drewsum/Electronic_Display/hdw/Power_Board/LTC7851_Demo/render2.png

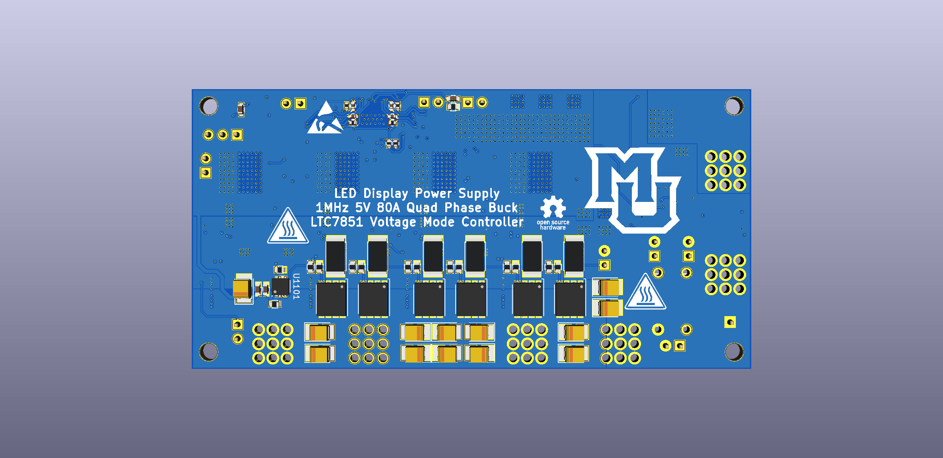
hdw/Power_Board/LTC7851_Demo/render2.png
