drewsum/Electronic_Display/sfw/app/Android_App_Code_README.docx

The app code was written and built with Android Studio and this IDE also is used to debug and program an android device. This software can be found at https://developer.android.com/studio/index.html and is free to download. The project was built targeting the java jdk version 1.8

Checkout the source code of the project found at https://github.com/drewsum/Electronic_Display

First enable USB debugging on the device in developer settings.

Connect a USB cable to your machine running Android Studio
