drewsum/Electronic_Display/hdw/Logic_Board/Design_Files/Microcontroller_Peripheral_Map.xlsx

Peripheral Name | Description | Function | Software Naming | Notes | Pin Routing
EBI | External Bus Interface | Allows data to be stored and retrieved from external parallel SRAM for saving data currently being displayed on the display | EBI, EBI_SRAM, etc | Used PBCLK8 as clock source. Used as data scratchpad for writing to/reading from SPI Flash during normal operation, as well as saving data sent over WiFi interface | RA4, RA5, RB8, RB9, RC1, RC2, RC3, RC4, RD9, RE0, RE1, RE2, RE3, RE4, RE5, RE6, RE7, RF4, RF5, RG9, RH7, RJ4, RJ13, RJ14, RJ15, RK0, RK1, RK2, RK3
SPI3 | Seiral Peripheral Interface 3 | Allows data to be stored and retrieved from external serial FLASH memory. There are 8 FLASH chips which each hold a slide of data for the display | SPI_Flash | There are 8 serial flash chips. Each stores an image to be displayed on the panels | RA2, RA3, RA6, RA7, RA9, RA10, RA14, RA15, RB2, RB3, RB4, RB5, RB6, RB7, RB10, RB11, RB12, RB14, RC13, RC14
UART1 | Universal Asynchronous Recevier Transmitter 1 | Serial connection for WIFI module, used for moving image data from an android app into the embedded system | esp8266 | Baud rate set to 115200 bps | RE8, RE9, RG7, RG8
UART3 | Universal Asynchronous Recevier Transmitter 3 | Serial connection for USB debugging, virtual COM port | usbUart | Baud rate set to 115200 bps | RF0, RD10
WDT | Watchdog Timer | Error catch, resets the microcontroller if the timer has not been cleared in 2 seconds. Timer is cleared within the heartbeat ISR (below) | watchdogTimer | Postscaler set to 2.048 seconds
TMR1 | Timer 1 | Timer 1 is used as the heartbeat timer, which triggers an interrupt every second. This blinks an LED and increments on time counters. Used as a 1 Hz timebase | heartbeatTimer | Timer 1 period set to 61523, input frequency is 15.75 MHz, yields an IRQ rate of 1 Hz. Blinks the heartbeat LED | RG12
TMR3 | Timer 3 | Used for timebase for automatic ADC triggering | ADCTriggerTimer
DMT | Deadman timer | Resets the microcontroller if not cleared by the heartbeat timer ISR | DeadmanTimer
TMR5 | Timer 5 | Used for the main timebase for panel multiplexing. Sets the on time for LEDs in panel | panelMultiplexingTimer
TMR2, OC4 | Timer 2 and Output Compare 4 | Panel PWM, used for dimming panels and adjusting panel brightness | panelPWM |  | RG0
TMR4 | Timer 4 | Used for certain non-software delays needed for firmware execution. Only one delay can be used at once | delayTimer | Adjustable timer period
CNF, CNK | Change Notice F, Change Notice K | Used for GPIO input edge detection. Monitors PGOOD signals along with rotary encoder |  |  | RF1, RF3, RF8, RF12, RK4, RK5, RK7
Prefetch | Prefetch Module | Acts as a complimentary cache for the CPU while it is operating at high clock frequencies | prefetch | Wait time set to 4 wait states per datasheet
Analog to Digital Converter 7 | ADC7 | Shared ADC module, used for system voltage measurement when debugging. Off by default, turned on through serial command | ADC |  | RH0, RH1, RH4, RH5, RH6
Error Handler (in firmware) | Error Handler | C structure that holds flags used for recording and reporting errors. Varias peripherals set error handler flags, and they can only be cleared through the USB UART serial interface. These flags set the state of the error LEDs on the board | error_handler.<flag_name> |  | RG1, RG6, RG13, RG14, RH3
