drewsum/Electronic_Display/hdw/Logic_Board/Design_Files/Interrupt_Priority_List.xlsx

Interrupt Name | Priority | SubPriority | Function
ADC_Analog_Circuits_Ready | 4 | 2
ADC7_Warm_Interrupt | 4 | 2
ADC_Data_38 | 1 | 1 | POS3P3 ADC data
ADC_Data_39 | 1 | 1 | POS12 ADC data
ADC_Data_40 | 1 | 1 | POS5 ADC data
ADC_Data_41 | 1 | 1 | POS5P5 ADC data
ADC_Data_42 | 1 | 1 | POS5P ADC data
ADC_Data_43 | 1 | 1 | VREF ADC data
ADC_Data_44 | 1 | 1 | DIE Temperature data
ADC_End_Of_Scan_Ready | 1 | 1 | handles anything and all ADC info after reading in new ADC values
System_Bus_Protection_Violation | 1 | 1
UART1_Receive_Done | 7 | 2 | ESP RX
UART1_Transfer_Done | 7 | 2 | ESP TX
UART1_Fault | 1 | 1 | ESP error
Timer1 | 6 |  | heartbeat timer
PORTF_Input_Change_Interrupt | 2 | 1 | change notification for port F inputs
PORTK_Input_Change_Interrupt | 2 | 1 | change notification for port K inputs
Timer5 | 6 | 2 | Multiplexing timer
Prefetch_Module_SEC_Event | 4 | 2
SPI3_Fault | 1 | 2 | SPI flash error
SPI3_Receive_Done | 5 | 3 | SPI flash RX
SPI3_Transfer_Done | 5 | 2 | SPI flash TX
UART3_Receive_Done | 2 | 2 | USB RX
UART3_Transfer_Done | 7 | 2 | USB TX
UART3_Fault | 1 | 1 | USB error
