drewsum/Electronic_Display/hdw/Power_Board/LTC7851_Demo/LTC7851_Demo_bom_.xlsx

References | Value | Footprint | Quantity Per PCB | Digi-Key PN | display_footprint | Dielectric | Voltage | Tolerance | Ampacity | Wattage
C207 C301 C302 C303 C304 C305 C411 C413 C506 C508 C606 C608 C706 C708 C802 C803 C804 C1102 | 0.1uF | C_0603 | 18 | 490-4779-1-ND | 0603 | X7R | 50V
C201 | 0.1uF | C_0603 | 1 | 490-4779-1-ND | 0603 | X7R | 50V
C415 C510 C610 C710 | 0.22uF | C_0402 | 4 | 1276-1049-1-ND | 0402 | X5R | 10V
C402 C406 | 100pF | C_0402 | 2 | 478-1089-1-ND | 0402 | X7R | 50V
C204 C206 C208 | 100uF | CP_Tantalum_Case-X_EIA-7343-43_Reflow | 3 | 718-1102-1-ND | 7343 |  | 16V | 10%
C405 C407 C408 C410 C412 C420 C501 C502 C503 C505 C507 C515 C601 C602 C603 C605 C607 C615 C701 C702 C703 C705 C707 C715 C805 | 100uF | CP_Tantalum_Case-B_EIA-3528-21_Reflow | 25 | 478-9994-1-ND | 3528 |  | 6.3V | 20%
C417 C419 C512 C514 C612 C614 C712 C714 | 100uF | C_1210 | 8 | 587-3432-1-ND | 1210 | X5R | 10V
C202 C205 | 10nF | C_0603 | 2 | 1276-1921-1-ND | 0603 | X7R | 50V
C801 C1103 | 10uF | CP_Tantalum_Case-B_EIA-3528-21_Reflow | 2 | 399-5034-1-ND | 3528 |  | 16V | 10%
C203 | 1nF | C_0603 | 1 | 311-1080-1-ND | 0603 | X7R | 50V
C401 | 1nF | C_0402 | 1 | 311-1080-1-ND | 0402 | X7R | 50V
C409 C414 C509 C604 C609 C704 C709 C1101 | 1uF | C_0603 | 8 | 1276-6524-1-ND | 0603 | X7R | 16V
C504 | 1uF | C_0603_HandSoldering | 1 | 1276-6524-1-ND | 0603 | X7R | 16V
C404 | 2200pF | C_0402 | 1 | 478-1105-1-ND | 0402 | X7R | 50V
C416 C418 C511 C513 C611 C613 C711 C713 | 22uF | C_1210 | 8 | 445-1436-1-ND | 1210 | X5R | 25V
C403 | 3300pF | C_0402 | 1 | 478-5132-1-ND | 0402 | X7R | 50V
D201 | 24V | D_SMA | 1 | SMAJ24CALFCT-ND
D202 D302 D303 | Green | LED_0603 | 3 | 160-1446-1-ND
D301 | Red | LED_0603 | 1 | 160-1447-1-ND
J201 | +12V IN | Wuerth_7461096_M4_Shank_9pos | 1 | 732-3214-ND
J901 J902 | +5V OUT | Wuerth_7461096_M4_Shank_9pos | 2 | 732-3214-ND
J301 | CLKOUT | Pin_Header_Straight_1x02_Pitch2.54mm | 1
J1101 | FG_LOAD | Pin_Header_Straight_1x02_Pitch2.54mm | 1
J206 | GND IN | Wuerth_7461096_M4_Shank_9pos | 1 | 732-3214-ND
J903 J904 | GND OUT | Wuerth_7461096_M4_Shank_9pos | 2 | 732-3214-ND
J304 | IAVG | Pin_Header_Straight_1x02_Pitch2.54mm | 1
J1102 | ISNS | Pin_Header_Straight_1x02_Pitch2.54mm | 1
J1402 | LOOP_TAP | Pin_Header_Straight_1x02_Pitch2.54mm | 1
J305 | PGOOD | Pin_Header_Straight_1x02_Pitch2.54mm | 1
J302 | RUN | Pin_Header_Straight_1x03_Pitch2.54mm | 1
J303 | THDN | Pin_Header_Straight_1x02_Pitch2.54mm | 1
J1401 | VOUT | Pin_Header_Straight_1x02_Pitch2.54mm | 1
J1403 | Wave_Gen_In | Pin_Header_Straight_1x02_Pitch2.54mm | 1
L401 L501 L601 L701 | 1uH | L_Vishay_IHLP-4040 | 4 | 541-1306-1-ND | IHLP4040 |  |  | 20% | 25A
MK1001 MK1002 MK1009 MK1010 | 4-40 Screw |  | 4 | 36-9900-ND
MK1003 MK1004 MK1011 MK1012 | 4-40 Standoff |  | 4 | 36-8400-ND
Q201 Q202 Q1101 Q1102 Q1201 Q1202 Q1301 Q1302 | IPC100N04S51R7ATMA1 | TDSON-8-1 | 8 | BSC123N10LSGATMA1CT-ND
R301 | 0 | R_0603 | 1 | 311-0.0GRCT-ND | 0603 |  |  | 1% |  | 1/10W
R408 R412 R413 R414 R504 R505 R604 R605 R704 R705 | 0 | R_0402 | 10 | RMCF0402ZT0R00CT-ND | 0402 |  |  | 1% |  | 1/16W
R407 R503 R603 R703 | 1.96k | R_0402 | 4 | 311-1.96KLRCT-ND | 0402 |  |  | 1% |  | 1/16W
R205 R206 R1102 R1103 R1104 R1201 R1202 R1301 R1302 | 10 | R_0603 | 9 | YAG3351CT-ND | 0603 |  |  | 1% |  | 1/10W
R409 | 10 | R_0402 | 1 | 311-10.0LRCT-ND | 0402 |  |  | 1% |  | 1/16W
R204 | 100k | R_0603 | 1 | P100KHCT-ND | 0603 |  |  | 1% |  | 1/10W
R410 | 100k | R_0402 | 1 | 311-100KLRCT-ND | 0402 |  |  | 1% |  | 1/16W
R207 R304 R305 R310 R1101 R1105 R1106 R1203 R1204 R1303 R1304 | 10k | R_0603 | 11 | RHM10KADCT-ND | 0603 |  |  | 1% |  | 1/10W
R404 | 10k | R_0402 | 1 | 311-10.0KLRCT-ND | 0402 |  |  | 1% |  | 1/16W
R411 | 13.7k | R_0402 | 1 | 311-13.7KLRCT-ND | 0402 |  |  | 1% |  | 1/16W
R209 R306 R307 R308 | 1k | R_0603 | 4 | RHM1.0KDCT-ND | 0603 |  |  | 1% |  | 1/10W
R302 R405 R406 R501 R502 R601 R602 R701 R702 | 2 | R_0603 | 9 | RMCF0603FT2R00CT-ND | 0603 |  |  | 1% |  | 1/10W
R801 | 200 | R_0603 | 1 | MCT0603-200-CFCT-ND | 0603 |  |  | 1% |  | 1/10W
R203 | 243k | R_0603 | 1 | 541-243KHCT-ND | 0603 |  |  | 1% |  | 1/10W
R402 | 324 | R_0402 | 1 | YAG3118CT-ND | 0402 |  |  | 1% |  | 1/16W
R208 | 5.1k | R_0603 | 1 | RMCF0603FT5K10CT-ND | 0603 |  |  | 1% |  | 1/10W
R303 | 51.1k | R_0603 | 1 | P51.1KHCT-ND | 0603 |  |  | 1% |  | 1/10W
R401 | 59k | R_0402 | 1 | P59KDCCT-ND | 0402 |  |  | 1% |  | 1/16W
R1107 R1108 R1205 R1206 R1305 R1306 | 5m | R_2512 | 6 | YAG2145CT-ND | 2512 |  |  | 1% |  | 2W
R201 | 6.04M | R_0603 | 1 | 541-6.04MHCT-ND | 0603 |  |  | 1% |  | 1/10W
R403 | 6.04k | R_0402 | 1 | RMCF0402FT6K04CT-ND | 0402 |  |  | 1% |  | 1/16W
R802 | 680 | R_0603 | 1 | P680HCT-ND | 0603 |  |  | 1% |  | 1/10W
R202 | 86.6k | R_0603 | 1 | 311-86.6KHRCT-ND | 0603 |  |  | 1% |  | 1/10W
T1401 | 1:1 Pulse Transformer | Murata_78601_9C | 1 | 811-2650-ND
U202 U303 U304 | 74LVC1G06 | SOT-353_SC-70-5 | 3 | 296-8484-1-ND
U302 | 74LVC1G17 | SOT-353_SC-70-5 | 1 | 296-11934-1-ND
U801 | LM1117-ADJ | SOT-223-3_TabPin2 | 1 | LM1117IMPX-ADJ/NOPBCT-ND
U1101 | LT1010DD | DFN-8-1EP_3x3mm_Pitch0.5mm | 1 | LT1010CDD#PBF-ND
U201 | LTC4365DDB | DFN-8-1EP_2x3mm_Pitch0.5mm | 1 | LTC4365IDDB#TRMPBFCT-ND
U301 | LTC7851UHH | QFN-58-1EP_9x5mm_Pitch0.4mm | 1 | LTC7851IUHH#PBF-ND
U401 U501 U601 U701 | SiC779 | MLP66-40_6x6mm_Pitch0.5mm | 4 | SIC779CD-T1-GE3CT-ND
