drewsum/Electronic_Display/hdw/Logic_Board/Testing/POS3P3.png

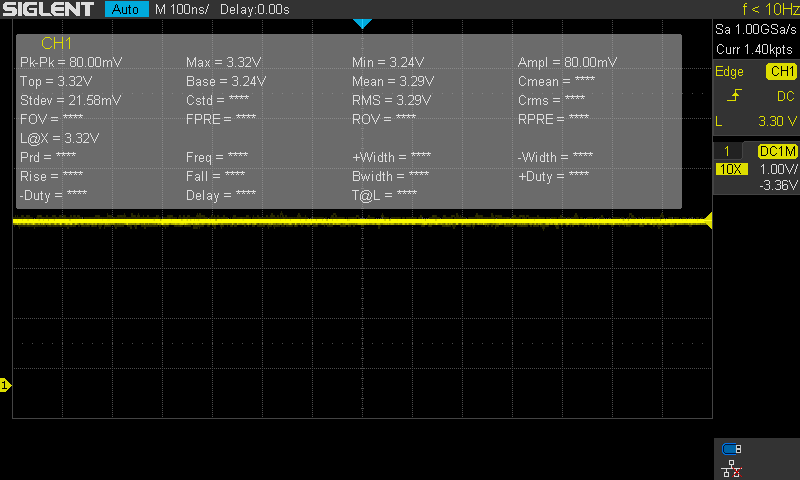
hdw/Logic_Board/Testing/POS3P3.png
