drewsum/Electronic_Display/hdw/Logic_Board/Testing/POS3P3_SW_2.png

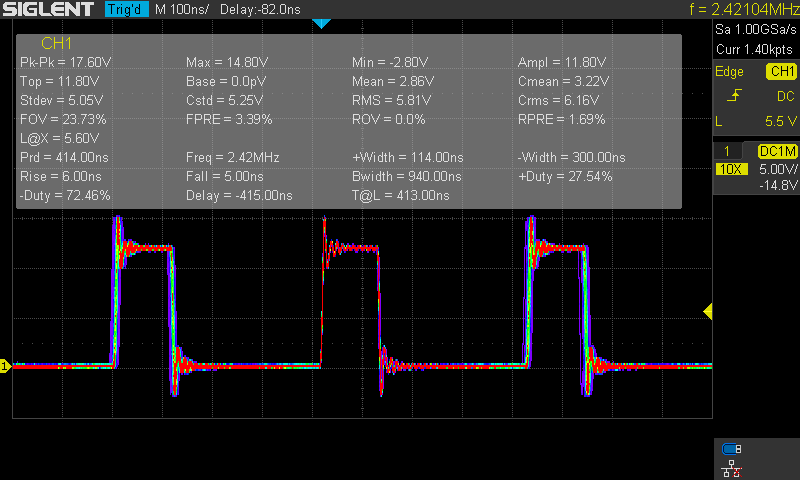
hdw/Logic_Board/Testing/POS3P3_SW_2.png
