drewsum/Electronic_Display/hdw/Logic_Board/Testing/POS5.png

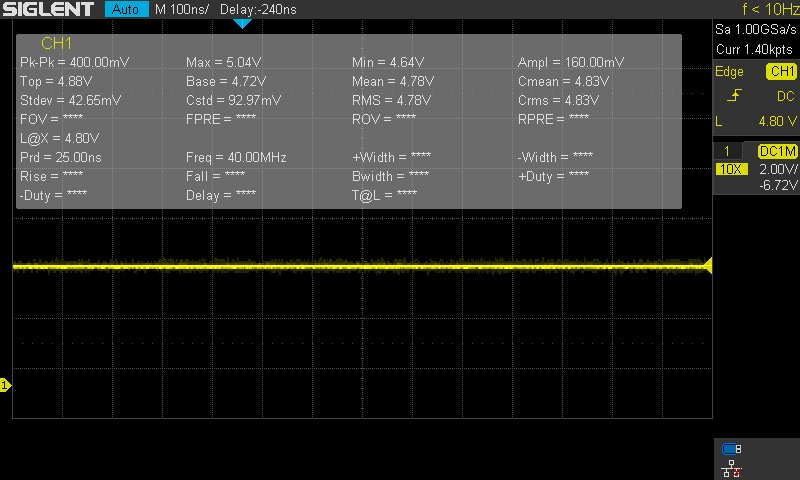
hdw/Logic_Board/Testing/POS5.png
