drewsum/Electronic_Display/hdw/Logic_Board/Testing/POS5_SW.png

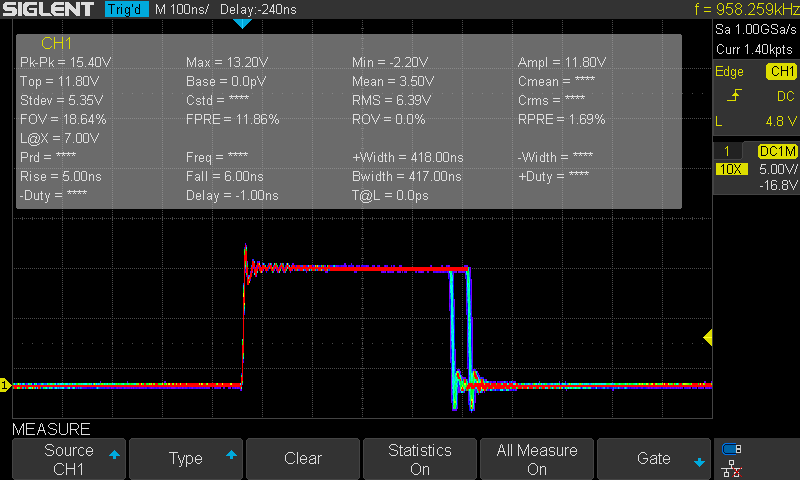
hdw/Logic_Board/Testing/POS5_SW.png
