drewsum/Electronic_Display/hdw/Logic_Board/Testing/USB_UART.png

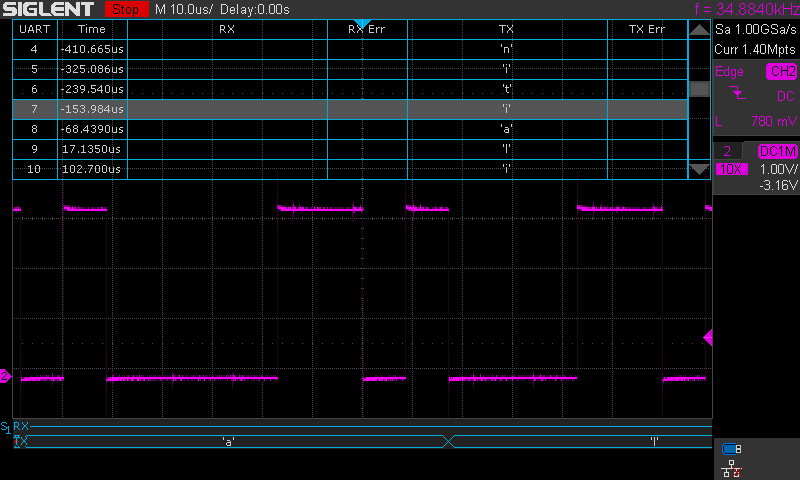
hdw/Logic_Board/Testing/USB_UART.png
