drewsum/Electronic_Display/hdw/Logic_Board/Testing/USB_UART_2.png

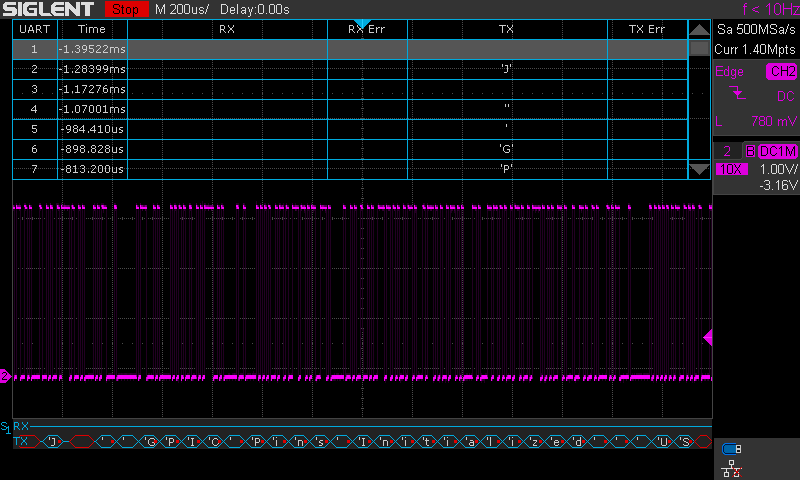
hdw/Logic_Board/Testing/USB_UART_2.png
