drewsum/Electronic_Display/sfw/embedded_firmware/test/HTTPRequest.PNG

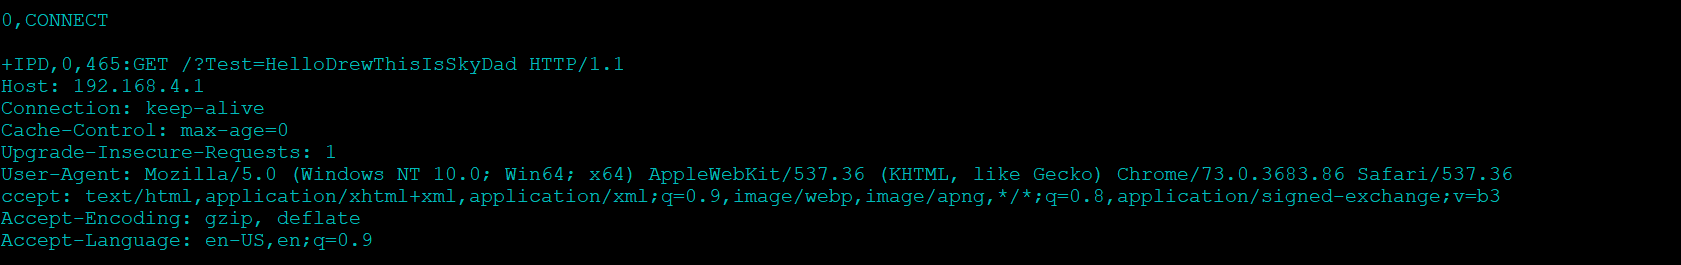
sfw/embedded_firmware/test/HTTPRequest.PNG
