drewsum/Electronic_Display/hdw/Logic_Board/Testing/EBI_WE_Issues/SDS00013.png

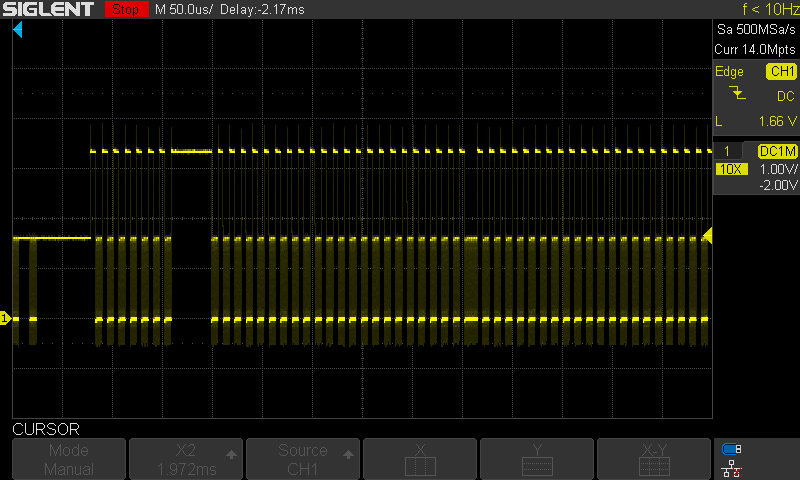
hdw/Logic_Board/Testing/EBI_WE_Issues/SDS00013.png
