drewsum/Electronic_Display/(threads)

Thread 58 (2019-02-02):

Exception Handling

drewsum, 2019-02-02:
Write _general_exception_handler function to handle CPU exceptions, record them, and print them to USB UART after reset if they've occurred. This should be in the error handling module

Closed 2019-02-03.

Thread 59 (2019-02-02):

SPI Flash

drewsum, 2019-02-02:
Write SPI flash module for SPI 3. This should include an init function, should add SPI3 PPS settings to GPIO setup function. I'm thinking it will have an enumeration to keep track of state machine, there should be functions to set and reset the GPIO associated with SPI flash, and should have functions to test/print what's stored in given external flash chips.

drewsum, 2019-02-26:
Where we stand on this: We're able to read (I think) from SPI Flash, but we cannot write yet. I'm thinking we should disable the enhanced buffer mode again, and add while loop blocking in between opcode writes and stuff. This will force the movement of data to be accurate, and minimize risk of data becoming out of order or bytes being missed, both with reading from and writing to the SPI Flash devices. I'd also really like to get SSCANF serial commands working, so that we can write to and read from whichever of the 8 chips we want to at a given time.

drewsum, 2019-03-07:
We should look deeper into whether or not we're going to be able to move data from SPI Flash into EBI SRAM while multiplexing. If we leave multiplexing enabled while handling SPI tasks, it looks like the PIC enters fucked up mode. If we can widen the LED panel on time to much longer than 6 microseconds, we may have enough time to service SPI while still multiplexing. More to experiment with. If we can;t service SPI while multiplexing, we should just forget EBI altogether and move SPI Flash data into the internal RAM buffer after displaying each image (when cycling through images).

drewsum, 2019-03-08:
Looks like when I disable enhanced buffer mode, the receive interrupt has stopped working. When trying to continuously receive, we can only write one byte (the SPI3 RX interrupt only triggers once).

Closed 2019-03-18.

Thread 60 (2019-02-02):

EBI

drewsum, 2019-02-02:
Write external bus interface module for interfacing PIC32MZ with external SRAM. Using data line 0:8, address lines 0:17. No idea what speed settings should be. SRAM size is 256k x 8b

drewsum, 2019-02-03:
Ideas for this:

**Slow down EBI to slowest setting and we'll work our way up from there:** TPRC, TBTA and all other bit fields in the EBISMT0 register should be set to all 1's instead of all 0's

**Keep following example 47-5 in the EBI reference manual:** Keep copying over the example code for the ebiInitialize function, but when they write something like EBISMCON = 0x00000000, instead of just writing that, write zero's or whatever into the actual bitfields so we know explicitly what we're configuring instead of writing a 32-bit number into a register

**Write an ebiTestRamBuffer() Function:** Prototype in the ebi header file, and write the function in the ebi source file. Use a for loop to loop through all possible addresses in external memory (0 to 2^17 - 1 or something like that) and write the address into that memory location. The data is accessed through a pointer if I remember right. Then, loop through the array again and verify that the data matches what you set it to for each address. If it does, print out that no errors occurred, if there is an error, print an error message.

**Write an ebiPrintSRAM() Function:** prototype in the ebi header file and write in the ebi source file. It should loop through all EBI addresses lik ethe test function above, but instead of writing and checking to verify it wrote properly, it should print out the SRAM register address and contents of the SRAM register.
To keep the output shorter, I would say print like 16 bytes of data per line or something like this:

`
Address:      0       1       2       3      4       5       6      7       8      9       A      B       C      D      E       F
0x0000000x 0x00 0x00 0x00 0x00 0x00 0x00 0x00 0x00 0x00 0x00 0x00 0x00 0x00 0x00 0x00 0x00
0x0000001x 0x00 0x00 0x00 0x00 0x00 0x00 0x00 0x00 0x00 0x00 0x00 0x00 0x00 0x00 0x00 0x00
...
`

drewsum, 2019-02-04:
We should also add a `printEBIStatus()` function to print out the settings of all EBI pins/control registers/whatever before we actually turn the EBI module on for the first time. This will help us make sure pins are set properly and reduce the risk of frying anything on the board

drewsum, 2019-02-08:
I ran an EBI test for the first time, and every time the `ebiTest()` function is called a CPU general exception is thrown. I think this has something to do with a memory permissions error. This exception gets thrown because the EBI testing function is trying to read from external memory which it doesn't have permission to and therefore a read from a wrong address throws a CPU general exception. I think we have to configure the EBI memory space to be accessed by the CPU using the memory management unit. This cade should sit in the ebiInit() function. The MMU is outlined in section 48 of the REF manual for the 32MZ

drewsum, 2019-02-08:
EBI virtaul memory space starts at 0xC000 000, and physical space starts at 0x2000 0000. The size of the EBI external SRAM is 256 * 1044 bytes, or 262144 bytes

Closed 2019-02-11.

Thread 61 (2019-02-02):

Prefetch Module

drewsum, 2019-02-02:
Write code to configure prefetch module to make code execution faster. This should be within the device control module and have an init function and an ISR to keep track of an "SEC" event, whatever that is. Add SEC event to error handler as well.

Closed 2019-02-05.

Thread 62 (2019-02-02):

Solve USB UART interrupt printing issue

drewsum, 2019-02-02:
When printing interrupt status multiple times per device reset, microcontroller will execute sfw reset on its own, without the SFWRST instruction being executed (as far as I know). Kevin and I kind of thought that this had something to do with how absurdly large the interrupt status message was, and how big the USB UART tx ring buffer is. This isn't as important, but isn't good either. Consider only printing a single interrupt at a time, and user enters interrupt name when asking for status.

drewsum, 2019-02-02:
Determined this has nothing to do with interrupt status command or length of messages, it's the USB UART driver entering some weird state where the board will reset once entered. This is weird since the USB UART ring buffer driver was directly ported from earlier projects and I've never seen this happen.

drewsum, 2019-02-02:
Determined this is happening regardless of if my software reset function is even included into compiled code. This means either the PIC is executing a software reset based on a weird fault condition or the compiler is placing a reset instruction somewhere where this will happen

drewsum, 2019-02-02:
Looks like a CPU exception is occurring. From section 14.5.2 of XC32 manual, when an exception occurs, software reset will be executed

drewsum, 2019-02-02:
Verified that some kind of exception is occurring. When overriding the included XC32 exception handlers with a Nop(); instead of a software reset, this bricks the micro until it's reset externally...

drewsum, 2019-02-03:
This is related to the exception handling issue. I've figured out that if I make the USB UART RX ring buffer size substantially larger, the TX ring buffer exception doesn't occur. Super weird, and these two things should not be related, but they are. Leaving RX ring buffer as a huge size and we'll see what happens.

Closed 2019-02-03.

Thread 63 (2019-02-02):

Port panel control code into firmware project

drewsum, 2019-02-02:
Port the panel control code based on harmony framework into bare metal firmware project. This should go into the panel control module.
**Changes that will need to be made include:**
Remove old pin/TRIS macros, these have changed when moving to 144 pin microcontroller
Change where the data written into the RGB and row select functions appears on physical pins
Move the multiplexing handler function from app.c in old project into panel_control.c
Add hardware timer interrupt code, still need to decide on which timer to use

drewsum, 2019-02-11:
So, ideas for this:
1. **Copy the old harmony multiplexing function into the new firmware project:** In the four by four panel test firmware project (hidden in the repo), there's a function in app.c that handles multiplexing four panels. We need to copy this into the panel control module in the firmware project. The function is called `updateRowCallback()`, and I think we should rename it in the new firmware project to `panelMultiplexingHandler()` because of reasons. The function needs to be copied, and a prototype needs to be added to panel_control.h. There will be a lot of bug fixes while transferring stuff over since we've named output signals from the microcontroller with a different convention. There's going to be a bunch of red code since none of the output pin names will match. Change them to match what's in pin_macros.h. Also, variables used in this function will need to be copied into panel_control.h. We also need to `#define PANEL_DATA_ARRAY_SIZE` as `262144` bytes, because this is how long it is.
**Change the multiplexing handler to use EBI SRAM for data storage:** The old implementation used internal RAM to store the array of data to be shifted into the display. We need to change this to use EBI SRAM. `#include` external_bus_interface.h and change all references of the "ram buffer" in the old code to references to the external memory array from external_bus_interface.h
**Write a multiplexing timer init function:** We have to write a function called `panelMultiplexingTimerInitialize()` to setup a hardware timer for interrupts for multiplexing. I think in the old implementation, we used Timer2. We have to use a different one this time since I think Timer2 needs to be used for PWM for dimming the panels (we'll get to that much, much later). Prototype and write a function to setup a timer. Can't use Timer1, Timer3 or Timer2 since these are already used. Look at heartbeat_timer.h for how to do this. Pick a timer and then add that we're using this timer to the excel spreadsheet that keeps track of which peripherals do what. I think it's in hdw\logic_board\documentation\ or something along those lines. Also, we need to write a `multiplexingTimerISR()` to service the mux timer interrupt. This should be the highest interrupt priority and it should both call the `panelMultiplexingHandler()` you wrote from above and clear the timer interrupt flag for whichever timer is used for muxing.
**More that I'll help you with:** Test buffer fills functions and serial commands, and macros and global variables and stuff. **We will also need to change how the multiplexingHandler function calculates which entries in the SRAM array need to be accessed for moving data from there into the panels. This will change since we're switching from two "strings" of two "pillars" to four "strings" of five "pillars"**

drewsum, 2019-02-12:
We need to find a way to make the multiplexing handler faster. I think we should remove/shorten the poor man's delay within the handler function, and try to make other code optimizations to try to make it faster. I believe that the reason visible flickering is present is because data is not being shifter fast enough.

drewsum, 2019-02-12:
We also need to sort out the issue with interrupt priorities where, when panel multiplexing is enabled, serial output is all messed up, because serial output timing is compromised. Additionally, we need to sort out the issue where EBI SRAM updating is a gradual change instead of all at once, like it should be. This should be done by suspending panel multiplexing before reloading EBI SRAM, and then re-enabling it after EBI SRAM is altered.

drewsum, 2019-02-26:
Where we're at with this: I believe the read and write time for external SRAM is too long, meaning that the refresh rate of the display is too slow. We've made as many speed optimizations as possible and the MCU is just not reading data from SRAM fast enough. We should consider using internal RAM instead for faster access times so that the screen is not visibly refreshing. I think that the speed issue has to do with PCB routing. Throwing in the towel on EBI SRAM will remove some cool factor from the project, but will make the display refresh rate faster, which is key.

Closed 2019-03-05.

Thread 64 (2019-02-02):

Add power board control functionality to micro firmware

drewsum, 2019-02-02:
This should go into misc_board_control module
Should include init functions and interrupts to detect when POS5P_PGOOD signal rises and falls, as well as POS5P_THWN. Should set error flags in error_handler module

drewsum, 2019-04-26:
Closing, this is figured out

Closed 2019-04-26.

Thread 65 (2019-02-02):

Rotary Encoder Module

drewsum, 2019-02-02:
Should include init function, interrupts to detect rising and falling edge of ENCODER_STEP signal, and global variables to keep track of desired brightness.

cmgilger1, 2019-03-26:
currently have interrupt to detect rising edge for ENCODER_STEP signal in misc_board_control.c, should I move that ISR into rotary_encoder.c?

I haven't pushed to master yet, but this is what the rising edge ISR handler looks like...
```
void encoderStepREHandler(void) {

    uint8_t current_brightness = (OC4R * 100) / PR2;

    // if ENCODER_DIR_PIN is high, we are rotating clockwise
    if (ENCODER_DIR_PIN) {

        // If we are not at maximum brightness, make brighter
        if (current_brightness < 100) {
    
            panelPWMSetBrightness(current_brightness + 10);
    
        }

    } else {

        // if we are not at minimum brightness, make dimmer
        if (current_brightness > 0) {

            panelPWMSetBrightness(current_brightness =- 10);
    
        }

    }

}
```

I know it probably needs changes but I'm thinking we should put this in the rotary_encoder.c file

drewsum, 2019-04-02:
This works, awesome job. Closing.

Closed 2019-04-02.

Thread 66 (2019-02-02):

Panel PWM (OC9)

drewsum, 2019-02-02:
Write init functions/interrupts/whatever for controlling panel brightness with output compare 9 peripheral. Will require setting up a timer, mapping OC9 output to pin with PPS, and a function to write data into PWM to set duty cycle

Closed 2019-03-29.

Thread 67 (2019-02-02):

WiFi Interface

drewsum, 2019-02-02:
Add init function, interrupts, etc for controlling/interfacing with the ESP8266. This will require SPI_Flash, EBI modules, as well as controlling brightness and power eventually.

drewsum, 2019-04-14:
Closing since we pretty much have this figured out.

Closed 2019-04-14.

Thread 68 (2019-02-02):

SLEEP mode

drewsum, 2019-02-02:
Add Sleep mode or Idle mode control to power saving module. This will be triggered when panel is disabled by pressing down on rotary encoder or by turning display off from the app

drewsum, 2019-03-29:
Not gonna do this

Closed 2019-03-29.

Thread 69 (2019-02-02):

ADC voltage monitoring

drewsum, 2019-02-02:
Write ADC module to be ablke to monitor voltages on the logic board as well as POS5P voltage. Should be interrupt based, but lowest priority

drewsum, 2019-02-07:
I had tacos for dinner today, they were delicious.

My ideas for this:

We're only using channels AN38 - AN44, so ADC7 (shared ADC) will be the only one used. Not planning on using digital comparators or filters yet. ADC0 - ADC4 should be completely shut down.

Going to keep following the example in the ref manual for ADC7 initialization. Pretty much there now, but need to reorder some things. Also, need to add interrupt configuration in init function. All ADC interrupts should have IPL set to 1.

Plan moving forward: Going to enable the warm up interrupt as well as the analog circuits ready interrupt. These ISRs will move the initialization along and will eventually start Timer3, which will be the trigger source for ADC7. Timer3 will have a configurable period, but will not have an ISR and will not have an interrupt enabled. There also needs to be an ADC Trigger Timer init function for this. Timer3 will be the trigger source for ADC7 scanning, and interrupts for each ADC channel's data ready flag will be used. This way, we'll have an ISR for processing each channel. Averaging could be done in software later if results are noisy but isn't that important.
Also thinking of using a digital comparator eventually for monitoring POS5P, or other rails. That way we'll have another method of catching power supply regulation issues in addition to PGOOD signals

drewsum, 2019-02-07:
Made some progress, but for some reason, during the initialize function, the warm up ready flag is never being set by hardware. Following the init example in the ADC ref manual, I have a while loop waiting for ADCANCONbits.WKRDY7 to be set, and it's never set by hardware. I troubleshot a few problems that could lead to this, but I can't find any culprits yet. Changing the warm up time, suspending the triggers during init, and verifying that ADC SFRs can be written to does not fix the problem. Spinning my wheels here.

drewsum, 2019-02-07:
It looks like a revised init function works. It uses the ADC7 warm interrupt and then sets everything else up from that ISR. That way, if the ADC module fails on startup, it doesn't block firmware execution. Timer3 is used to automatically trigger the ADC. Still need to revise trigger rates/conversion rates/all time settings for the ADC driver. I also made a structure to record ADC results to easily access them across different code modules. Measuring POS3P3 seems to be working right now.

drewsum, 2019-02-07:
Want to change current RAW data serial command to print all ADC channel results. Also want to add end-of-scan interrupt to actually do the floating point processing, to minimize CPU overhead during ADC acquisitions

drewsum, 2019-02-07:
Need to add DATARDY read statements in each data ready ISR since this bit is cleared automatically by reading it. Also want to add digital filtering (maybe)

drewsum, 2019-02-07:
Nevermind on the hardware filter, FLTRs can only be used on AN0 - AN11 (class 1 and 2 inputs)

drewsum, 2019-02-08:
Also want to add a `printADCStatus()` function to print setup info for ADC7

Closed 2019-02-08.

Thread 71 (2019-02-03):

Non-Maskable Interrupt

drewsum, 2019-02-03:
Write an NMI ISR within the error handler module to print if an NMI is about to occur, also add setup code and stuff

drewsum, 2019-02-26:
Not doing this anymore

Closed 2019-02-26.

Thread 77 (2019-02-03):

Expand Error Reporting

drewsum, 2019-02-03:
The error handler module needs to be expanded to update error leds based on error_handler flags and a print function needs to be written to report status of each flag over serial port

Thread 79 (2019-02-04):

Troubleshoot Peripheral Bus Clock Enable Issue

drewsum, 2019-02-04:
It looks like PBCLK2 - PBCLK8 cannot be enabled. This stemmed from writing a function to print clock settings. The PBxCLKDIV divider bits have been set properly, and directly after that in the PBCLKInit functions, the clocks are enabled, but when printing status with a serial command, the write doesn't actually take effect. Learned that I had to set to a slower clock setting on startup and then change to 252 MHz after reset

drewsum, 2019-02-04:
This is a big issue since if certain peripheral bus clocks are not enabled certain peripherals may not work properly, which is a dangerous game.

drewsum, 2019-02-04:
So this actually doesn't make any sense. PBCLKs must be working because they are the timebase for the heartbeat timer and USB UART. If PBCLKs weren't actually running then these peripherals would not work. Perhaps the `ON` bits within `PBxDIV` registers can only be set and are cleared or something? I do know that the clock settings are being set properly after reset because the configuration bits are set to have the PIC run at a much slower frequency (252 / 4 MHz). After reset functions are called to setup the PLL which gets SYSCLK up to 252 MHz properly. Something really fishy is going on here

Closed 2019-02-04.

Thread 87 (2019-02-05):

Configuration Bits Issue

drewsum, 2019-02-05:
Figure out why the `RCONbits.BCFGERR` bit is being set on startup. This has something to do with errors when reading from config bits. This is causing the error handler configuration error flag to be set (as it should), and causing the other error led pin to be set on startup (which it should). Find the root cause of the issue.

Closed 2019-03-06.

Thread 94 (2019-02-08):

Add live update module to print serial data live

drewsum, 2019-02-08:
Add a live measurement module to print data like voltage measurements, PGOODs, and other important information at a fixed time base. Use an enum to keep track of which "screens" we'd be printing.

Closed 2019-02-26.

Thread 95 (2019-02-11):

Fix USB UART init condition error

drewsum, 2019-02-11:
When the micro first wakes from reset, the user has to press enter twice on a serial terminal before the PIC will recognize serial commands. I tried for a while to figure this out last month, but nothing worked.

Idea:
Enable loopback mode during the init function and transmit two carriage return line feed sequences. Then turn off loopback. This would "send ourself" two enter keys.

drewsum, 2019-03-07:
Tried to fix this by enabling UART3 loopback and pumping out two \n\r sequences on boot but doesn't work, it puts the PIC into fucked up mode. We may drop this. May try again over break.

drewsum, 2019-04-02:
Not fixing this. Closing

Closed 2019-04-02.

Thread 107 (2019-03-05):

Solve WDT/DMT timeout issue

drewsum, 2019-03-05:
Sometimes, randomly, a deadman timer or watchdog timer reset occurs. These two timers are reset in the core timer ISR. I believe the reason this is happening is because the core timer ISR has context saving set to `AUTO` instead of `SRS`, which isn't what we want. Changing context saving mode to `SRS` like all other ISRs that we've written may fix this problem. If not, we should disable the DMT and only use the WDT.

drewsum, 2019-03-07:
Might want to drop the core timer and switch back to clearing the WDT and DMT in the heartbeat timer handler. This makes more sense since we'd get rid of a basically useless interrupt that needs to be serviced and the heartbeat timer would serve as more of a beating heart than just a blinking LED. This would involve deleting core timer init and handler functions, and setting IPL of heartbeat timer to higher than it's currently set to, maybe even 7.

Closed 2019-03-29.

Thread 108 (2019-03-05):

Standard Operation State Machine

drewsum, 2019-03-05:
We need to find a way to implement the standard operation state machine so that our project will work without us typing in serial commands. Ideally, this will work this way: On boot, PIC will move image from first external Flash chip to EBI SRAM, then from EBI SRAM to internal RAM (Doing this in two steps will actually make the coding easier). It will start multiplexing this image. Then, while muxing this image, PIC will move image stored in second flash chip into EBI SRAM. Once we're done displaying the first image, we'll move the second image from EBI SRAM into internal RAM. This process will continue until we've loaded flash chip 8's data into EBI SRAM, and then we'll display that image. Behavior will then wrap around and we'll move flash chip 1's data into EBI SRAM while displaying image 8. This will continue indefinitely. If the WIFI module requests a data transfer to download a new image, multiplexing will be suspended, data will move from WIFI UART into EBI SRAM, and then WIFI will direct the PIC to place it into it's given flash chip. Muxing will then restart from the first flash chip once data transfer is complete.

drewsum, 2019-03-30:
My ideas for this:
* We should have a flag called something like `uint8_t standard_operation_state` or something that keeps track of if we're operating in the standard state machine (which is like the board running on autopilot without human intervention), or if we're controlling it manually from the serial port or over WiFi.
* We need to write a function in `spi_flash.c` and `spi_flash.h` that checks to see if a given chip is erased. It could do this by reading from the last available memory address in SPI Flash. If this byte is 0xFF, we know this chip is erased, since we'd never place image data or metadata at this address.
* We need to write a state machine with some kind of enumeration or something that steps through each SPI Flash chip and reads it into EBI SRAM while the previous image is being displayed. Once the transfer is complete, we start a timer, and when that timer has expired, we copy data from EBI SRAM into the internal buffer. There are functions in `external_bus_interface.c` and `spi_flash.c` to accomplish these transfers already, they just need to be called automatically.

Closed 2019-04-13.

Thread 110 (2019-03-06):

Power Board Hardware Changes

drewsum, 2019-03-06:
We need to recompensate the power board control loop to make the transient response for the panels be not terrible. We also need to shorten up the leads to the panels from the power board, and fix the color of the +5V leads. We need to increase the current limit by changing the ILIM resistor, and we might want to remove some of the testing circuitry that was originally installed. Finally, we want to replace the standoffs on the board, reposition the fan, and install the board on the back of the panels for good.

drewsum, 2019-03-06:
We'll also want to solder on new connectors to the power board for the interface to the logic board

drewsum, 2019-04-07:
Log calculated that we need at least 150nF of cap on the soft start pin. Hopefully this will fix our startup issues.

Closed 2019-04-10.

Thread 111 (2019-03-06):

Delay between frames

kevinetta, 2019-03-06:
Store the amount of time in seconds that each frame should be displayed (before screen-switching to the next frame in flash) in the header struct of each flash chip. This value can be parsed when the flash chip is accessed to be used by a timer. On the app side, when adding a frame to a project, a value must be entered for display time, with a default of 10 seconds.

A theoretical workflow on the embedded side would check the flash chip for if there is a frame stored in it ( a byte should be used in the header of each flash chip to tell this) and if there is that header should also contain the time delay of how long to display the image, all followed by the image bytes.

drewsum, 2019-04-18:
Got this figured out, closing

Closed 2019-04-18.

Thread 112 (2019-03-06):

Investigate Prefetch WAIT States Settings

drewsum, 2019-03-06:
I have no idea what to set PRECONbits.PFMWS to. I have a feeling this is pretty important. When I wrote the prefetch module code, I set this to the highest possible value, seven. I don't know if this is correct. We need to determine what to set this to in order to maximize CPU bandwidth. We should also investigate to see if the prefetch module should or should not cache data memory, which is a capability. Right now it's only set to cache CPU instructions.

drewsum, 2019-03-07:
Datasheet says with a SYSCLK > 200MHz and < 252MHz, we should set PFMWS to 4 wait states. Let's experiment with this and see if we can use this to get multiplexing even faster so we could potentially switch back to a higher color resolution than 5 PWM frames.

Closed 2019-03-08.

Thread 114 (2019-03-07):

Mechanical Final Touches

drewsum, 2019-03-07:
To finish off the mechanical assembly, we need to:
* order two angled support T-slotted frame bars to ensure the display stands upright, along with another T-slotted base bar to make the frame a sort of "Eisel".
* We also might want to use that spare T slotted bar we have laying around as a center support.
* We should mount all the circuit boards to the back acrylic brackets as well as the chassis power supply. * Finally, let's decide where we want the rotary encoder and master on/off switch to go, as well as the AC inlet.
* We should definitely put more thought into the AC inlet to make sure it's safe and impossible for live wires to become exposed.
* We should ground the aluminum frame to the ground wire on the power supply chassis to ensure it's safe to handle.

drewsum, 2019-04-02:
What we have yet to do as of 4/2/2019:
* We should 3D print a housing around the AC inlet to mount it to the T slotted bar frame.
* We should ground the aluminum frame to the ground wire on the power supply chassis to ensure it's safe to handle.
* We also might want to use that spare T slotted bar we have laying around as a center support.
* We should use that short stubby piece of T slotted bar as feet for the legs.

drewsum, 2019-04-27:
Update as of 4/27/19:
I hot glued the AC input stuff to try to make it safer. We should still ground the frame eventually.
We should take the project apart and try to get all of the gaps out and remove the extra fasteners in the T-slotted frame

Closed 2019-05-05.

Thread 115 (2019-03-08):

Add voltage regulator error detection

drewsum, 2019-03-08:
Write interrupt on change ISRs to detect the falling edge of PGOOD signals and record into error handler flags if a power supply issue occurs.

Closed 2019-03-29.

Thread 119 (2019-03-15):

ESP8266 Causing PIC CPU Exception and WDT Timeout

drewsum, 2019-03-15:
Something weird is going on between the PIC and the ESP8266. When the ESP is unplugged from its socket on the PCB, the PIC boots just fine when calling the `esp8266Initialize()` function. When the ESP is plugged in, the PIC enters a CPU exception state and shits the bed. If the ESP is unplugged when the PIC tries to boot, the PIC boots successfully and runs firmware as normal. During normal operation after boot, when the ESP is plugged back into its socket, the PIC enters a CPU exception and a WDT timeout occurs. Something weird is going on here. I have a feeling it has something to do with UART 1 baud rates/ESP sending data back to the PIC when it's not ready/memory allocation issues. Using a UART init function copied from the USB_UART module, the PIC boots successfully. It's only when the ESP hardware is present that a CPU exception occurs.

drewsum, 2019-03-22:
This ended up being an issue with UART1 interrupt priority levels. TX ISR had priority of 2 while priority was set to 7 in code. Fixed by changing priority numbers.

Closed 2019-03-22.

Thread 128 (2019-04-07):

Number of Slides

drewsum, 2019-04-07:
We need to add functionality to keep track of how many SPI Flash chips are used in a project, since we're unable to do this as currently are trying to implement it.

Let's write data into a PIC Internal Flash memory location to keep track of this.

Looking at page 109 of datasheet, as well as the flash section of the PIC32 reference manual

drewsum, 2019-04-08:
Got this working, saving a variable at progmem address 0x1D1FFFF0

Closed 2019-04-08.

Thread 137 (2019-04-10):

WiFi / State Machine Integration

drewsum, 2019-04-10:
We need to combine the WiFi functionality with the standard operation state machine. There should be a WiFi command after a project is loaded to be able to restart the state machine.

drewsum, 2019-04-13:
Only issue we're really facing now is app power toggle button doesn't really work

drewsum, 2019-04-18:
Fixed this, closing

Closed 2019-04-18.

Thread 138 (2019-04-12):

Solve Power Board Input Protection MOSFET Overheating

drewsum, 2019-04-12:
We've been using the IPC100N04S5-1R7 as the input protection MOSFET on the power board. Under load it's getting too hot. If this MOSFET fails, the entire system fails. We need to pick a new MOSFET with lower RDS(on) that will not overheat.

Needs to have VGS > +/- 20V, IDS > 50 Amps, RDS(on) < 1mOhm, VDS > 20V

cmgilger1, 2019-04-12:
https://www.digikey.com/product-detail/en/infineon-technologies/IPC100N04S51R2ATMA1/IPC100N04S51R2ATMA1CT-ND/6578406

cmgilger1, 2019-04-12:
https://www.digikey.com/product-detail/en/infineon-technologies/IPC100N04S5L1R1ATMA1/IPC100N04S5L1R1ATMA1TR-ND/6559884

VGS = +/- 16V
IDS = 100A
RDS(on) = 1.1mOhm (VGS=10V, IDS=50A)
VDS = 40V

drewsum, 2019-04-18:
Added two beefy heatsinks to the input protection FETs, donated by Dean and Nate. Will want to replace FETs with the lower Rds(on) alternatives we bought later anyway.

cmgilger1, 2019-04-22:
parts came in and I'll be putting them in the locker tomorrow morning

drewsum, 2019-04-27:
The original input protection FETs we have installed on the power board (IPC100N04S51R7ATMA1) have a voltage drop of 2 Volts with a white image at full brightness. This explains why they get so damn hot. Running the numbers, I'm guessing the two series FETS have a combined RDSon of 120 mOhm. That's waaaaay too high. Trying to swap some FETs to see the other results we can get.

drewsum, 2019-04-27:
I must have been smoking some crack when I picked the original input protection MOSFETs.  I replaced both of them with IPC100N04S51R2ATMA1 and it runs great, really cool. Only a 19mV voltage drop at full load. Let's stick with these. No heatsinks needed

Closed 2019-04-27.

Thread 139 (2019-04-12):

SPI Flash 5 Issue

drewsum, 2019-04-12:
We've had SPI Flash chip 5 fail multiple times. Can't tell if it's a timing issue or hardware issue. Flash chip 5 will only return a white image, suggesting it remains in the erased state, or that we don't read from it correctly

drewsum, 2019-04-13:
This seems to have resolved itself with changed SPI Flash write timing. Let's keep an eye on it

drewsum, 2019-04-26:
Looks like this problem has been resolved

Closed 2019-04-26.

Thread 140 (2019-04-12):

Fan

drewsum, 2019-04-12:
259-1566-ND

cmgilger1, 2019-04-12:
https://www.digikey.com/product-detail/en/delta-electronics/AFB0412SHB/603-1006-ND/1014337

drewsum, 2019-04-27:
Replacing the fan we started with with new fan with crimp connectors on the wire ends

Closed 2019-04-27.
