drewsum/Electronic_Display/hdw/Logic_Board/LED_Display_Controller_Poster.pdf

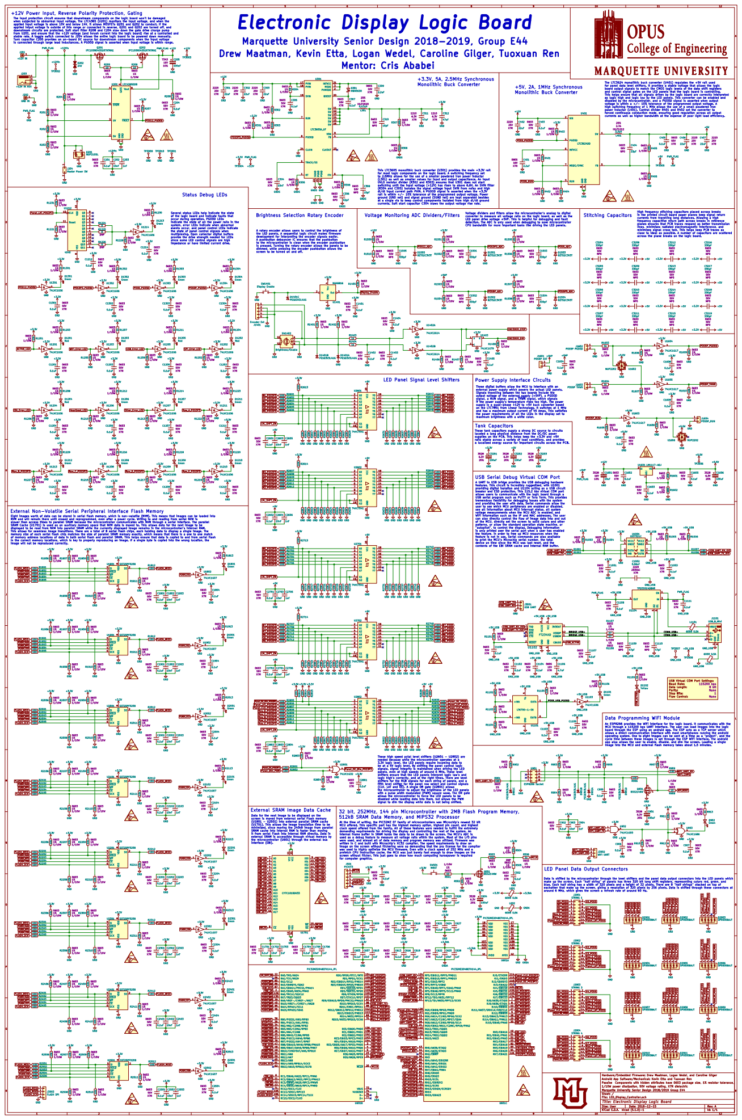
[picture p15: page 1]

+12V Power Input, Reverse Polarity Protection, Gating

Electronic Display Logic Board

The input protection circuit ensures that downstream components on the logic board won't be damaged
when subjected to abmormal input voltage. The LTC4365 (U201) monitors the input voltage, and when the
applied input voltage is above 10V and below 14V, it allows MOSFETs Q201 and Q202 to conduct. If the
applied intput voltage is outside of this range or connected in reverse, Q201 and Q202 are turned off, and
downstream circuits are protected. Soft start filter R208 and C204 slow down the gate drive charge pump
from U201, and ensure that the +12V voltage (and inrush current into the logic board) rise at a controlled and
stable rate. A toggle switch connected to J204 allows the entire logic board to be powered down manually.
Tank capacitor C205 provides an on-board DC source for downstream components when the input voltage
is connected through large lead inductances. A PGOOD signal is asserted when input voltage is within range.

Marquette University Senior Design 2018-2019, Group E44

5 Vout 6 FAULT 7 SHDN 8 GND

1 OV 2 UV 3 Vin 4 GATE

This LTC3605 monolithic buck converter (U301) provides the main +3.3V rail
for most logic components on the logic board. A switching frequency set
to 2.5MHz allows for the use of a smaller powdered iron power inductor
(L301) as well as smaller values for input and output capacitance. An input
UVLO resistor divider (R302 and R303) ensures that U301 does not start
switching until the input voltage (+12V) has risen to above 6.6V. An SVIN filter
(R304 and C305) isolates the signal voltage input SVIN from noisy and high
di/dt input current path PVIN. A PGOOD signal is asserted w

LED Panel Signal Level Shifters

Power Supply Interface Circuits

100 R2625 10K R2623 10K R2621 10K R2619 10K R2617 10K R2615 10K GND GND GND GND GND GND

GND
USB Serial Debug Virtual COM Port

100 R2626 10K R2624 10K R2622 10K R2620 10K R2618 10K R2616 10K GND GND GND GND GND GND

External Non-Volatile Serial Peripheral Interface Flash Memory

100 R2725 10K R2723 10K R2721 10K R2719 10K R2717 10K R2715 10K GND GND GND GND GND GND

4 SI 5 SCK 6 HOLD 7 VDD

100 R2726 10K R2724 10K R2722 10K R2720 10K R2718 10K R2716 10K GND GND GND GND GND GND

600R 0.5A GND_USB Baud Rate: Data Length:

USB Virtual COM Port Settings:

Data Programming WiFi Module

512kB SRAM Data Memory, and MIPS32 Processor

LED Panel Data Output Connectors

6 D2912 SP0505BAJT GND GND GND GND G2_POS5 R2_POS5 R3_POS5 G3_POS5 B2_POS5 B3_POS5 Row_E_POS5 Row_D_POS5 Row_B_POS5 Row_A_POS5 Panel_LAT_POS5 Row_C_POS5 Panel_CLK_POS5 Panel_OE_POS5 G4_POS5 R4_POS5 R5_POS5 G5_POS5 B4_POS5 B5_POS5 Row_E_POS5 Row_D_POS5 Row_B_POS5 Row_A_POS5 Panel_LAT_POS5 Row_C_POS5 Panel_CLK_POS5 Panel_OE_POS5 G6_POS5 R6_POS5 R7_POS5 G7_POS5 B6_POS5 B7_POS5 Row_E_POS5 Row_D_POS5 Row_B_POS5 Row_A_POS5 Panel_LAT_POS5 Row_C_POS5 Panel_CLK_POS5 Panel_OE_POS5

Hardware/Embedded Firmware: Drew Maatman, Logan Wedel, and Caroline Gilger
Android App Software/Mechanical: Kevin Etta and Tuoxuan Ren
Passive Components with hidden attributes have 0603 package size, 1% resistor tolerance,
1/10W power dissipation, 50V voltage rating, X7R dielectric
File: LED_Display_Controller.sch Sheet: / Marquette University Senior Design 2018/2019 Group E44

Id: 1/1 Title: Electronic Display Logic Board
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
