drewsum/Electronic_Display/hdw/Logic_Board/LED_Display_Controller/LED_Display_Controller.pdf

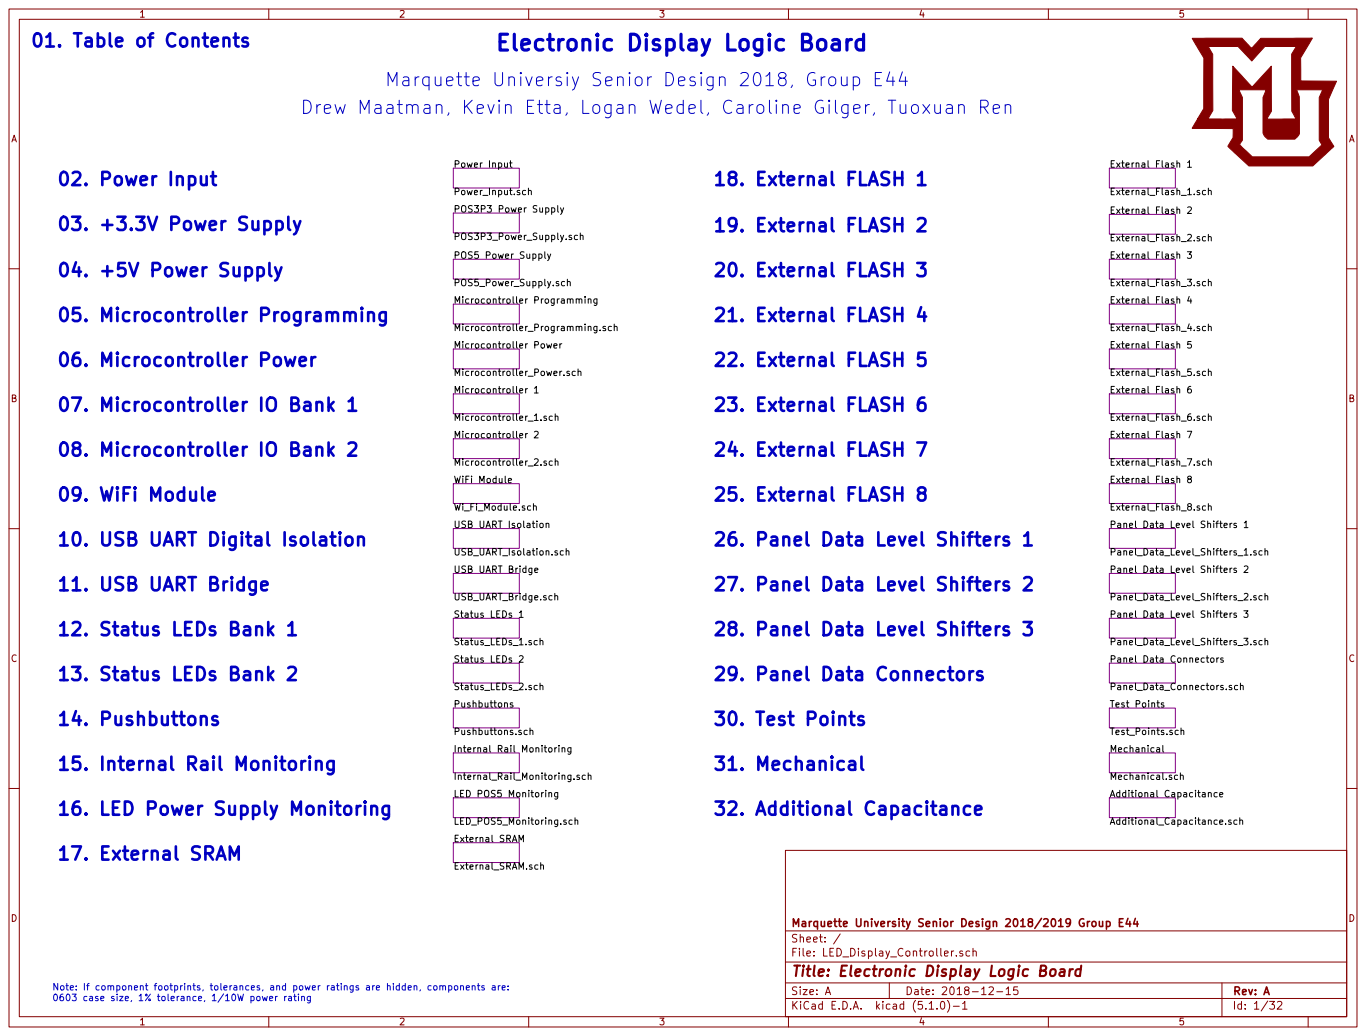
[picture p16: page 1]

Electronic Display Logic Board

Marquette Universiy Senior Design 2018, Group E44

Drew Maatman, Kevin Etta, Logan Wedel, Caroline Gilger, Tuoxuan Ren

External Flash 1 External_Flash_1.sch External Flash 2 External_Flash_2.sch External Flash 3 External_Flash_3.sch External Flash 4 External_Flash_4.sch External Flash 5 External_Flash_5.sch External Flash 6 External_Flash_6.sch External Flash 7 External_Flash_7.sch External Flash 8 External_Flash_8.sch Panel Data Level Shifters 1 Panel_Data_Level_Shifters_1.sch Panel Data Level Shifters 2 Panel_Data_Level_Shifters_2.sch Panel Data Level Shifters 3 Panel_Data_Level_Shifters_3.sch Panel Data Connectors Panel_Data_Connectors.sch Test Points Test_Points.sch Mechanical Mechanical.sch 02. Power Input

Microcontroller_Programming.sch Microcontroller Power Microcontroller_Power.sch Microcontroller 1 Microcontroller_1.sch Microcontroller 2 Microcontroller_2.sch WiFi Module Wi_Fi_Module.sch USB UART Isolation USB_UART_Isolation.sch USB UART Bridge

10. USB UART Digital Isolation

26. Panel Data Level Shifters 1

27. Panel Data Level Shifters 2

USB_UART_Bridge.sch Status LEDs 1 Status_LEDs_1.sch Status LEDs 2 Status_LEDs_2.sch Pushbuttons Pushbuttons.sch

28. Panel Data Level Shifters 3

16. LED Power Supply Monitoring

File: LED_Display_Controller.sch Sheet: / Marquette University Senior Design 2018/2019 Group E44

Id: 1/32 Title: Electronic Display Logic Board

Note: If component footprints, tolerances, and power ratings are hidden, components are:
0603 case size, 1% tolerance, 1/10W power rating

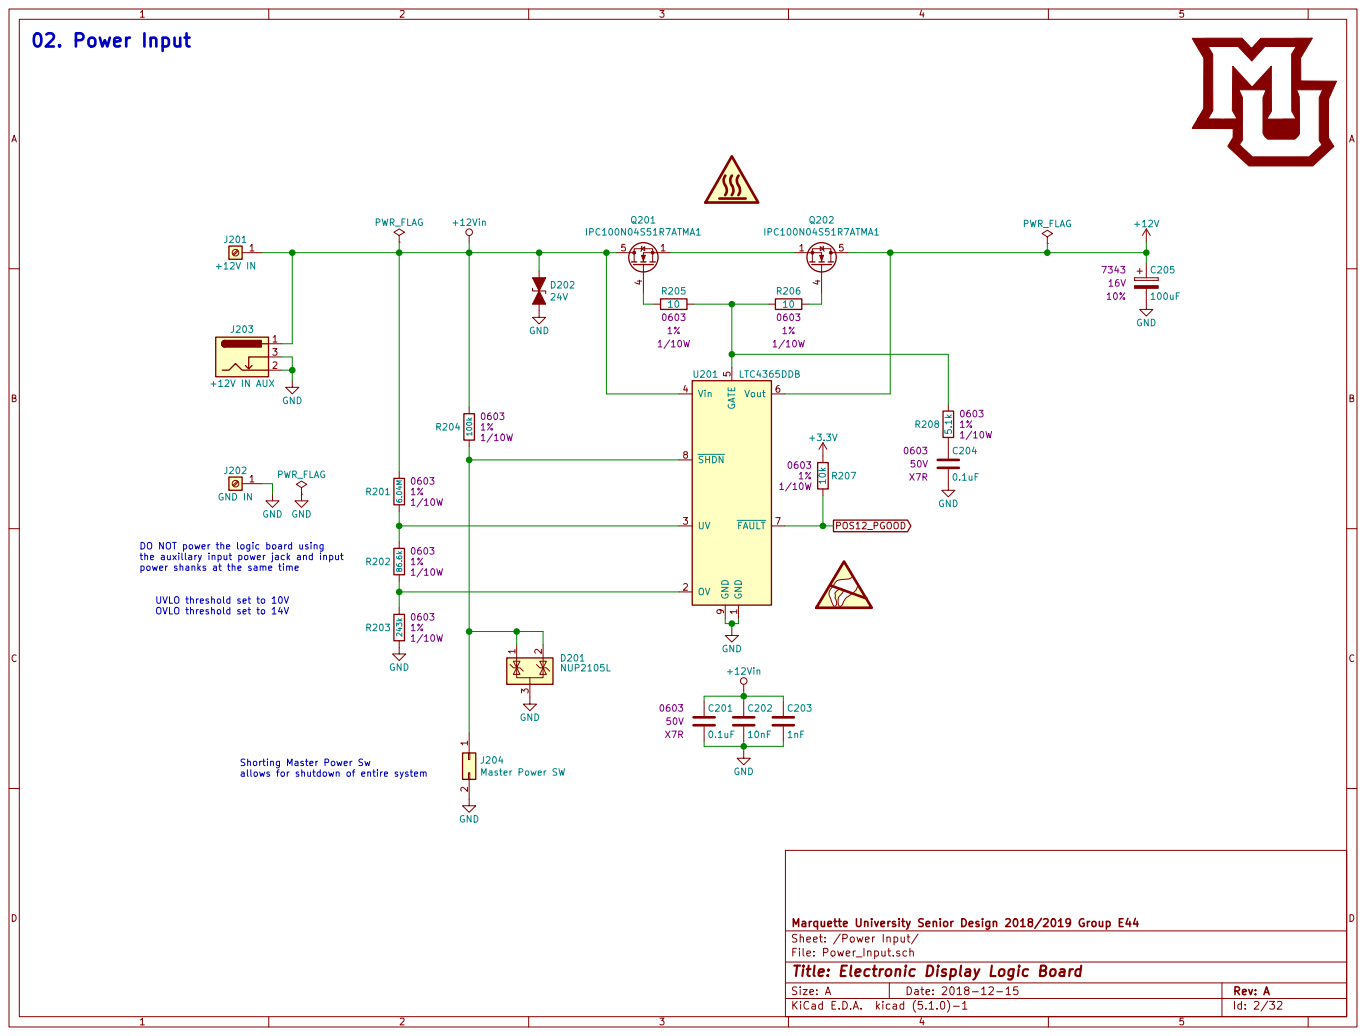
[picture p17: page 2]

5 Vout 6 FAULT 7 SHDN 8 GND

1 OV 2 UV 3 Vin 4 GATE

DO NOT power the logic board using
the auxillary input power jack and input
power shanks at the same time

UVLO threshold set to 10V OVLO threshold set to 14V

Marquette University Senior Design 2018/2019 Group E44 GND

Shorting Master Power Sw
allows for shutdown of entire system

Sheet: /Power Input/
File: Power_Input.sch
Id: 2/32 Title: Electronic Display Logic Board

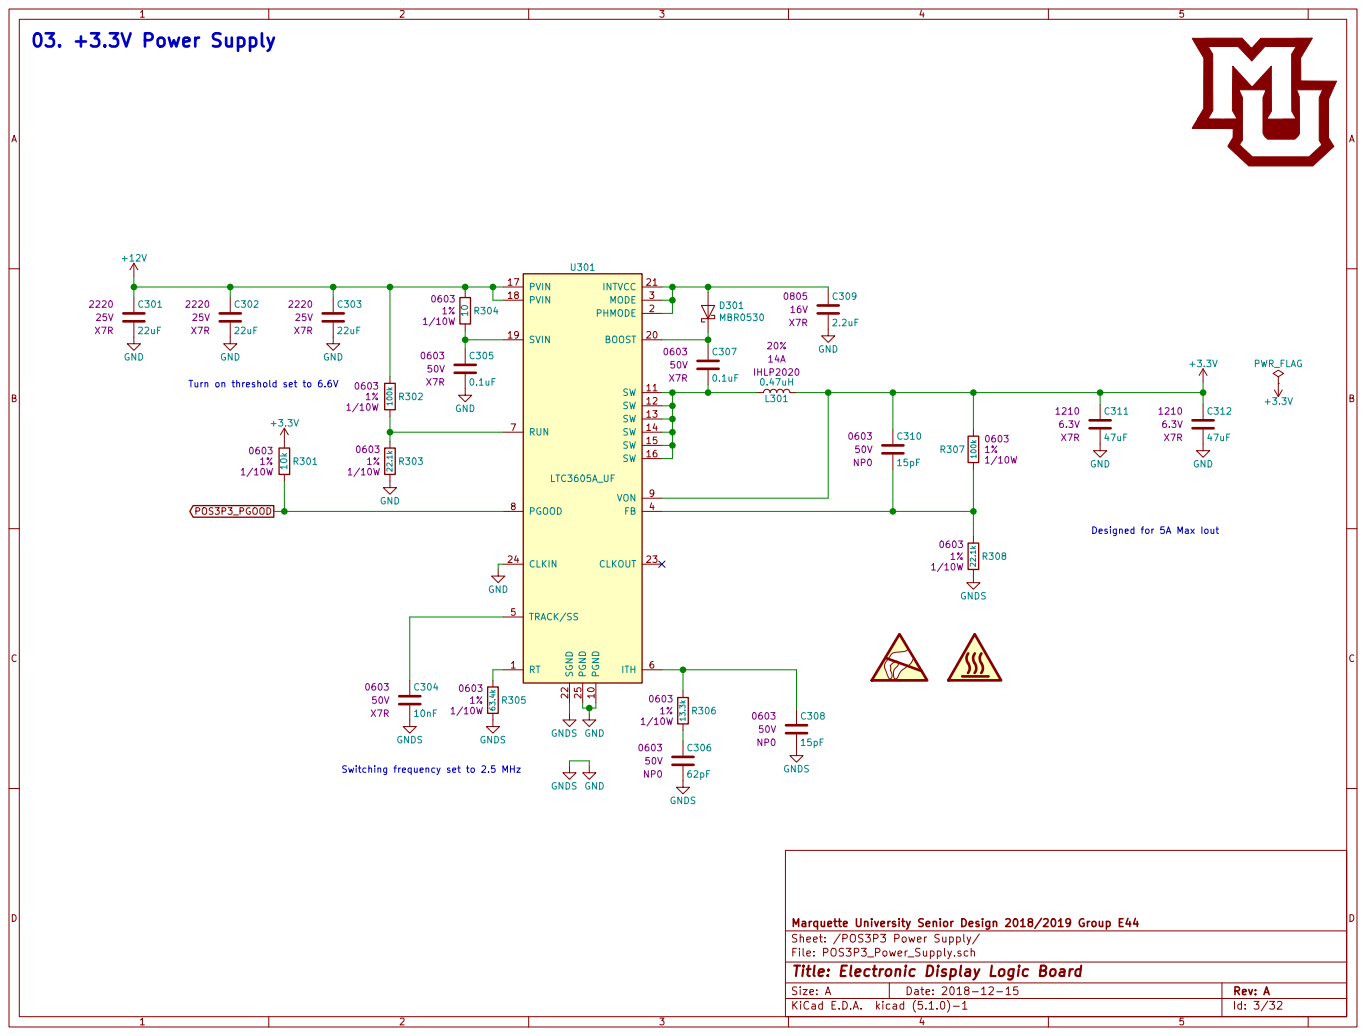
[picture p18: page 3]

Switching frequency set to 2.5 MHz C304

Marquette University Senior Design 2018/2019 Group E44
Sheet: /POS3P3 Power Supply/
File: POS3P3_Power_Supply.sch
Id: 3/32 Title: Electronic Display Logic Board

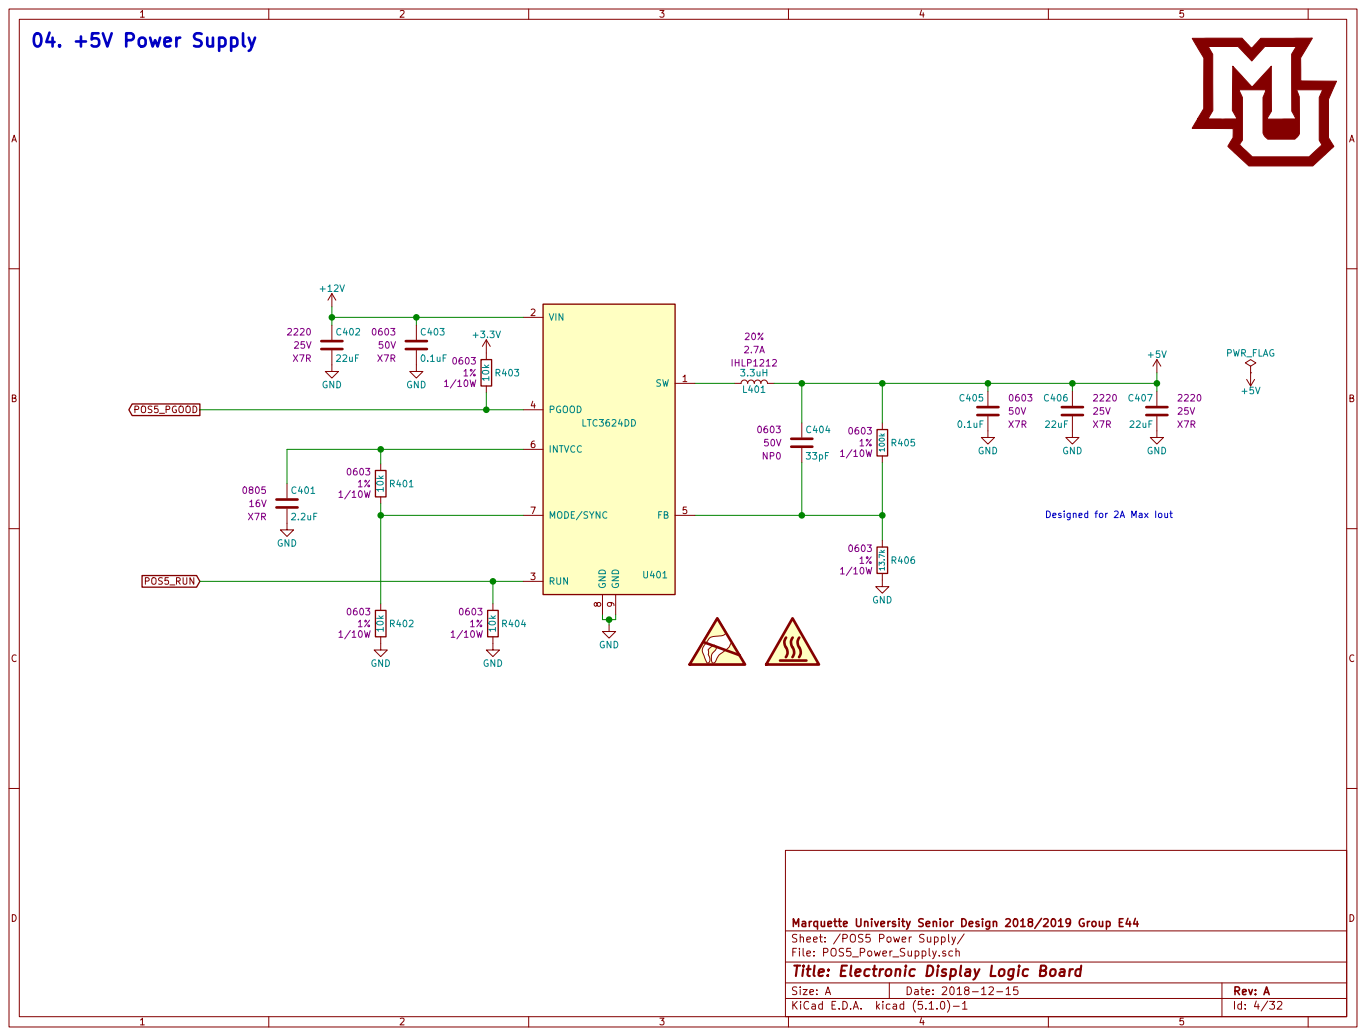
[picture p19: page 4]

Designed for 2A Max Iout

Marquette University Senior Design 2018/2019 Group E44
Sheet: /POS5 Power Supply/
File: POS5_Power_Supply.sch
Id: 4/32 Title: Electronic Display Logic Board

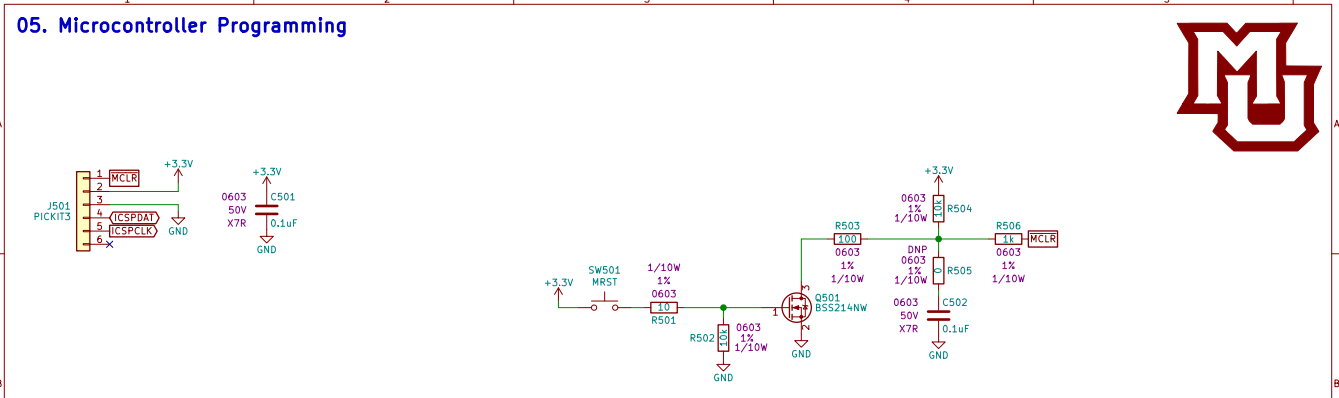
[picture p20: page 5]

Marquette University Senior Design 2018/2019 Group E44
Sheet: /Microcontroller Programming/
File: Microcontroller_Programming.sch
Id: 5/32 Title: Electronic Display Logic Board

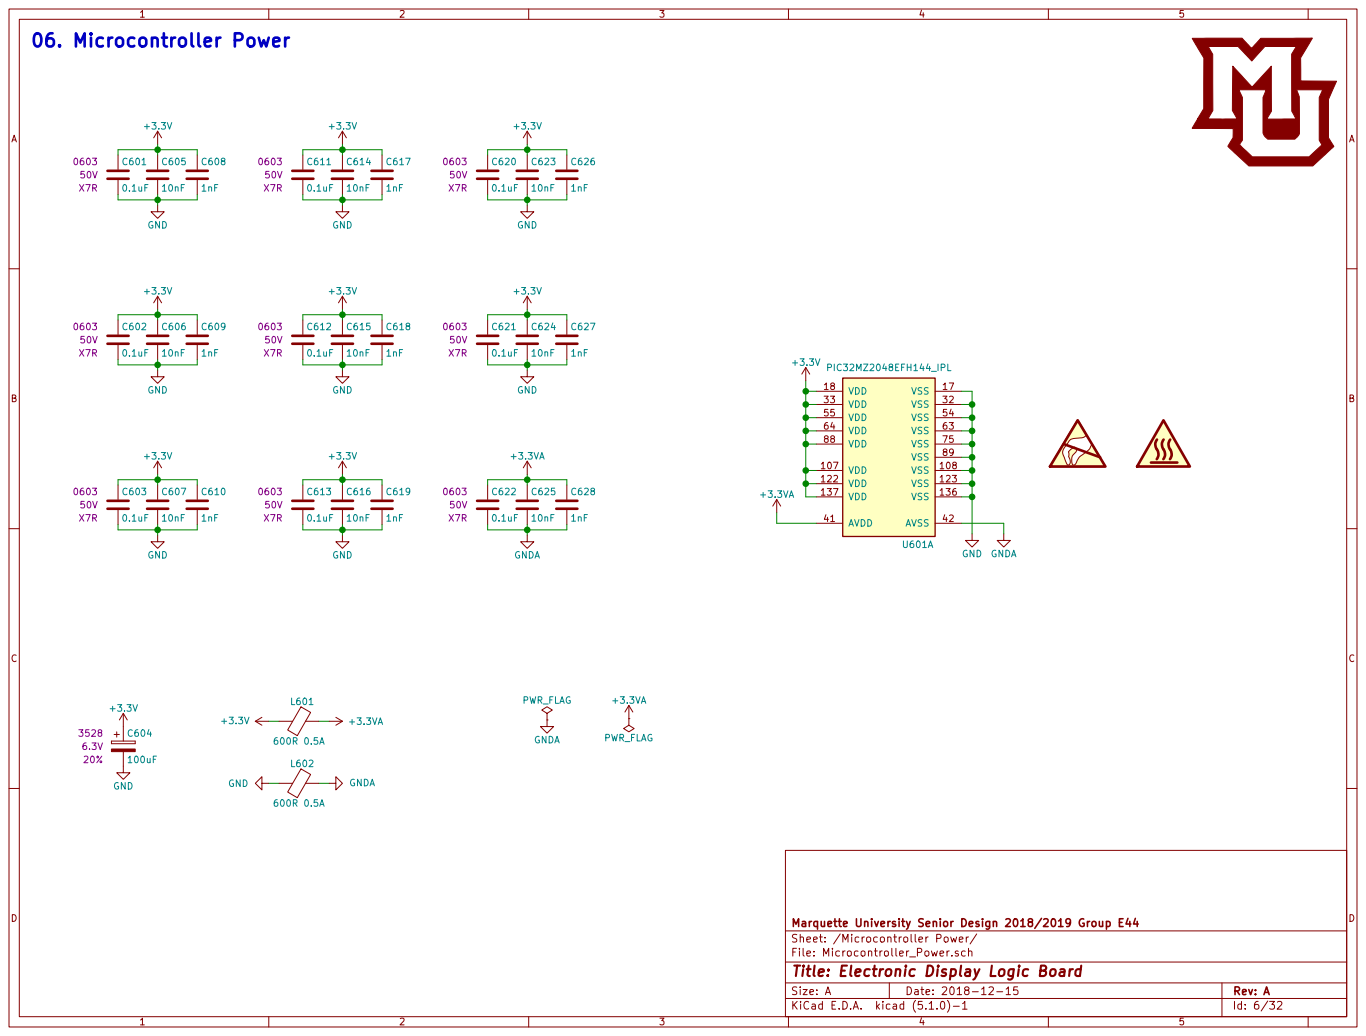
[picture p21: page 6]

File: Microcontroller_Power.sch Sheet: /Microcontroller Power/ Marquette University Senior Design 2018/2019 Group E44

Id: 6/32 Title: Electronic Display Logic Board

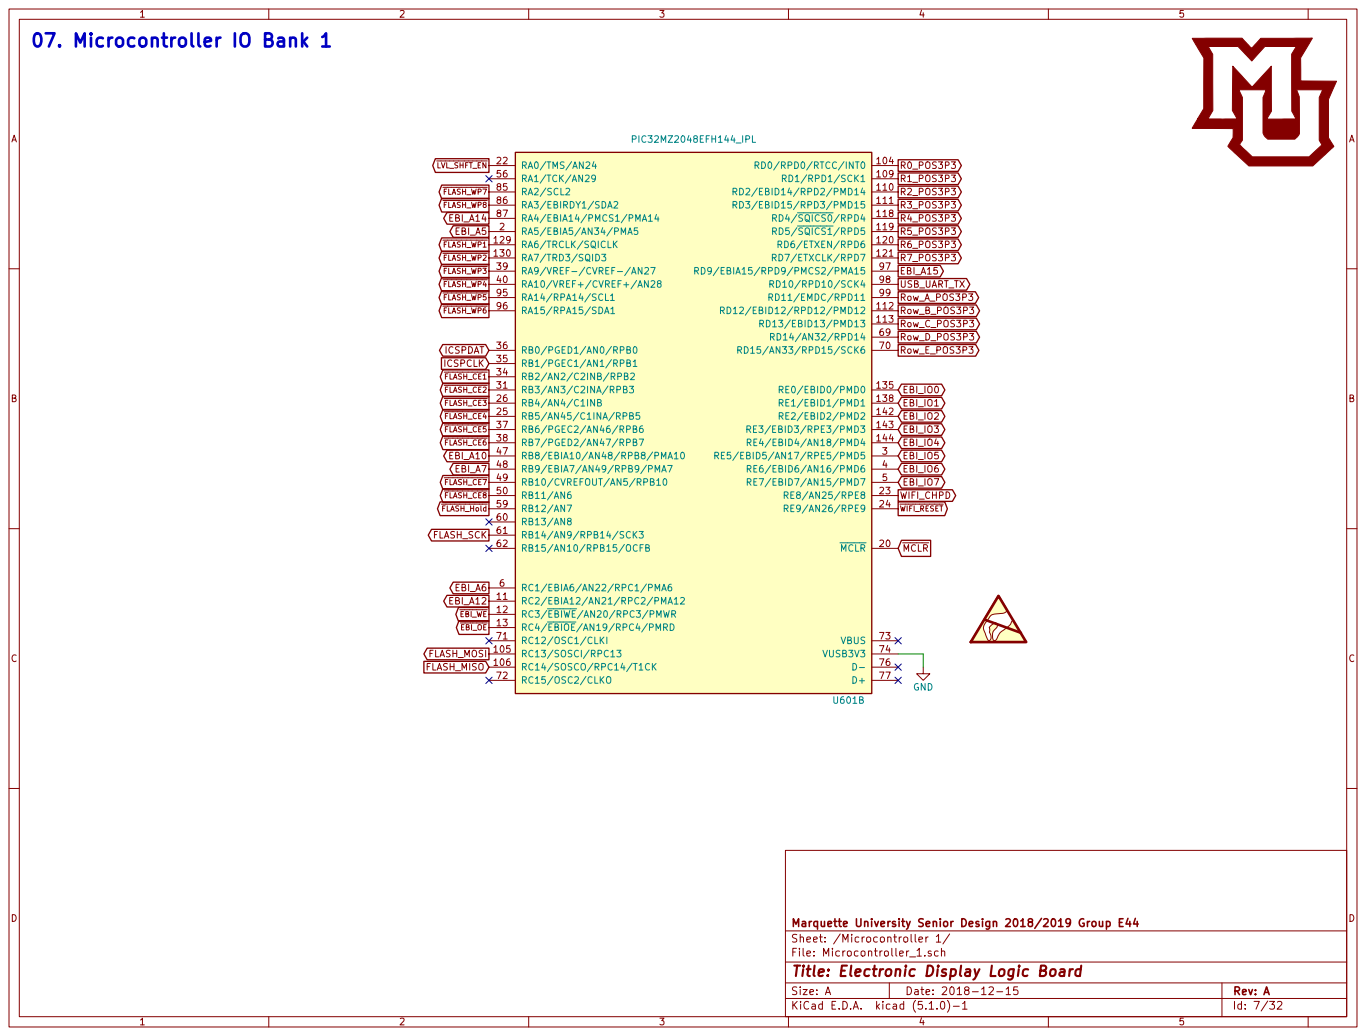
[picture p22: page 7]

File: Microcontroller_1.sch Sheet: /Microcontroller 1/ Marquette University Senior Design 2018/2019 Group E44

Id: 7/32 Title: Electronic Display Logic Board

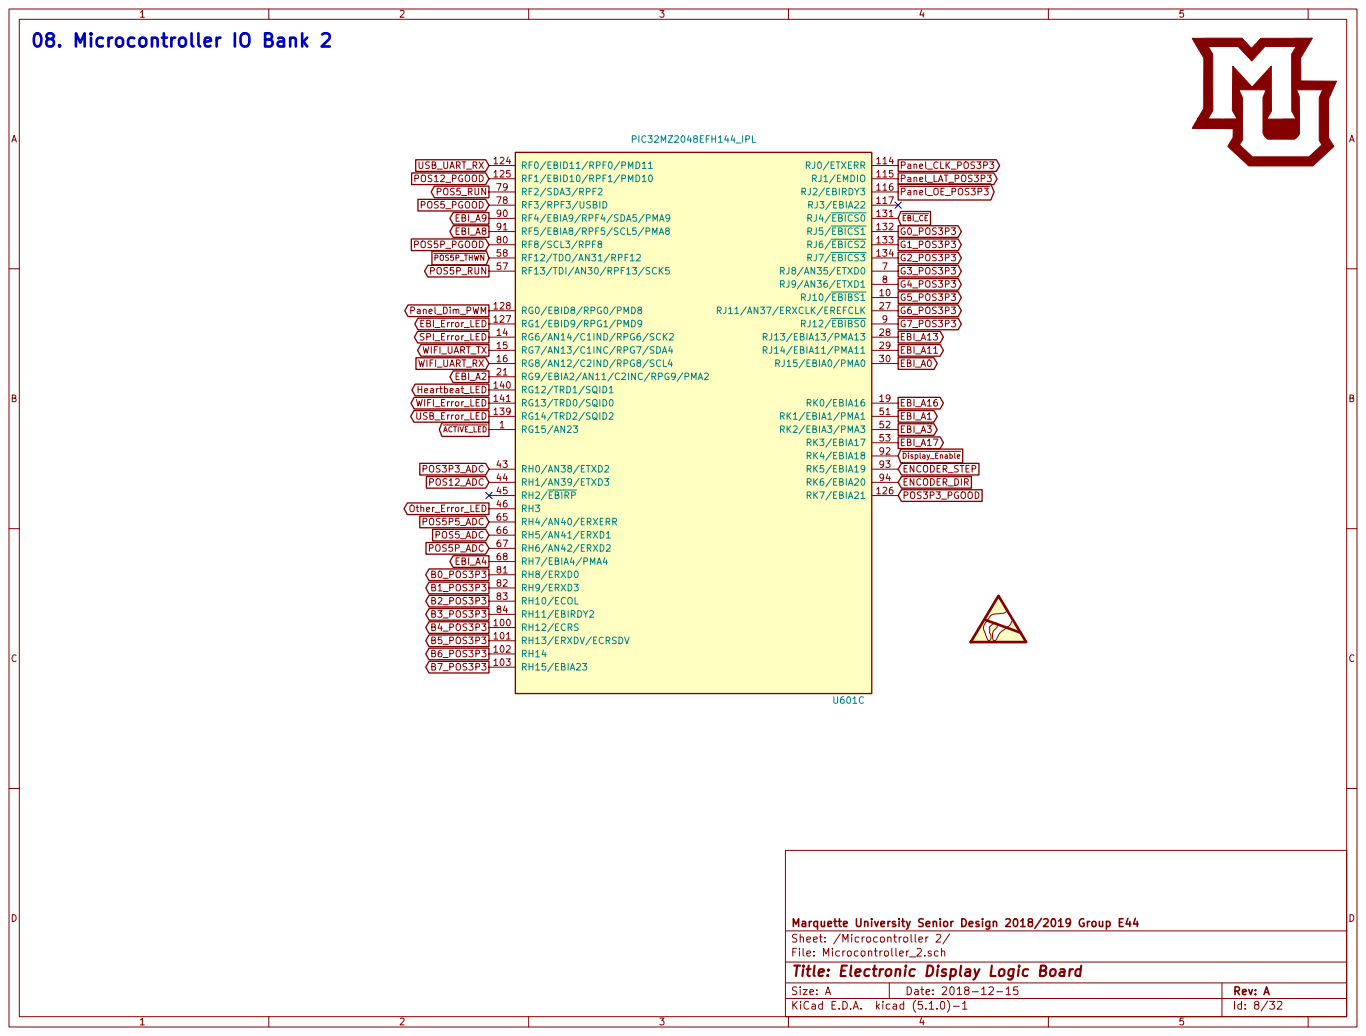
[picture p23: page 8]

File: Microcontroller_2.sch Sheet: /Microcontroller 2/ Marquette University Senior Design 2018/2019 Group E44

Id: 8/32 Title: Electronic Display Logic Board

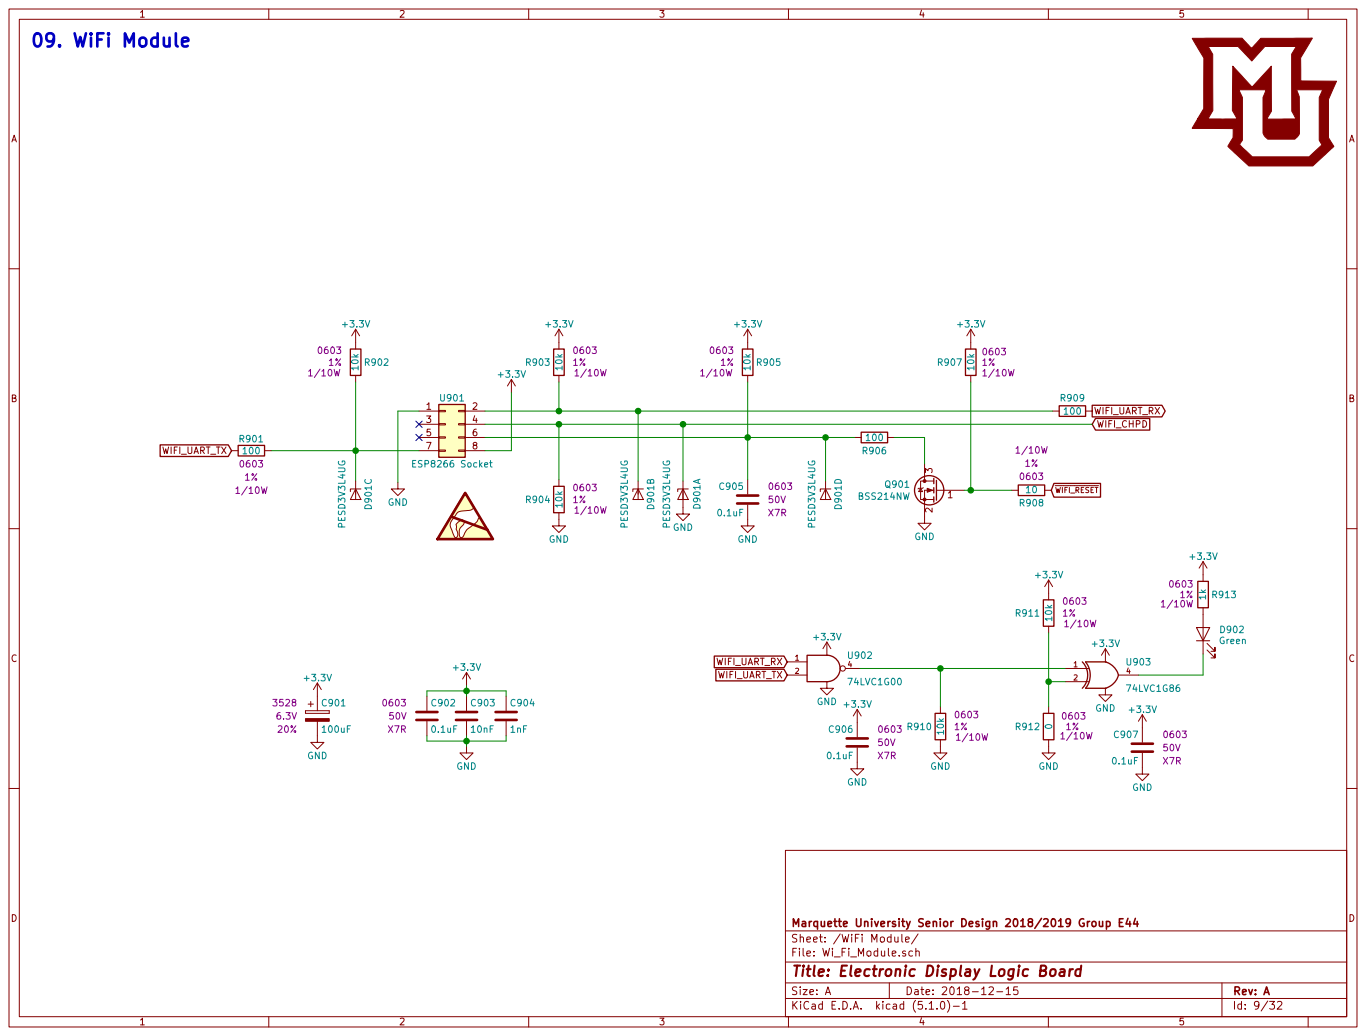
[picture p24: page 9]

File: Wi_Fi_Module.sch Sheet: /WiFi Module/ Marquette University Senior Design 2018/2019 Group E44

Id: 9/32 Title: Electronic Display Logic Board

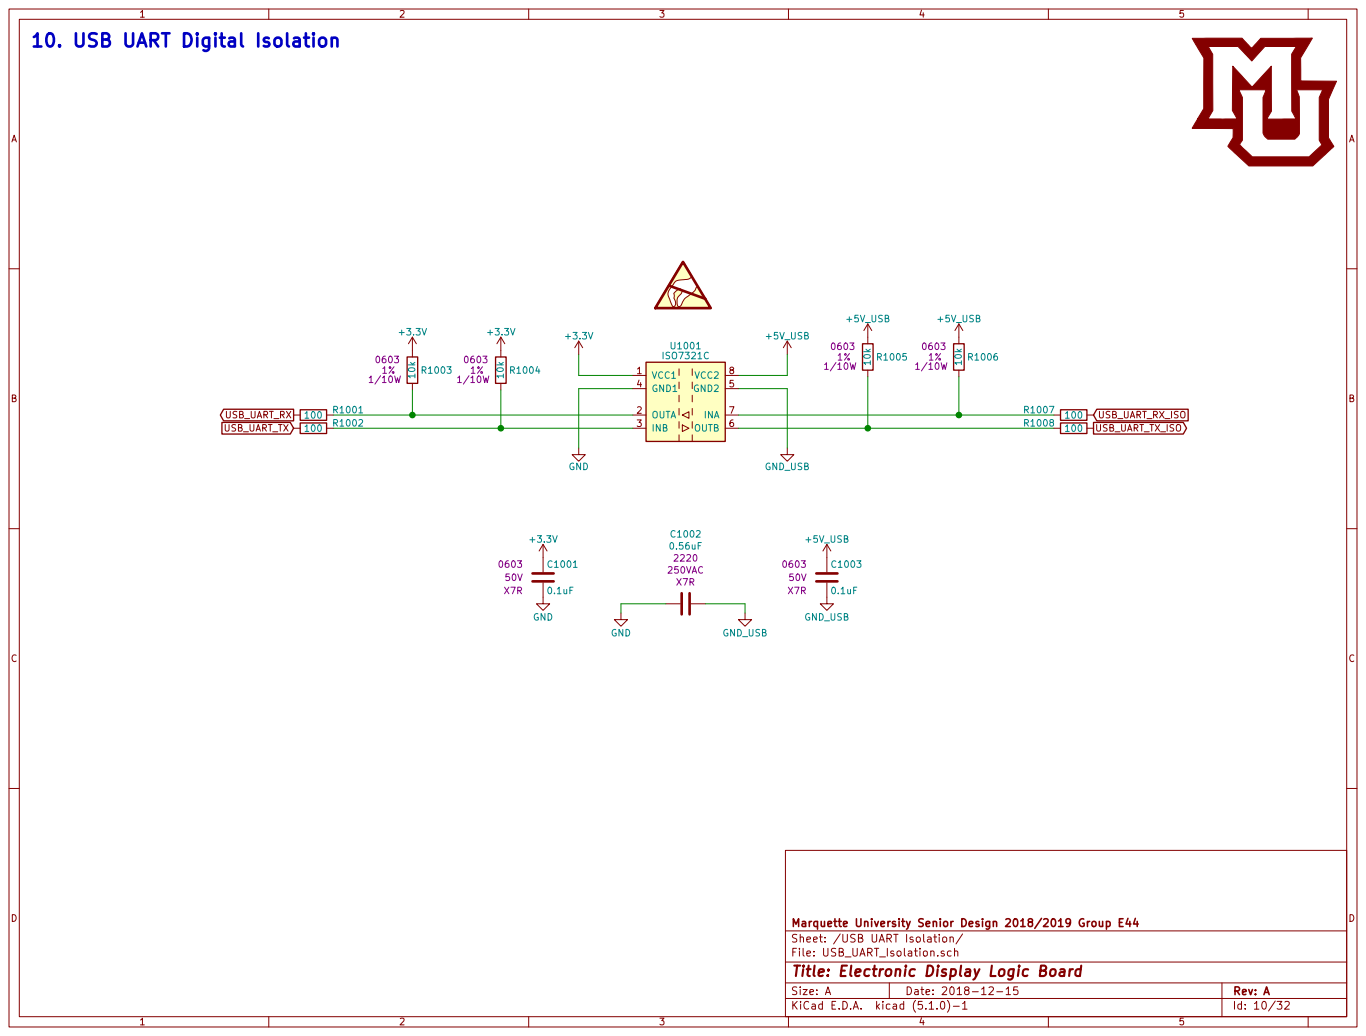
[picture p25: page 10]

File: USB_UART_Isolation.sch Sheet: /USB UART Isolation/ Marquette University Senior Design 2018/2019 Group E44

Id: 10/32 Title: Electronic Display Logic Board

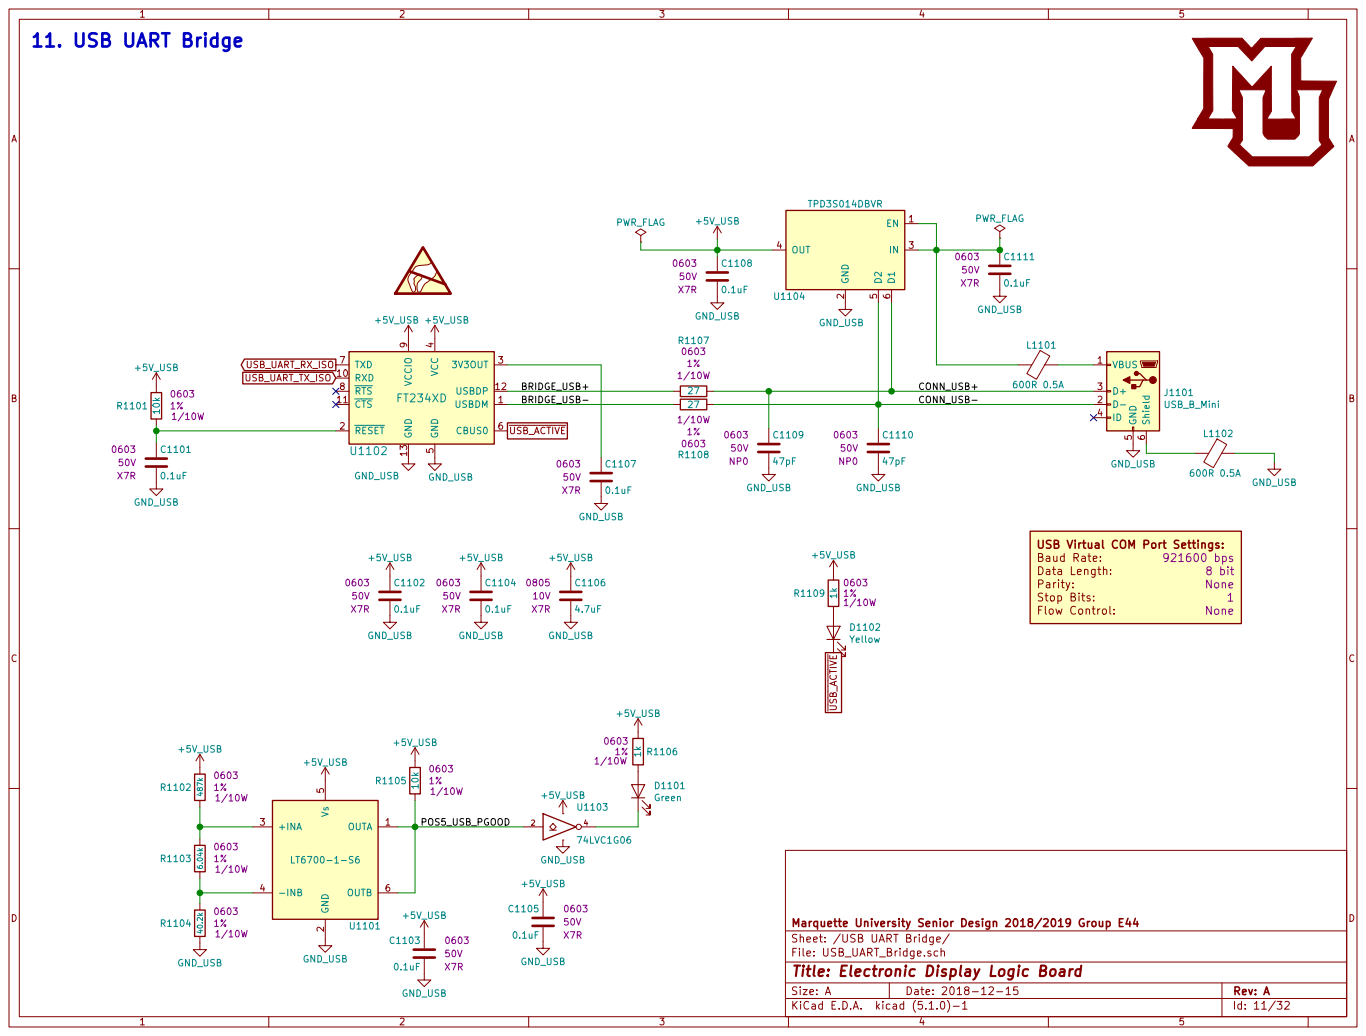
[picture p26: page 11]

USB Virtual COM Port Settings:

Marquette University Senior Design 2018/2019 Group E44
Sheet: /USB UART Bridge/
File: USB_UART_Bridge.sch
Id: 11/32 Title: Electronic Display Logic Board

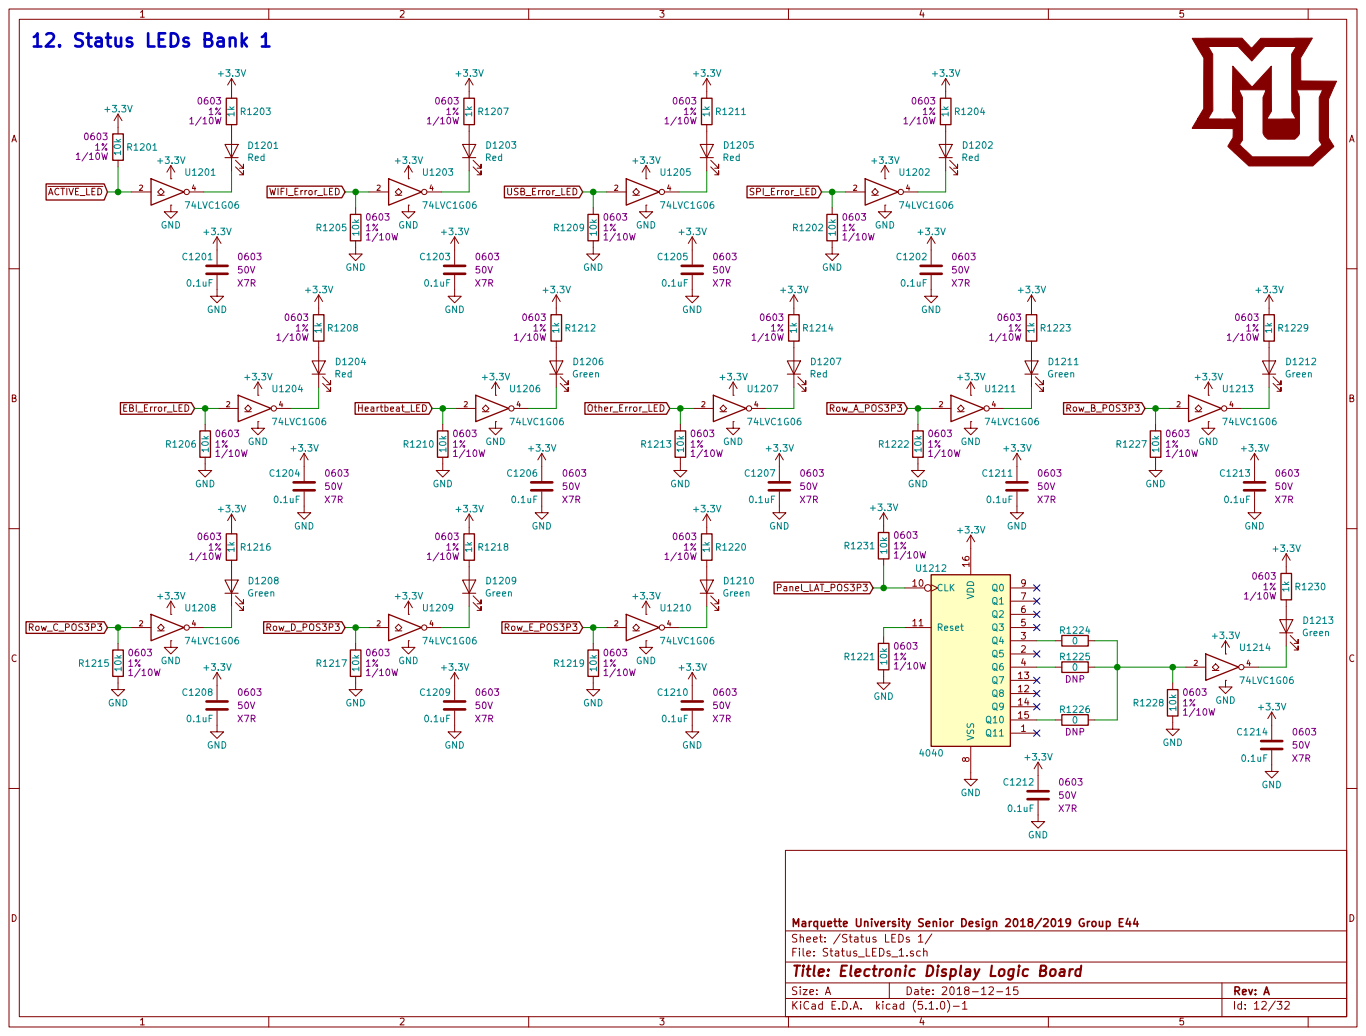
[picture p27: page 12]

File: Status_LEDs_1.sch Sheet: /Status LEDs 1/ Marquette University Senior Design 2018/2019 Group E44

Id: 12/32 Title: Electronic Display Logic Board

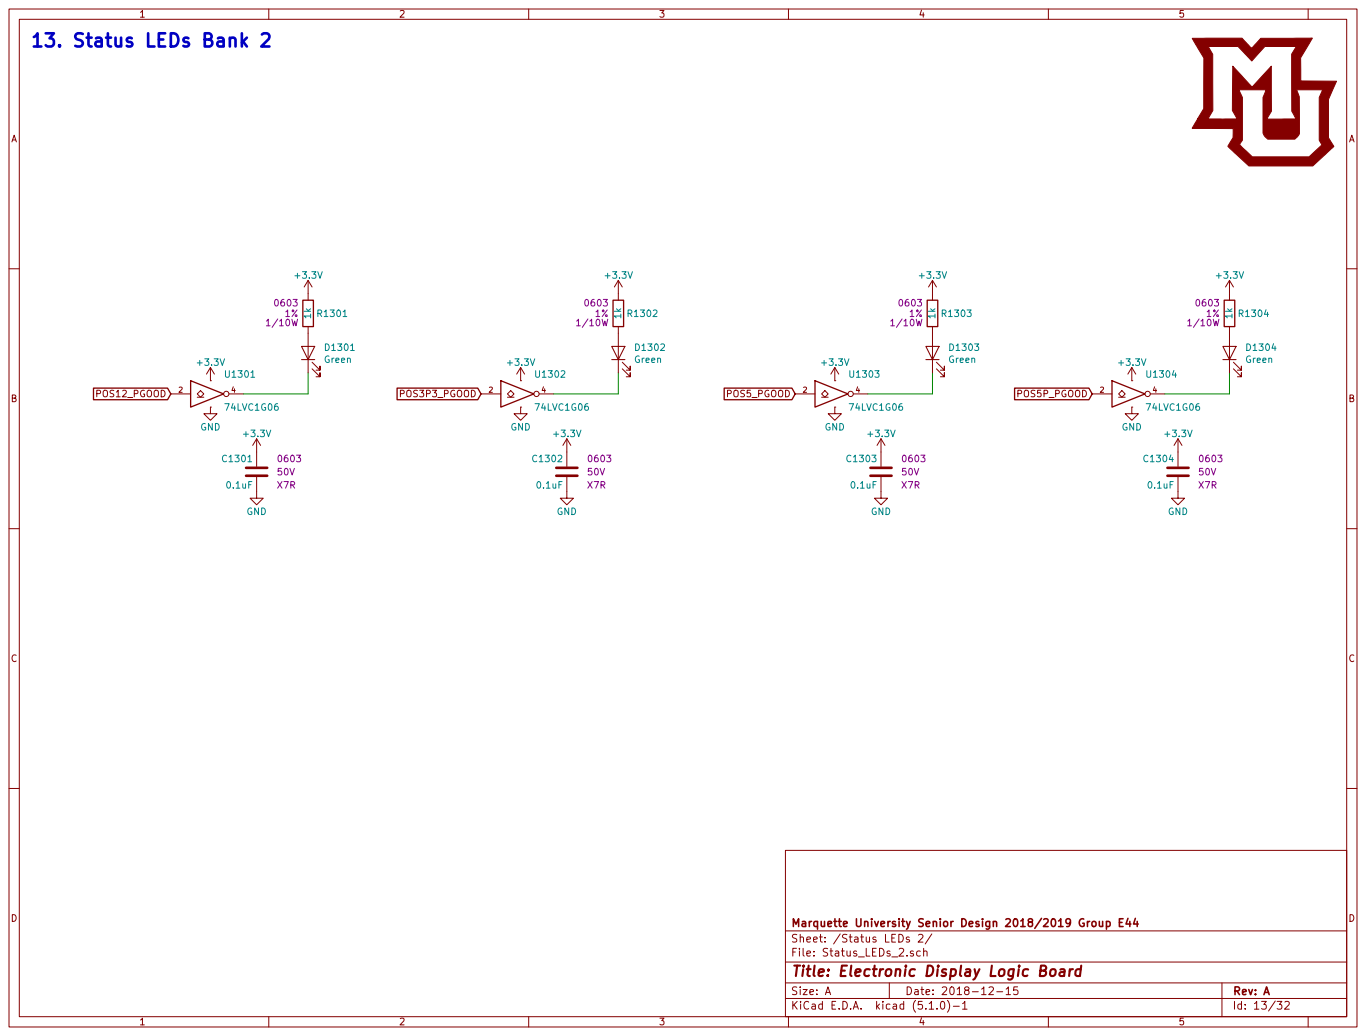
[picture p28: page 13]

File: Status_LEDs_2.sch Sheet: /Status LEDs 2/ Marquette University Senior Design 2018/2019 Group E44

Id: 13/32 Title: Electronic Display Logic Board

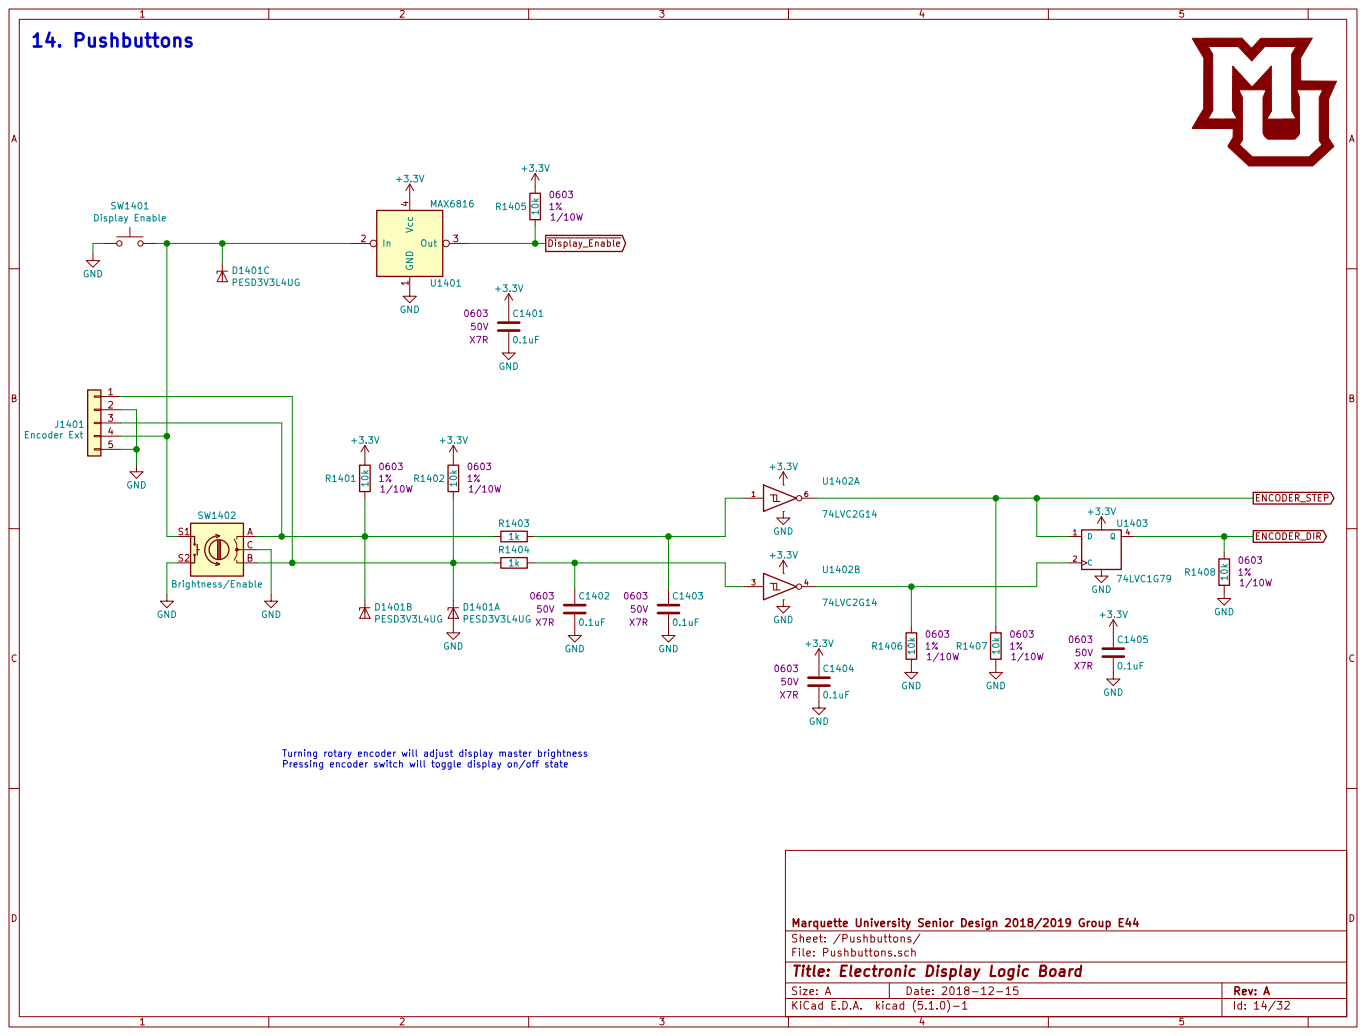
[picture p29: page 14]

File: Pushbuttons.sch Sheet: /Pushbuttons/ Marquette University Senior Design 2018/2019 Group E44 GND

Turning rotary encoder will adjust display master brightness
Pressing encoder switch will toggle display on/off state

Id: 14/32 Title: Electronic Display Logic Board

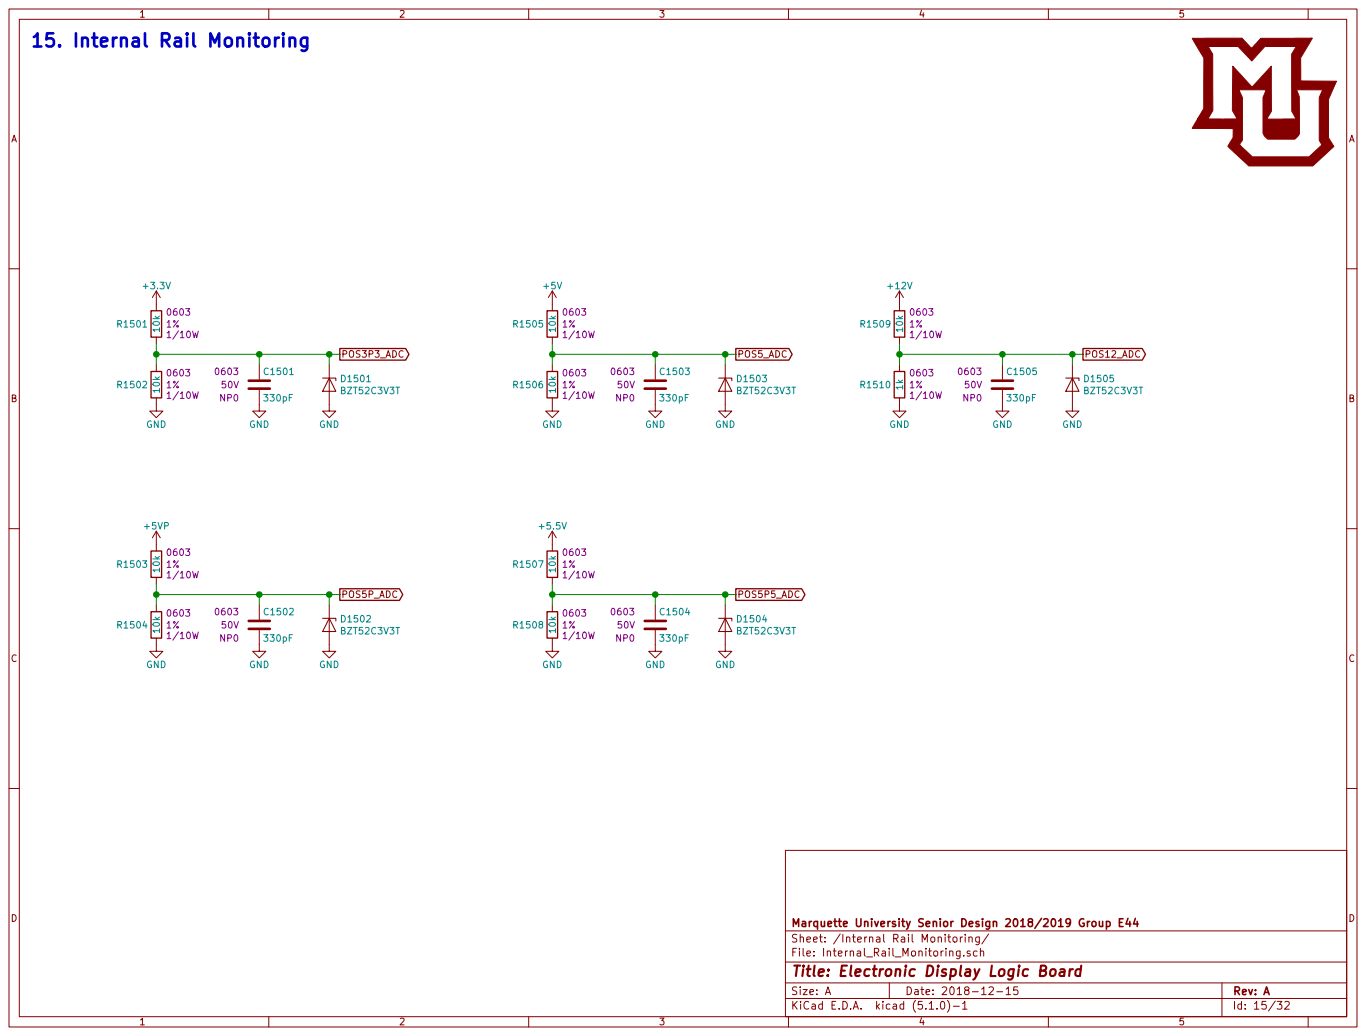
[picture p30: page 15]

Marquette University Senior Design 2018/2019 Group E44
Sheet: /Internal Rail Monitoring/
File: Internal_Rail_Monitoring.sch
Id: 15/32 Title: Electronic Display Logic Board

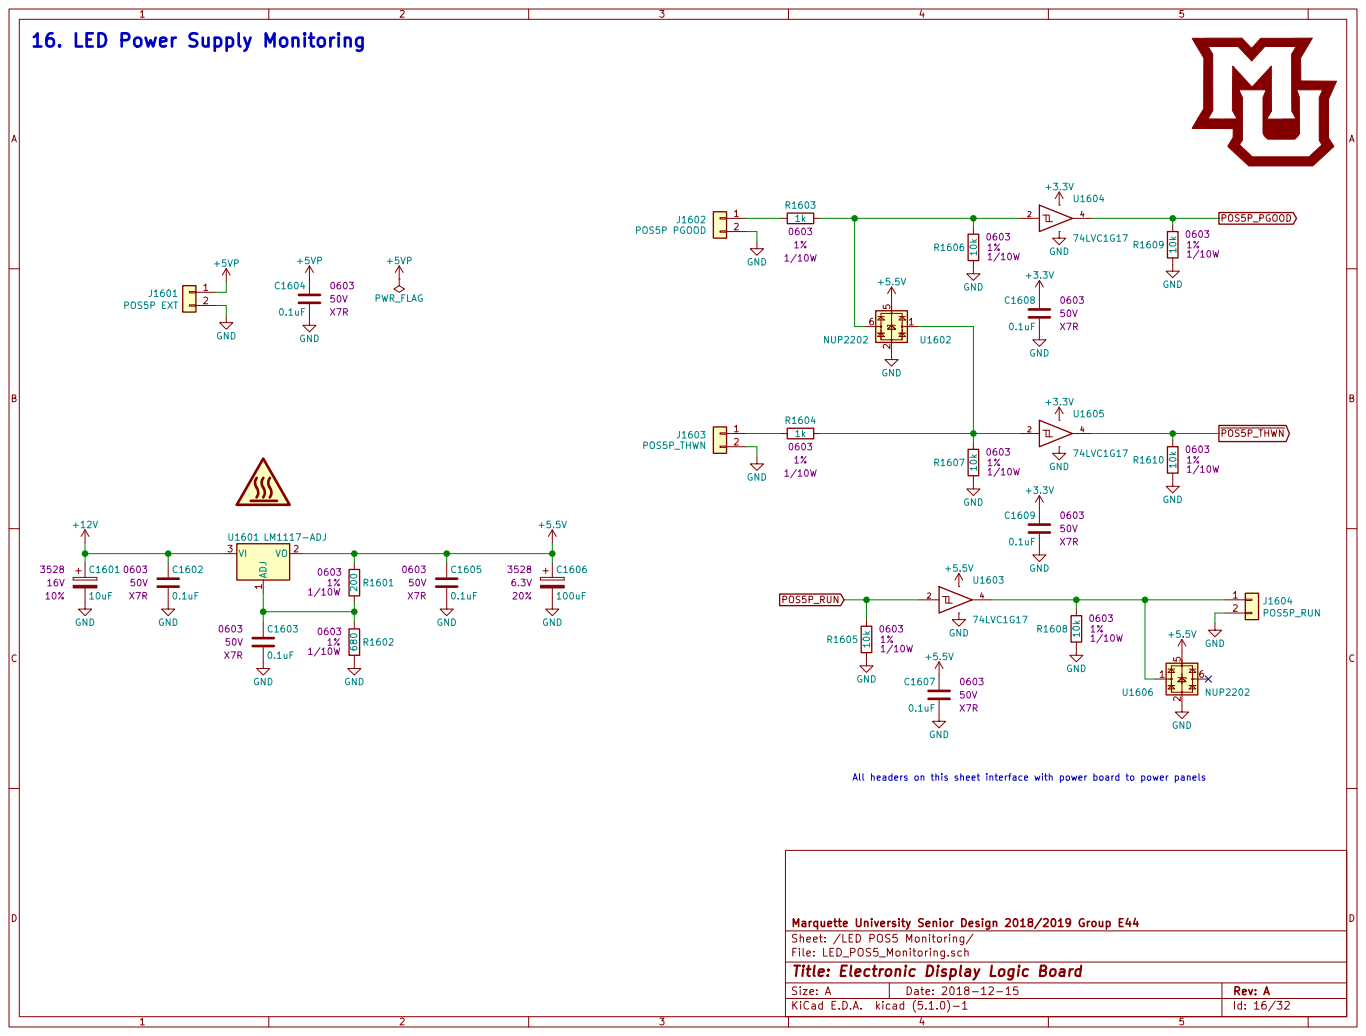
[picture p31: page 16]

16. LED Power Supply Monitoring

All headers on this sheet interface with power board to power panels

Marquette University Senior Design 2018/2019 Group E44
Sheet: /LED POS5 Monitoring/
File: LED_POS5_Monitoring.sch
Id: 16/32 Title: Electronic Display Logic Board

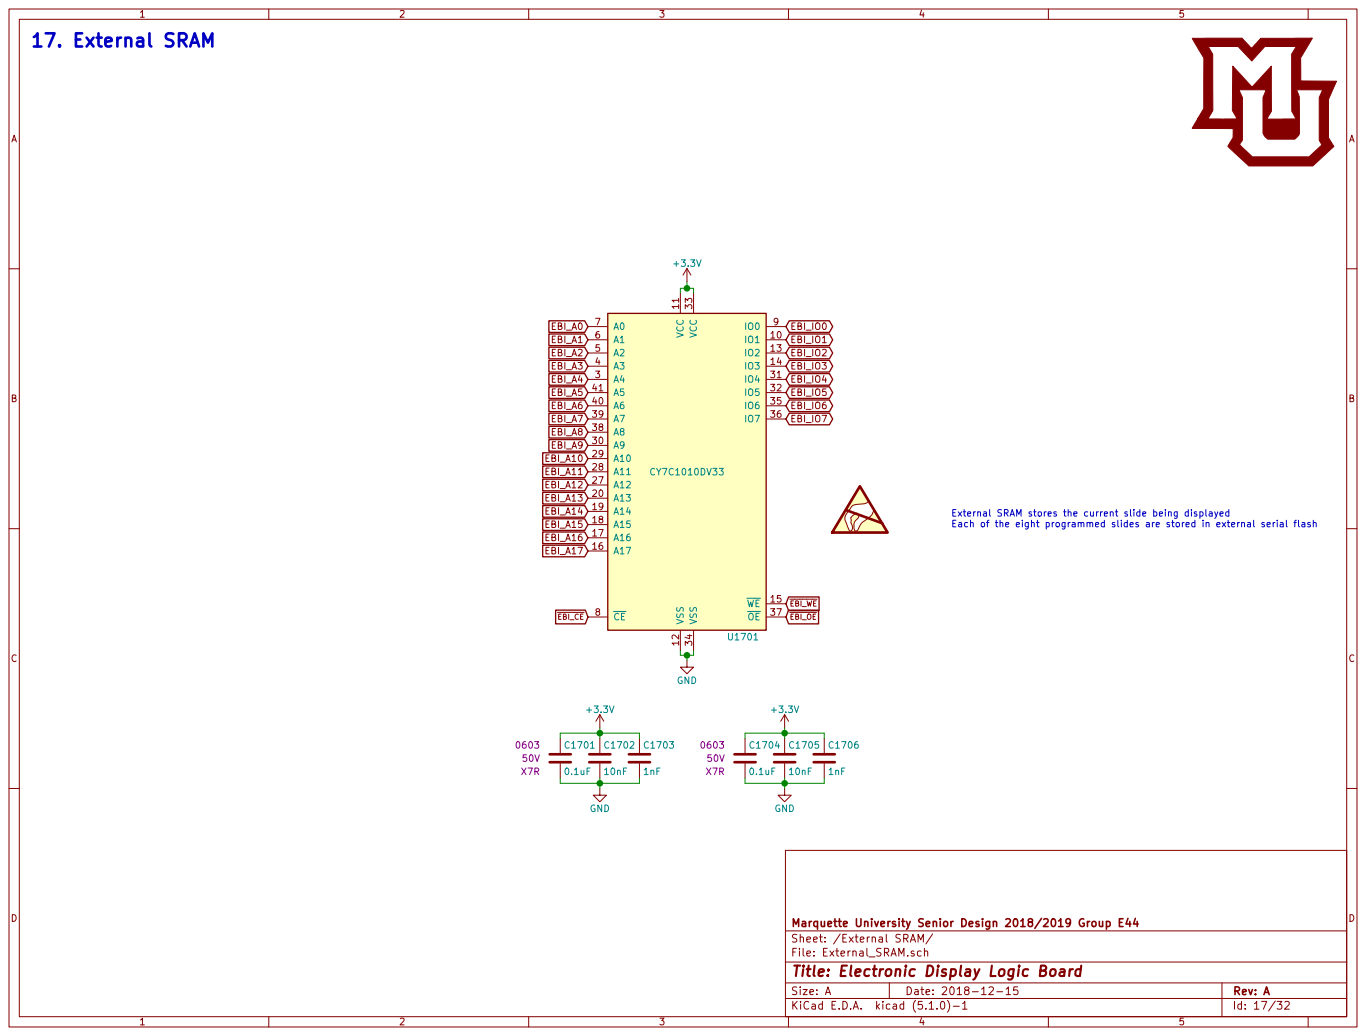
[picture p32: page 17]

External SRAM stores the current slide being displayed
Each of the eight programmed slides are stored in external serial flash

File: External_SRAM.sch Sheet: /External SRAM/ Marquette University Senior Design 2018/2019 Group E44 GND

Id: 17/32 Title: Electronic Display Logic Board

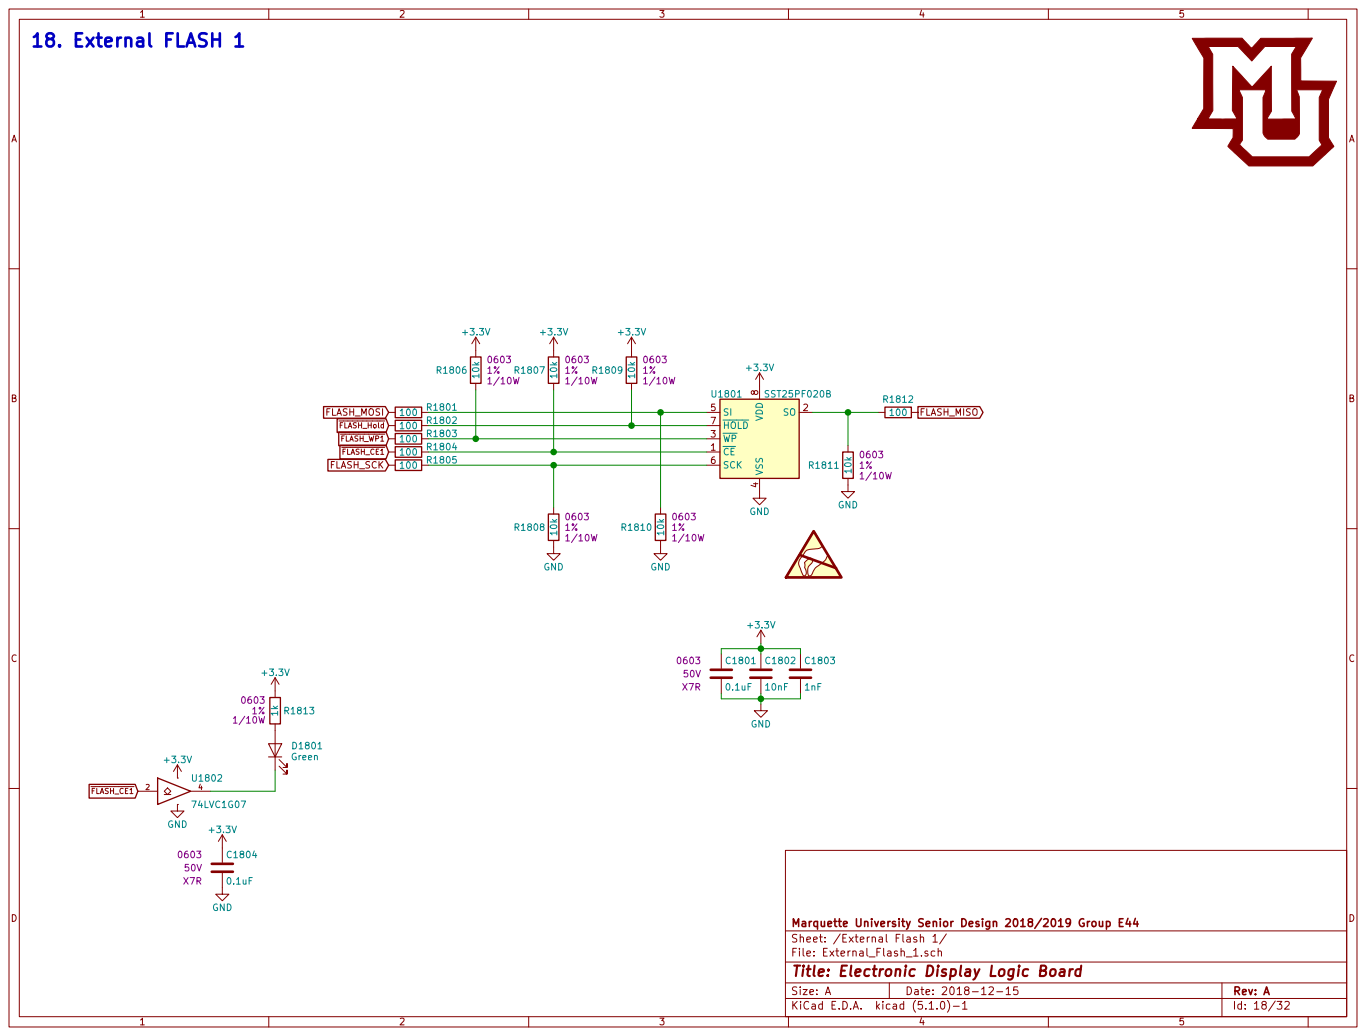
[picture p33: page 18]

4 SI 5 SCK 6 HOLD 7 VDD

File: External_Flash_1.sch Sheet: /External Flash 1/ Marquette University Senior Design 2018/2019 Group E44

Id: 18/32 Title: Electronic Display Logic Board

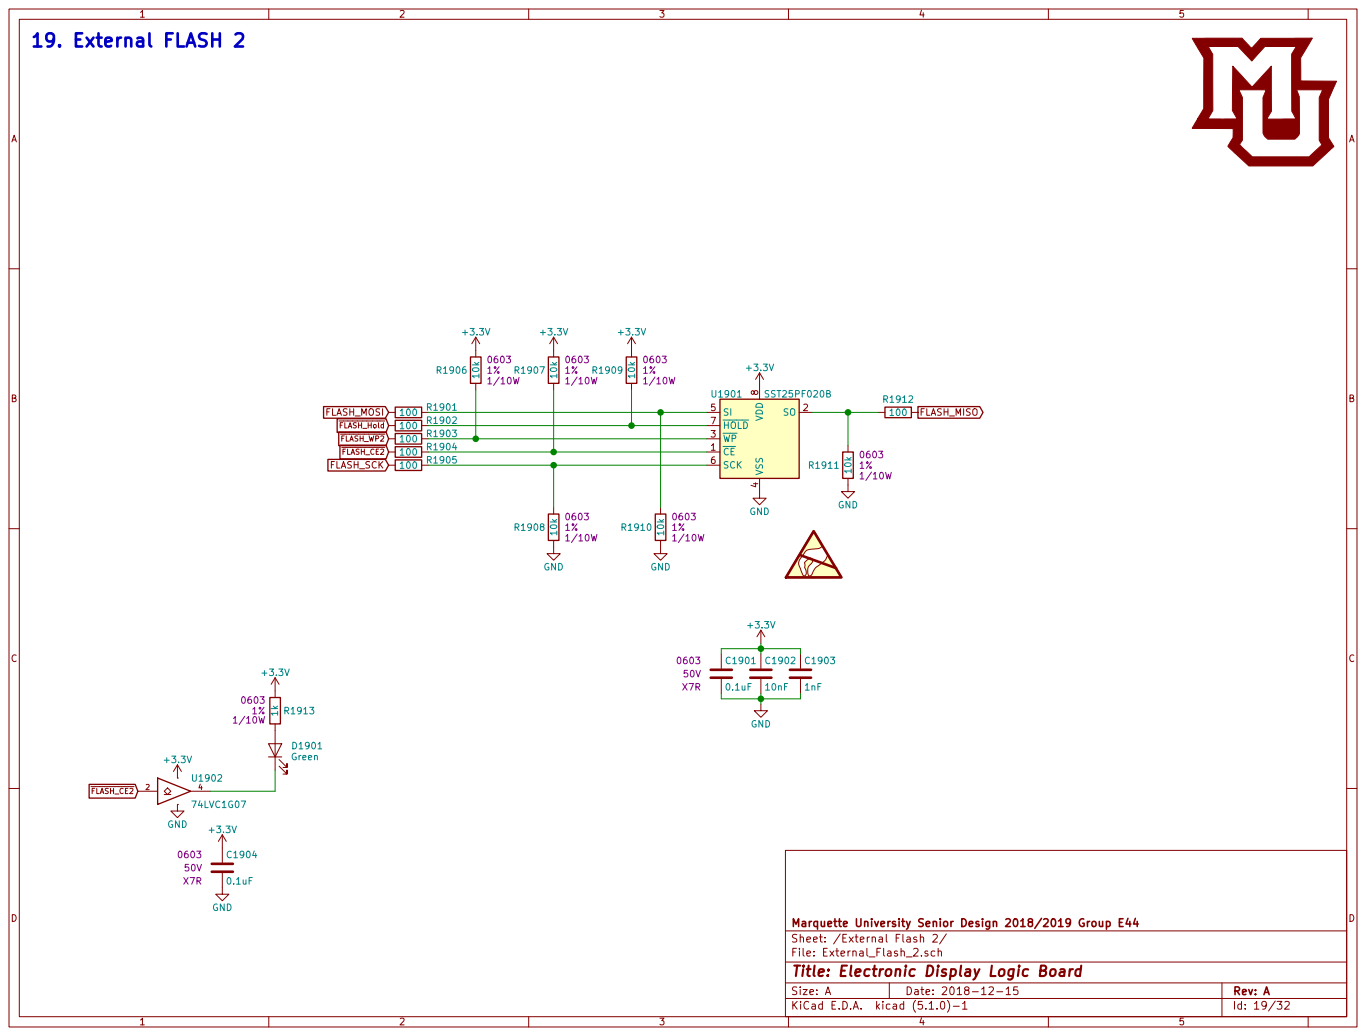
[picture p34: page 19]

4 SI 5 SCK 6 HOLD 7 VDD

File: External_Flash_2.sch Sheet: /External Flash 2/ Marquette University Senior Design 2018/2019 Group E44

Id: 19/32 Title: Electronic Display Logic Board

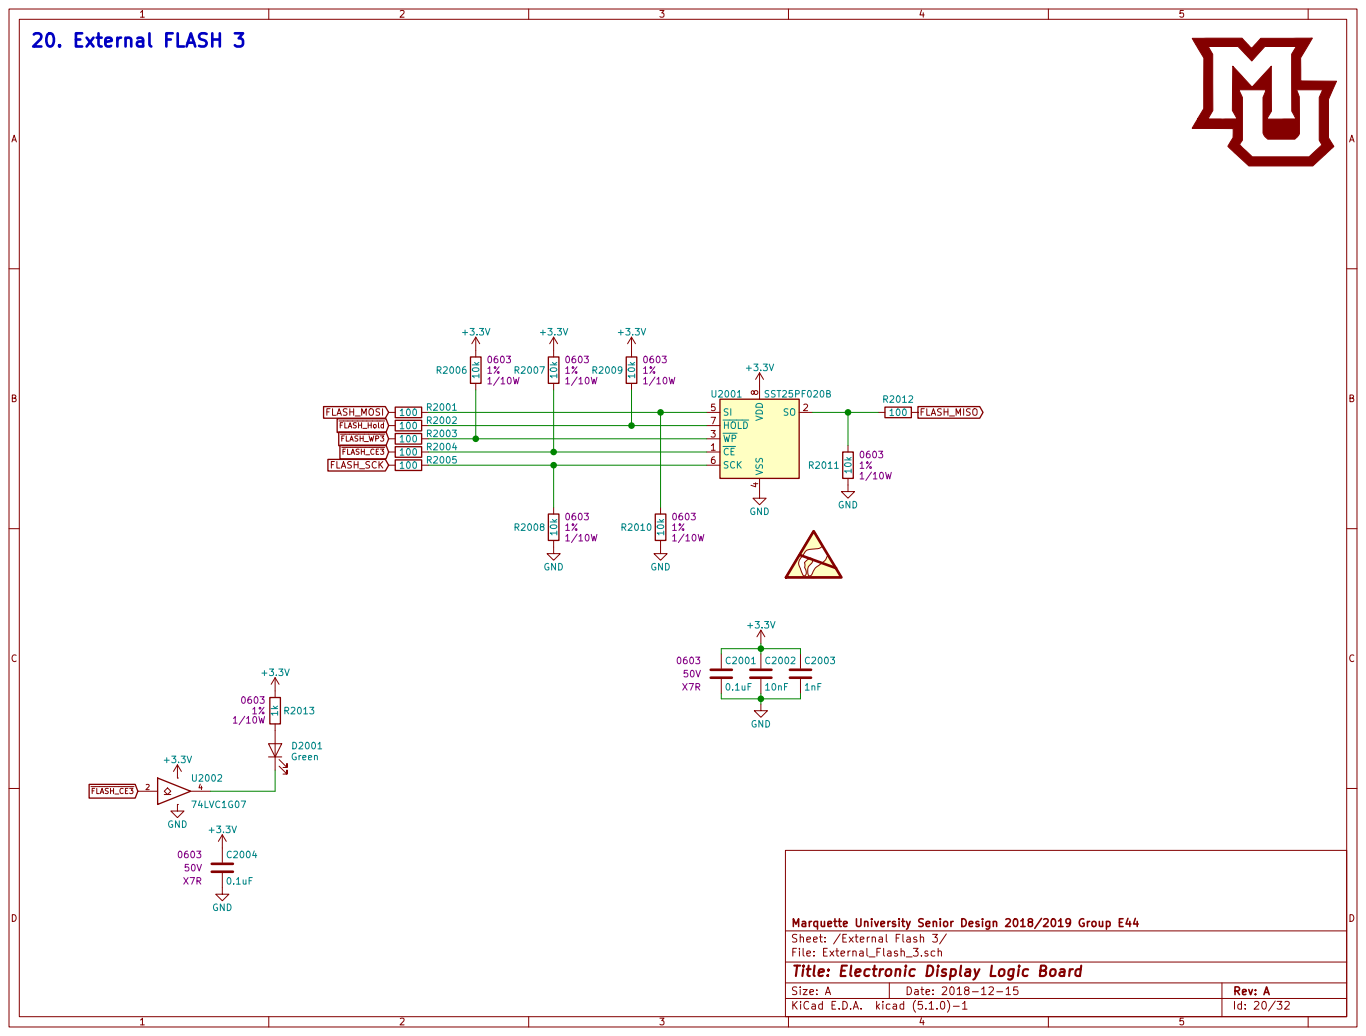
[picture p35: page 20]

4 SI 5 SCK 6 HOLD 7 VDD

File: External_Flash_3.sch Sheet: /External Flash 3/ Marquette University Senior Design 2018/2019 Group E44

Id: 20/32 Title: Electronic Display Logic Board

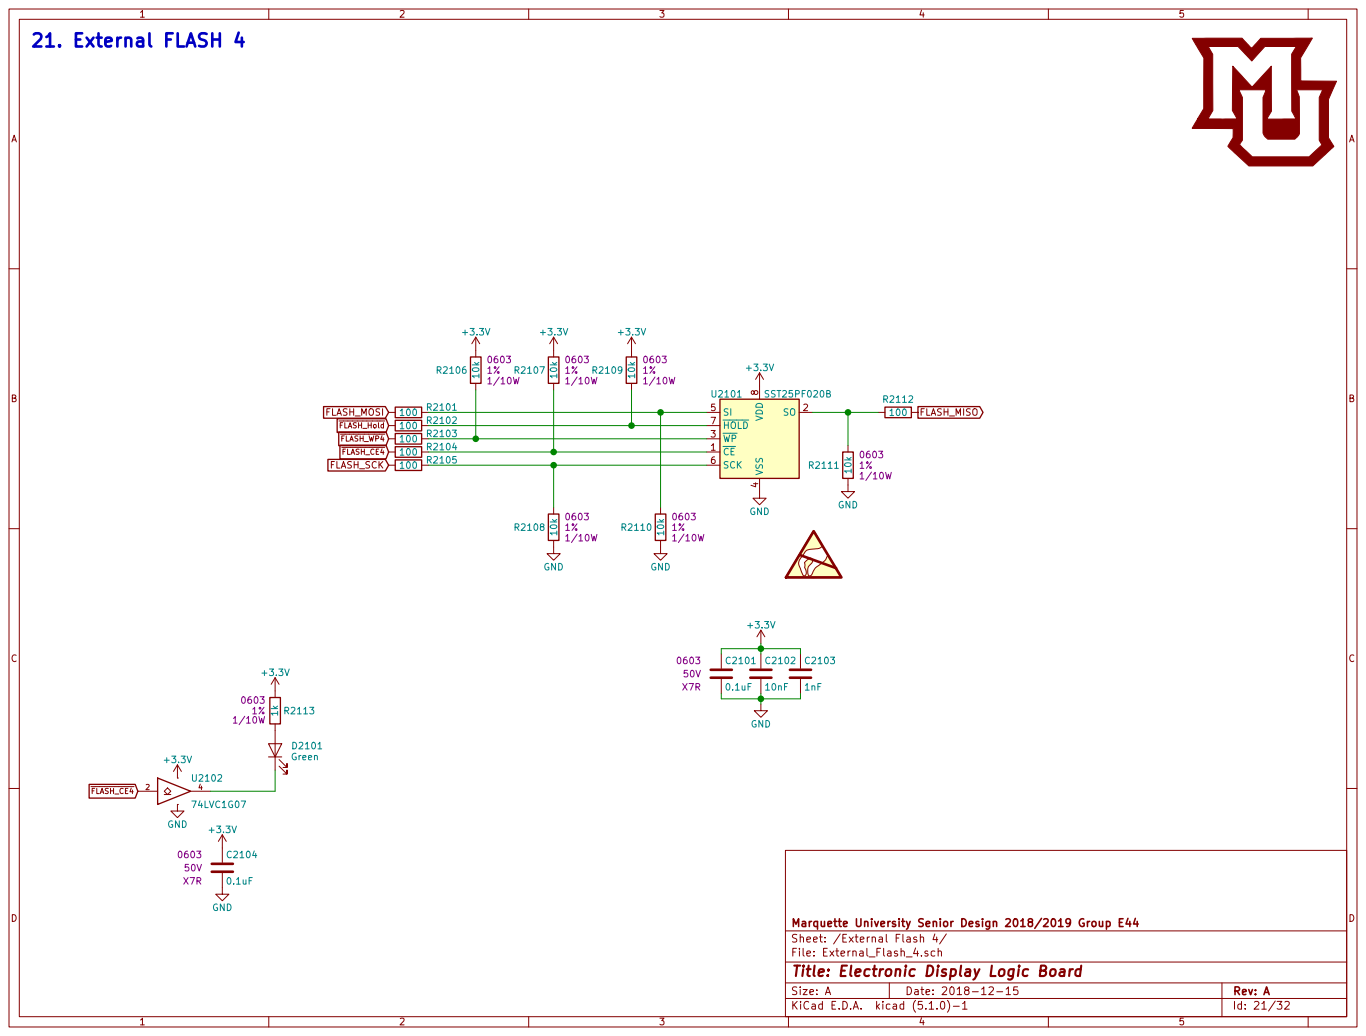
[picture p36: page 21]

4 SI 5 SCK 6 HOLD 7 VDD

File: External_Flash_4.sch Sheet: /External Flash 4/ Marquette University Senior Design 2018/2019 Group E44

Id: 21/32 Title: Electronic Display Logic Board

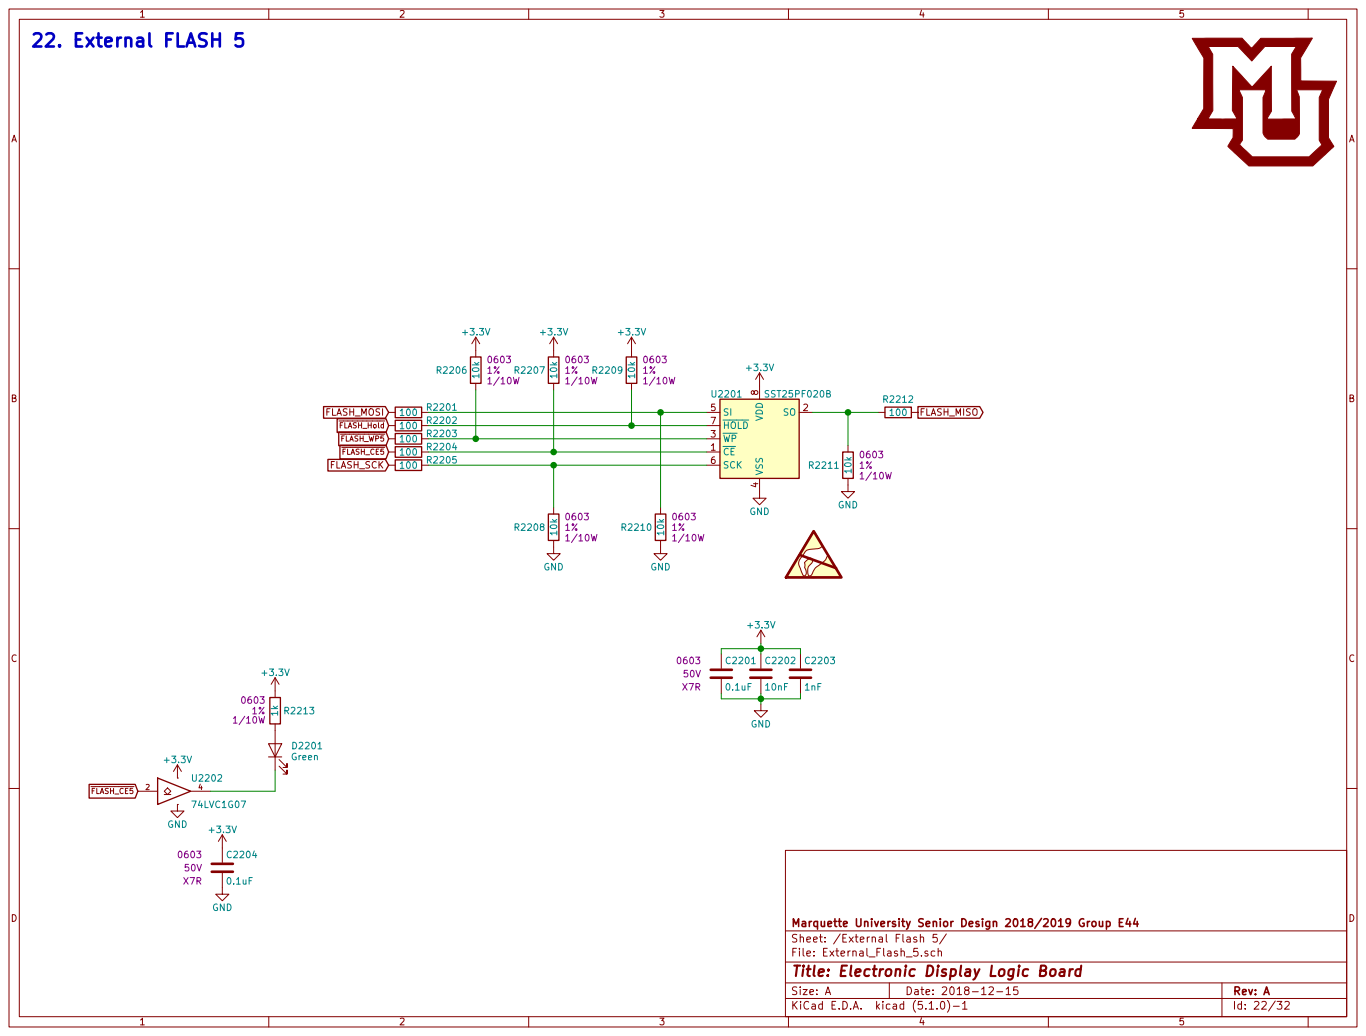
[picture p37: page 22]

4 SI 5 SCK 6 HOLD 7 VDD

File: External_Flash_5.sch Sheet: /External Flash 5/ Marquette University Senior Design 2018/2019 Group E44

Id: 22/32 Title: Electronic Display Logic Board

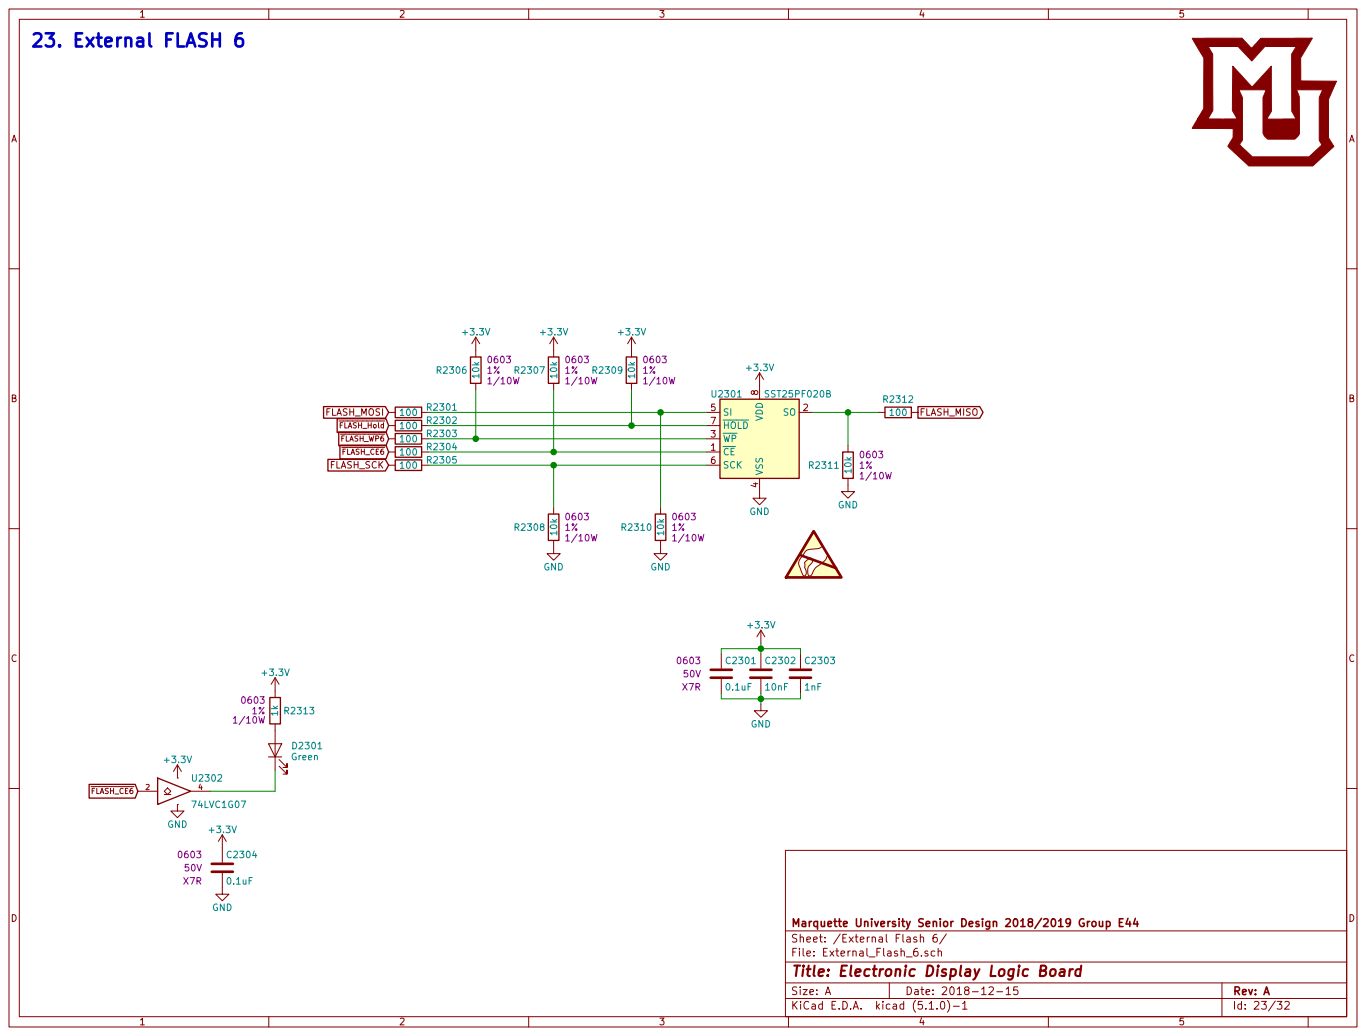
[picture p38: page 23]

4 SI 5 SCK 6 HOLD 7 VDD

File: External_Flash_6.sch Sheet: /External Flash 6/ Marquette University Senior Design 2018/2019 Group E44

Id: 23/32 Title: Electronic Display Logic Board

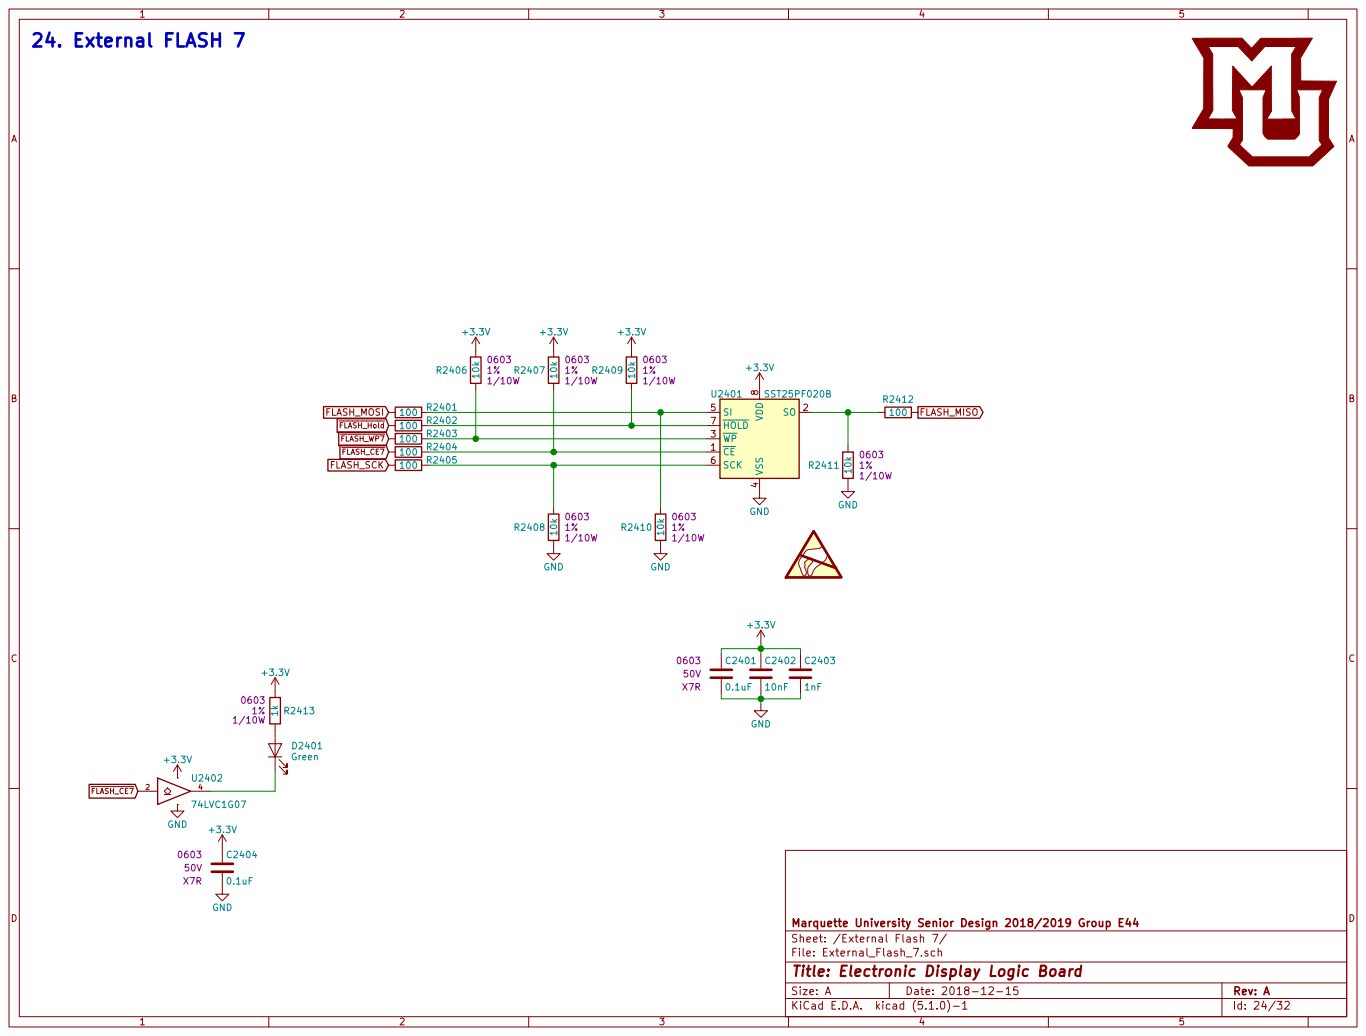
[picture p39: page 24]

4 SI 5 SCK 6 HOLD 7 VDD

File: External_Flash_7.sch Sheet: /External Flash 7/ Marquette University Senior Design 2018/2019 Group E44

Id: 24/32 Title: Electronic Display Logic Board

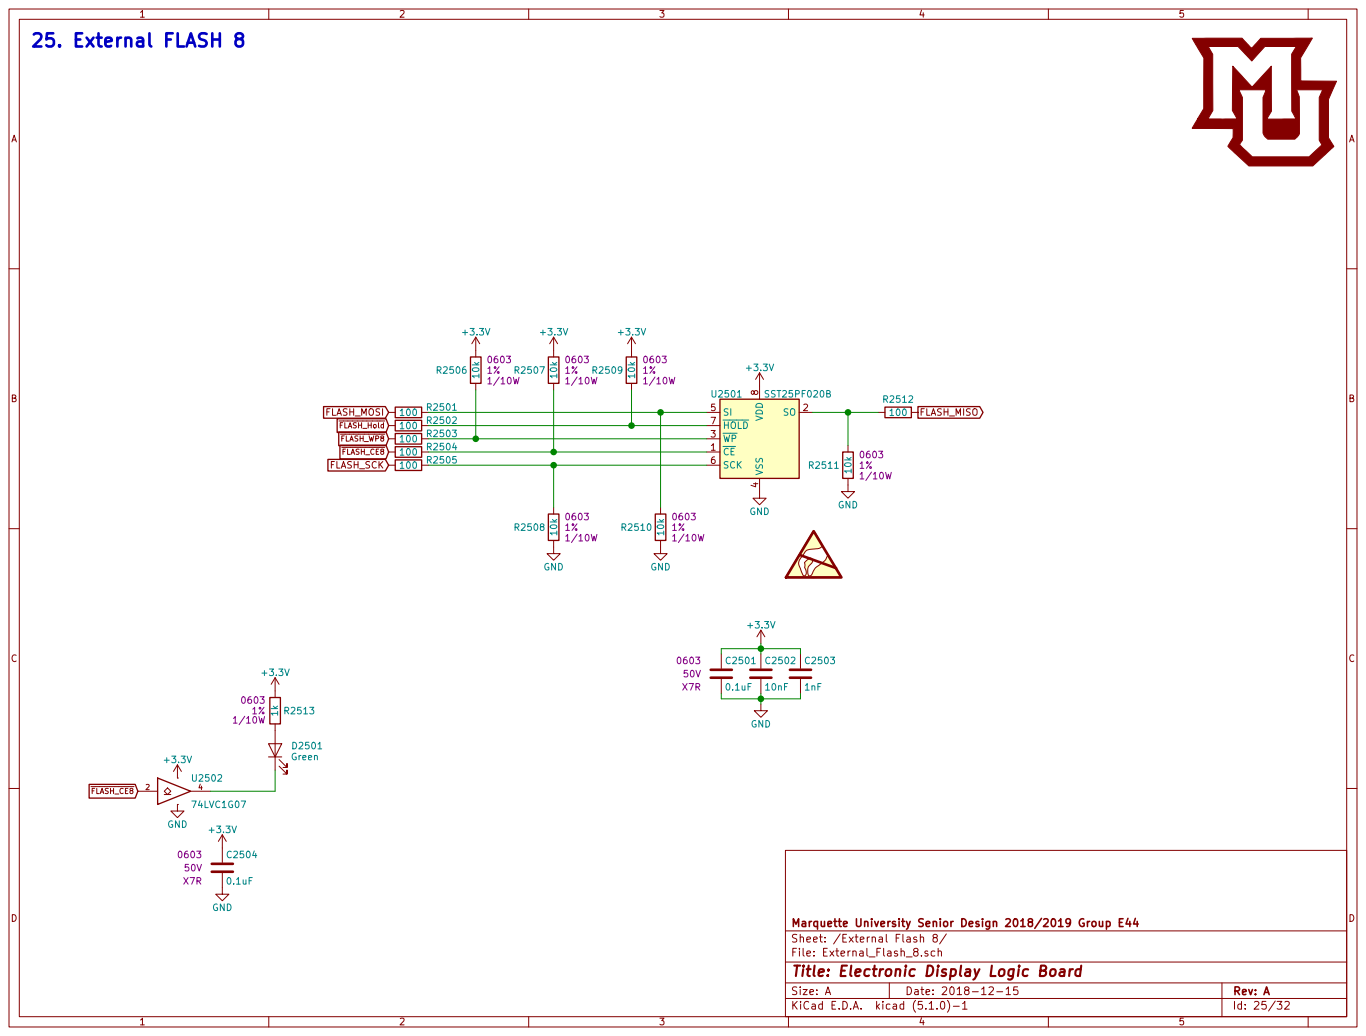
[picture p40: page 25]

4 SI 5 SCK 6 HOLD 7 VDD

File: External_Flash_8.sch Sheet: /External Flash 8/ Marquette University Senior Design 2018/2019 Group E44

Id: 25/32 Title: Electronic Display Logic Board

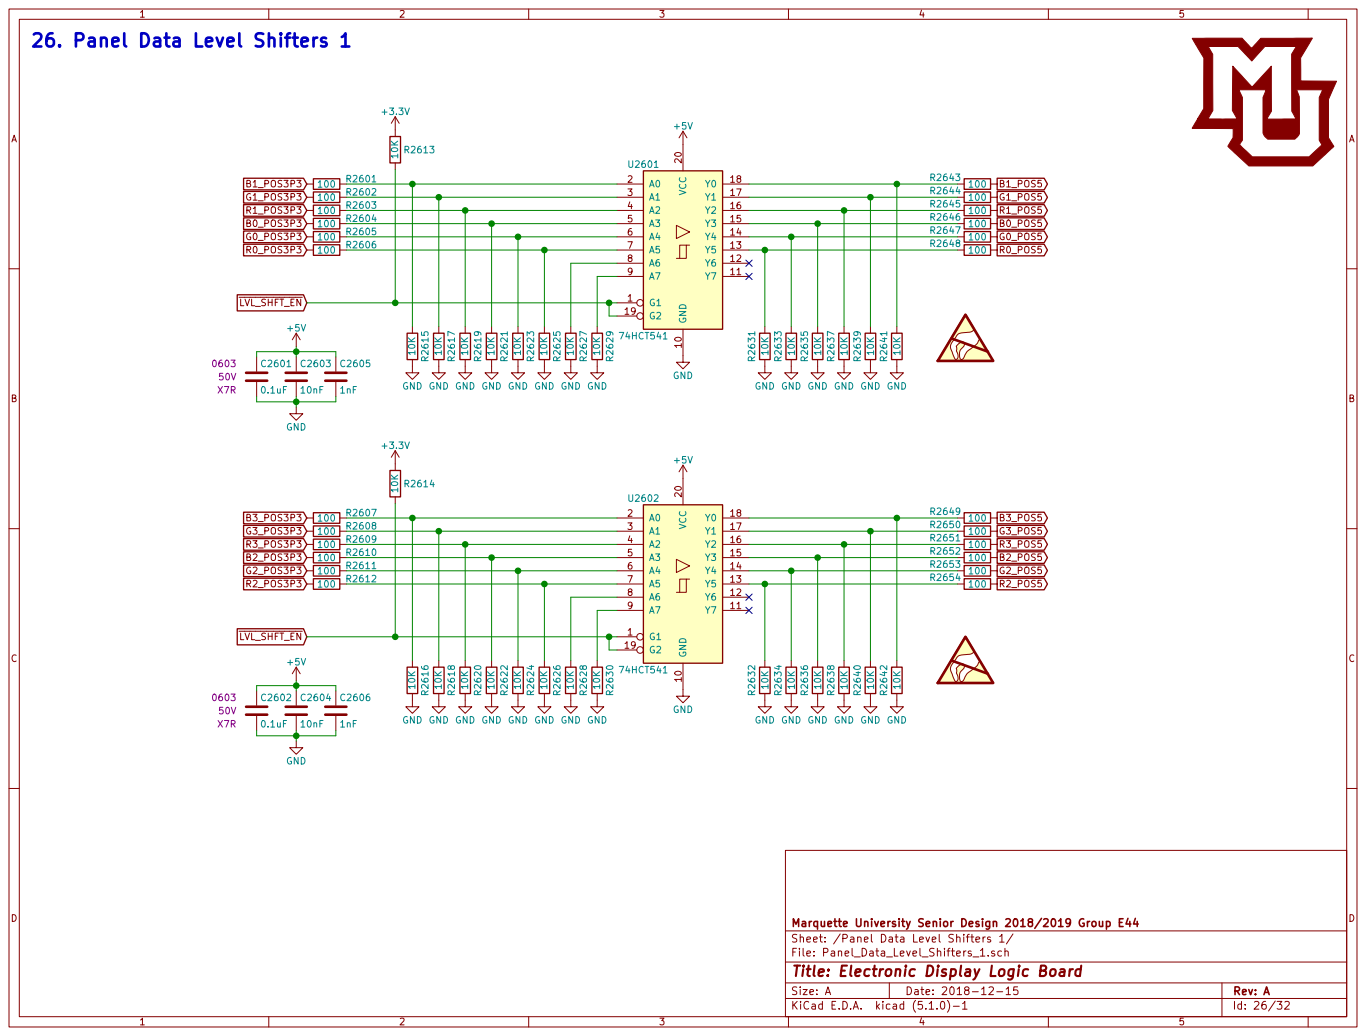
[picture p41: page 26]

+5V 26. Panel Data Level Shifters 1

100 R2625 10K R2623 10K R2621 10K R2619 10K R2617 10K R2615 10K GND GND GND GND GND GND

100 R2626 10K R2624 10K R2622 10K R2620 10K R2618 10K R2616 10K GND GND GND GND GND GND

File: Panel_Data_Level_Shifters_1.sch Sheet: /Panel Data Level Shifters 1/ Marquette University Senior Design 2018/2019 Group E44

Id: 26/32 Title: Electronic Display Logic Board

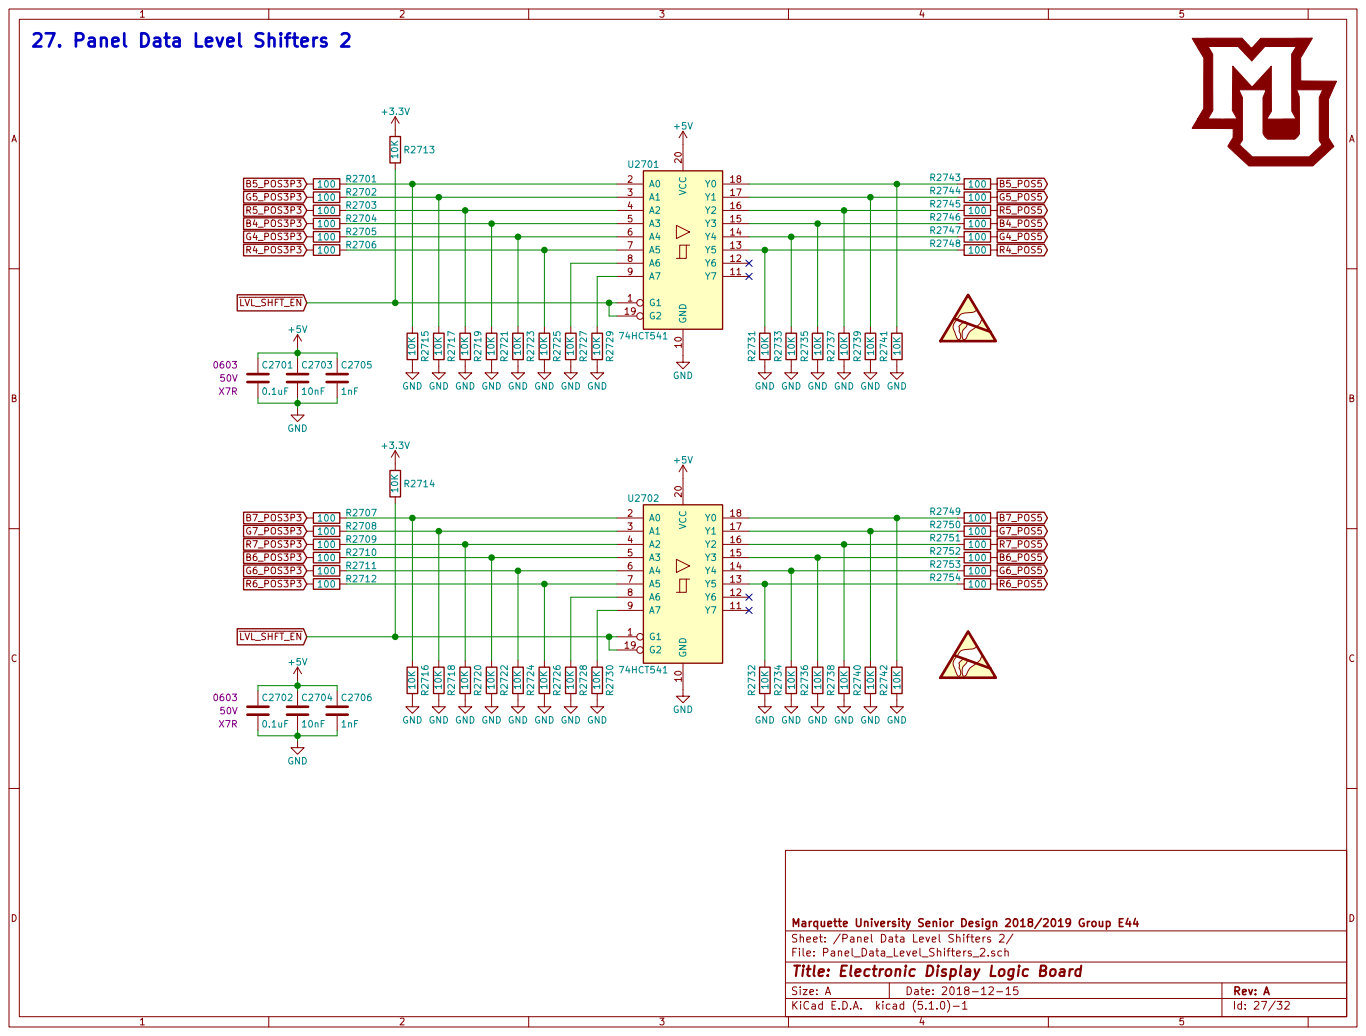
[picture p42: page 27]

+5V 27. Panel Data Level Shifters 2

100 R2725 10K R2723 10K R2721 10K R2719 10K R2717 10K R2715 10K GND GND GND GND GND GND

100 R2726 10K R2724 10K R2722 10K R2720 10K R2718 10K R2716 10K GND GND GND GND GND GND

File: Panel_Data_Level_Shifters_2.sch Sheet: /Panel Data Level Shifters 2/ Marquette University Senior Design 2018/2019 Group E44

Id: 27/32 Title: Electronic Display Logic Board

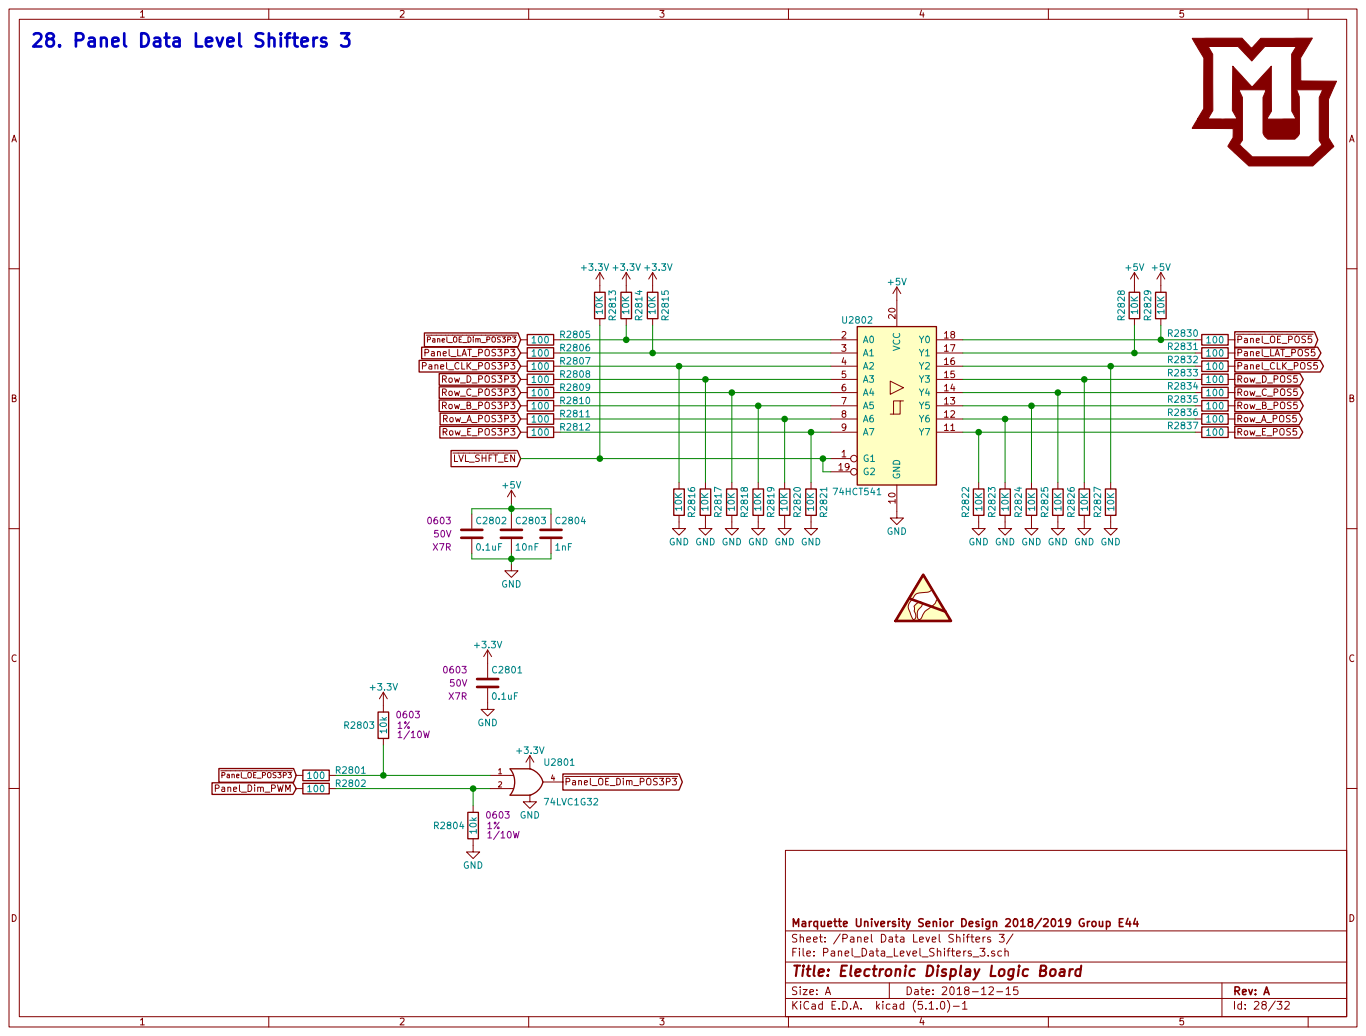
[picture p43: page 28]

+3.3V 28. Panel Data Level Shifters 3

Id: 28/32 Title: Electronic Display Logic Board

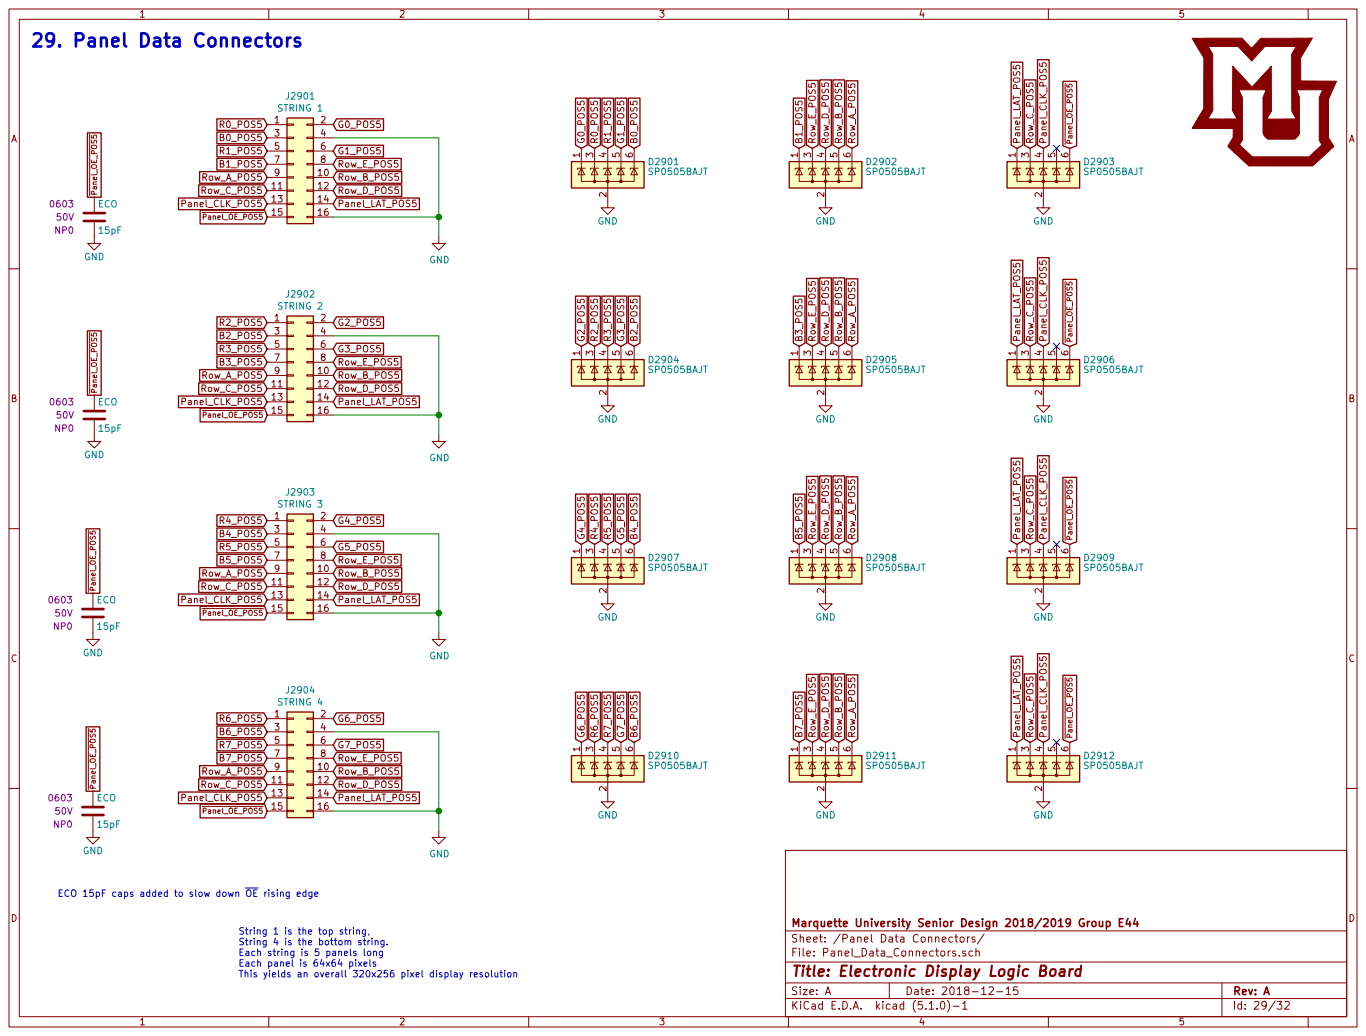
[picture p44: page 29]

File: Panel_Data_Connectors.sch Sheet: /Panel Data Connectors/ Marquette University Senior Design 2018/2019 Group E44 1

ECO 15pF caps added to slow down OE rising edge

String 1 is the top string,
String 4 is the bottom string.
Each string is 5 panels long
Each panel is 64x64 pixels
This yields an overall 320x256 pixel display resolution

Id: 29/32 Title: Electronic Display Logic Board

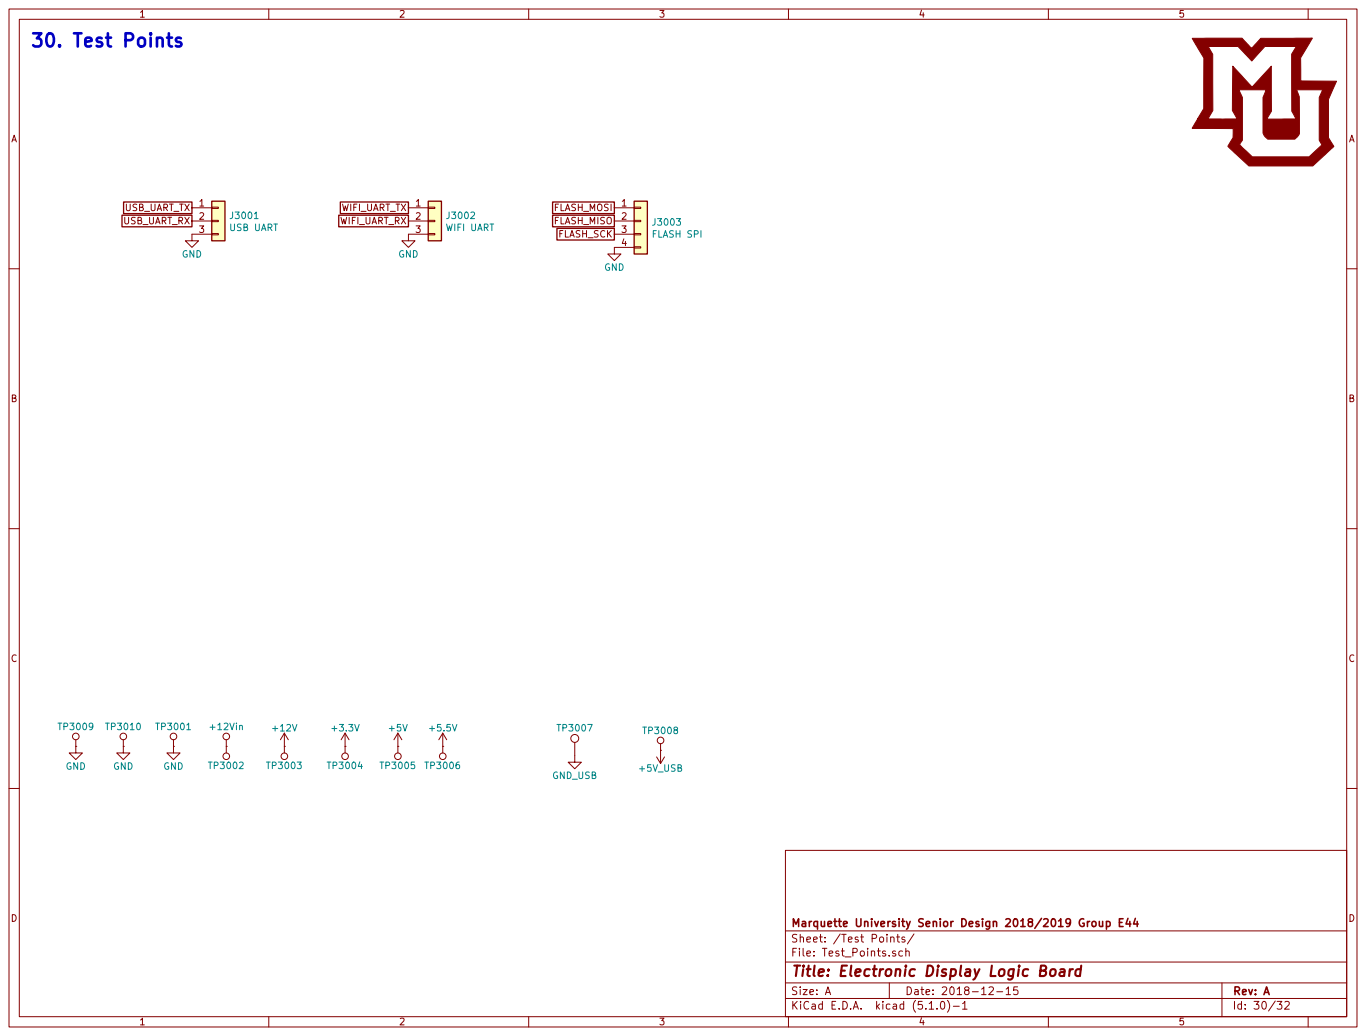
[picture p45: page 30]

File: Test_Points.sch Sheet: /Test Points/ Marquette University Senior Design 2018/2019 Group E44

Id: 30/32 Title: Electronic Display Logic Board

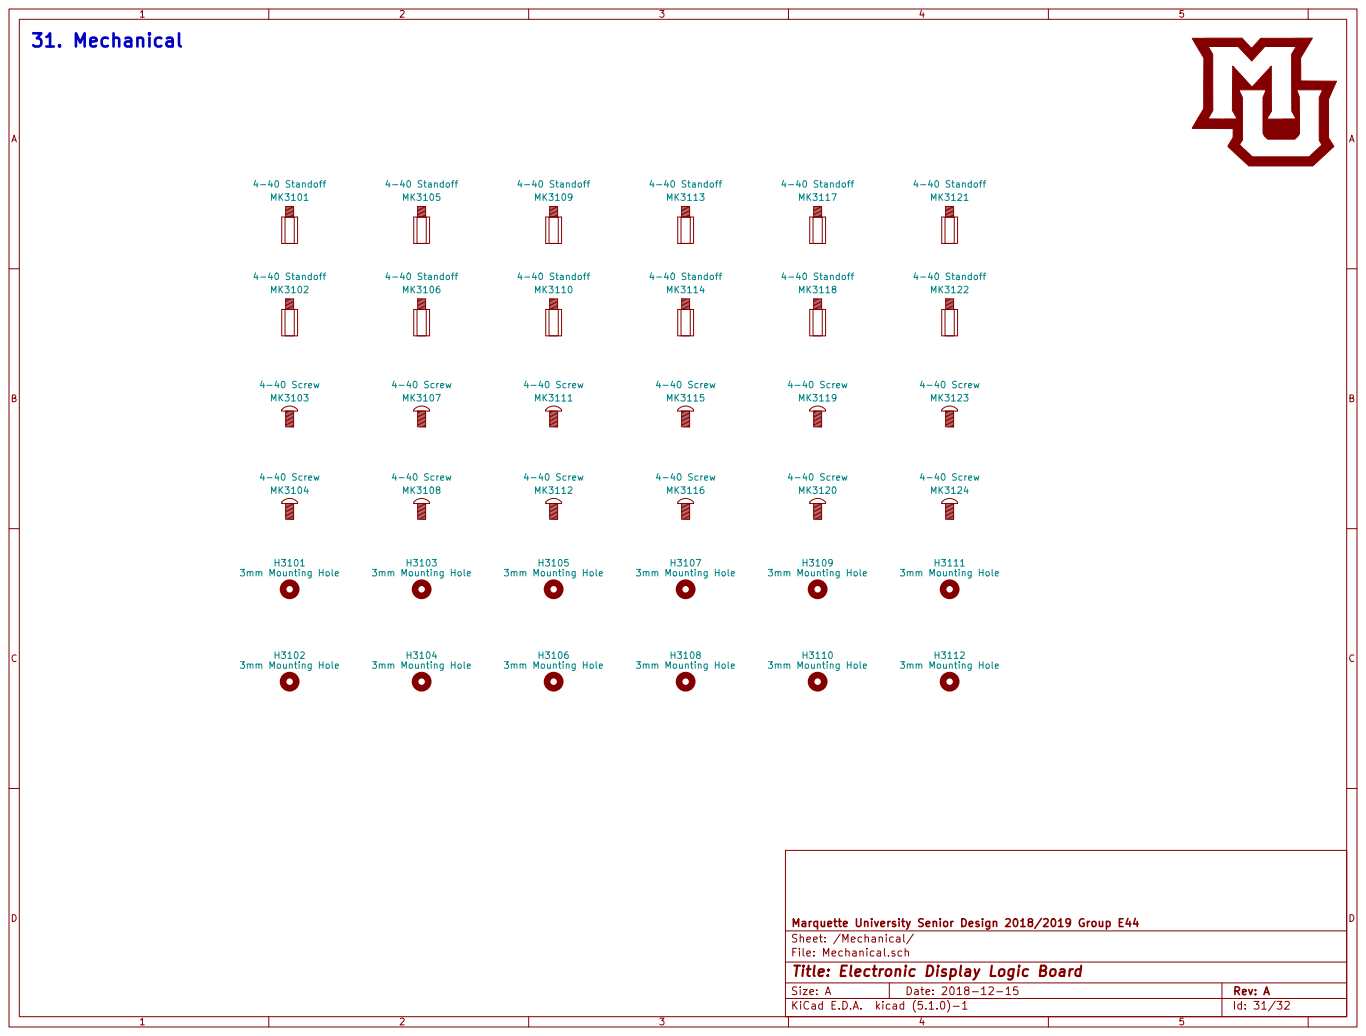
[picture p46: page 31]

File: Mechanical.sch Sheet: /Mechanical/ Marquette University Senior Design 2018/2019 Group E44

Id: 31/32 Title: Electronic Display Logic Board

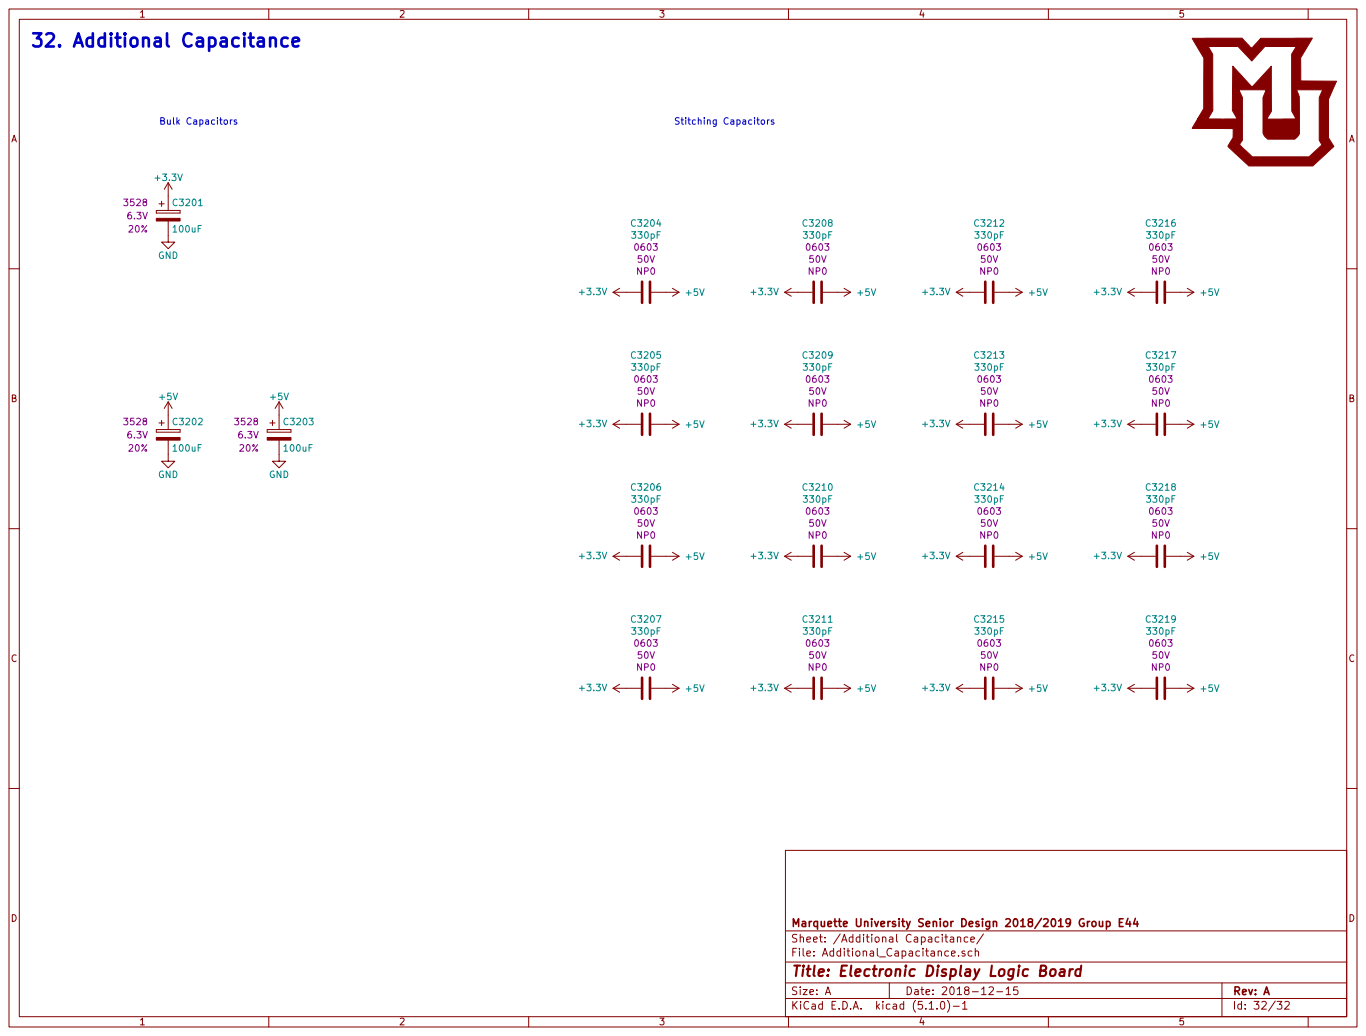
[picture p47: page 32]

Marquette University Senior Design 2018/2019 Group E44
Sheet: /Additional Capacitance/
File: Additional_Capacitance.sch
Id: 32/32 Title: Electronic Display Logic Board
