drewsum/Electronic_Display/hdw/Power_Board/LTC7851_Demo/LTC7851_Demo.pdf

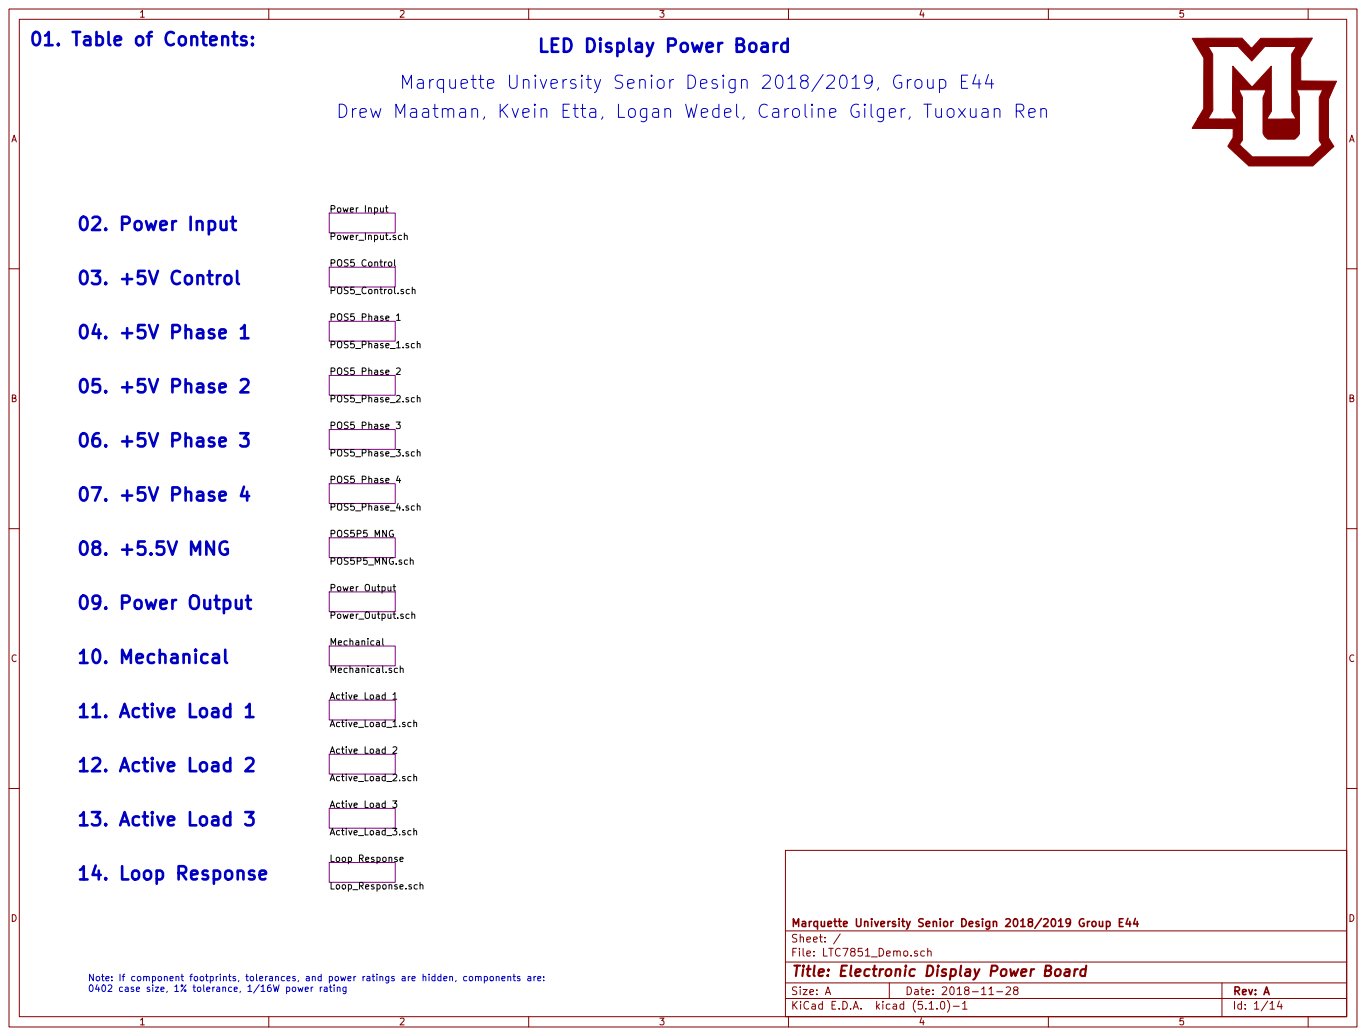
[picture p48: page 1]

Marquette University Senior Design 2018/2019, Group E44

Drew Maatman, Kvein Etta, Logan Wedel, Caroline Gilger, Tuoxuan Ren
Power_Input.sch POS5 Control POS5_Control.sch POS5 Phase 1 POS5_Phase_1.sch POS5 Phase 2 POS5_Phase_2.sch POS5 Phase 3 POS5_Phase_3.sch POS5 Phase 4 POS5_Phase_4.sch POS5P5 MNG

POS5P5_MNG.sch Power Output
Power_Output.sch Mechanical Mechanical.sch Active Load 1 Active_Load_1.sch Active Load 2 Active_Load_2.sch Active Load 3 Active_Load_3.sch

File: LTC7851_Demo.sch Sheet: / Marquette University Senior Design 2018/2019 Group E44

Note: If component footprints, tolerances, and power ratings are hidden, components are:
0402 case size, 1% tolerance, 1/16W power rating

Id: 1/14 Title: Electronic Display Power Board

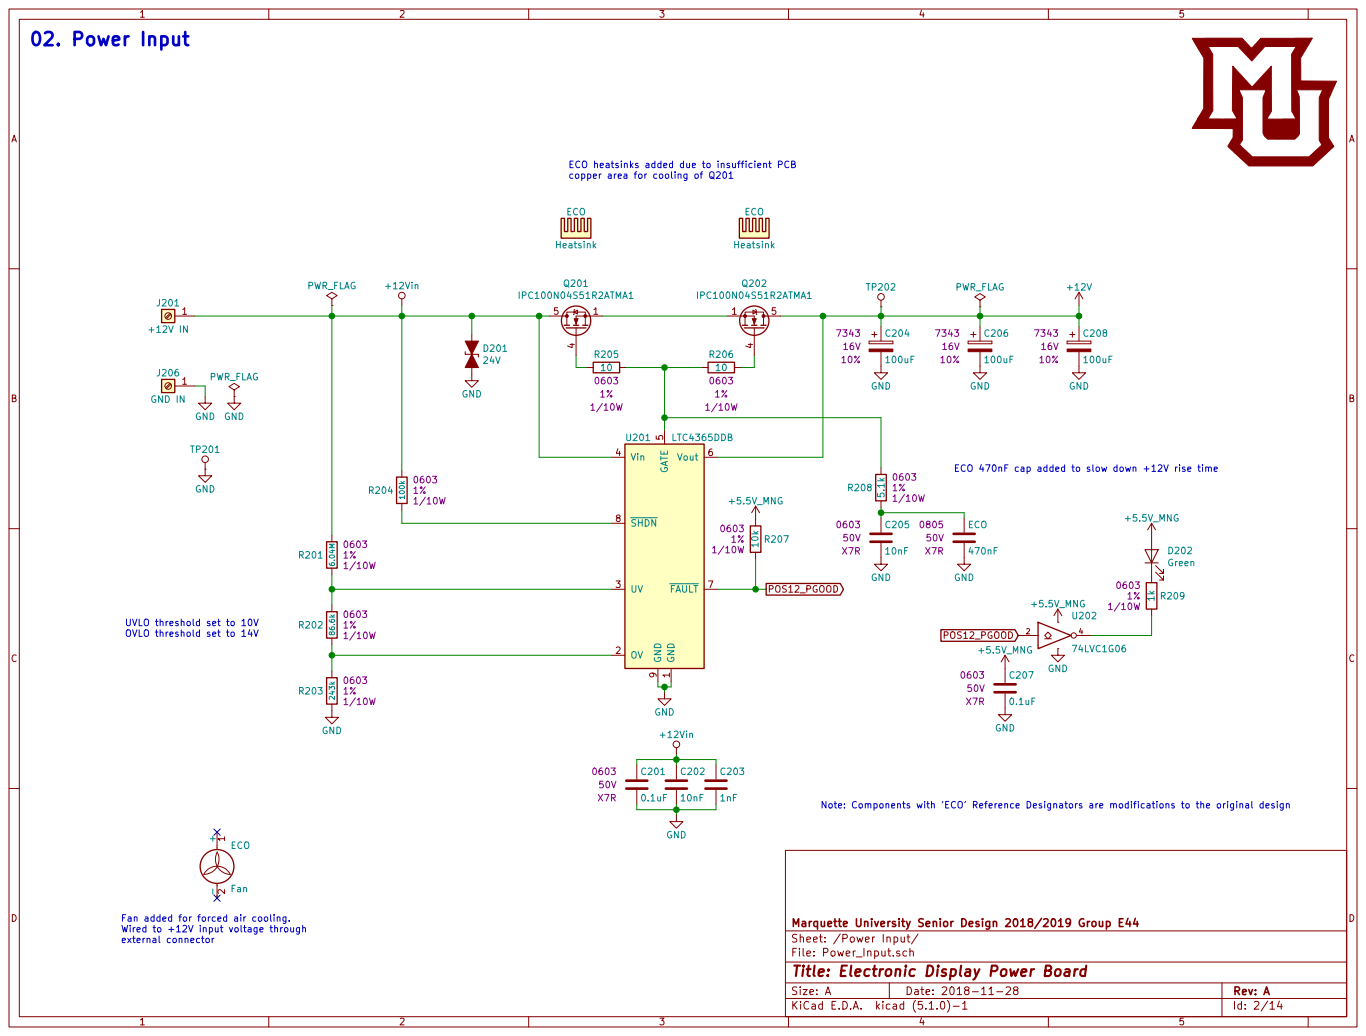
[picture p49: page 2]

Heatsink ECO heatsinks added due to insufficient PCB
copper area for cooling of Q201

TP201 GND
ECO 470nF cap added to slow down +12V rise time +

5 Vout 6 FAULT 7 SHDN 8 GND

1 OV 2 UV 3 Vin 4 GATE

Marquette University Senior Design 2018/2019 Group E44 GND

Fan Fan added for forced air cooling.

Sheet: /Power Input/
File: Power_Input.sch
Id: 2/14 Title: Electronic Display Power Board

Wired to +12V input voltage through

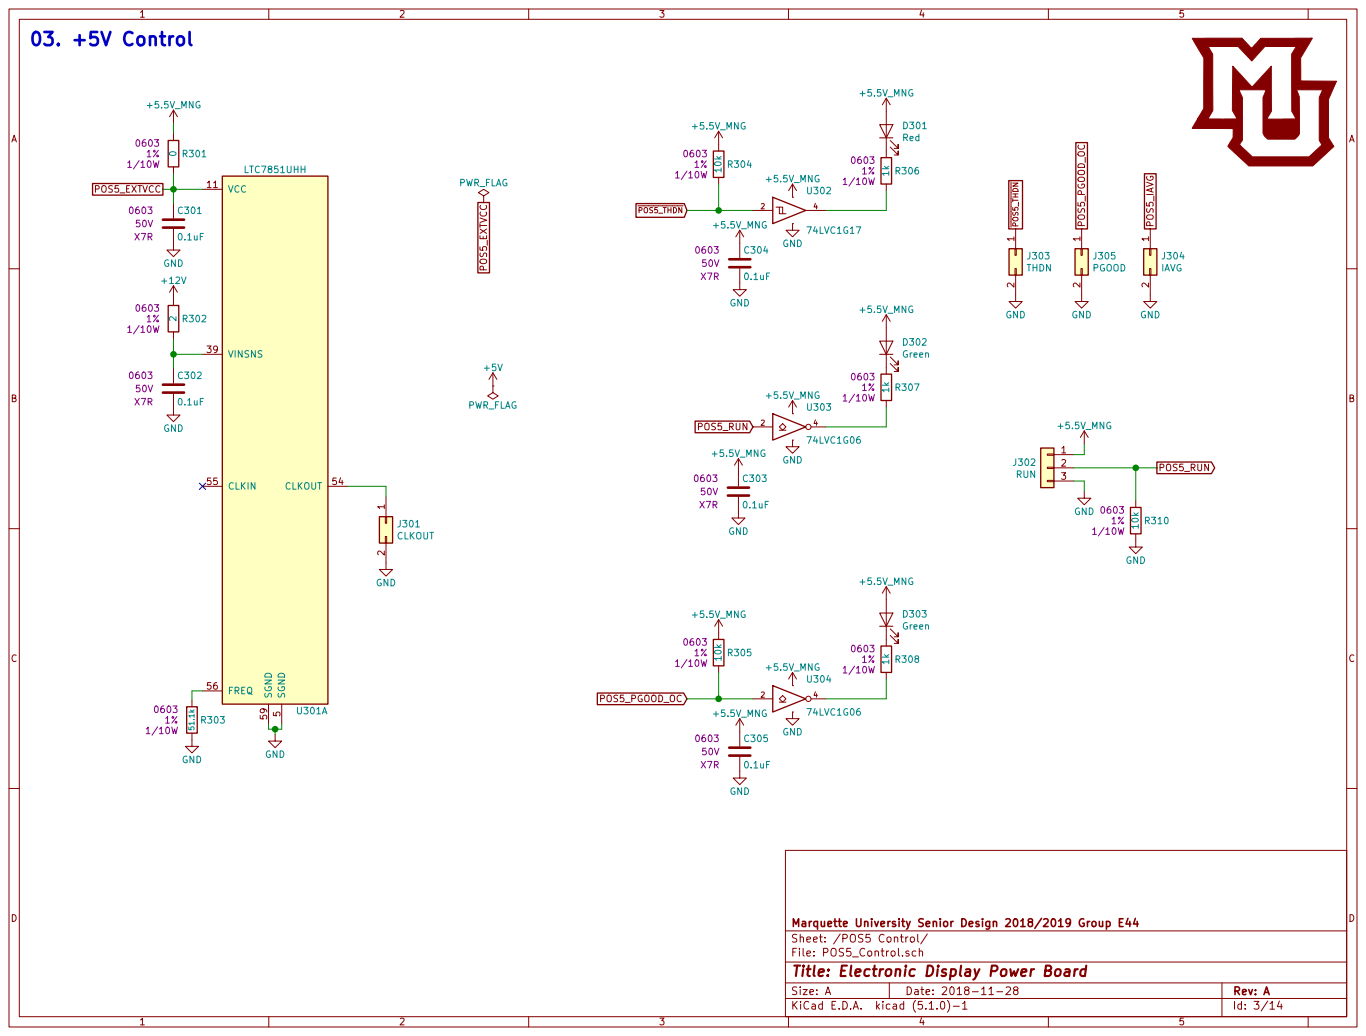
[picture p50: page 3]

5 CLKOUT 54 CLKIN 55 FREQ 56 SGND 59U301A

File: POS5_Control.sch Sheet: /POS5 Control/ Marquette University Senior Design 2018/2019 Group E44

Id: 3/14 Title: Electronic Display Power Board

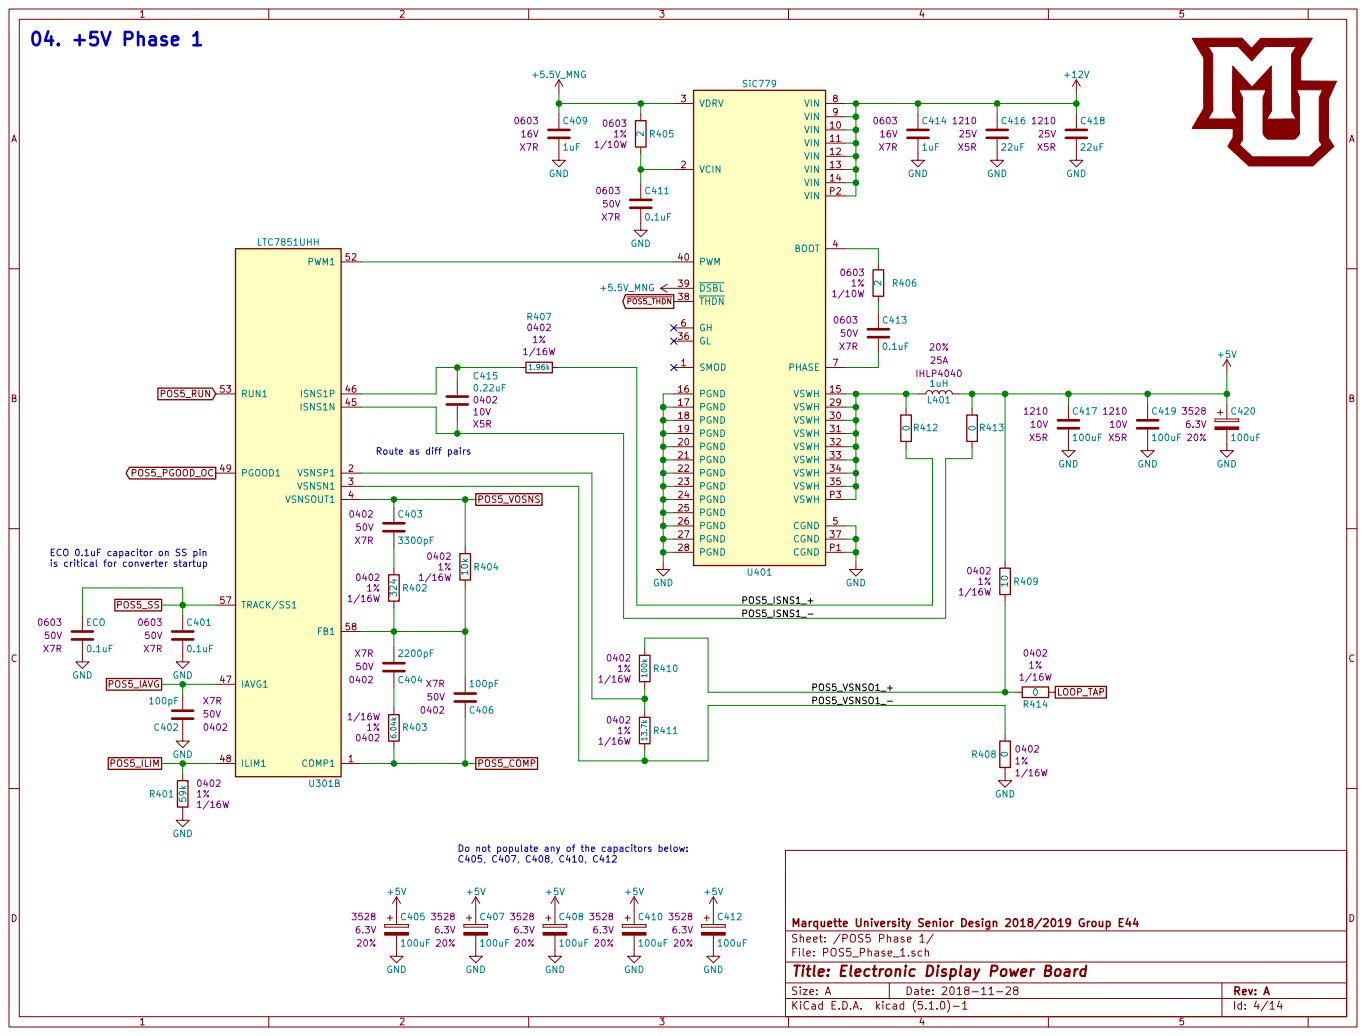
[picture p51: page 4]

POS5_ISNS1_+ POS5_ISNS1_- POS5_VSNSO1_- Route as diff pairs

Do not populate any of the capacitors below: C405, C407, C408, C410, C412 ECO 0.1uF capacitor on SS pin
is critical for converter startup

File: POS5_Phase_1.sch Sheet: /POS5 Phase 1/ Marquette University Senior Design 2018/2019 Group E44

Id: 4/14 Title: Electronic Display Power Board

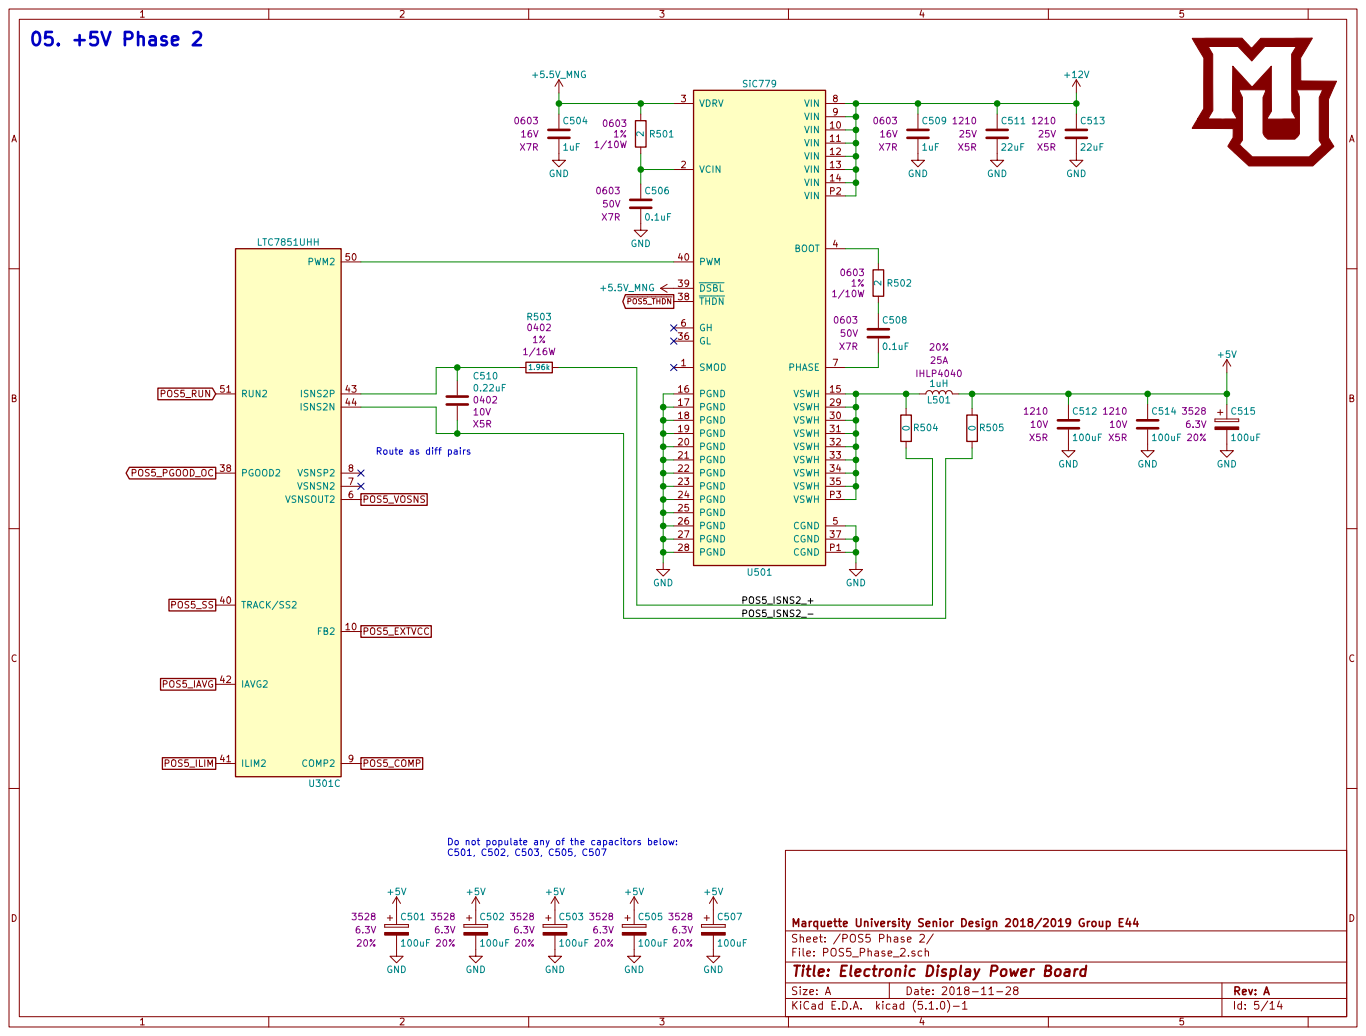
[picture p52: page 5]

File: POS5_Phase_2.sch Sheet: /POS5 Phase 2/ Marquette University Senior Design 2018/2019 Group E44

Id: 5/14 Title: Electronic Display Power Board

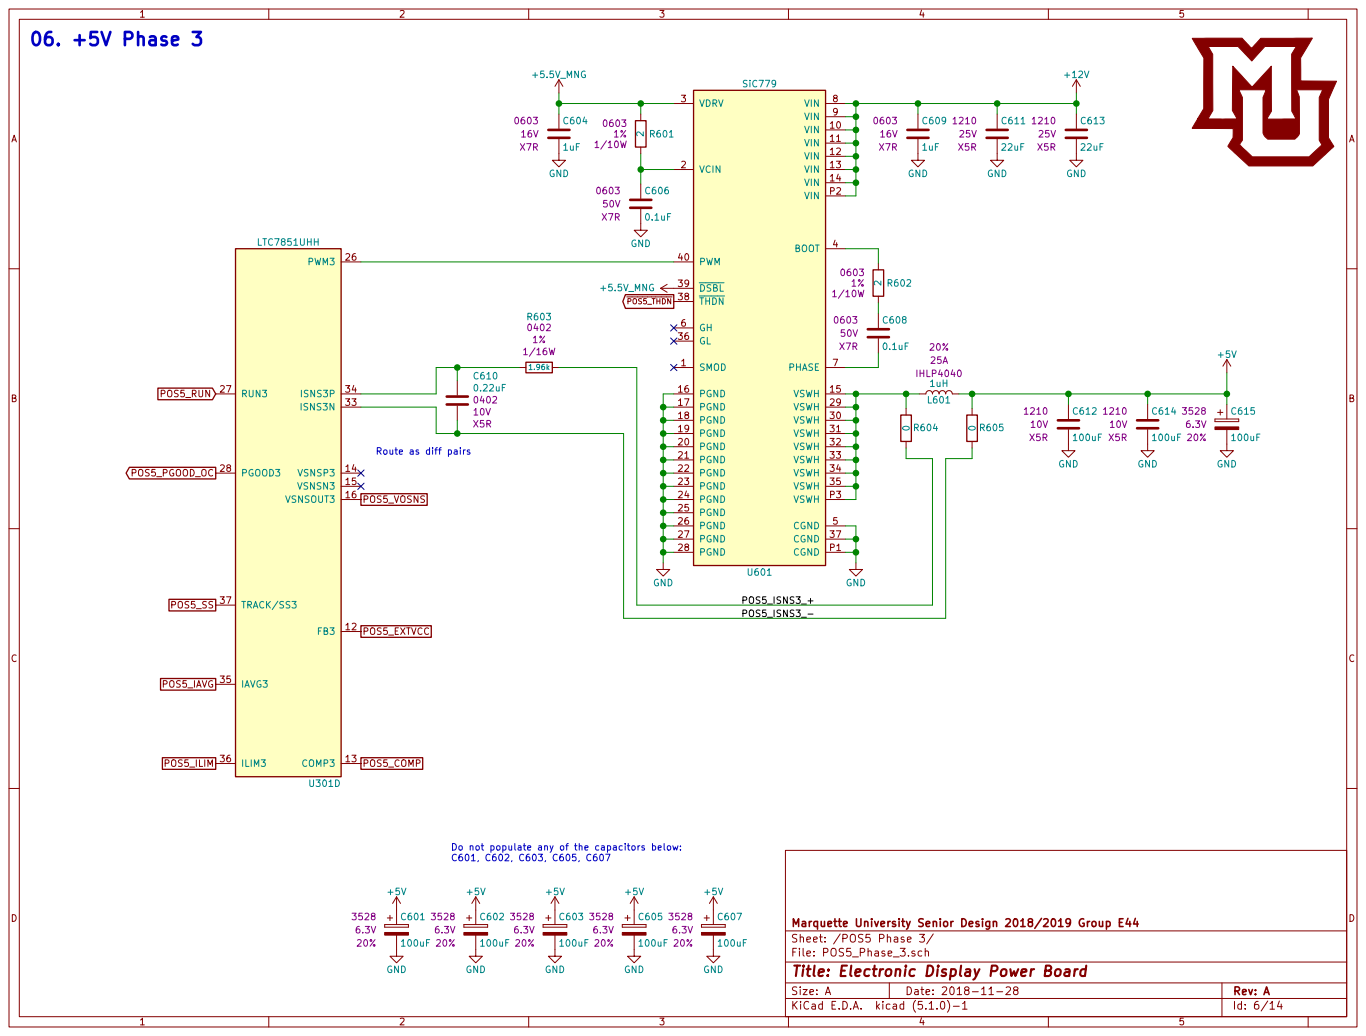
[picture p53: page 6]

File: POS5_Phase_3.sch Sheet: /POS5 Phase 3/ Marquette University Senior Design 2018/2019 Group E44

Id: 6/14 Title: Electronic Display Power Board

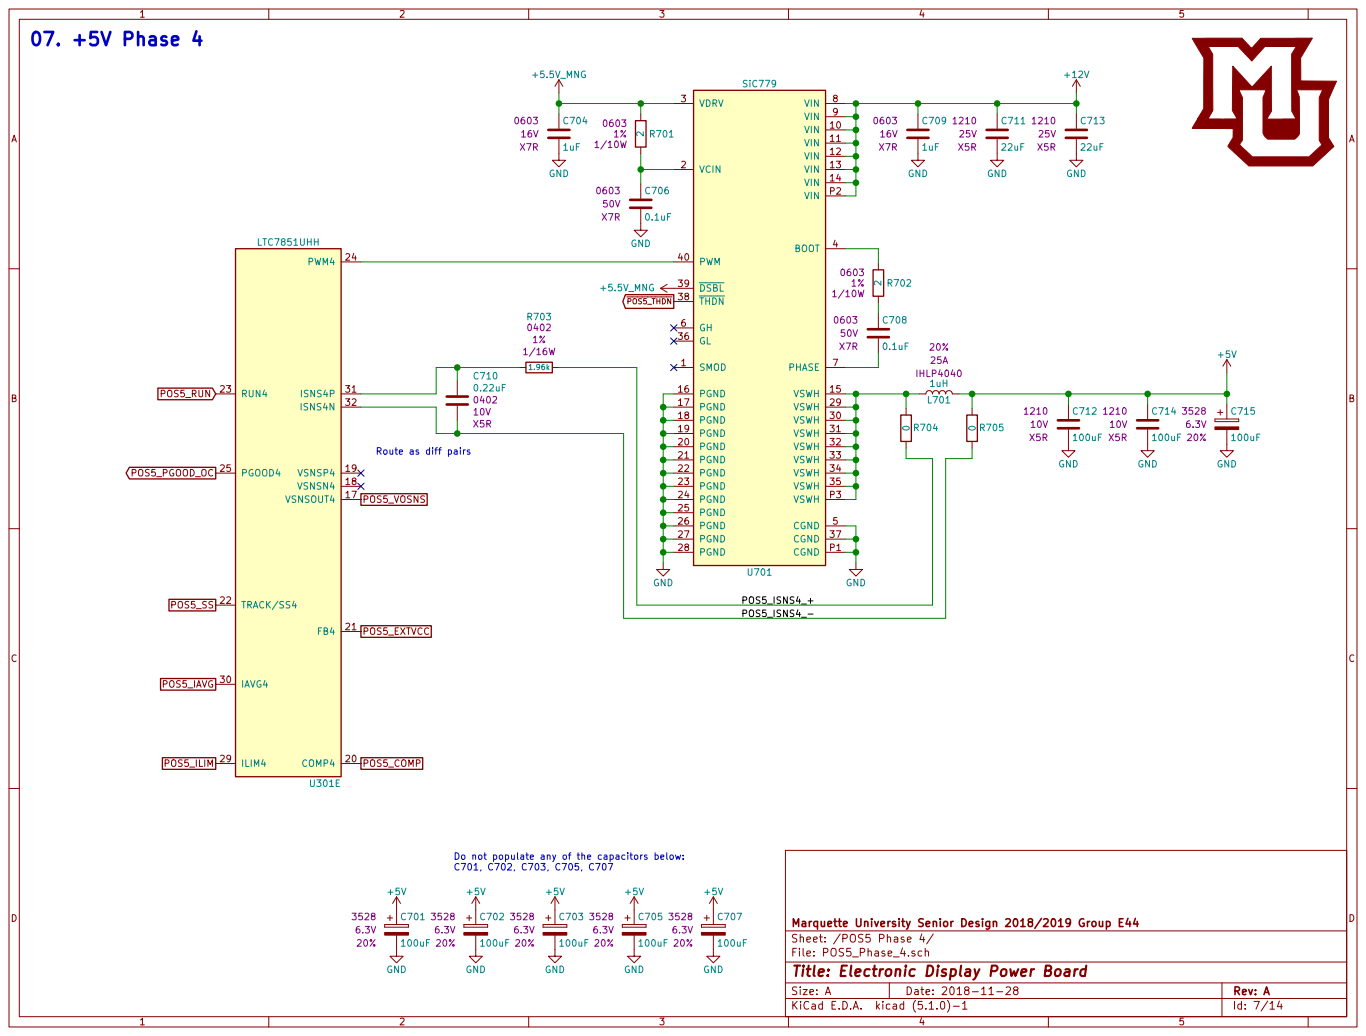
[picture p54: page 7]

File: POS5_Phase_4.sch Sheet: /POS5 Phase 4/ Marquette University Senior Design 2018/2019 Group E44

Id: 7/14 Title: Electronic Display Power Board

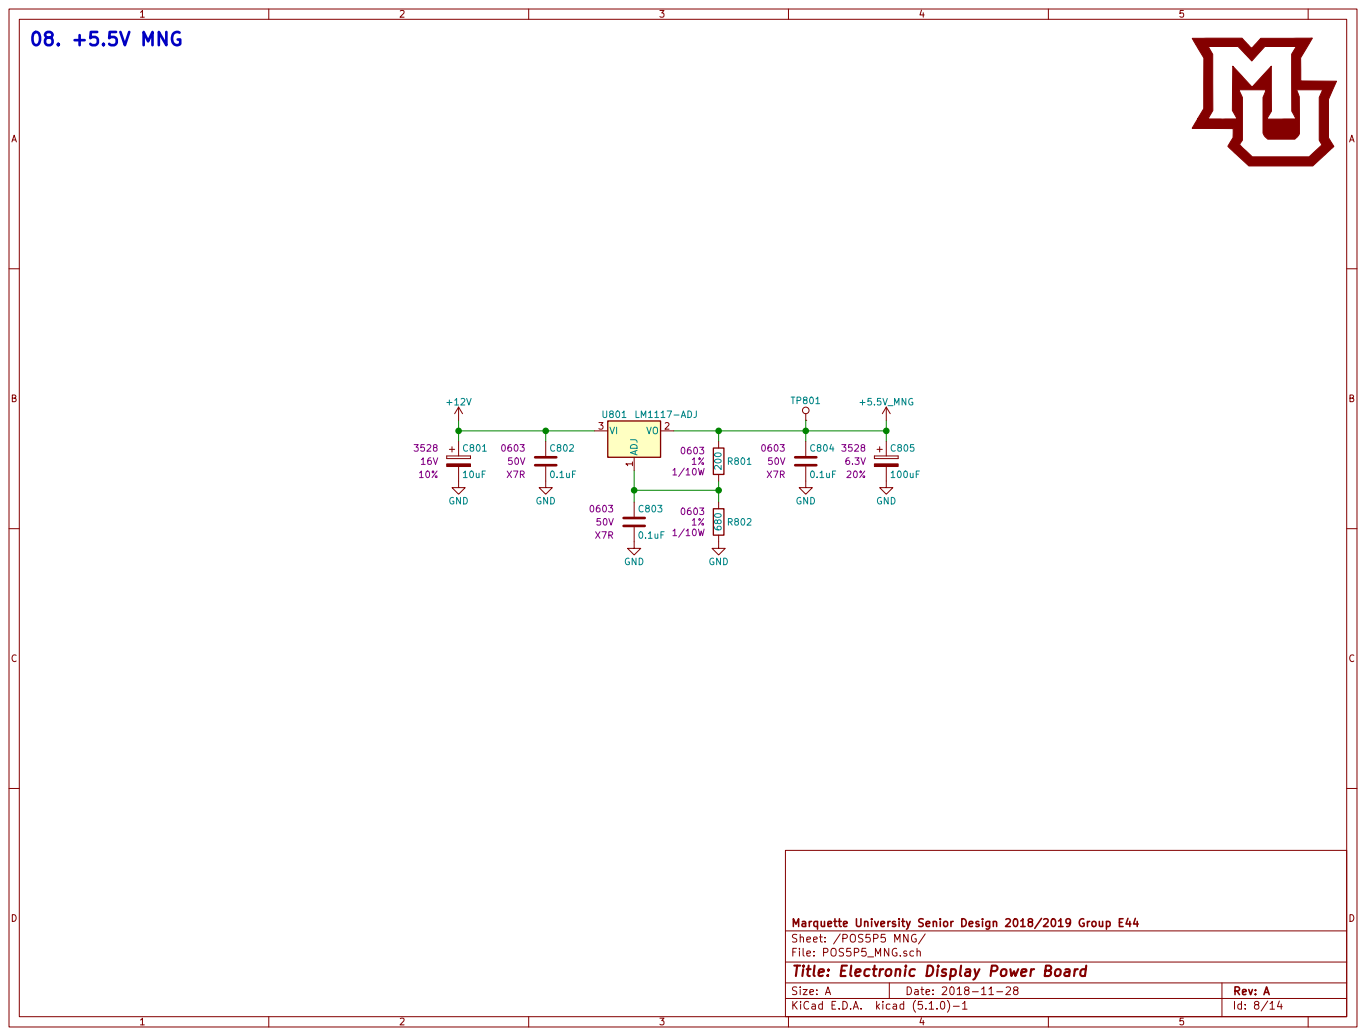
[picture p55: page 8]

File: POS5P5_MNG.sch Sheet: /POS5P5 MNG/ Marquette University Senior Design 2018/2019 Group E44

Id: 8/14 Title: Electronic Display Power Board

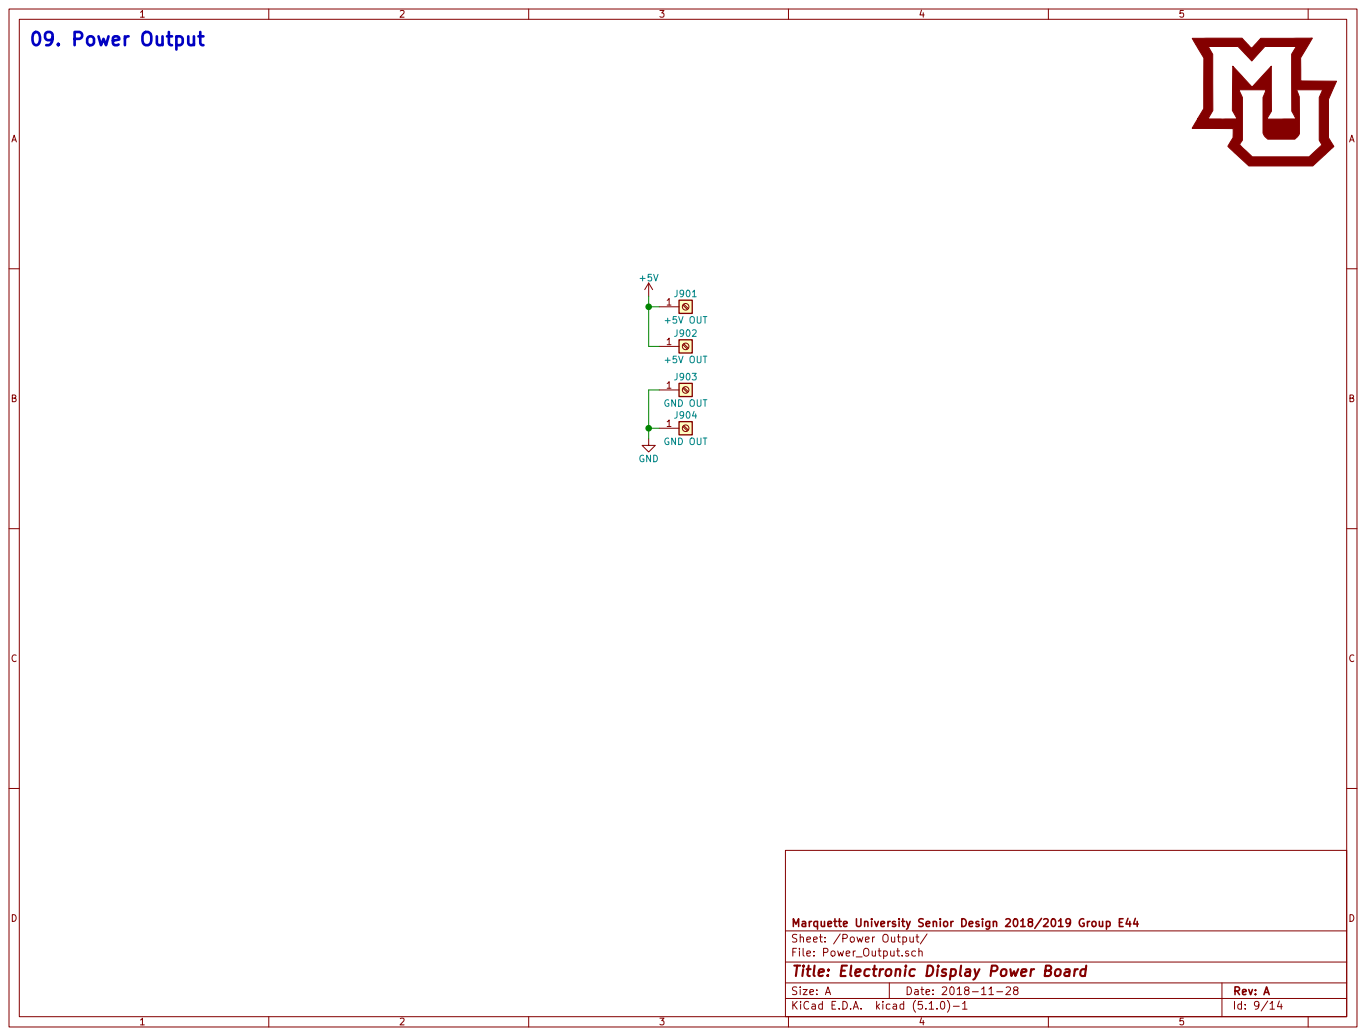
[picture p56: page 9]

J904 GND OUT GND 09. Power Output

Marquette University Senior Design 2018/2019 Group E44
Sheet: /Power Output/
File: Power_Output.sch
Id: 9/14 Title: Electronic Display Power Board

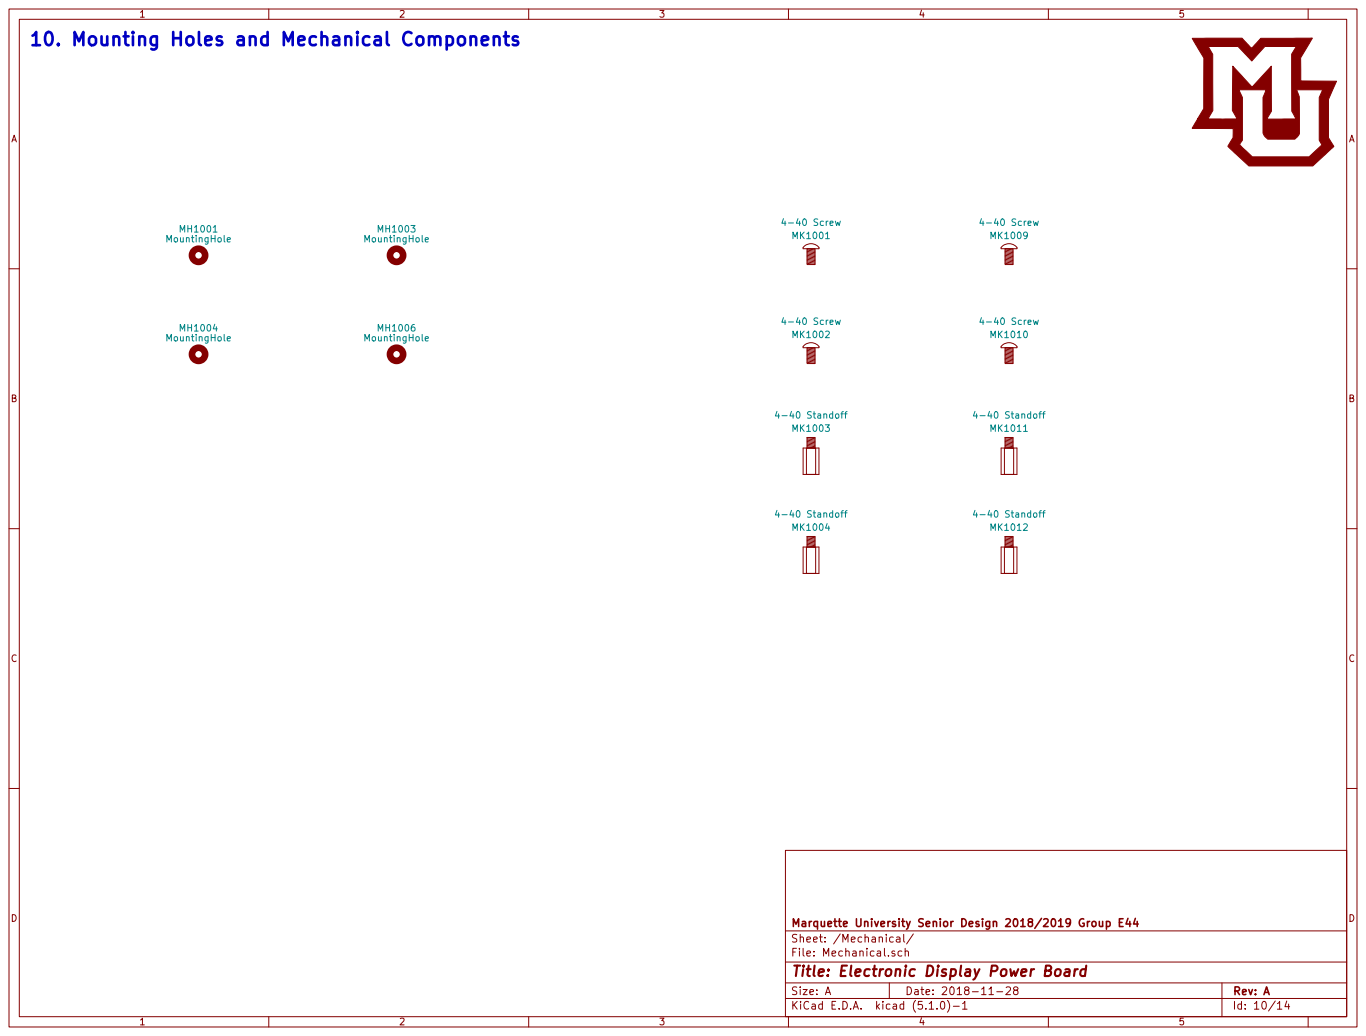
[picture p57: page 10]

10. Mounting Holes and Mechanical Components

File: Mechanical.sch Sheet: /Mechanical/ Marquette University Senior Design 2018/2019 Group E44

Id: 10/14 Title: Electronic Display Power Board

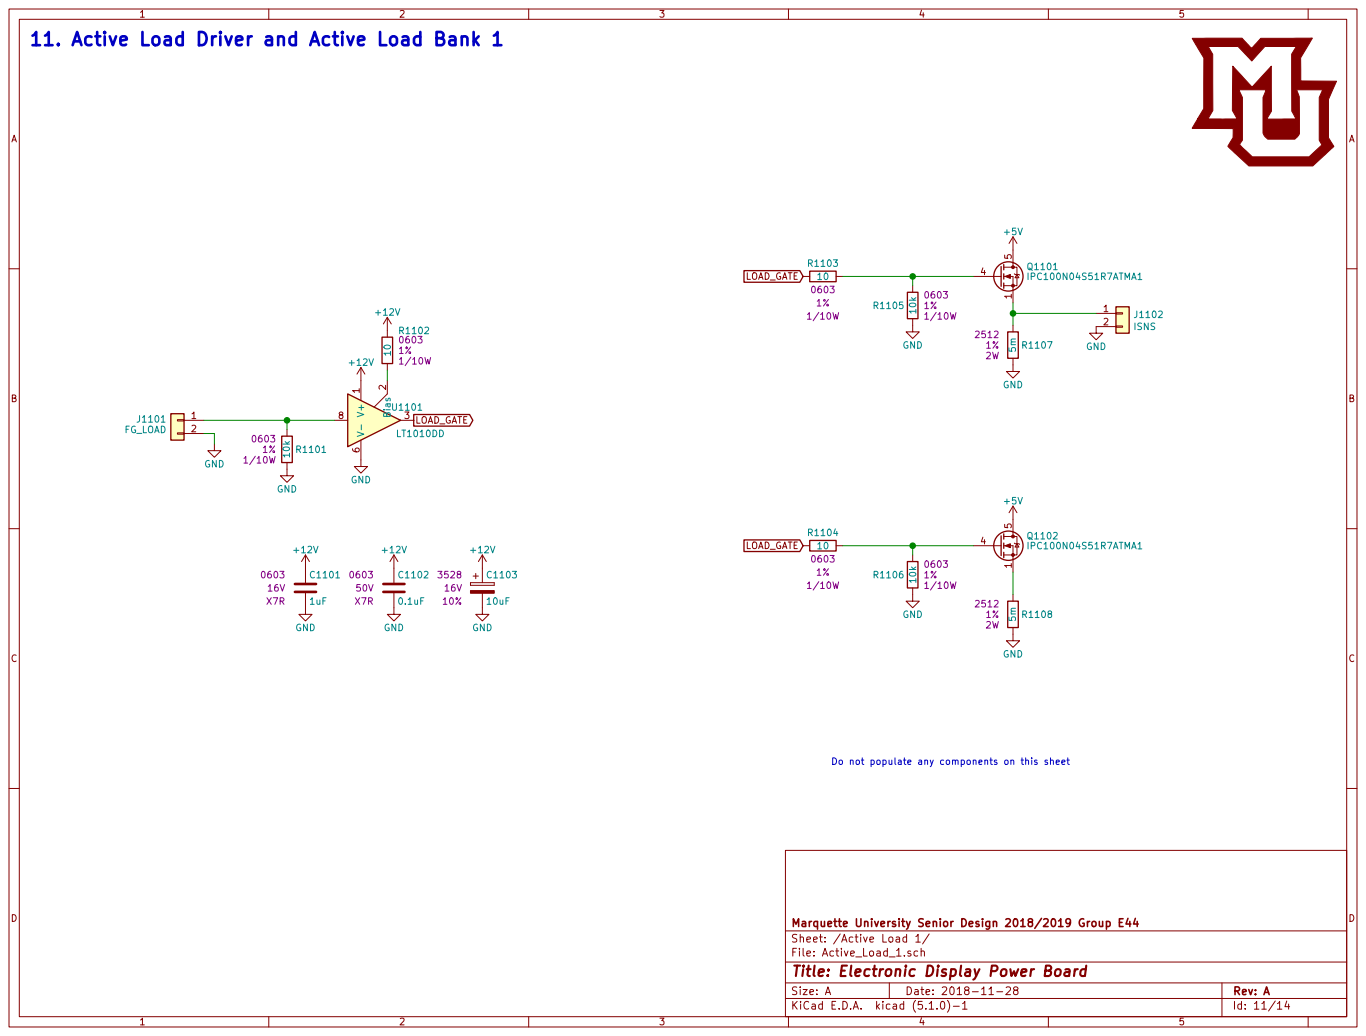
[picture p58: page 11]

+12V GND 11. Active Load Driver and Active Load Bank 1

Do not populate any components on this sheet

File: Active_Load_1.sch Sheet: /Active Load 1/ Marquette University Senior Design 2018/2019 Group E44

Id: 11/14 Title: Electronic Display Power Board

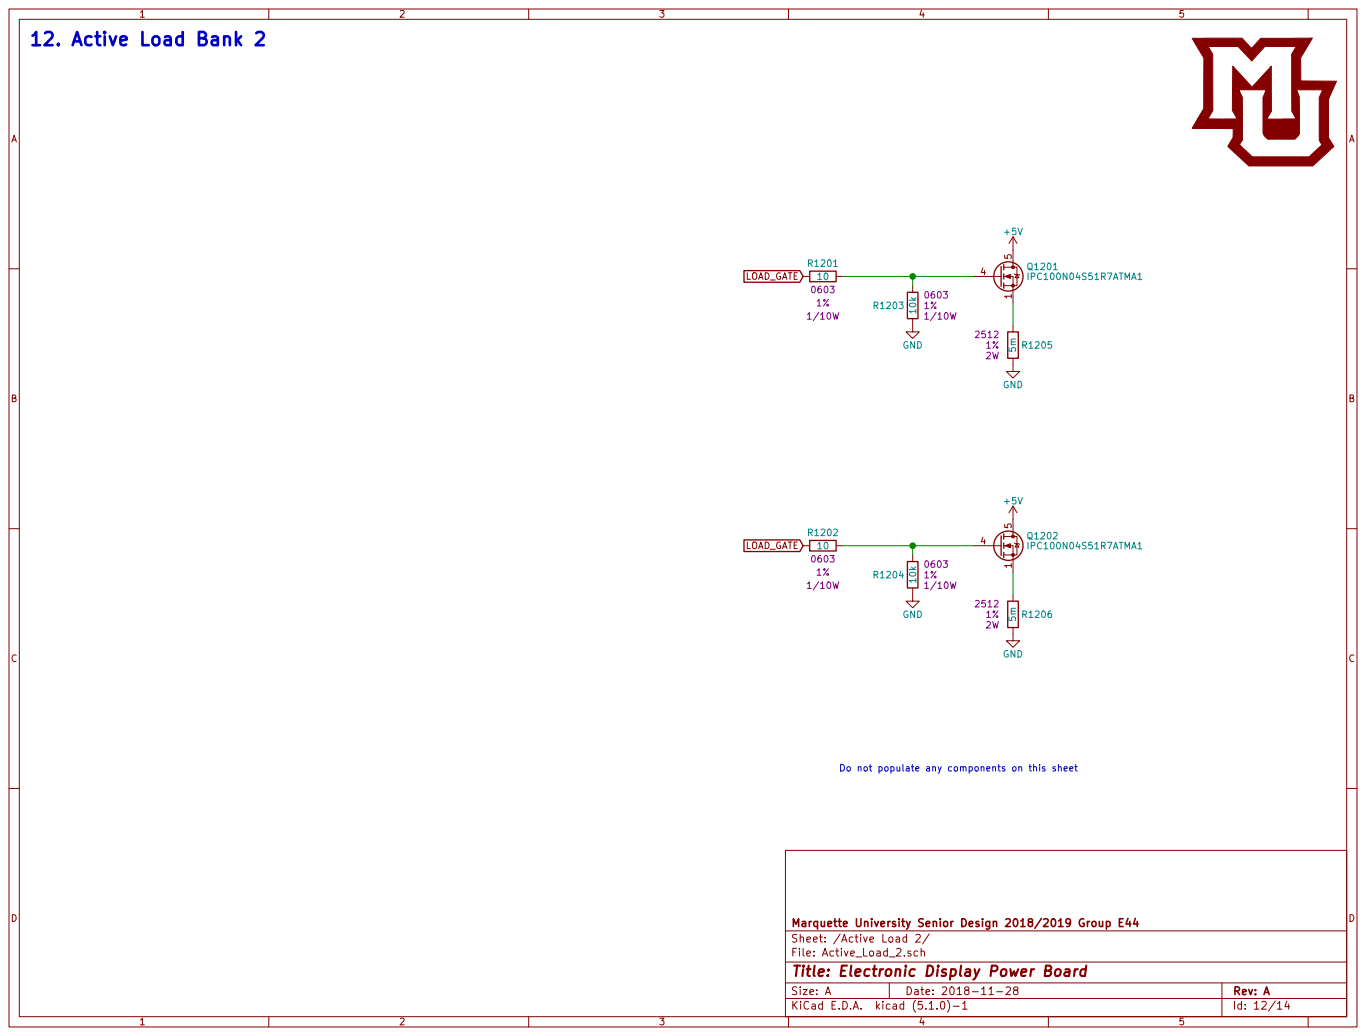
[picture p59: page 12]

Do not populate any components on this sheet

File: Active_Load_2.sch Sheet: /Active Load 2/ Marquette University Senior Design 2018/2019 Group E44

Id: 12/14 Title: Electronic Display Power Board

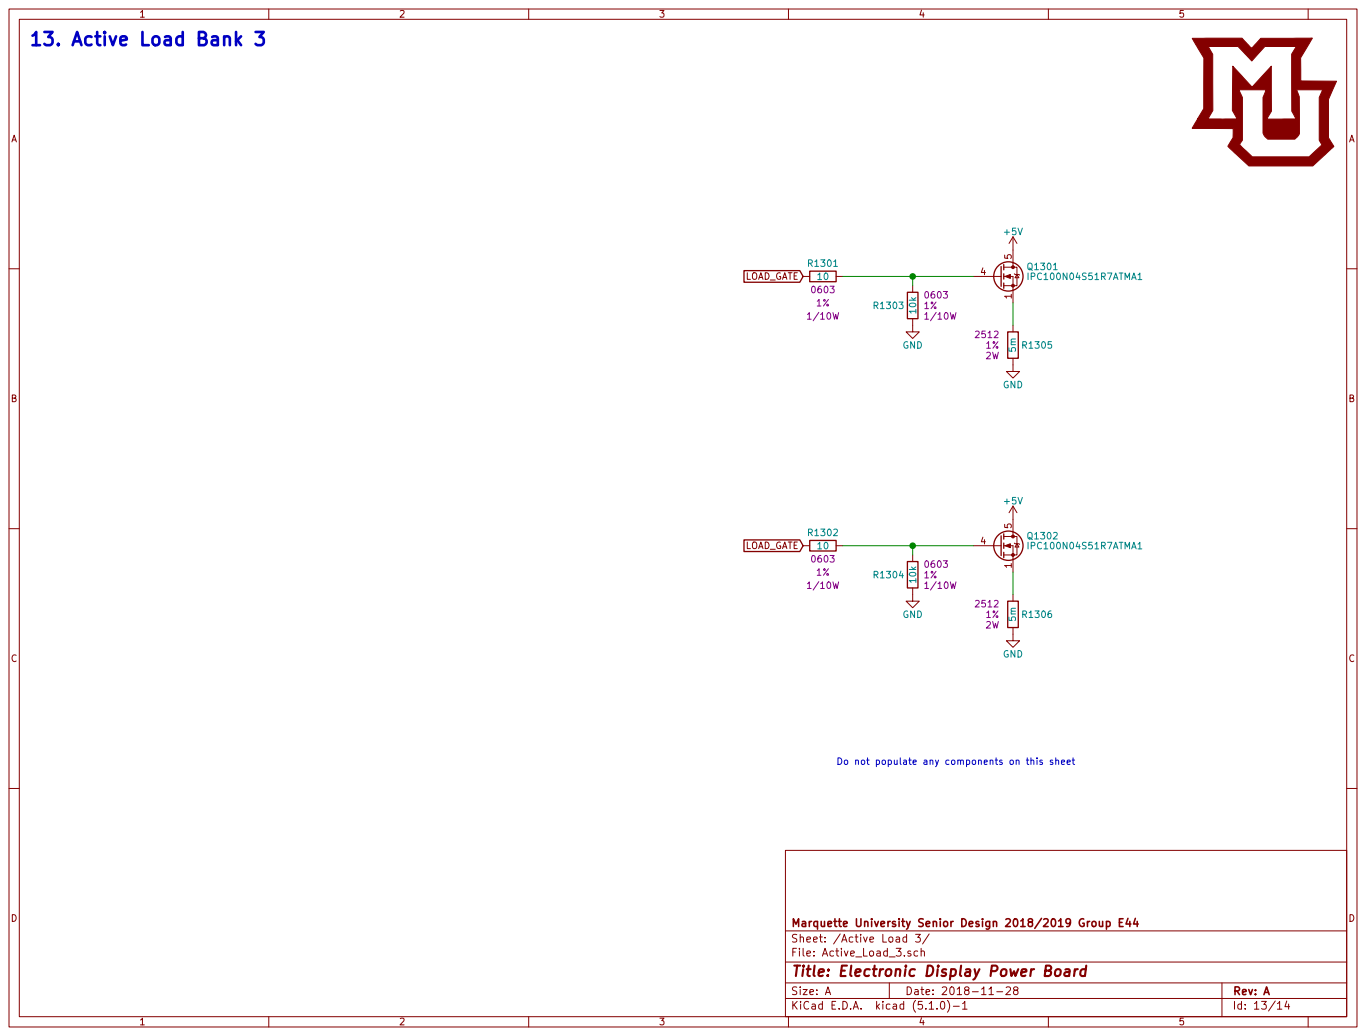
[picture p60: page 13]

Do not populate any components on this sheet

File: Active_Load_3.sch Sheet: /Active Load 3/ Marquette University Senior Design 2018/2019 Group E44

Id: 13/14 Title: Electronic Display Power Board

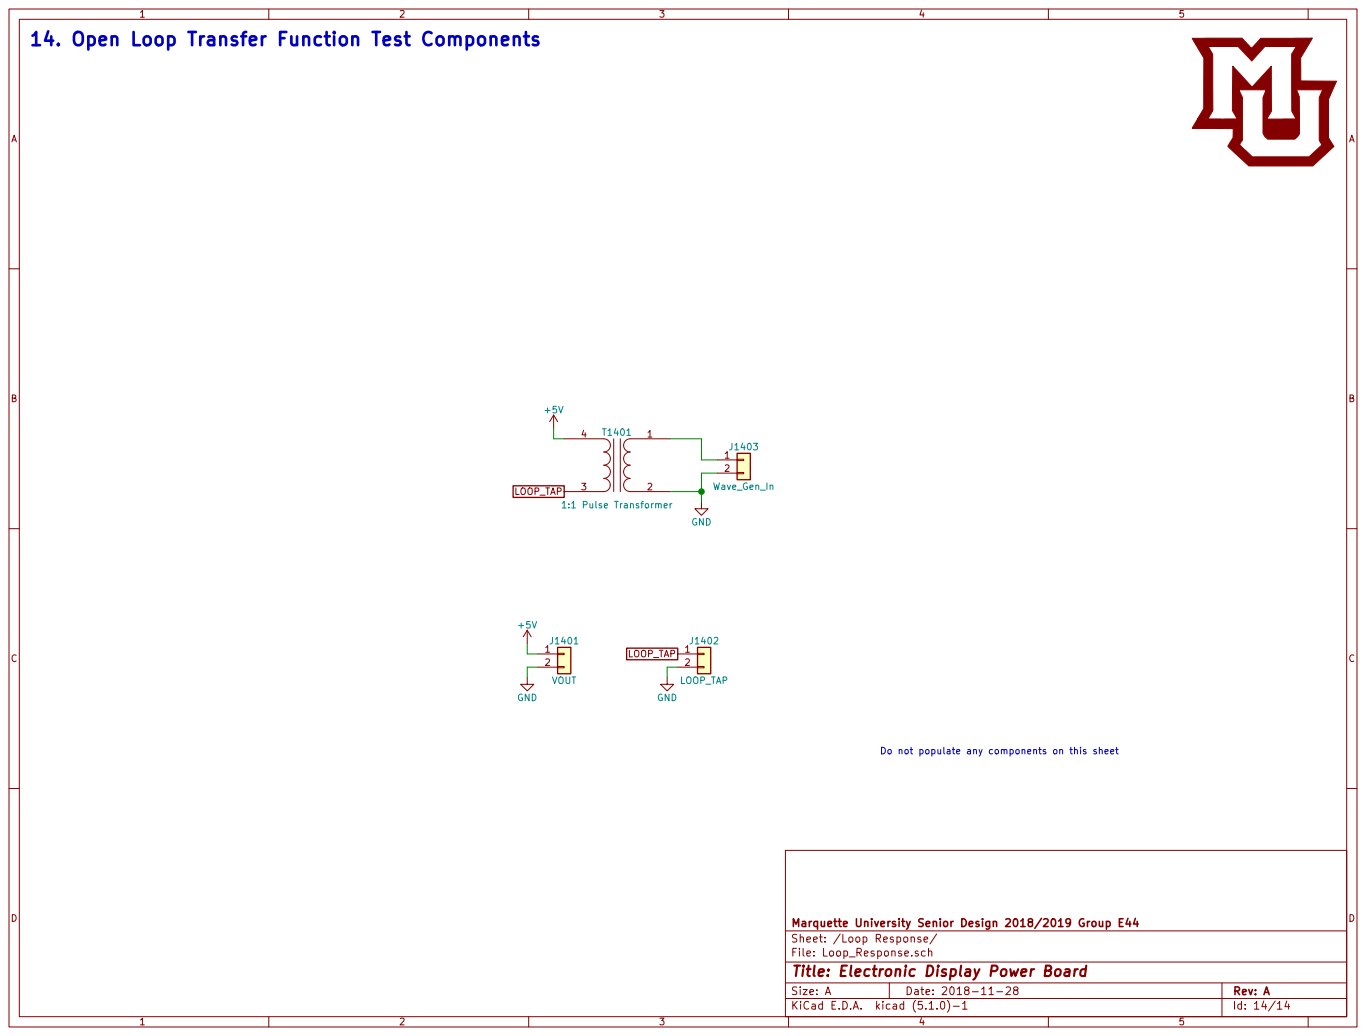
[picture p61: page 14]

Do not populate any components on this sheet

Marquette University Senior Design 2018/2019 Group E44
Sheet: /Loop Response/
File: Loop_Response.sch
Id: 14/14 Title: Electronic Display Power Board
