drewsum/Electronic_Display/hdw/Logic_Board/Design_Files/POS3P3_Power_Supply/3605A.asc

C1: cap; 0p
C2: cap; 15p
Cbst: cap; 0.1µ
Cbulk: polcap; 0µ; x0; Rser=0m MTBF=0 Lser=0n ppPkg=0
Cce: polcap; 21.975238µ; x2; Rser=2.3m MTBF=0 Lser=1.05n ppPkg=2
Css: cap; 10n
Cth: cap; 62p
Cthp: cap; 15p
Cvcc: cap; 2.2µ
Dbst: schottky; MBR0530L
Iload: load2; PWL(0 0 3m 0 3.001m 5 4m 5 4.001m 0)
L1: ind; 0.47µ; Rser=5.4m
R0: RES; 100K
R1: res; 22.1k
R2: res; 100k
R3: res; 100k
R4: res; 22.1k
Ron: res; 63.4k
Rth: res; 13.3k
U2: LTC3605
Vin: VOLTAGE; 12V
Named nets: 0, IN, OUT
.tran 5m startup
If simulation model is not found, please "Sync release".
