drewsum/Electronic_Display/hdw/Power_Board/Design_Files/POS5_Power_Supply/7851.asc

C1: cap; .1µ
C2: cap; 100µ; x20; Rser=70m Lser=1.2n
C3: cap; 3.3n; Rser=332
C4: cap; 2.2n; Rser=6.04K; Cpar=100p
C5: cap; 100p
C6: cap; .1µ
C7: cap; .22µ
C8: cap; .1µ
C9: cap; 100µ; x8; Rser=2m Lser=1.27n
C10: cap; .1µ
C12: cap; .22µ
C13: cap; .22µ
C14: cap; .22µ
D1: schottky; CMDSH2-3
D2: schottky; CMDSH2-3
D3: schottky; CMDSH2-3
D4: schottky; CMDSH2-3
L1: ind; 1µH; Rser=.3m; Rser=2.3m
L2: ind; 1µH; Rser=.3m; Rser=2.3m
L3: ind; 1µH; Rser=.3m; Rser=2.3m
L4: ind; 1µH; Rser=.3m; Rser=2.3m
M1: nmos; Si4408DY
M2: nmos; Si4408DY
M3: nmos; Si4408DY
M4: nmos; Si4408DY
M5: nmos; Si4408DY
M6: nmos; Si4408DY
M7: nmos; Si4408DY
M8: nmos; Si4408DY
R1: res; 51.1k
R2: res; 1.96k
R3: res; 0.111111
R5: res; 13.7k
R6: res; 1.96k
R8: res; 59k
R9: res; 100k
R10: res; 1.96k
R11: res; 1.96k
U1: LTC7851
U2: LTC4449
U3: LTC4449
U4: LTC4449
U5: LTC4449
V1: voltage; 5.5
V2: voltage; 12
Named nets: 0, IN, OUT
.tran 10m startup
