drewsum/Electronic_Display/hdw/Logic_Board/Design_Files/Power_Input/4365.asc

C1: cap; 100µ
Q1: nmos; Si4850EY
Q2: nmos; Si4850EY
R1: res; 100k
R2: res; 6.04Meg
R3: res; 86.6k
R4: res; 243k
R5: res; 10K
Rload: res; 100
U1: LTC4365
V1: voltage; SINE(10 10 0.25)
Named nets: IN, OUT, 0
.tran 3
