drewsum/Electronic_Display/hdw/Logic_Board/LED_Display_Controller/LED_Display_Controller.kicad_pcb

## KiCad design hdw/Logic_Board/LED_Display_Controller/LED_Display_Controller.kicad_pcb (2019-01-11)

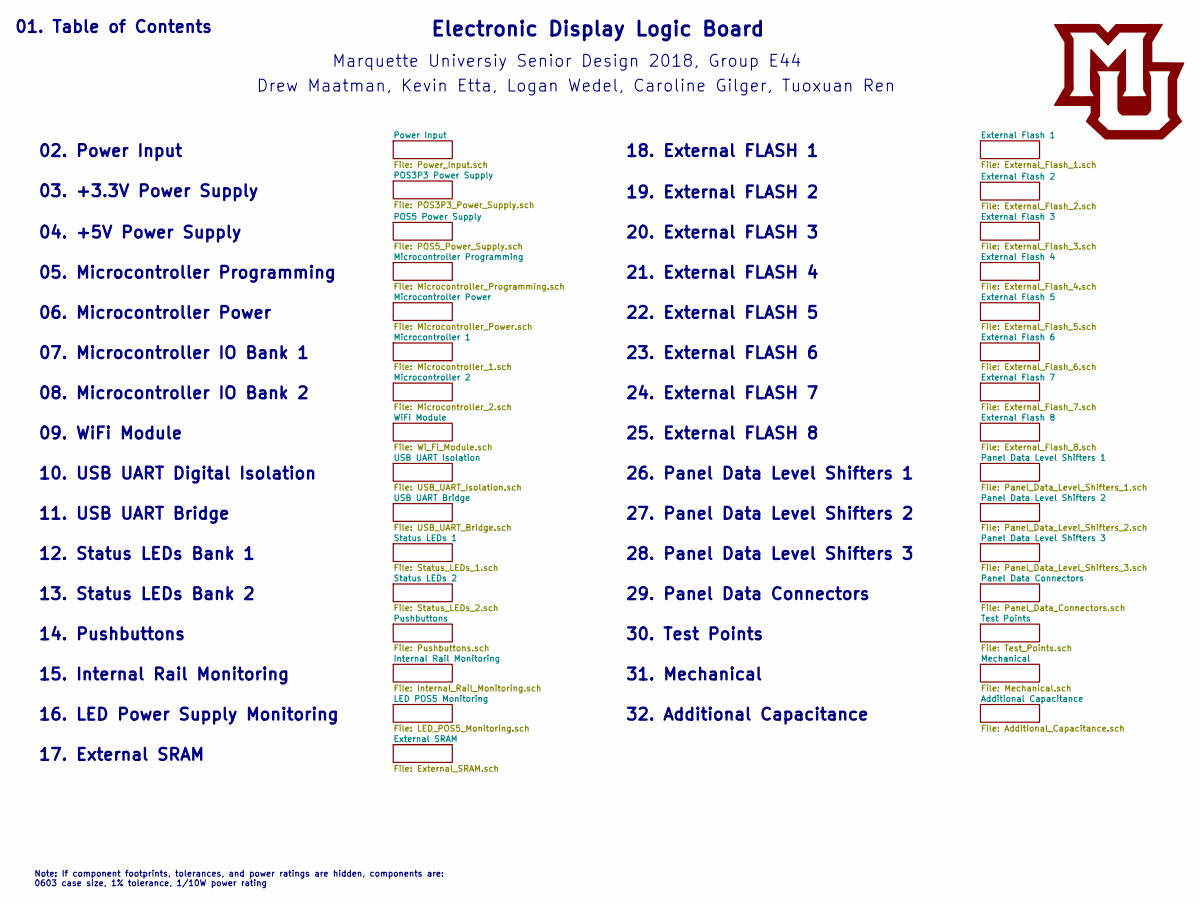
[picture p62: schematic LED_Display_Controller.sch, Electronic Display Logic Board]

Notes on the sheet:
02. Power Input
03. +3.3V Power Supply
04. +5V Power Supply
05. Microcontroller Programming
06. Microcontroller Power
07. Microcontroller IO Bank 1
08. Microcontroller IO Bank 2
09. WiFi Module
10. USB UART Digital Isolation
11. USB UART Bridge
12. Status LEDs Bank 1
13. Status LEDs Bank 2
14. Pushbuttons
15. Internal Rail Monitoring
16. LED Power Supply Monitoring
17. External SRAM
18. External FLASH 1
19. External FLASH 2
20. External FLASH 3
21. External FLASH 4
22. External FLASH 5
23. External FLASH 6
24. External FLASH 7
25. External FLASH 8
26. Panel Data Level Shifters 1
27. Panel Data Level Shifters 2
28. Panel Data Level Shifters 3
29. Panel Data Connectors
30. Test Points
31. Mechanical
Electronic Display Logic Board
Marquette Universiy Senior Design 2018, Group E44
Drew Maatman, Kevin Etta, Logan Wedel, Caroline Gilger, Tuoxuan Ren
01. Table of Contents
Note: If component footprints, tolerances, and power ratings are hidden, components are: 0603 case size, 1% tolerance, 1/10W power rating
32. Additional Capacitance

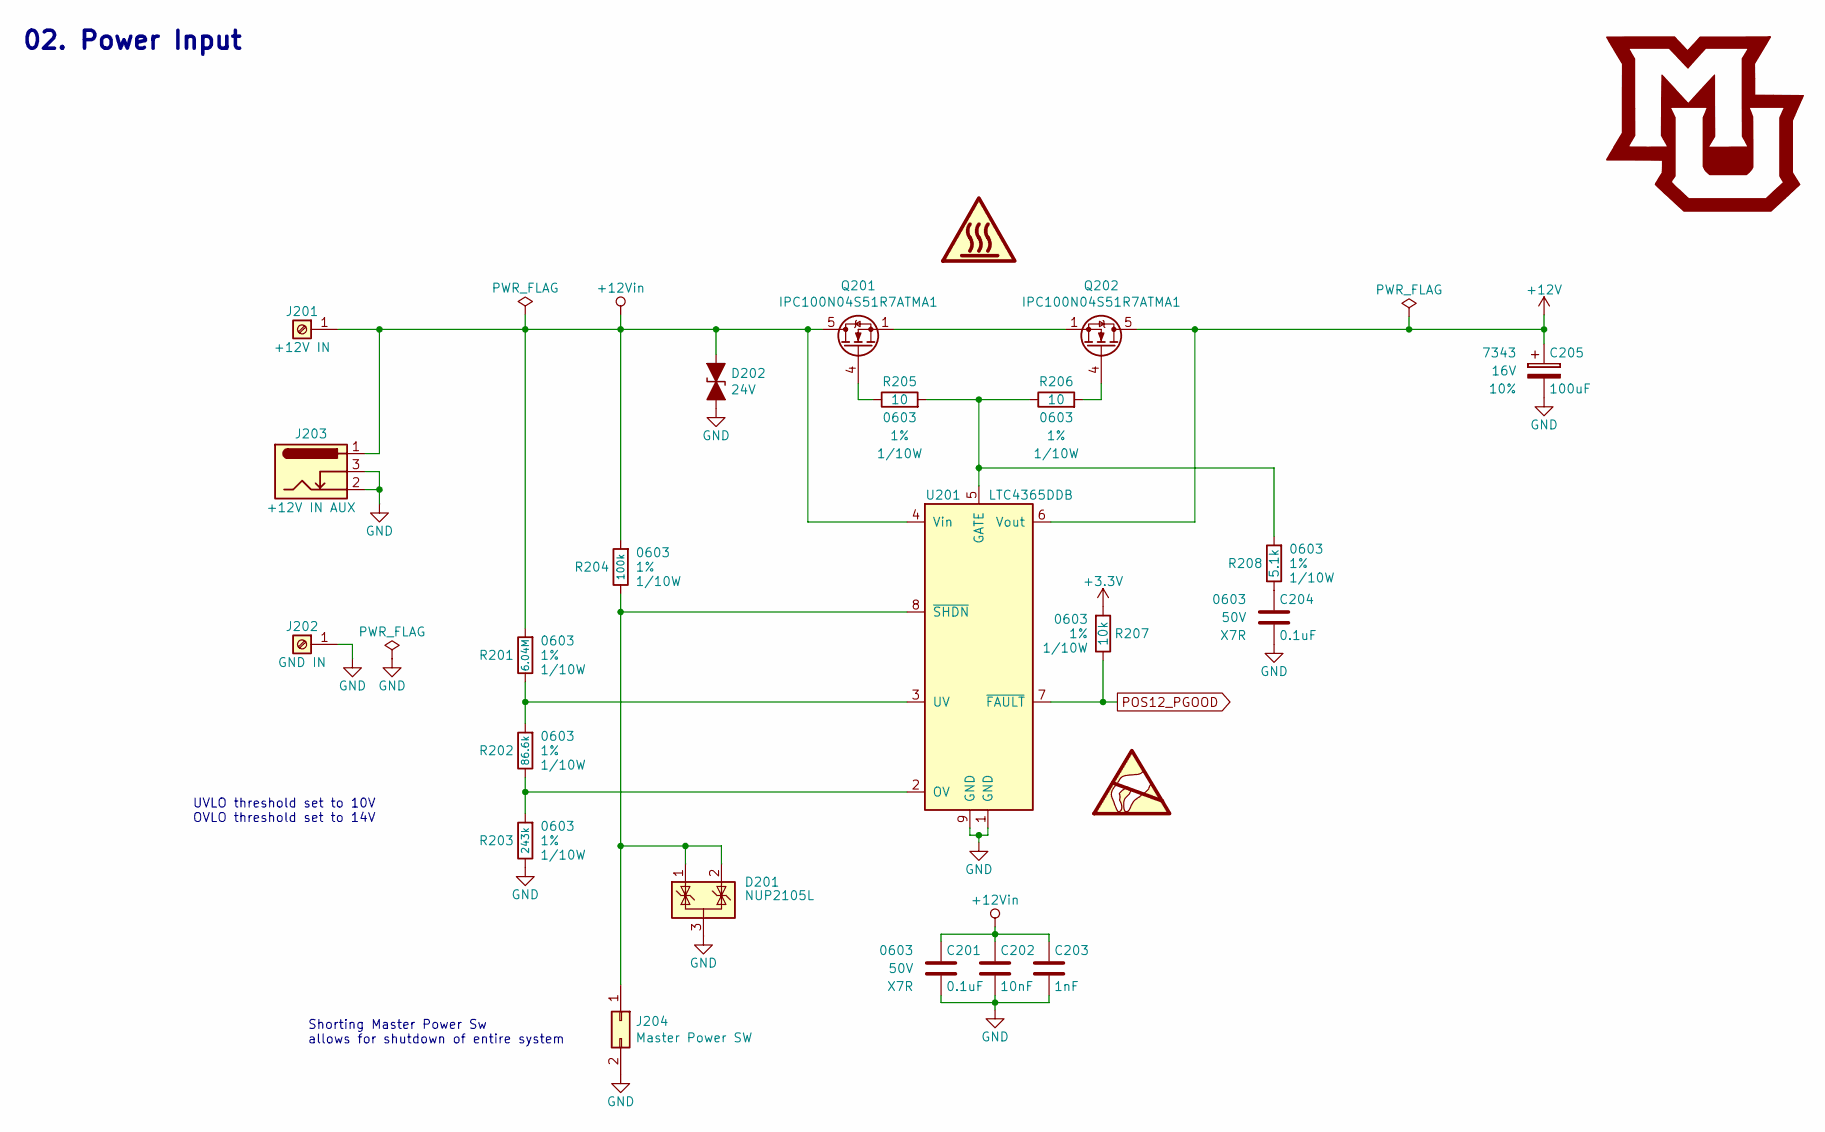
[picture p63: schematic Power_Input.sch, Electronic Display Logic Board]

Parts:
C201, C204: 0.1uF; C_0603; Voltage 50V; Digi-Key PN 311-1344-1-ND
C202: 10nF; C_0603; Voltage 50V; Digi-Key PN 1276-1921-1-ND
C203: 1nF; C_0603; Voltage 50V; Digi-Key PN 1276-1018-1-ND
C205: 100uF; CP_Tantalum_Case-X_EIA-7343-43_Reflow; Voltage 16V; Tolerance 10%; Digi-Key PN 718-1102-1-ND
D201: NUP2105L; SOT-23; Digi-Key PN NUP2105LT1GOSCT-ND
D202: 24V; D_SMA; Digi-Key PN SMAJ24CALFCT-ND
J201: +12V IN; Wuerth_7461096_M4_Shank_9pos; Digi-Key PN 732-3214-ND
J202: GND IN; Wuerth_7461096_M4_Shank_9pos; Digi-Key PN 732-3214-ND
J203: +12V IN AUX; BARREL_JACK; Digi-Key PN CP-202BH-ND
J204: Master Power SW; Pin_Header_Straight_1x02_Pitch2.54mm
Q201, Q202: IPC100N04S51R7ATMA1; TDSON-8-1; Digi-Key PN IPC100N04S51R7ATMA1CT-ND
R201: 6.04M; R_0603; Tolerance 1%; Digi-Key PN 541-6.04MHCT-ND
R202: 86.6k; R_0603; Tolerance 1%; Digi-Key PN 311-86.6KHRCT-ND
R203: 243k; R_0603; Tolerance 1%; Digi-Key PN 311-243KHRCT-ND
R204: 100k; R_0603; Tolerance 1%; Digi-Key PN A106046CT-ND
R205, R206: 10; R_0603; Tolerance 1%; Digi-Key PN YAG3351CT-ND
R207: 10k; R_0603; Tolerance 1%; Digi-Key PN RMCF0603FT10K0CT-ND
R208: 5.1k; R_0603; Tolerance 1%; Digi-Key PN YAG3621CT-ND
U201: LTC4365DDB; DFN-8-1EP_2x3mm_Pitch0.5mm; Digi-Key PN LTC4365IDDB#TRMPBFCT-ND

Connections:
+3V3: R207.1; also elsewhere on the board
+12V: C205.1, Q202.5 (D), U201.6 (Vout); also elsewhere on the board
+12Vin: C201.1, C202.1, C203.1, D202.1 (A1), J201.1, J203.1, Q201.5 (D), R201.1, R204.1, U201.4 (Vin); also elsewhere on the board
GND: C201.2, C202.2, C203.2, C204.2, C205.2, D201.3 (A), D202.2 (A2), J202.1, J203.2, J203.3, J204.2, R203.2, U201.1 (GND), U201.9 (GND); also elsewhere on the board
unnamed: C204.1, R208.2
unnamed: D201.1 (K), D201.2 (K), J204.1, R204.2, U201.8 (~SHDN)
unnamed: Q201.1 (S), Q201.2 (S), Q201.3 (S), Q202.1 (S), Q202.2 (S), Q202.3 (S)
unnamed: Q201.4 (G), R205.2
unnamed: Q202.4 (G), R206.1
unnamed: R201.2, R202.1, U201.3 (UV)
unnamed: R202.2, R203.1, U201.2 (OV)
unnamed: R205.1, R206.2, R208.1, U201.5 (GATE)
POS12_PGOOD: R207.2, U201.7 (~FAULT); also elsewhere on the board

Notes on the sheet:
UVLO threshold set to 10V OVLO threshold set to 14V
Shorting Master Power Sw allows for shutdown of entire system
02. Power Input

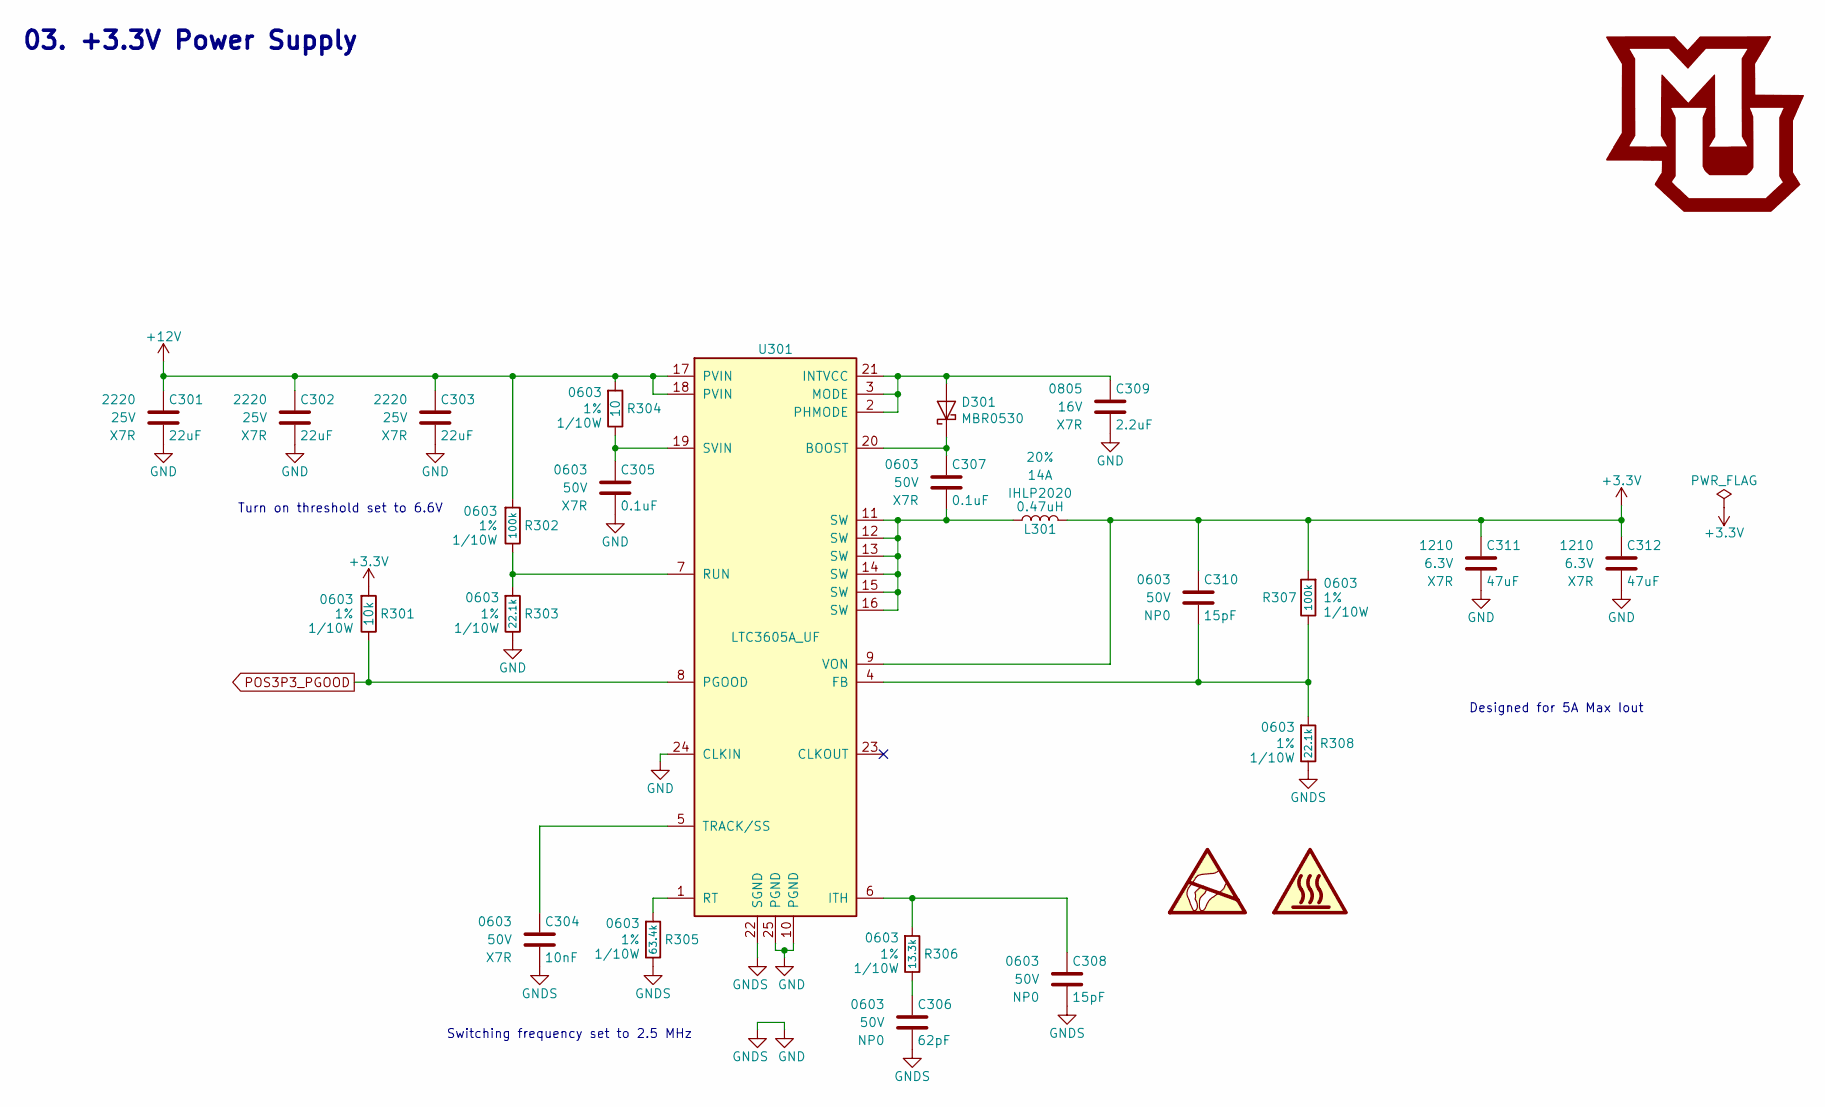
[picture p64: schematic POS3P3_Power_Supply.sch, Electronic Display Logic Board]

Parts:
C301, C302, C303: 22uF; C_2220; Voltage 25V; Digi-Key PN 445-1453-1-ND
C304: 10nF; C_0603; Voltage 50V; Digi-Key PN 1276-1921-1-ND
C305, C307: 0.1uF; C_0603; Voltage 50V; Digi-Key PN 311-1344-1-ND
C306: 62pF; C_0603; Voltage 50V; Digi-Key PN 1276-2320-1-ND
C308, C310: 15pF; C_0603; Voltage 50V; Digi-Key PN 478-10289-1-ND
C309: 2.2uF; C_0805; Voltage 16V; Digi-Key PN 445-5691-1-ND
C311, C312: 47uF; C_1210; Voltage 6.3V; Digi-Key PN 490-4844-1-ND
D301: MBR0530; D_SOD-123; Digi-Key PN MBR0530T1GOSCT-ND
L301: 0.47uH; L_Vishay_IHLP-2020; Tolerance 20%; Digi-Key PN 541-1231-1-ND
R301: 10k; R_0603; Tolerance 1%; Digi-Key PN RMCF0603FT10K0CT-ND
R302, R307: 100k; R_0603; Tolerance 1%; Digi-Key PN A106046CT-ND
R303, R308: 22.1k; R_0603; Tolerance 1%; Digi-Key PN P22.1KHCT-ND
R304: 10; R_0603; Tolerance 1%; Digi-Key PN YAG3351CT-ND
R305: 63.4k; R_0603; Tolerance 1%; Digi-Key PN 541-63.4KHCT-ND
R306: 13.3k; R_0603; Tolerance 1%; Digi-Key PN P13.3KHCT-ND
U301: LTC3605A_UF; QFN-24-1EP_4x4mm_Pitch0.5mm; Digi-Key PN LTC3605AIUF#TRPBFCT-ND

Connections:
+3V3: C310.1, C311.1, C312.1, L301.2, R301.1, R307.1, U301.9 (VON); also elsewhere on the board
+12V: C301.1, C302.1, C303.1, R302.1, R304.1, U301.17 (PVIN), U301.18 (PVIN); also elsewhere on the board
GND: C301.2, C302.2, C303.2, C304.2, C305.2, C306.2, C308.2, C309.2, C311.2, C312.2, R303.2, R305.2, R308.2, U301.10 (PGND), U301.22 (SGND), U301.24 (CLKIN), U301.25 (PGND); also elsewhere on the board
unnamed: C304.1, U301.5 (TRACK/SS)
unnamed: C305.1, R304.2, U301.19 (SVIN)
unnamed: C306.1, R306.2
unnamed: C307.1, D301.1 (K), U301.20 (BOOST)
unnamed: C307.2, L301.1, U301.11 (SW), U301.12 (SW), U301.13 (SW), U301.14 (SW), U301.15 (SW), U301.16 (SW)
unnamed: C308.1, R306.1, U301.6 (ITH)
unnamed: C309.1, D301.2 (A), U301.2 (PHMODE), U301.3 (MODE), U301.21 (INTVCC)
unnamed: C310.2, R307.2, R308.1, U301.4 (FB)
unnamed: R302.2, R303.1, U301.7 (RUN)
unnamed: R305.1, U301.1 (RT)
POS3P3_PGOOD: R301.2, U301.8 (PGOOD); also elsewhere on the board

Notes on the sheet:
03. +3.3V Power Supply
Designed for 5A Max Iout
Turn on threshold set to 6.6V
Switching frequency set to 2.5 MHz

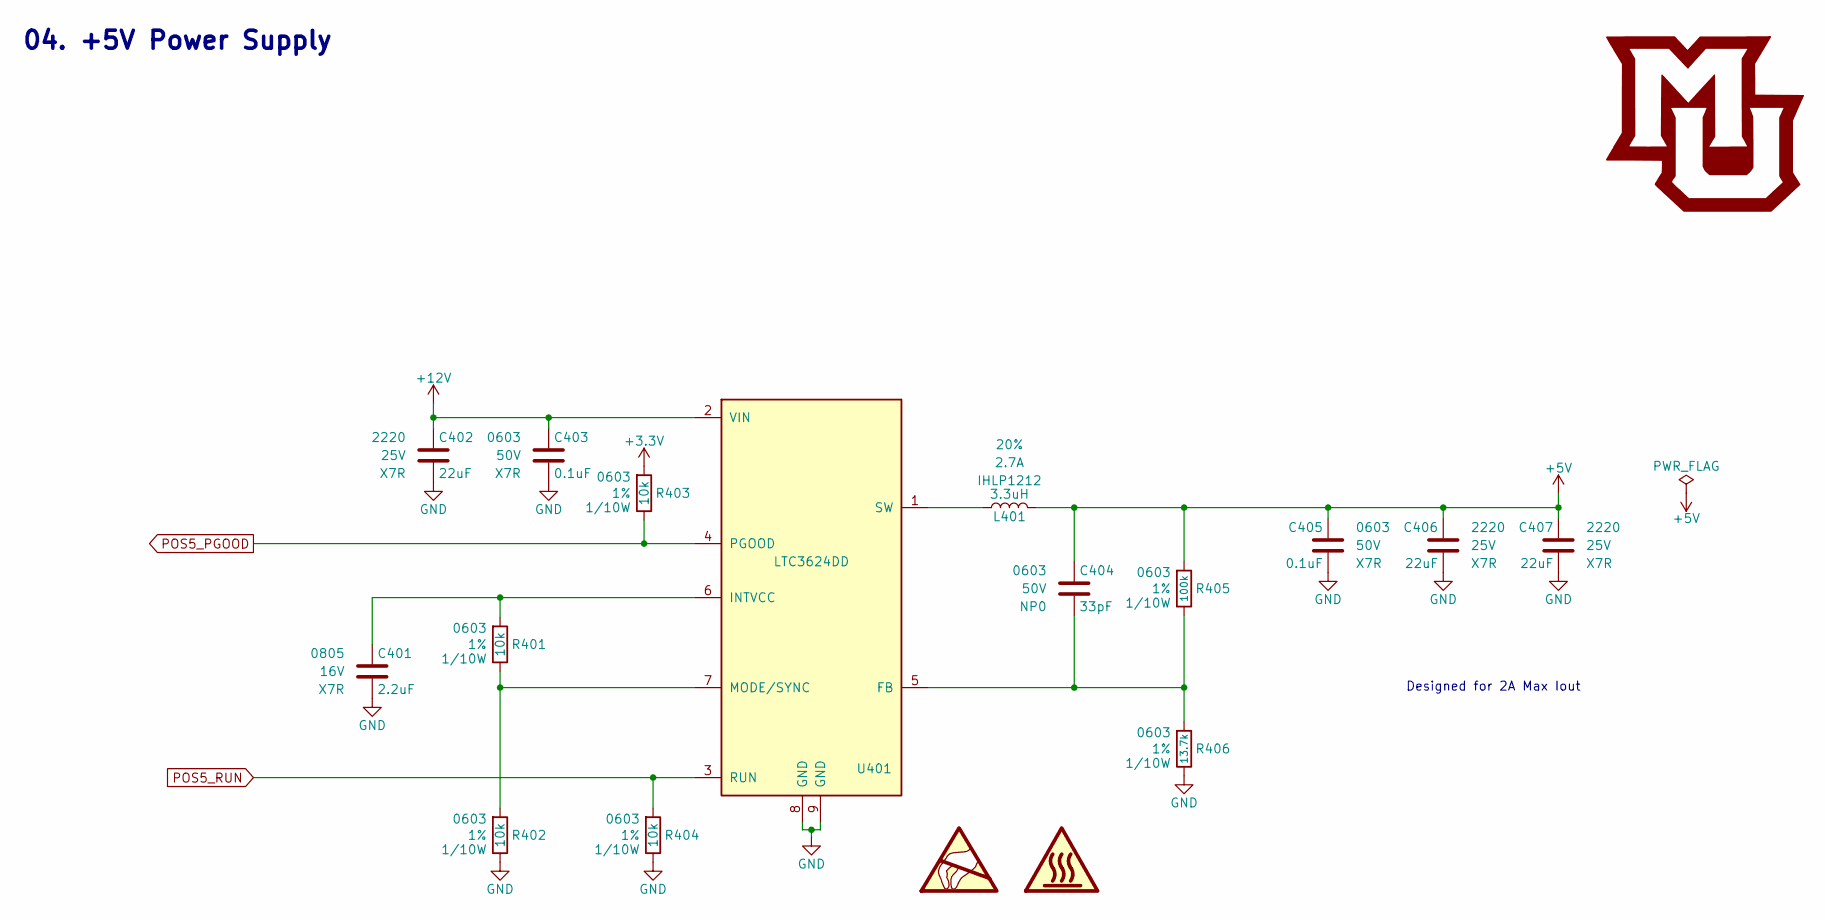
[picture p65: schematic POS5_Power_Supply.sch, Electronic Display Logic Board]

Parts:
C401: 2.2uF; C_0805; Voltage 16V; Digi-Key PN 445-5691-1-ND
C402, C406, C407: 22uF; C_2220; Voltage 25V; Digi-Key PN 445-1453-1-ND
C403, C405: 0.1uF; C_0603; Voltage 50V; Digi-Key PN 311-1344-1-ND
C404: 33pF; C_0603; Voltage 50V; Digi-Key PN 399-1055-1-ND
L401: 3.3uH; L_Vishay_IHLP-1212; Tolerance 20%; Digi-Key PN 541-2567-1-ND
R401, R402, R403, R404: 10k; R_0603; Tolerance 1%; Digi-Key PN RMCF0603FT10K0CT-ND
R405: 100k; R_0603; Tolerance 1%; Digi-Key PN A106046CT-ND
R406: 13.7k; R_0603; Tolerance 1%; Digi-Key PN P13.7KHCT-ND
U401: LTC3624DD; DFN-8-1EP_3x3mm_Pitch0.5mm; Digi-Key PN LTC3624IDD#PBF-ND

Connections:
+3V3: R403.1; also elsewhere on the board
+5V: C404.1, C405.1, C406.1, C407.1, L401.2, R405.1; also elsewhere on the board
+12V: C402.1, C403.1, U401.2 (VIN); also elsewhere on the board
GND: C401.2, C402.2, C403.2, C405.2, C406.2, C407.2, R402.2, R404.2, R406.2, U401.8 (GND), U401.9 (GND); also elsewhere on the board
unnamed: C401.1, R401.1, U401.6 (INTVCC)
unnamed: C404.2, R405.2, R406.1, U401.5 (FB)
unnamed: L401.1, U401.1 (SW)
unnamed: R401.2, R402.1, U401.7 (MODE/SYNC)
POS5_PGOOD: R403.2, U401.4 (PGOOD); also elsewhere on the board
POS5_RUN: R404.1, U401.3 (RUN); also elsewhere on the board

Notes on the sheet:
Designed for 2A Max Iout
04. +5V Power Supply

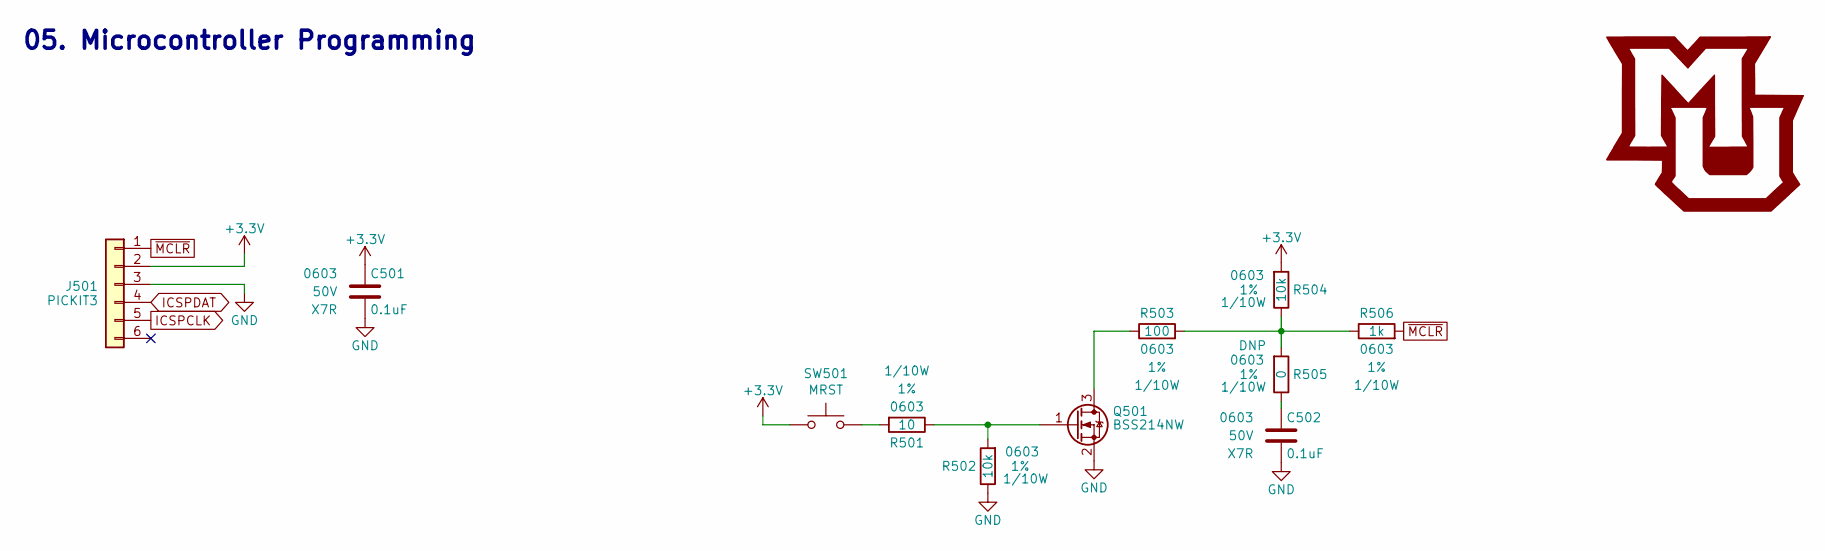
[picture p66: schematic Microcontroller_Programming.sch, Electronic Display Logic Board]

Parts:
C501, C502: 0.1uF; C_0603; Voltage 50V; Digi-Key PN 311-1344-1-ND
J501: PICKIT3; PICKIT3_Header
Q501: BSS214NW; SOT-323_SC-70; Digi-Key PN BSS214NWH6327XTSA1CT-ND
R501: 10; R_0603; Tolerance 1%; Digi-Key PN YAG3351CT-ND
R502, R504: 10k; R_0603; Tolerance 1%; Digi-Key PN RMCF0603FT10K0CT-ND
R503: 100; R_0603; Tolerance 1%; Digi-Key PN A106047CT-ND
R505: 0; R_0603; Tolerance 1%; Digi-Key PN 311-0.0GRCT-ND
R506: 1k; R_0603; Tolerance 1%; Digi-Key PN RMCF0603FT1K00CT-ND
SW501: MRST; SW_PUSH_6mm

Connections:
+3V3: C501.1, J501.2, R504.1, SW501.1; also elsewhere on the board
GND: C501.2, C502.2, J501.3, Q501.2 (S), R502.2; also elsewhere on the board
ICSPCLK: J501.5; also elsewhere on the board
ICSPDAT: J501.4; also elsewhere on the board
unnamed: C502.1, R505.2
unnamed: Q501.1 (G), R501.2, R502.1
unnamed: Q501.3 (D), R503.2
unnamed: R501.1, SW501.2
unnamed: R503.1, R504.2, R505.1, R506.2
~MCLR: J501.1, R506.1; also elsewhere on the board

Notes on the sheet:
05. Microcontroller Programming

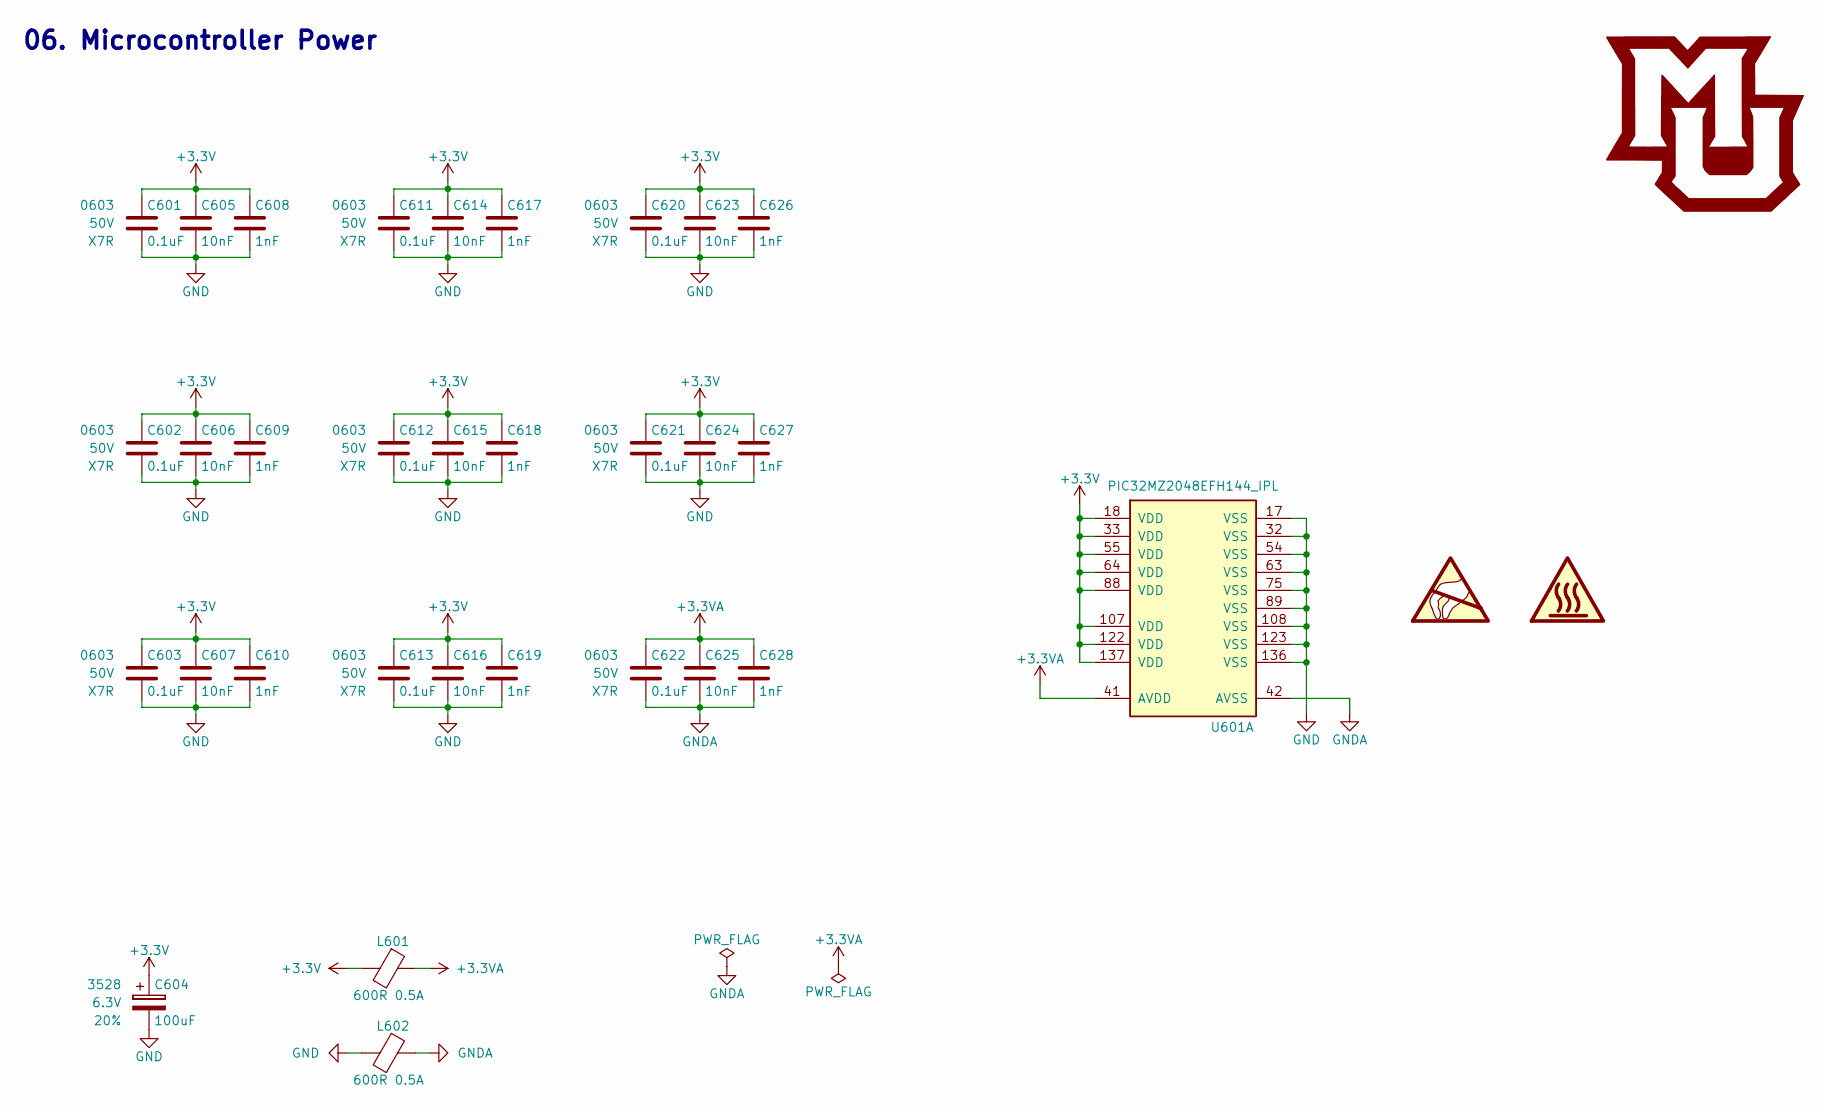
[picture p67: schematic Microcontroller_Power.sch, Electronic Display Logic Board]

Parts:
C601, C602, C603, C611, C612, C613, C620, C621, C622: 0.1uF; C_0603; Voltage 50V; Digi-Key PN 311-1344-1-ND
C604: 100uF; CP_Tantalum_Case-B_EIA-3528-21_Reflow; Voltage 6.3V; Tolerance 20%; Digi-Key PN 478-3130-1-ND
C605, C606, C607, C614, C615, C616, C623, C624, C625: 10nF; C_0603; Voltage 50V; Digi-Key PN 1276-1921-1-ND
C608, C609, C610, C617, C618, C619, C626, C627, C628: 1nF; C_0603; Voltage 50V; Digi-Key PN 1276-1018-1-ND
L601, L602: 600R 0.5A; L_0603; Digi-Key PN 732-2389-1-ND
U601: PIC32MZ2048EFH144_IPL; TQFP-144_20x20mm_Pitch0.5mm; Digi-Key PN PIC32MZ2048EFH144-I/PL-ND

Connections:
+3.3VA: C622.1, C625.1, C628.1, L601.1, U601.41 (AVDD)
+3V3: C601.1, C602.1, C603.1, C604.1, C605.1, C606.1, C607.1, C608.1, C609.1, C610.1, C611.1, C612.1, C613.1, C614.1, C615.1, C616.1, C617.1, C618.1, C619.1, C620.1, C621.1, C623.1, C624.1, C626.1, C627.1, L601.2, U601.18 (VDD), U601.33 (VDD), U601.55 (VDD), U601.64 (VDD), U601.88 (VDD), U601.107 (VDD), U601.122 (VDD), U601.137 (VDD); also elsewhere on the board
GND: C601.2, C602.2, C603.2, C604.2, C605.2, C606.2, C607.2, C608.2, C609.2, C610.2, C611.2, C612.2, C613.2, C614.2, C615.2, C616.2, C617.2, C618.2, C619.2, C620.2, C621.2, C623.2, C624.2, C626.2, C627.2, L602.2, U601.17 (VSS), U601.32 (VSS), U601.54 (VSS), U601.63 (VSS), U601.75 (VSS), U601.89 (VSS), U601.108 (VSS), U601.123 (VSS), U601.136 (VSS); also elsewhere on the board
GNDA: C622.2, C625.2, C628.2, L602.1, U601.42 (AVSS)

Notes on the sheet:
06. Microcontroller Power

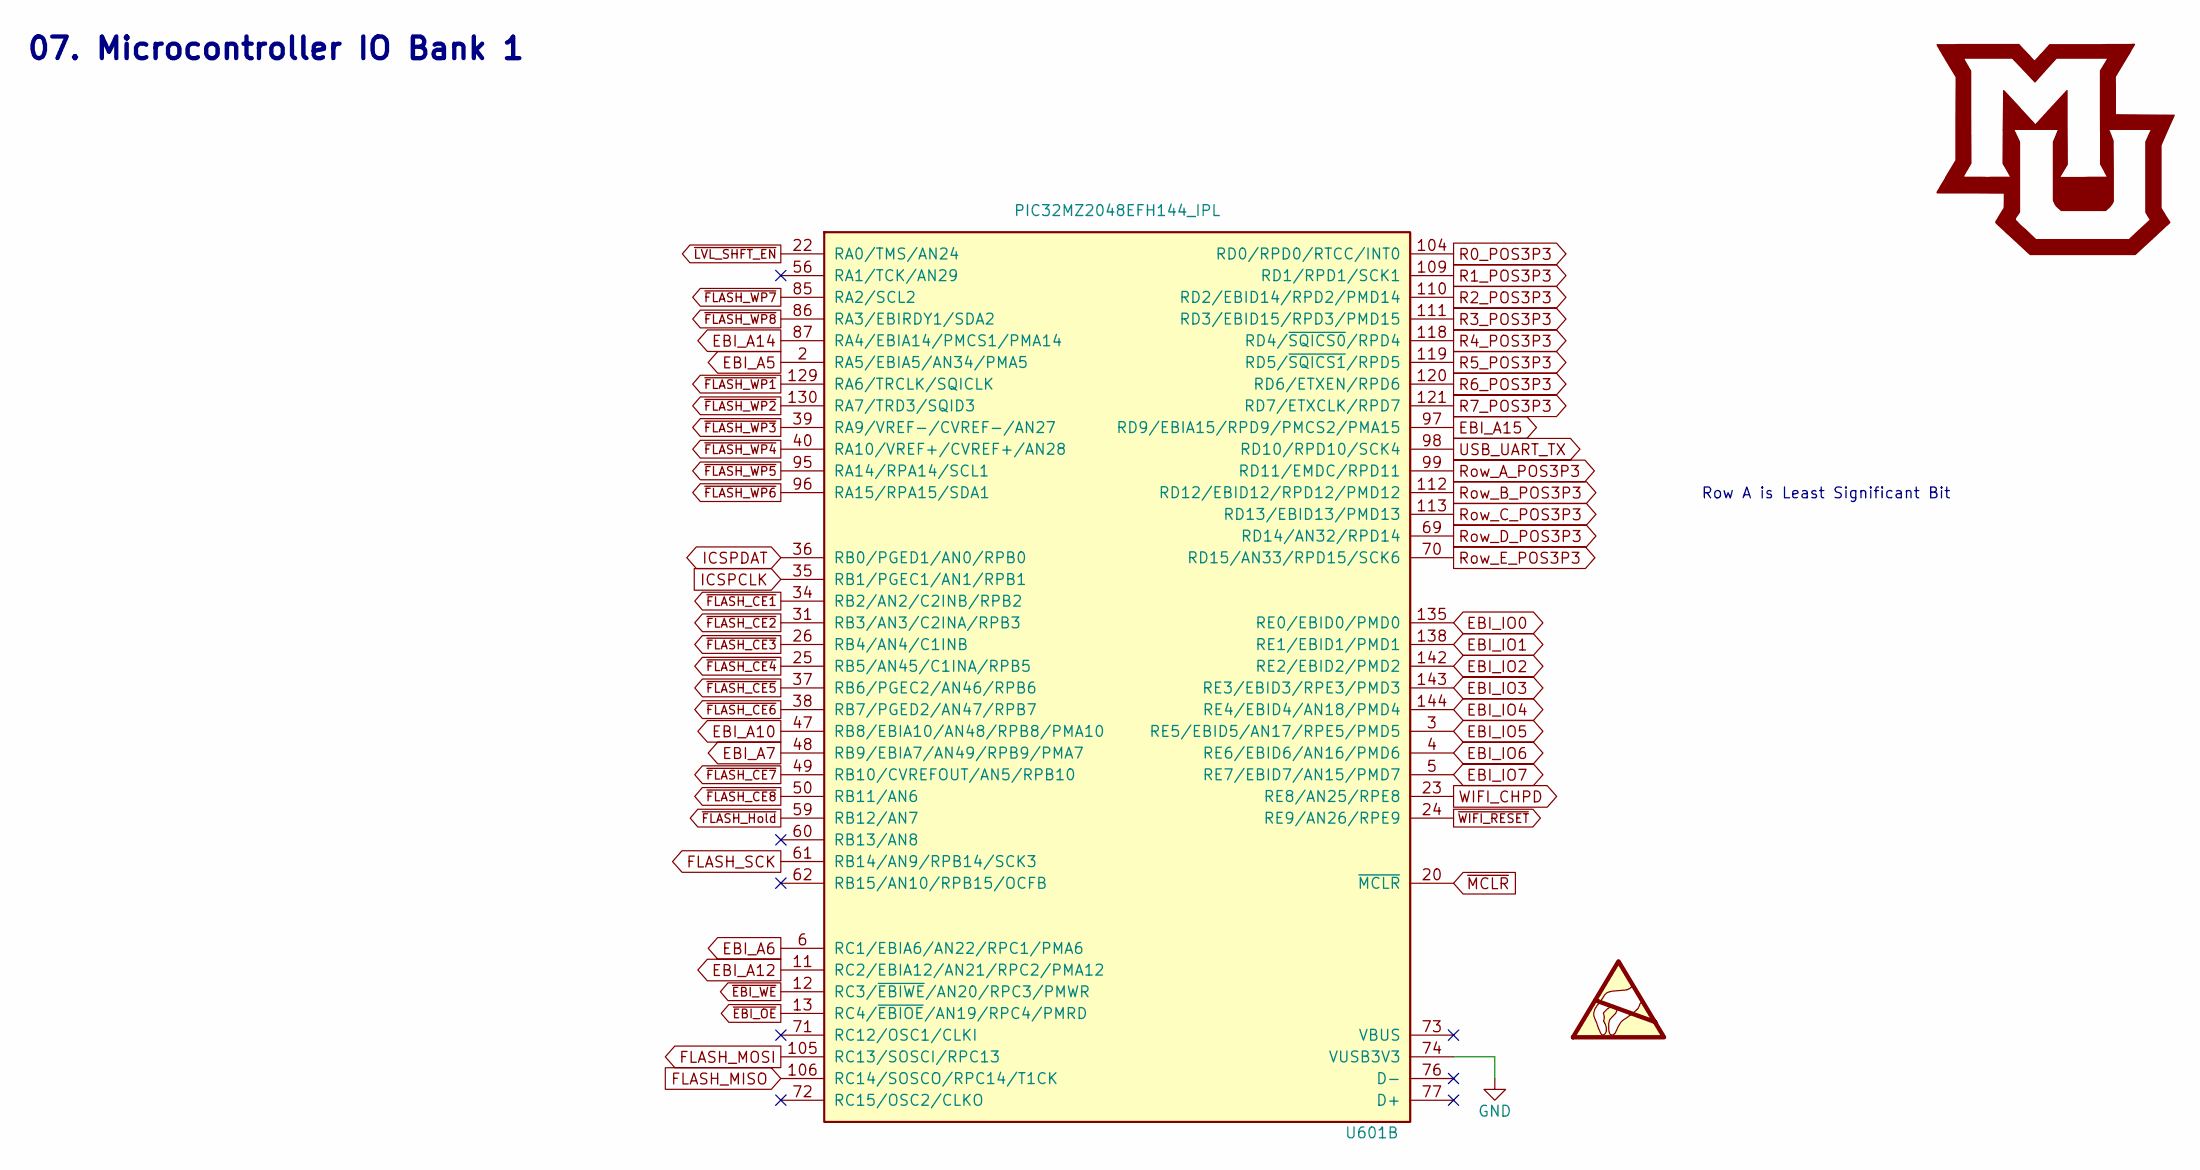
[picture p68: schematic Microcontroller_1.sch, Electronic Display Logic Board]

Parts:
U601: PIC32MZ2048EFH144_IPL; TQFP-144_20x20mm_Pitch0.5mm; Digi-Key PN PIC32MZ2048EFH144-I/PL-ND

Connections:
EBI_A5: U601.2 (RA5/EBIA5/AN34/PMA5); also elsewhere on the board
EBI_A6: U601.6 (RC1/EBIA6/AN22/RPC1/PMA6); also elsewhere on the board
EBI_A7: U601.48 (RB9/EBIA7/AN49/RPB9/PMA7); also elsewhere on the board
EBI_A10: U601.47 (RB8/EBIA10/AN48/RPB8/PMA10); also elsewhere on the board
EBI_A12: U601.11 (RC2/EBIA12/AN21/RPC2/PMA12); also elsewhere on the board
EBI_A14: U601.87 (RA4/EBIA14/PMCS1/PMA14); also elsewhere on the board
EBI_A15: U601.97 (RD9/EBIA15/RPD9/PMCS2/PMA15); also elsewhere on the board
EBI_IO0: U601.135 (RE0/EBID0/PMD0); also elsewhere on the board
EBI_IO1: U601.138 (RE1/EBID1/PMD1); also elsewhere on the board
EBI_IO2: U601.142 (RE2/EBID2/PMD2); also elsewhere on the board
EBI_IO3: U601.143 (RE3/EBID3/RPE3/PMD3); also elsewhere on the board
EBI_IO4: U601.144 (RE4/EBID4/AN18/PMD4); also elsewhere on the board
EBI_IO5: U601.3 (RE5/EBID5/AN17/RPE5/PMD5); also elsewhere on the board
EBI_IO6: U601.4 (RE6/EBID6/AN16/PMD6); also elsewhere on the board
EBI_IO7: U601.5 (RE7/EBID7/AN15/PMD7); also elsewhere on the board
FLASH_MISO: U601.106 (RC14/SOSCO/RPC14/T1CK); also elsewhere on the board
FLASH_MOSI: U601.105 (RC13/SOSCI/RPC13); also elsewhere on the board
FLASH_SCK: U601.61 (RB14/AN9/RPB14/SCK3); also elsewhere on the board
GND: U601.74 (VUSB3V3); also elsewhere on the board
ICSPCLK: U601.35 (RB1/PGEC1/AN1/RPB1); also elsewhere on the board
ICSPDAT: U601.36 (RB0/PGED1/AN0/RPB0); also elsewhere on the board
R0_POS3P3: U601.104 (RD0/RPD0/RTCC/INT0); also elsewhere on the board
R1_POS3P3: U601.109 (RD1/RPD1/SCK1); also elsewhere on the board
R2_POS3P3: U601.110 (RD2/EBID14/RPD2/PMD14); also elsewhere on the board
R3_POS3P3: U601.111 (RD3/EBID15/RPD3/PMD15); also elsewhere on the board
R4_POS3P3: U601.118 (RD4/~SQICS0~/RPD4); also elsewhere on the board
R5_POS3P3: U601.119 (RD5/~SQICS1~/RPD5); also elsewhere on the board
R6_POS3P3: U601.120 (RD6/ETXEN/RPD6); also elsewhere on the board
R7_POS3P3: U601.121 (RD7/ETXCLK/RPD7); also elsewhere on the board
Row_A_POS3P3: U601.99 (RD11/EMDC/RPD11); also elsewhere on the board
Row_B_POS3P3: U601.112 (RD12/EBID12/RPD12/PMD12); also elsewhere on the board
Row_C_POS3P3: U601.113 (RD13/EBID13/PMD13); also elsewhere on the board
Row_D_POS3P3: U601.69 (RD14/AN32/RPD14); also elsewhere on the board
Row_E_POS3P3: U601.70 (RD15/AN33/RPD15/SCK6); also elsewhere on the board
USB_UART_TX: U601.98 (RD10/RPD10/SCK4); also elsewhere on the board
WIFI_CHPD: U601.23 (RE8/AN25/RPE8); also elsewhere on the board
~EBI_OE: U601.13 (RC4/~EBIOE~/AN19/RPC4/PMRD); also elsewhere on the board
~EBI_WE: U601.12 (RC3/~EBIWE~/AN20/RPC3/PMWR); also elsewhere on the board
~FLASH_CE1: U601.34 (RB2/AN2/C2INB/RPB2); also elsewhere on the board
~FLASH_CE2: U601.31 (RB3/AN3/C2INA/RPB3); also elsewhere on the board
~FLASH_CE3: U601.26 (RB4/AN4/C1INB); also elsewhere on the board
~FLASH_CE4: U601.25 (RB5/AN45/C1INA/RPB5); also elsewhere on the board
~FLASH_CE5: U601.37 (RB6/PGEC2/AN46/RPB6); also elsewhere on the board
~FLASH_CE6: U601.38 (RB7/PGED2/AN47/RPB7); also elsewhere on the board
~FLASH_CE7: U601.49 (RB10/CVREFOUT/AN5/RPB10); also elsewhere on the board
~FLASH_CE8: U601.50 (RB11/AN6); also elsewhere on the board
~FLASH_Hold: U601.59 (RB12/AN7); also elsewhere on the board
~FLASH_WP1: U601.129 (RA6/TRCLK/SQICLK); also elsewhere on the board
~FLASH_WP2: U601.130 (RA7/TRD3/SQID3); also elsewhere on the board
~FLASH_WP3: U601.39 (RA9/VREF-/CVREF-/AN27); also elsewhere on the board
~FLASH_WP4: U601.40 (RA10/VREF+/CVREF+/AN28); also elsewhere on the board
~FLASH_WP5: U601.95 (RA14/RPA14/SCL1); also elsewhere on the board
~FLASH_WP6: U601.96 (RA15/RPA15/SDA1); also elsewhere on the board
~FLASH_WP7: U601.85 (RA2/SCL2); also elsewhere on the board
~FLASH_WP8: U601.86 (RA3/EBIRDY1/SDA2); also elsewhere on the board
~LVL_SHFT_EN: U601.22 (RA0/TMS/AN24); also elsewhere on the board
~MCLR: U601.20 (~MCLR~); also elsewhere on the board
~WIFI_RESET: U601.24 (RE9/AN26/RPE9); also elsewhere on the board

Notes on the sheet:
07. Microcontroller IO Bank 1
Row A is Least Significant Bit
