drewsum/Electronic_Display/hdw/Logic_Board/LED_Display_Controller/LED_Display_Controller.kicad_pcb

## KiCad design hdw/Logic_Board/LED_Display_Controller/LED_Display_Controller.kicad_pcb (continued)

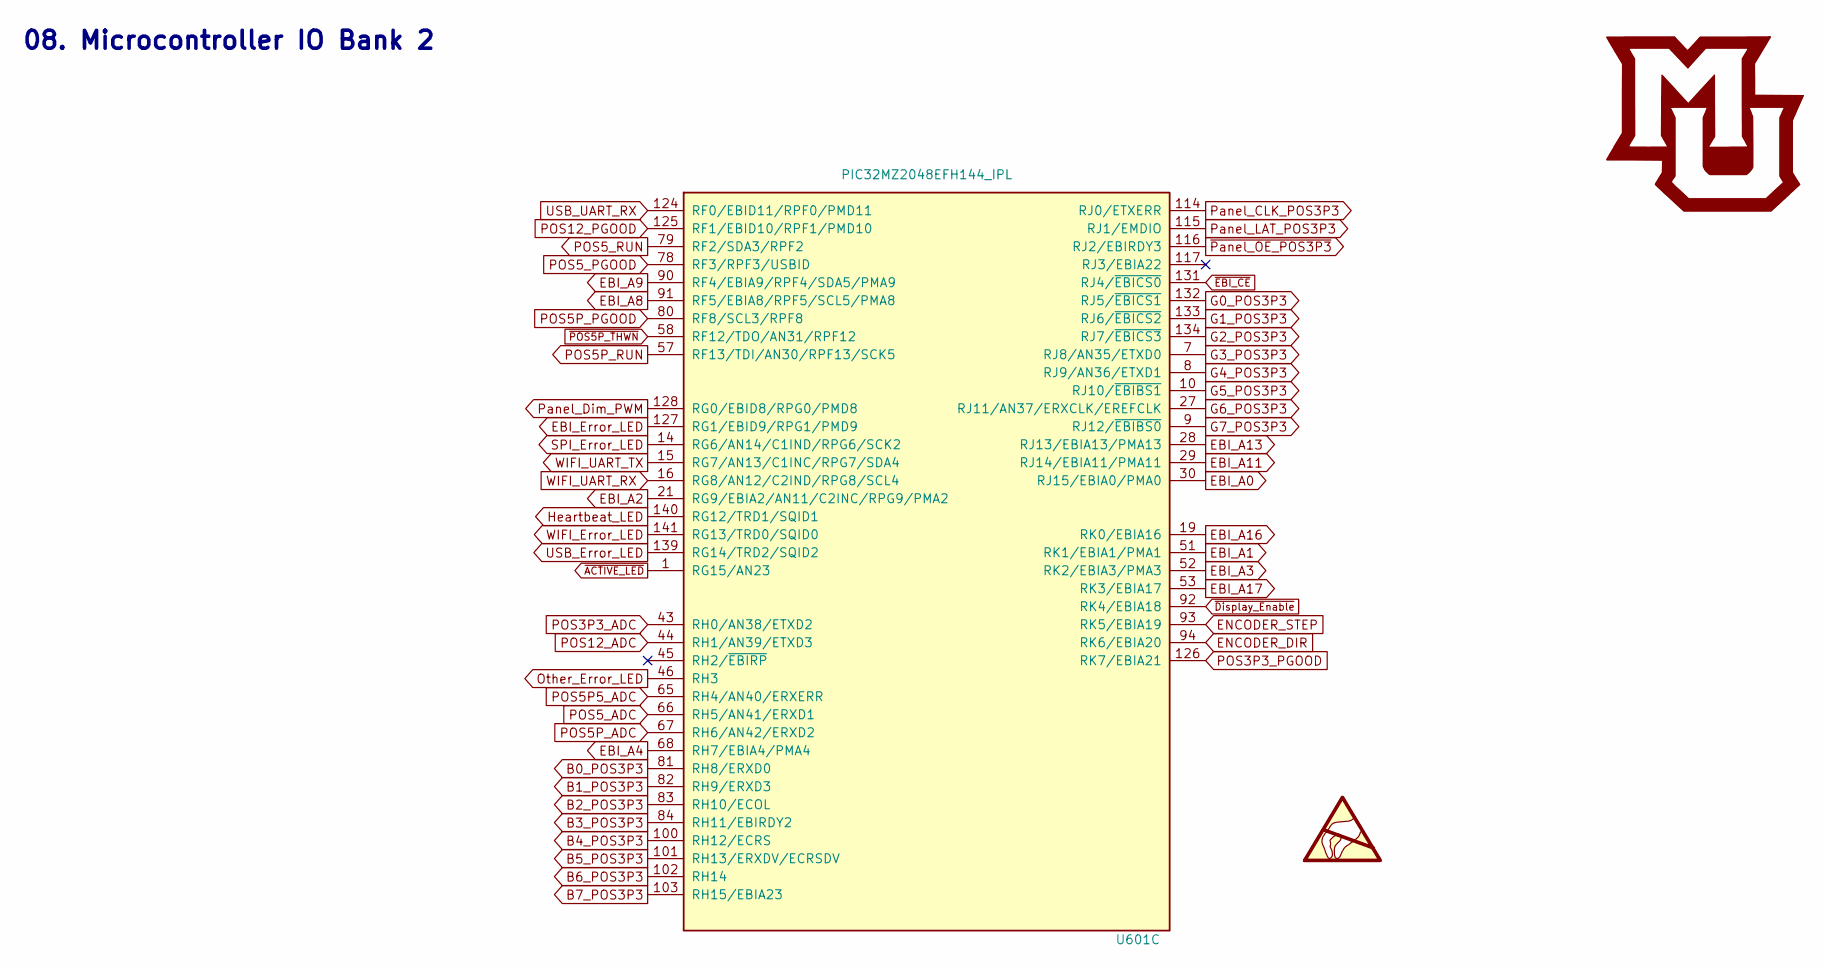
[picture p69: schematic Microcontroller_2.sch, Electronic Display Logic Board]

Parts:
U601: PIC32MZ2048EFH144_IPL; TQFP-144_20x20mm_Pitch0.5mm; Digi-Key PN PIC32MZ2048EFH144-I/PL-ND

Connections:
B0_POS3P3: U601.81 (RH8/ERXD0); also elsewhere on the board
B1_POS3P3: U601.82 (RH9/ERXD3); also elsewhere on the board
B2_POS3P3: U601.83 (RH10/ECOL); also elsewhere on the board
B3_POS3P3: U601.84 (RH11/EBIRDY2); also elsewhere on the board
B4_POS3P3: U601.100 (RH12/ECRS); also elsewhere on the board
B5_POS3P3: U601.101 (RH13/ERXDV/ECRSDV); also elsewhere on the board
B6_POS3P3: U601.102 (RH14); also elsewhere on the board
B7_POS3P3: U601.103 (RH15/EBIA23); also elsewhere on the board
EBI_A0: U601.30 (RJ15/EBIA0/PMA0); also elsewhere on the board
EBI_A1: U601.51 (RK1/EBIA1/PMA1); also elsewhere on the board
EBI_A2: U601.21 (RG9/EBIA2/AN11/C2INC/RPG9/PMA2); also elsewhere on the board
EBI_A3: U601.52 (RK2/EBIA3/PMA3); also elsewhere on the board
EBI_A4: U601.68 (RH7/EBIA4/PMA4); also elsewhere on the board
EBI_A8: U601.91 (RF5/EBIA8/RPF5/SCL5/PMA8); also elsewhere on the board
EBI_A9: U601.90 (RF4/EBIA9/RPF4/SDA5/PMA9); also elsewhere on the board
EBI_A11: U601.29 (RJ14/EBIA11/PMA11); also elsewhere on the board
EBI_A13: U601.28 (RJ13/EBIA13/PMA13); also elsewhere on the board
EBI_A16: U601.19 (RK0/EBIA16); also elsewhere on the board
EBI_A17: U601.53 (RK3/EBIA17); also elsewhere on the board
EBI_Error_LED: U601.127 (RG1/EBID9/RPG1/PMD9); also elsewhere on the board
ENCODER_DIR: U601.94 (RK6/EBIA20); also elsewhere on the board
ENCODER_STEP: U601.93 (RK5/EBIA19); also elsewhere on the board
G0_POS3P3: U601.132 (RJ5/~EBICS1~); also elsewhere on the board
G1_POS3P3: U601.133 (RJ6/~EBICS2~); also elsewhere on the board
G2_POS3P3: U601.134 (RJ7/~EBICS3~); also elsewhere on the board
G3_POS3P3: U601.7 (RJ8/AN35/ETXD0); also elsewhere on the board
G4_POS3P3: U601.8 (RJ9/AN36/ETXD1); also elsewhere on the board
G5_POS3P3: U601.10 (RJ10/~EBIBS1~); also elsewhere on the board
G6_POS3P3: U601.27 (RJ11/AN37/ERXCLK/EREFCLK); also elsewhere on the board
G7_POS3P3: U601.9 (RJ12/~EBIBS0~); also elsewhere on the board
Heartbeat_LED: U601.140 (RG12/TRD1/SQID1); also elsewhere on the board
Other_Error_LED: U601.46 (RH3); also elsewhere on the board
POS3P3_ADC: U601.43 (RH0/AN38/ETXD2); also elsewhere on the board
POS3P3_PGOOD: U601.126 (RK7/EBIA21); also elsewhere on the board
POS5P5_ADC: U601.65 (RH4/AN40/ERXERR); also elsewhere on the board
POS5P_ADC: U601.67 (RH6/AN42/ERXD2); also elsewhere on the board
POS5P_PGOOD: U601.80 (RF8/SCL3/RPF8); also elsewhere on the board
POS5P_RUN: U601.57 (RF13/TDI/AN30/RPF13/SCK5); also elsewhere on the board
POS5_ADC: U601.66 (RH5/AN41/ERXD1); also elsewhere on the board
POS5_PGOOD: U601.78 (RF3/RPF3/USBID); also elsewhere on the board
POS5_RUN: U601.79 (RF2/SDA3/RPF2); also elsewhere on the board
POS12_ADC: U601.44 (RH1/AN39/ETXD3); also elsewhere on the board
POS12_PGOOD: U601.125 (RF1/EBID10/RPF1/PMD10); also elsewhere on the board
Panel_CLK_POS3P3: U601.114 (RJ0/ETXERR); also elsewhere on the board
Panel_Dim_PWM: U601.128 (RG0/EBID8/RPG0/PMD8); also elsewhere on the board
Panel_LAT_POS3P3: U601.115 (RJ1/EMDIO); also elsewhere on the board
SPI_Error_LED: U601.14 (RG6/AN14/C1IND/RPG6/SCK2); also elsewhere on the board
USB_Error_LED: U601.139 (RG14/TRD2/SQID2); also elsewhere on the board
USB_UART_RX: U601.124 (RF0/EBID11/RPF0/PMD11); also elsewhere on the board
WIFI_Error_LED: U601.141 (RG13/TRD0/SQID0); also elsewhere on the board
WIFI_UART_RX: U601.16 (RG8/AN12/C2IND/RPG8/SCL4); also elsewhere on the board
WIFI_UART_TX: U601.15 (RG7/AN13/C1INC/RPG7/SDA4); also elsewhere on the board
~ACTIVE_LED: U601.1 (RG15/AN23); also elsewhere on the board
~Display_Enable: U601.92 (RK4/EBIA18); also elsewhere on the board
~EBI_CE: U601.131 (RJ4/~EBICS0~); also elsewhere on the board
~POS5P_THWN: U601.58 (RF12/TDO/AN31/RPF12); also elsewhere on the board
~Panel_OE_POS3P3: U601.116 (RJ2/EBIRDY3); also elsewhere on the board

Notes on the sheet:
08. Microcontroller IO Bank 2

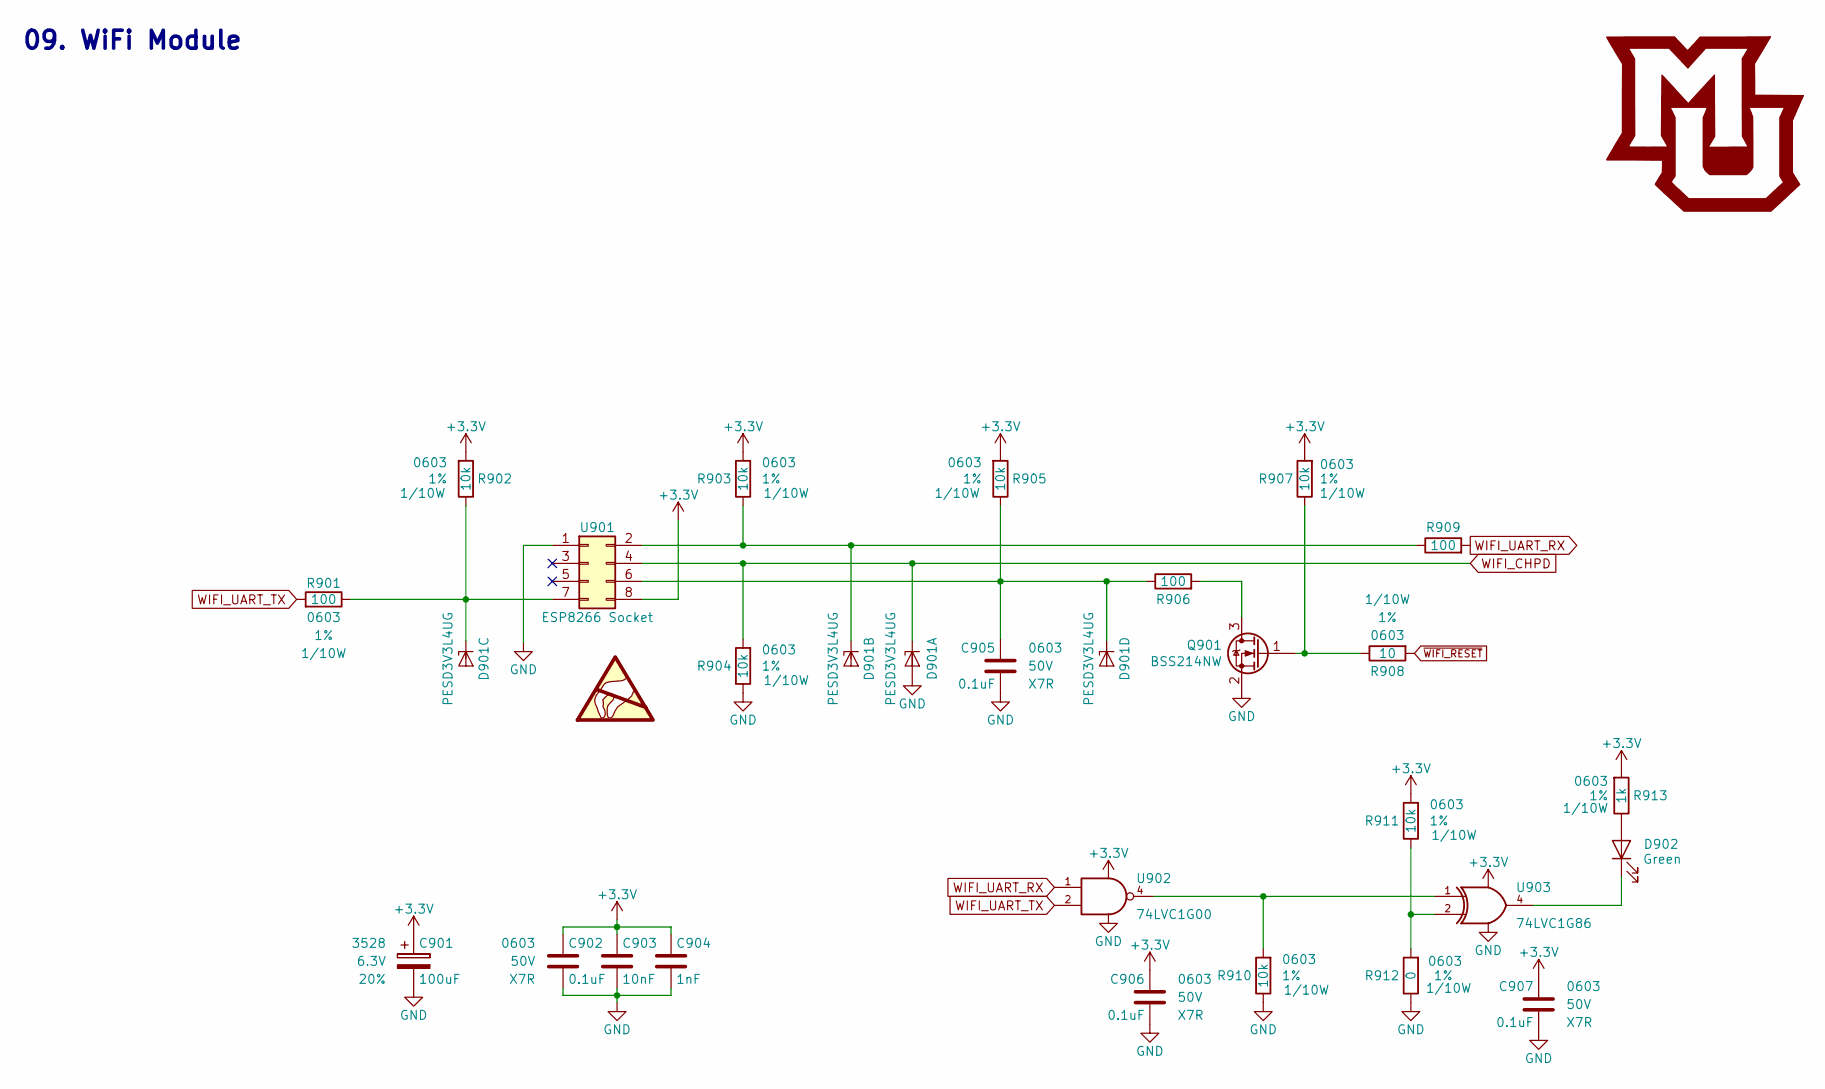
[picture p70: schematic Wi_Fi_Module.sch, Electronic Display Logic Board]

Parts:
C901: 100uF; CP_Tantalum_Case-B_EIA-3528-21_Reflow; Voltage 6.3V; Tolerance 20%; Digi-Key PN 478-3130-1-ND
C902, C905, C906, C907: 0.1uF; C_0603; Voltage 50V; Digi-Key PN 311-1344-1-ND
C903: 10nF; C_0603; Voltage 50V; Digi-Key PN 1276-1921-1-ND
C904: 1nF; C_0603; Voltage 50V; Digi-Key PN 1276-1018-1-ND
D901: PESD3V3L4UG; SOT-353_SC-70-5; Digi-Key PN 1727-3827-1-ND
D902: Green; LED_0603; Digi-Key PN 160-1446-1-ND
Q901: BSS214NW; SOT-323_SC-70; Digi-Key PN BSS214NWH6327XTSA1CT-ND
R901, R906, R909: 100; R_0603; Tolerance 1%; Digi-Key PN A106047CT-ND
R902, R903, R904, R905, R907, R910, R911: 10k; R_0603; Tolerance 1%; Digi-Key PN RMCF0603FT10K0CT-ND
R908: 10; R_0603; Tolerance 1%; Digi-Key PN YAG3351CT-ND
R912: 0; R_0603; Tolerance 1%; Digi-Key PN 311-0.0GRCT-ND
R913: 1k; R_0603; Tolerance 1%; Digi-Key PN RMCF0603FT1K00CT-ND
U901: ESP8266 Socket; ESP8266_Socket
U902: 74LVC1G00; SOT-353_SC-70-5; Digi-Key PN 296-9846-1-ND
U903: 74LVC1G86; SOT-353_SC-70-5; Digi-Key PN 296-9854-1-ND

Connections:
+3V3: C901.1, C902.1, C903.1, C904.1, C906.1, C907.1, R902.1, R903.1, R905.1, R907.1, R911.1, R913.1, U901.8, U902.5 (VCC), U903.5 (VCC); also elsewhere on the board
GND: C901.2, C902.2, C903.2, C904.2, C905.2, C906.2, C907.2, D901.2 (A), Q901.2 (S), R904.2, R910.2, R912.2, U901.1, U902.3 (GND), U903.3 (GND); also elsewhere on the board
unnamed: C905.1, D901.5 (K4), R905.2, R906.2, U901.6
unnamed: D901.3 (K2), R903.2, R909.2, U901.2
unnamed: D901.4 (K3), R901.2, R902.2, U901.7
unnamed: D902.1 (K), U903.4
unnamed: D902.2 (A), R913.2
unnamed: Q901.1 (G), R907.2, R908.2
unnamed: Q901.3 (D), R906.1
unnamed: R910.1, U902.4, U903.1
unnamed: R911.2, R912.1, U903.2
WIFI_CHPD: D901.1 (K1), R904.1, U901.4; also elsewhere on the board
WIFI_UART_RX: R909.1, U902.1; also elsewhere on the board
WIFI_UART_TX: R901.1, U902.2; also elsewhere on the board
~WIFI_RESET: R908.1; also elsewhere on the board

Notes on the sheet:
09. WiFi Module

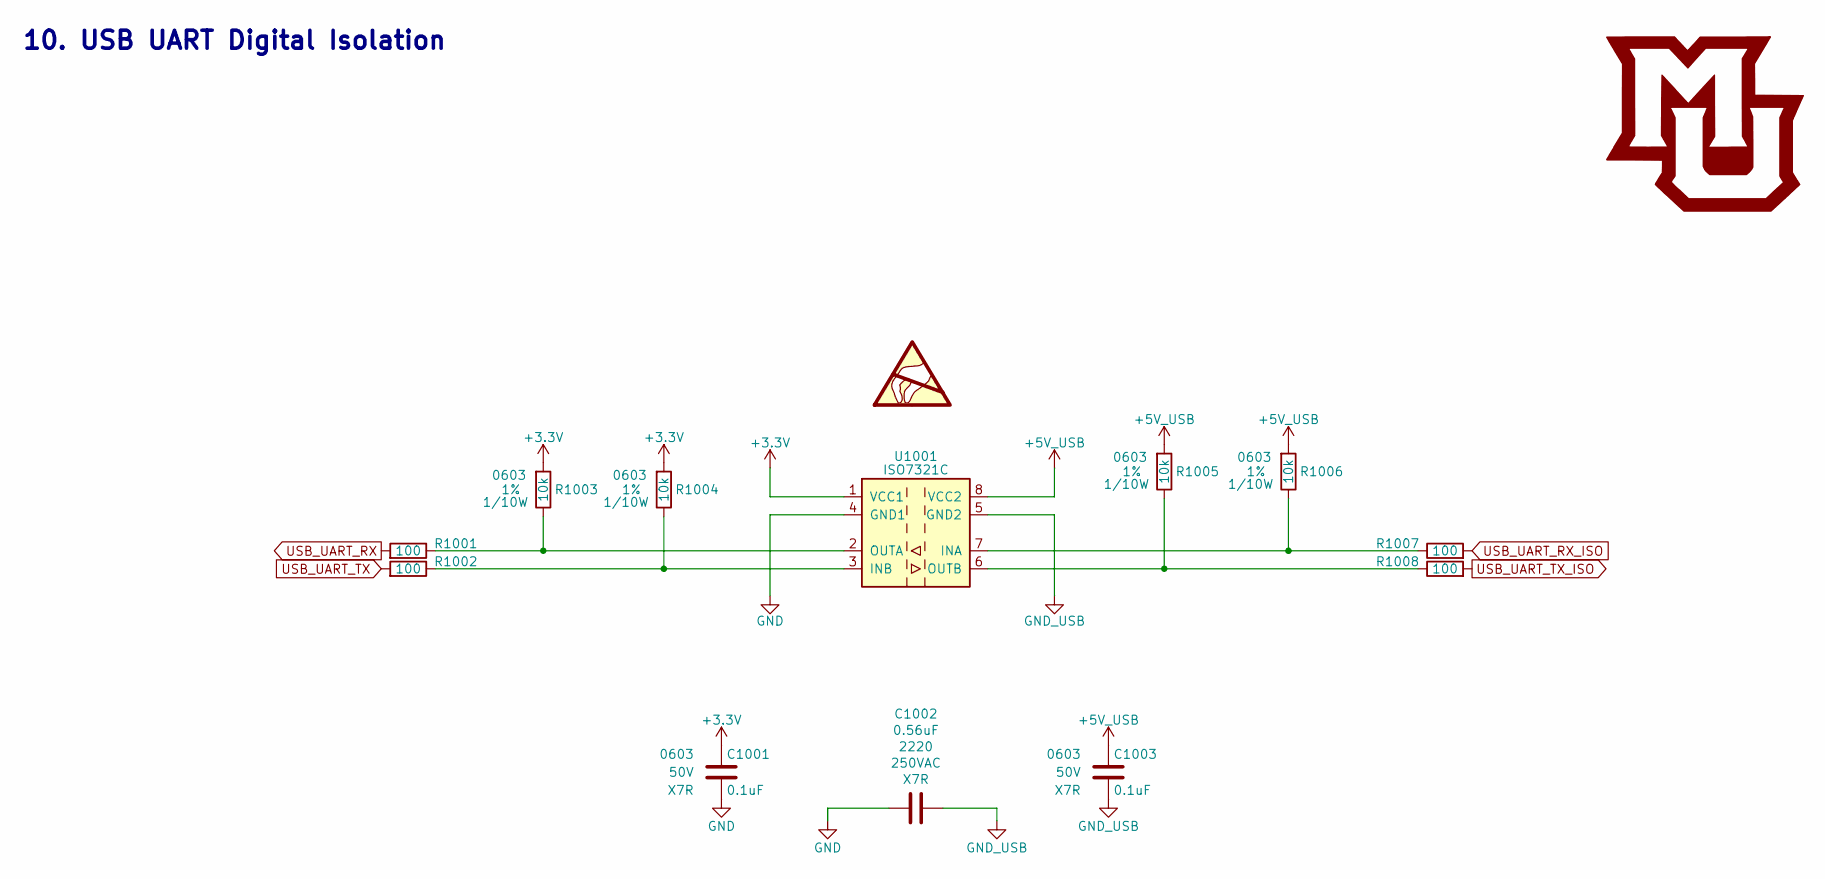
[picture p71: schematic USB_UART_Isolation.sch, Electronic Display Logic Board]

Parts:
C1001, C1003: 0.1uF; C_0603; Voltage 50V; Digi-Key PN 311-1344-1-ND
C1002: 0.56uF; C_2220; Voltage 250VAC; Digi-Key PN 565-4707-1-ND
R1001, R1002, R1007, R1008: 100; R_0603; Tolerance 1%; Digi-Key PN A106047CT-ND
R1003, R1004, R1005, R1006: 10k; R_0603; Tolerance 1%; Digi-Key PN RMCF0603FT10K0CT-ND
U1001: ISO7321C; SOIC-8_3.9x4.9mm_Pitch1.27mm; Digi-Key PN 296-42102-1-ND

Connections:
+3V3: C1001.1, R1003.1, R1004.1, U1001.1 (VCC1); also elsewhere on the board
+5V_USB: C1003.1, R1005.1, R1006.1, U1001.8 (VCC2); also elsewhere on the board
GND: C1001.2, C1002.1, U1001.4 (GND1); also elsewhere on the board
GND_USB: C1002.2, C1003.2, U1001.5 (GND2); also elsewhere on the board
unnamed: R1001.2, R1003.2, U1001.2 (OUTA)
unnamed: R1002.2, R1004.2, U1001.3 (INB)
unnamed: R1005.2, R1008.2, U1001.6 (OUTB)
unnamed: R1006.2, R1007.2, U1001.7 (INA)
USB_UART_RX: R1001.1; also elsewhere on the board
USB_UART_RX_ISO: R1007.1; also elsewhere on the board
USB_UART_TX: R1002.1; also elsewhere on the board
USB_UART_TX_ISO: R1008.1; also elsewhere on the board

Notes on the sheet:
10. USB UART Digital Isolation

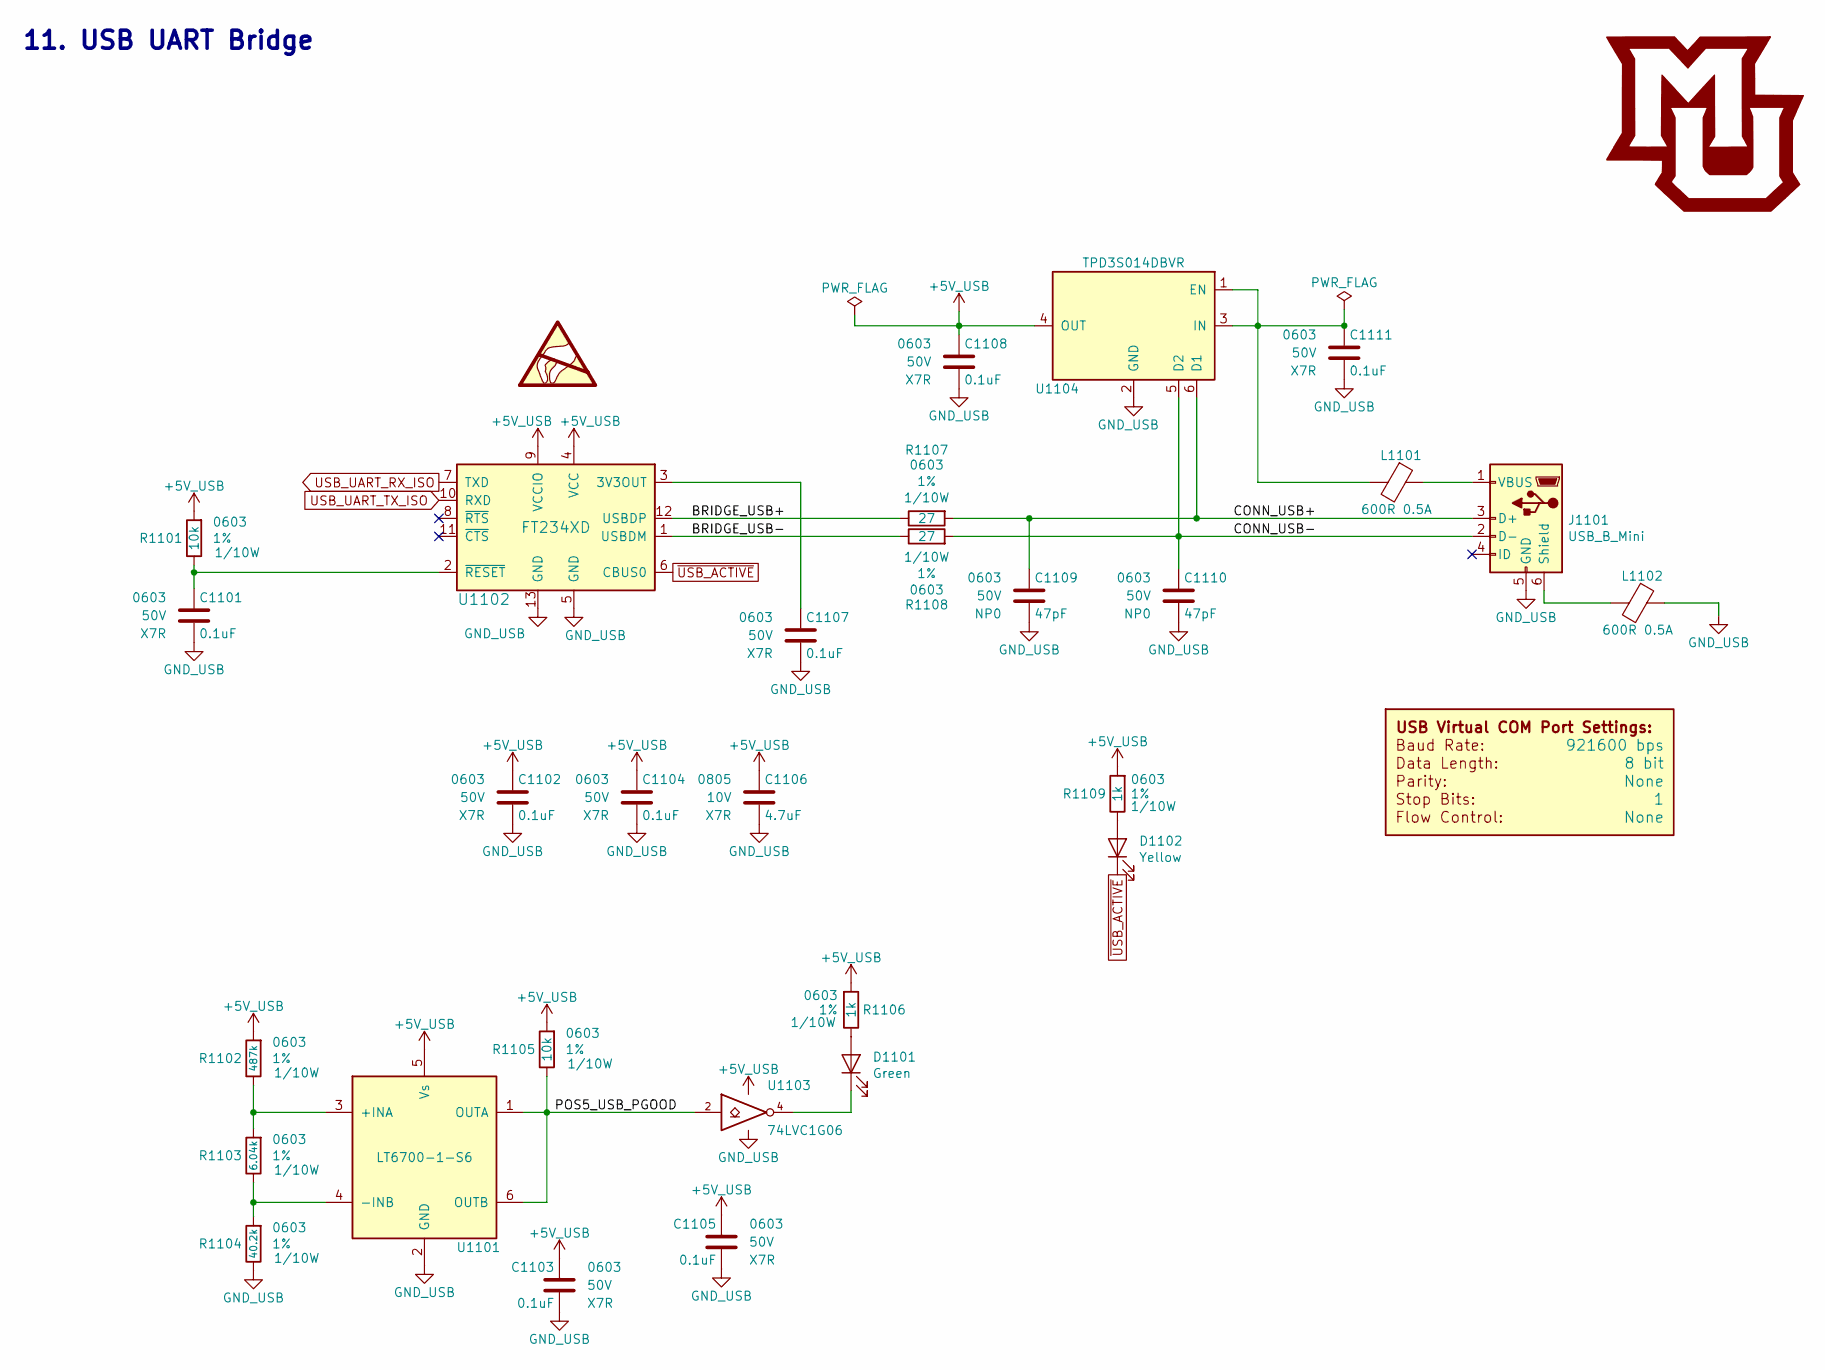
[picture p72: schematic USB_UART_Bridge.sch, Electronic Display Logic Board]

Parts:
C1101, C1102, C1103, C1104, C1105, C1107, C1108, C1111: 0.1uF; C_0603; Voltage 50V; Digi-Key PN 311-1344-1-ND
C1106: 4.7uF; C_0805; Voltage 10V; Digi-Key PN 1276-2972-1-ND
C1109, C1110: 47pF; C_0603; Voltage 50V; Digi-Key PN 478-1171-1-ND
D1101: Green; LED_0603; Digi-Key PN 160-1446-1-ND
D1102: Yellow; LED_0603; Digi-Key PN 160-1448-1-ND
DOC1101: COM_Port_Settings
J1101: USB_B_Mini; USB_Mini-B; Digi-Key PN 732-2109-1-ND
L1101, L1102: 600R 0.5A; L_0603; Digi-Key PN 732-2389-1-ND
R1101, R1105: 10k; R_0603; Tolerance 1%; Digi-Key PN RMCF0603FT10K0CT-ND
R1102: 487k; R_0603; Tolerance 1%; Digi-Key PN 311-487KHRCT-ND
R1103: 6.04k; R_0603; Tolerance 1%; Digi-Key PN RMCF0603FT6K04CT-ND
R1104: 40.2k; R_0603; Tolerance 1%; Digi-Key PN 311-40.2KHRCT-ND
R1106, R1109: 1k; R_0603; Tolerance 1%; Digi-Key PN RMCF0603FT1K00CT-ND
R1107, R1108: 27; R_0603; Tolerance 1%; Digi-Key PN RMCF0603FT27R0CT-ND
U1101: LT6700-1-S6; TSOT-23-6; Digi-Key PN LT6700CS6-1#TRMPBFCT-ND
U1102: FT234XD; DFN-12-1EP_3x3mm_Pitch0.45mm; Digi-Key PN 768-1178-1-ND
U1103: 74LVC1G06; SOT-353_SC-70-5; Digi-Key PN 296-8484-1-ND
U1104: TPD3S014DBVR; SOT-23-6; Digi-Key PN 296-38835-1-ND

Connections:
+5V_USB: C1102.1, C1103.1, C1104.1, C1105.1, C1106.1, C1108.1, R1101.1, R1102.1, R1105.1, R1106.1, R1109.1, U1101.5 (Vs), U1102.4 (VCC), U1102.9 (VCCIO), U1103.5 (VCC), U1104.4 (OUT); also elsewhere on the board
/USB UART Bridge/BRIDGE_USB+: R1107.2, U1102.12 (USBDP)
/USB UART Bridge/BRIDGE_USB-: R1108.2, U1102.1 (USBDM)
/USB UART Bridge/CONN_USB+: C1109.1, J1101.3 (D+), R1107.1, U1104.6 (D1)
/USB UART Bridge/CONN_USB-: C1110.1, J1101.2 (D-), R1108.1, U1104.5 (D2)
/USB UART Bridge/POS5_USB_PGOOD: R1105.2, U1101.1 (OUTA), U1101.6 (OUTB), U1103.2
GND_USB: C1101.2, C1102.2, C1103.2, C1104.2, C1105.2, C1106.2, C1107.2, C1108.2, C1109.2, C1110.2, C1111.2, J1101.5 (GND), L1102.1, R1104.2, U1101.2 (GND), U1102.5 (GND), U1102.13 (GND), U1103.3 (GND), U1104.2 (GND); also elsewhere on the board
unnamed: C1101.1, R1101.2, U1102.2 (~RESET)
unnamed: C1107.1, U1102.3 (3V3OUT)
unnamed: C1111.1, L1101.2, U1104.1 (EN), U1104.3 (IN)
unnamed: D1101.1 (K), U1103.4
unnamed: D1101.2 (A), R1106.2
unnamed: D1102.2 (A), R1109.2
unnamed: J1101.1 (VBUS), L1101.1
unnamed: J1101.6 (Shield), L1102.2
unnamed: R1102.2, R1103.1, U1101.3 (+INA)
unnamed: R1103.2, R1104.1, U1101.4 (-INB)
USB_UART_RX_ISO: U1102.7 (TXD); also elsewhere on the board
USB_UART_TX_ISO: U1102.10 (RXD); also elsewhere on the board
~USB_ACTIVE: D1102.1 (K), U1102.6 (CBUS0)

Notes on the sheet:
11. USB UART Bridge

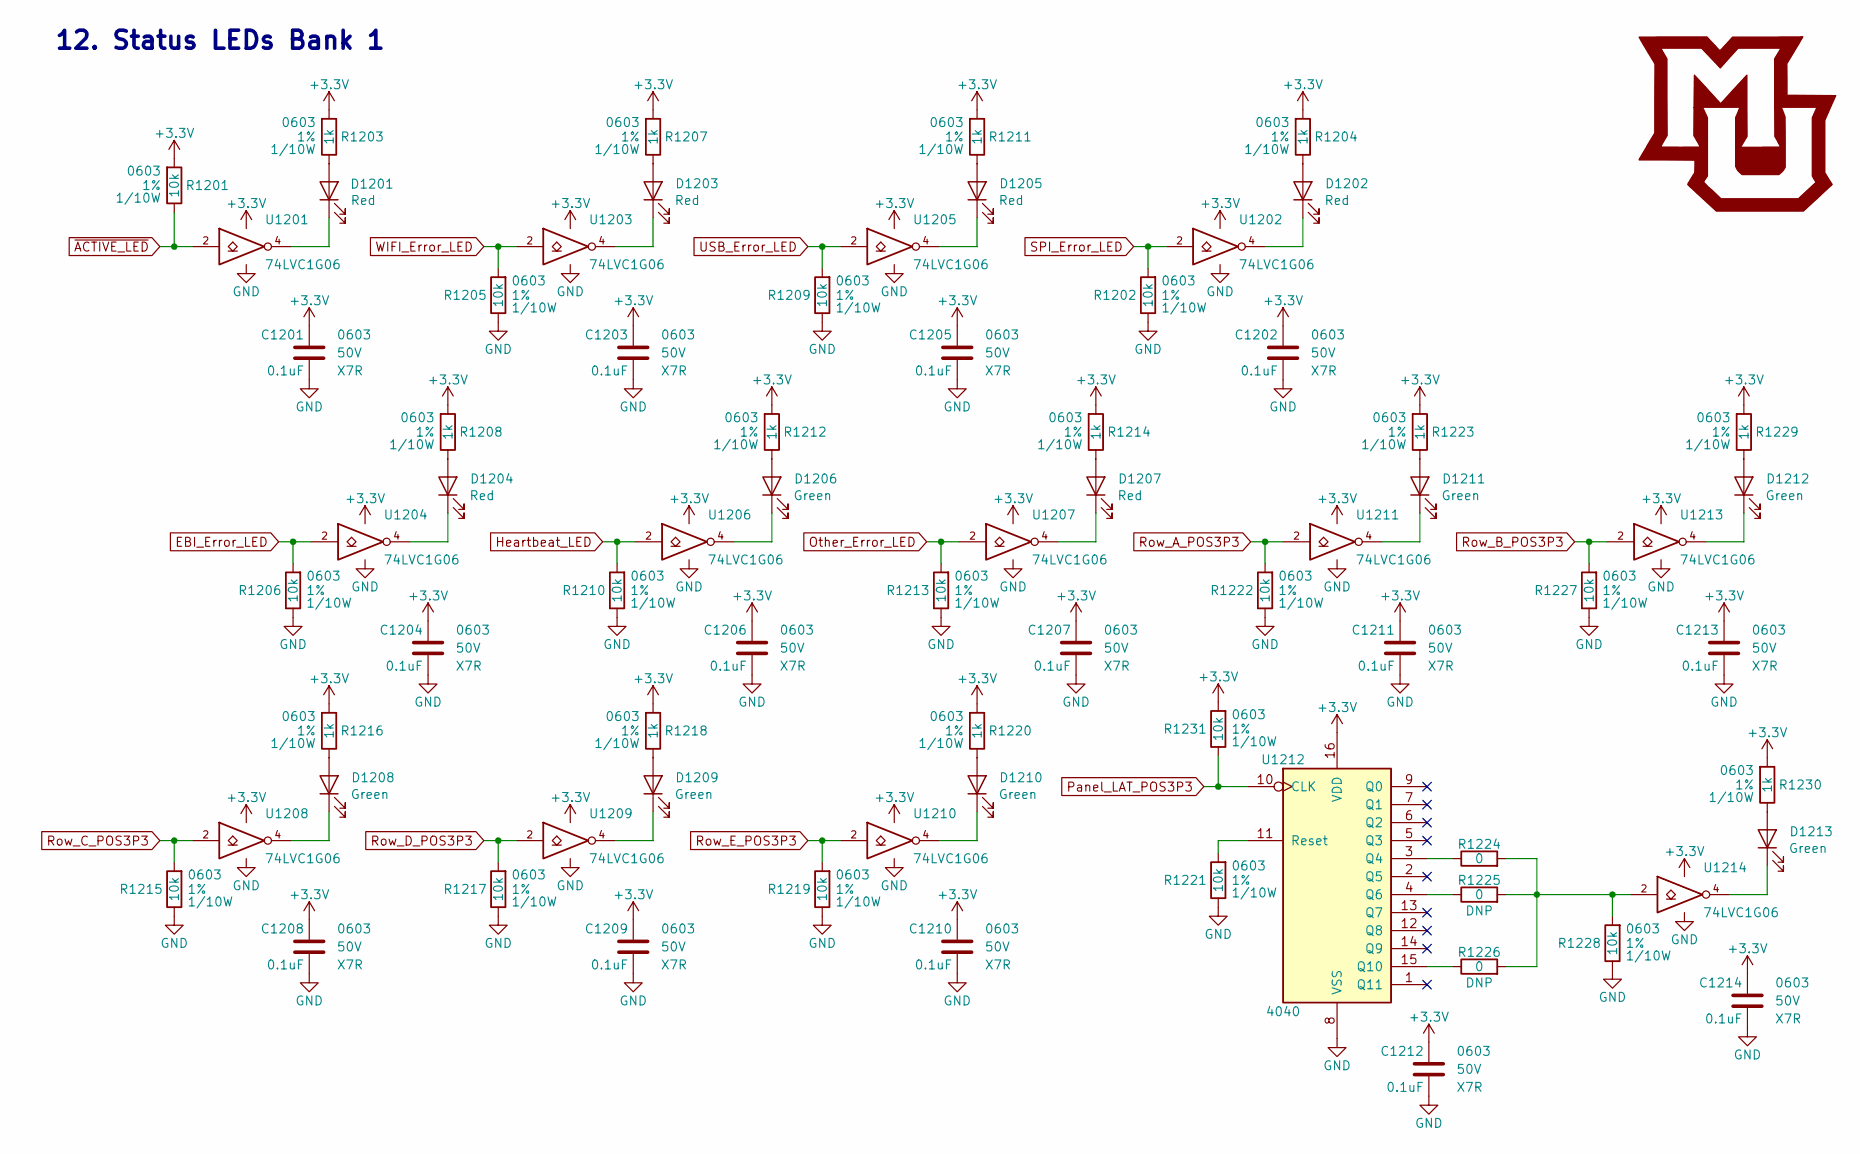
[picture p73: schematic Status_LEDs_1.sch, Electronic Display Logic Board]

Parts:
C1201, C1202, C1203, C1204, C1205, C1206, C1207, C1208, C1209, C1210, C1211, C1212, C1213, C1214: 0.1uF; C_0603; Voltage 50V; Digi-Key PN 311-1344-1-ND
D1201, D1202, D1203, D1204, D1205, D1207: Red; LED_0603; Digi-Key PN 160-1447-1-ND
D1206, D1208, D1209, D1210, D1211, D1212, D1213: Green; LED_0603; Digi-Key PN 160-1446-1-ND
R1201, R1202, R1205, R1206, R1209, R1210, R1213, R1215, R1217, R1219, R1221, R1222, R1227, R1228, R1231: 10k; R_0603; Tolerance 1%; Digi-Key PN RMCF0603FT10K0CT-ND
R1203, R1204, R1207, R1208, R1211, R1212, R1214, R1216, R1218, R1220, R1223, R1229, R1230: 1k; R_0603; Tolerance 1%; Digi-Key PN RMCF0603FT1K00CT-ND
R1224, R1225, R1226: 0; R_0603; Tolerance 1%; Digi-Key PN 311-0.0GRCT-ND
U1201, U1202, U1203, U1204, U1205, U1206, U1207, U1208, U1209, U1210, U1211, U1213, U1214: 74LVC1G06; SOT-353_SC-70-5; Digi-Key PN 296-8484-1-ND
U1212: 4040; TSSOP-16_4.4x5mm_Pitch0.65mm; Digi-Key PN 296-12761-1-ND

Connections:
+3V3: C1201.1, C1202.1, C1203.1, C1204.1, C1205.1, C1206.1, C1207.1, C1208.1, C1209.1, C1210.1, C1211.1, C1212.1, C1213.1, C1214.1, R1201.1, R1203.1, R1204.1, R1207.1, R1208.1, R1211.1, R1212.1, R1214.1, R1216.1, R1218.1, R1220.1, R1223.1, R1229.1, R1230.1, R1231.1, U1201.5 (VCC), U1202.5 (VCC), U1203.5 (VCC), U1204.5 (VCC), U1205.5 (VCC), U1206.5 (VCC), U1207.5 (VCC), U1208.5 (VCC), U1209.5 (VCC), U1210.5 (VCC), U1211.5 (VCC), U1212.16 (VDD), U1213.5 (VCC), U1214.5 (VCC); also elsewhere on the board
EBI_Error_LED: R1206.1, U1204.2; also elsewhere on the board
GND: C1201.2, C1202.2, C1203.2, C1204.2, C1205.2, C1206.2, C1207.2, C1208.2, C1209.2, C1210.2, C1211.2, C1212.2, C1213.2, C1214.2, R1202.2, R1205.2, R1206.2, R1209.2, R1210.2, R1213.2, R1215.2, R1217.2, R1219.2, R1221.2, R1222.2, R1227.2, R1228.2, U1201.3 (GND), U1202.3 (GND), U1203.3 (GND), U1204.3 (GND), U1205.3 (GND), U1206.3 (GND), U1207.3 (GND), U1208.3 (GND), U1209.3 (GND), U1210.3 (GND), U1211.3 (GND), U1212.8 (VSS), U1213.3 (GND), U1214.3 (GND); also elsewhere on the board
Heartbeat_LED: R1210.1, U1206.2; also elsewhere on the board
unnamed: D1201.1 (K), U1201.4
unnamed: D1201.2 (A), R1203.2
unnamed: D1202.1 (K), U1202.4
unnamed: D1202.2 (A), R1204.2
unnamed: D1203.1 (K), U1203.4
unnamed: D1203.2 (A), R1207.2
unnamed: D1204.1 (K), U1204.4
unnamed: D1204.2 (A), R1208.2
unnamed: D1205.1 (K), U1205.4
unnamed: D1205.2 (A), R1211.2
unnamed: D1206.1 (K), U1206.4
unnamed: D1206.2 (A), R1212.2
unnamed: D1207.1 (K), U1207.4
unnamed: D1207.2 (A), R1214.2
unnamed: D1208.1 (K), U1208.4
unnamed: D1208.2 (A), R1216.2
unnamed: D1209.1 (K), U1209.4
unnamed: D1209.2 (A), R1218.2
unnamed: D1210.1 (K), U1210.4
unnamed: D1210.2 (A), R1220.2
unnamed: D1211.1 (K), U1211.4
unnamed: D1211.2 (A), R1223.2
unnamed: D1212.1 (K), U1213.4
unnamed: D1212.2 (A), R1229.2
unnamed: D1213.1 (K), U1214.4
unnamed: D1213.2 (A), R1230.2
unnamed: R1221.1, U1212.11 (Reset)
unnamed: R1224.1, R1225.1, R1226.1, R1228.1, U1214.2
unnamed: R1224.2, U1212.3 (Q4)
unnamed: R1225.2, U1212.4 (Q6)
unnamed: R1226.2, U1212.15 (Q10)
Other_Error_LED: R1213.1, U1207.2; also elsewhere on the board
Panel_LAT_POS3P3: R1231.2, U1212.10 (CLK); also elsewhere on the board
Row_A_POS3P3: R1222.1, U1211.2; also elsewhere on the board
Row_B_POS3P3: R1227.1, U1213.2; also elsewhere on the board
Row_C_POS3P3: R1215.1, U1208.2; also elsewhere on the board
Row_D_POS3P3: R1217.1, U1209.2; also elsewhere on the board
Row_E_POS3P3: R1219.1, U1210.2; also elsewhere on the board
SPI_Error_LED: R1202.1, U1202.2; also elsewhere on the board
USB_Error_LED: R1209.1, U1205.2; also elsewhere on the board
WIFI_Error_LED: R1205.1, U1203.2; also elsewhere on the board
~ACTIVE_LED: R1201.2, U1201.2; also elsewhere on the board

Notes on the sheet:
12. Status LEDs Bank 1

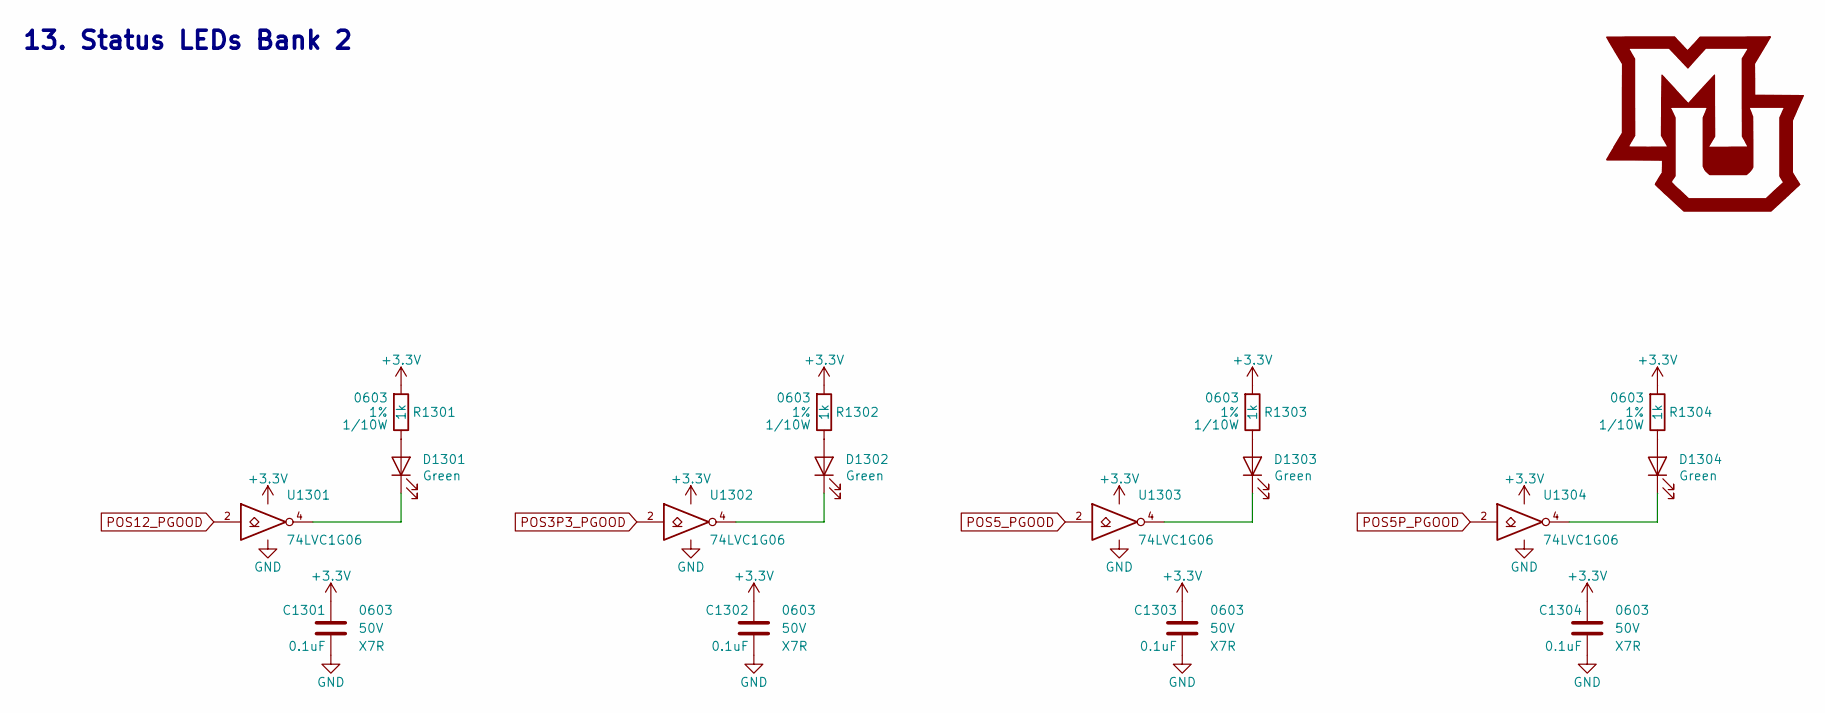
[picture p74: schematic Status_LEDs_2.sch, Electronic Display Logic Board]

Parts:
C1301, C1302, C1303, C1304: 0.1uF; C_0603; Voltage 50V; Digi-Key PN 311-1344-1-ND
D1301, D1302, D1303, D1304: Green; LED_0603; Digi-Key PN 160-1446-1-ND
R1301, R1302, R1303, R1304: 1k; R_0603; Tolerance 1%; Digi-Key PN RMCF0603FT1K00CT-ND
U1301, U1302, U1303, U1304: 74LVC1G06; SOT-353_SC-70-5; Digi-Key PN 296-8484-1-ND

Connections:
+3V3: C1301.1, C1302.1, C1303.1, C1304.1, R1301.1, R1302.1, R1303.1, R1304.1, U1301.5 (VCC), U1302.5 (VCC), U1303.5 (VCC), U1304.5 (VCC); also elsewhere on the board
GND: C1301.2, C1302.2, C1303.2, C1304.2, U1301.3 (GND), U1302.3 (GND), U1303.3 (GND), U1304.3 (GND); also elsewhere on the board
unnamed: D1301.1 (K), U1301.4
unnamed: D1301.2 (A), R1301.2
unnamed: D1302.1 (K), U1302.4
unnamed: D1302.2 (A), R1302.2
unnamed: D1303.1 (K), U1303.4
unnamed: D1303.2 (A), R1303.2
unnamed: D1304.1 (K), U1304.4
unnamed: D1304.2 (A), R1304.2
POS3P3_PGOOD: U1302.2; also elsewhere on the board
POS5P_PGOOD: U1304.2; also elsewhere on the board
POS5_PGOOD: U1303.2; also elsewhere on the board
POS12_PGOOD: U1301.2; also elsewhere on the board

Notes on the sheet:
13. Status LEDs Bank 2
