drewsum/Electronic_Display/hdw/Logic_Board/LED_Display_Controller/LED_Display_Controller.kicad_pcb

## KiCad design hdw/Logic_Board/LED_Display_Controller/LED_Display_Controller.kicad_pcb (continued)

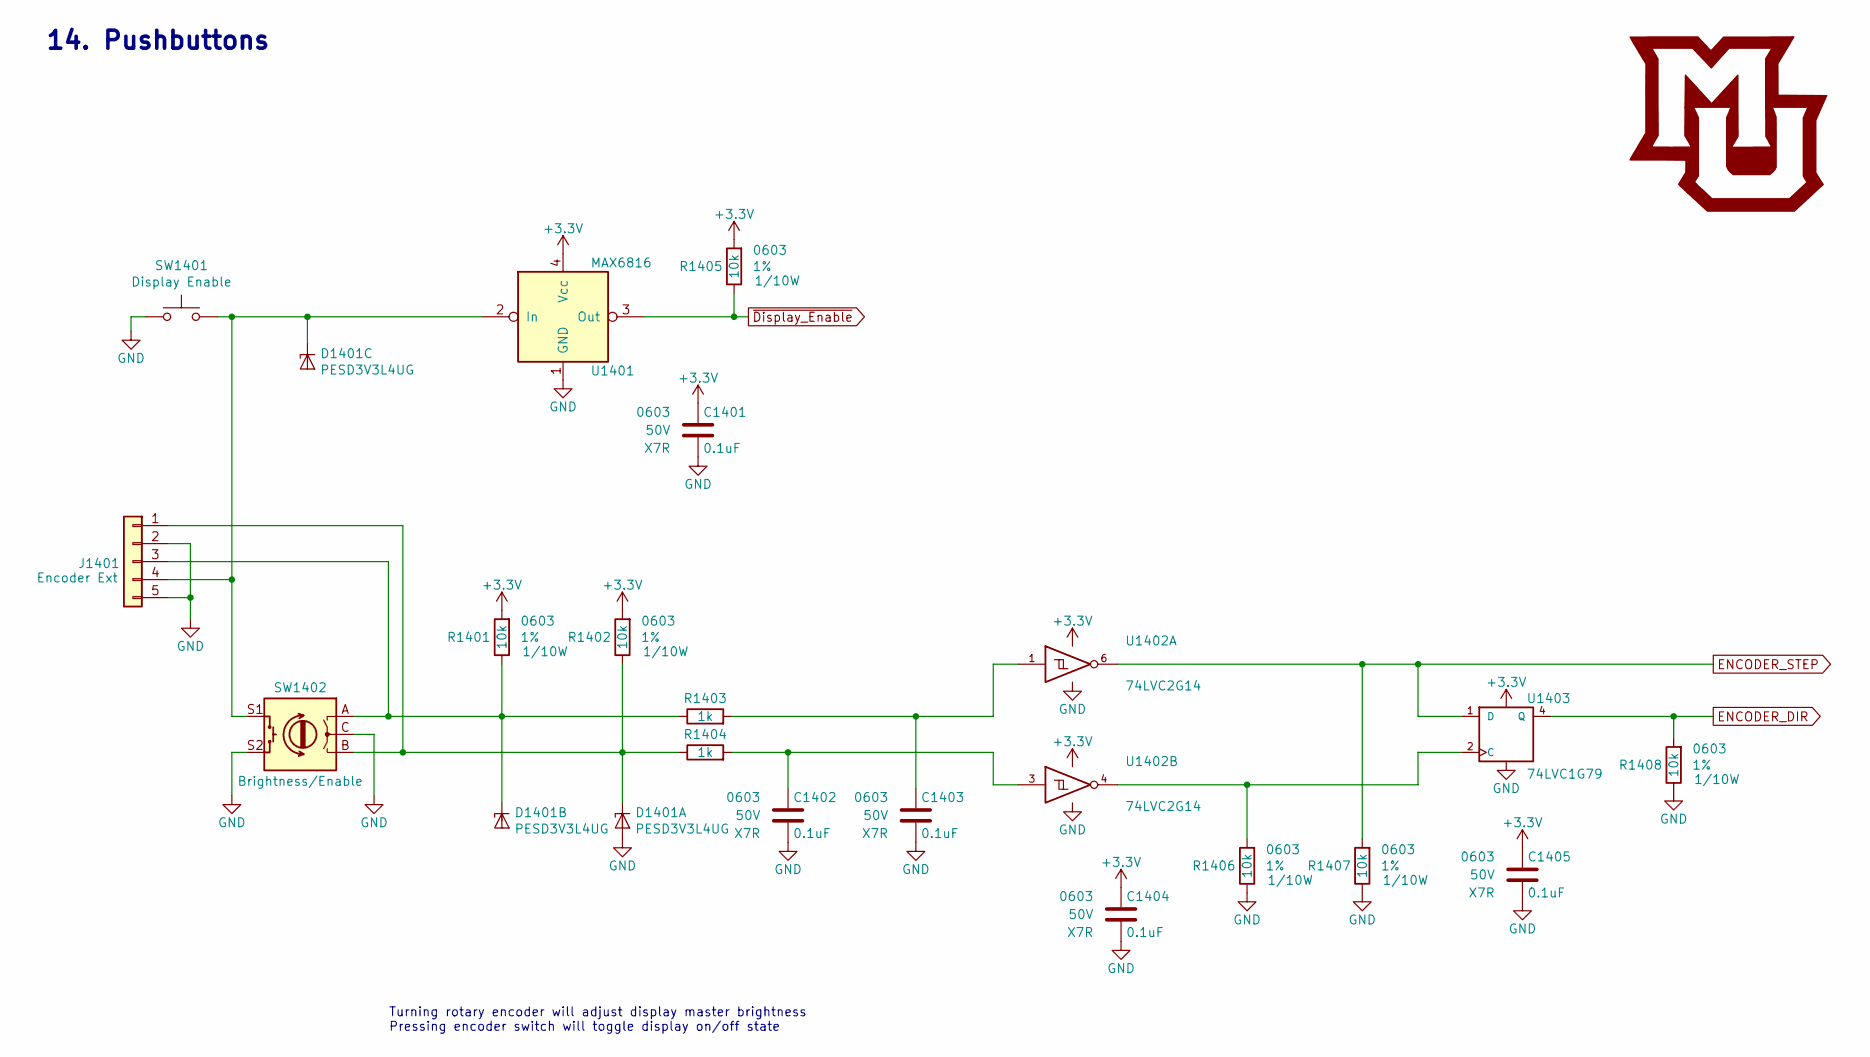
[picture p75: schematic Pushbuttons.sch, Electronic Display Logic Board]

Parts:
C1401, C1402, C1403, C1404, C1405: 0.1uF; C_0603; Voltage 50V; Digi-Key PN 311-1344-1-ND
D1401: PESD3V3L4UG; SOT-353_SC-70-5; Digi-Key PN 1727-3827-1-ND
J1401: Encoder Ext; Pin_Header_Straight_1x05_Pitch2.54mm
R1401, R1402, R1405, R1406, R1407, R1408: 10k; R_0603; Tolerance 1%; Digi-Key PN RMCF0603FT10K0CT-ND
R1403, R1404: 1k; R_0603; Tolerance 1%; Digi-Key PN RMCF0603FT1K00CT-ND
SW1401: Display Enable; SW_PUSH_6mm
SW1402: Brightness/Enable; ACZ11BR4E-15FA1-20C; Digi-Key PN 102-1753-ND
U1401: MAX6816; SOT-143; Digi-Key PN MAX6816EUS+TCT-ND
U1402: 74LVC2G14; SOT-363_SC-70-6; Digi-Key PN 296-13011-1-ND
U1403: 74LVC1G79; SOT-353_SC-70-5; Digi-Key PN 296-9850-1-ND

Connections:
+3V3: C1401.1, C1404.1, C1405.1, R1401.1, R1402.1, R1405.1, U1401.4 (Vcc), U1402.5 (VCC), U1403.5 (VCC); also elsewhere on the board
ENCODER_DIR: R1408.1, U1403.4 (Q); also elsewhere on the board
ENCODER_STEP: R1407.1, U1402.6, U1403.1 (D); also elsewhere on the board
GND: C1401.2, C1402.2, C1403.2, C1404.2, C1405.2, D1401.2 (A), J1401.2, J1401.5, R1406.2, R1407.2, R1408.2, SW1401.1, SW1402.C, SW1402.S2, U1401.1 (GND), U1402.2 (GND), U1403.3 (GND); also elsewhere on the board
unnamed: C1402.1, R1404.1, U1402.3
unnamed: C1403.1, R1403.1, U1402.1
unnamed: D1401.1 (K1), J1401.1, R1402.2, R1404.2, SW1402.B
unnamed: D1401.3 (K2), J1401.3, R1401.2, R1403.2, SW1402.A
unnamed: D1401.4 (K3), J1401.4, SW1401.2, SW1402.S1, U1401.2 (In)
unnamed: R1406.1, U1402.4, U1403.2 (C)
~Display_Enable: R1405.2, U1401.3 (Out); also elsewhere on the board

Notes on the sheet:
Turning rotary encoder will adjust display master brightness Pressing encoder switch will toggle display on/off state
14. Pushbuttons

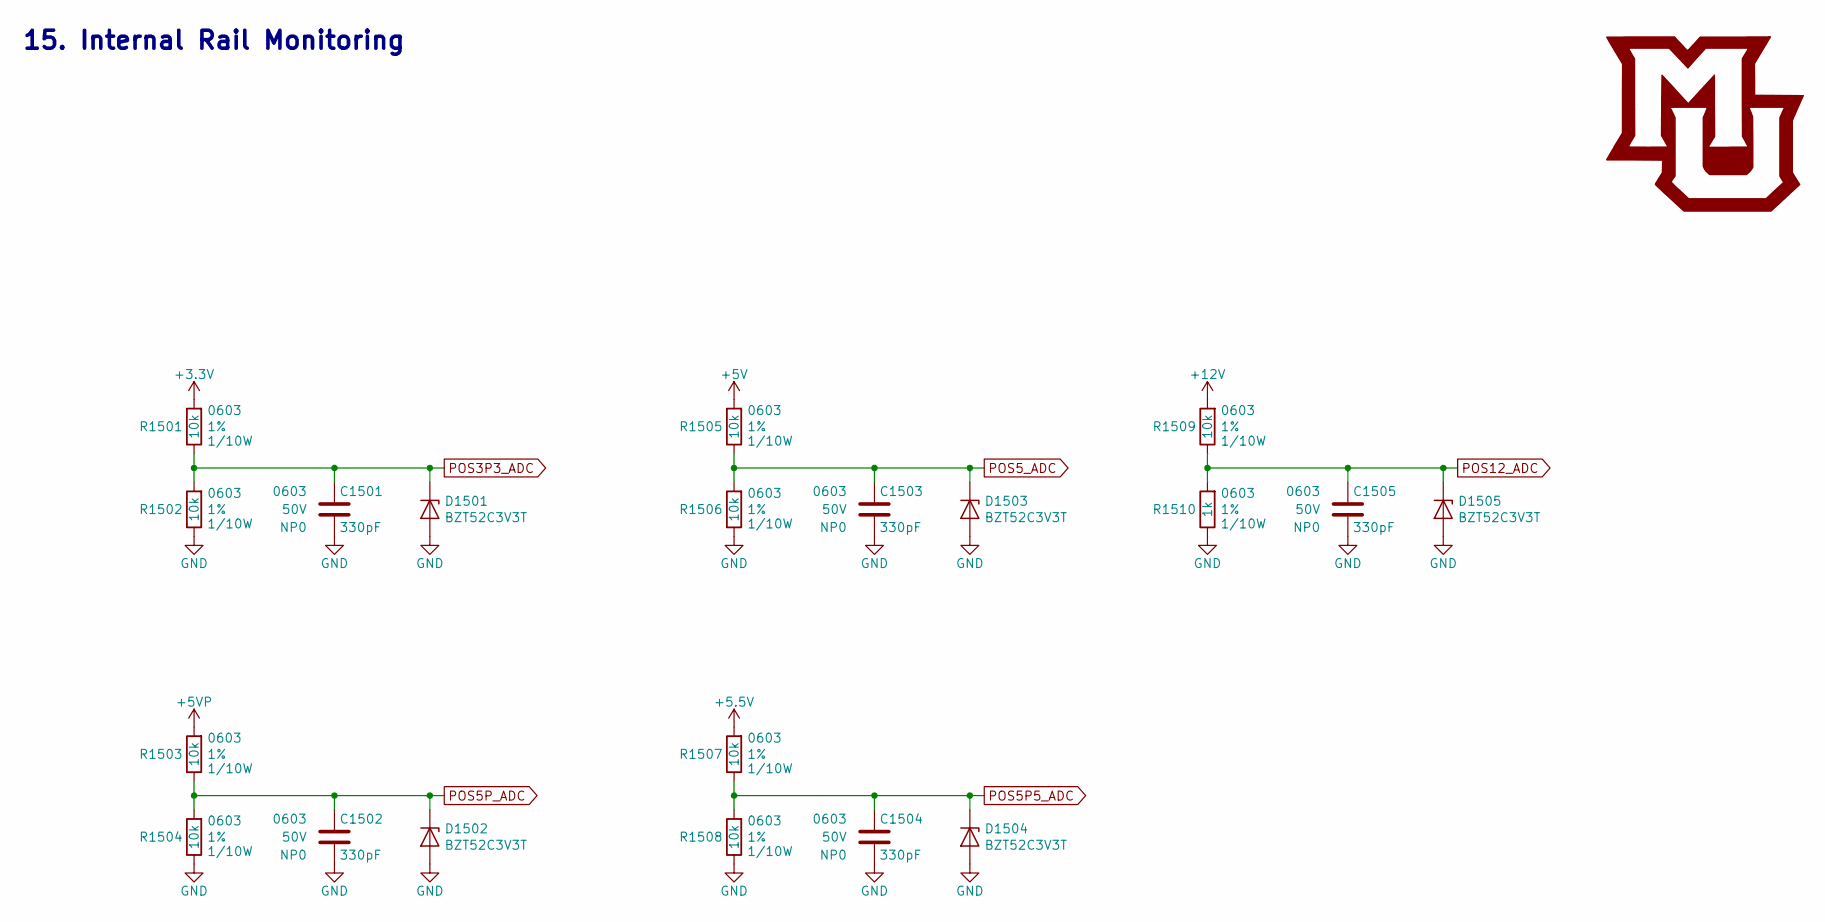
[picture p76: schematic Internal_Rail_Monitoring.sch, Electronic Display Logic Board]

Parts:
C1501, C1502, C1503, C1504, C1505: 330pF; C_0603; Voltage 50V; Digi-Key PN 399-6880-1-ND
D1501, D1502, D1503, D1504, D1505: BZT52C3V3T; D_SOD-523; Digi-Key PN BZT52C3V3T-TPMSCT-ND
R1501, R1502, R1503, R1504, R1505, R1506, R1507, R1508, R1509: 10k; R_0603; Tolerance 1%; Digi-Key PN RMCF0603FT10K0CT-ND
R1510: 1k; R_0603; Tolerance 1%; Digi-Key PN RMCF0603FT1K00CT-ND

Connections:
+3V3: R1501.1; also elsewhere on the board
+5.5V: R1507.1; also elsewhere on the board
+5V: R1505.1; also elsewhere on the board
+5VP: R1503.1; also elsewhere on the board
+12V: R1509.1; also elsewhere on the board
GND: C1501.2, C1502.2, C1503.2, C1504.2, C1505.2, D1501.2 (A), D1502.2 (A), D1503.2 (A), D1504.2 (A), D1505.2 (A), R1502.2, R1504.2, R1506.2, R1508.2, R1510.2; also elsewhere on the board
POS3P3_ADC: C1501.1, D1501.1 (K), R1501.2, R1502.1; also elsewhere on the board
POS5P5_ADC: C1504.1, D1504.1 (K), R1507.2, R1508.1; also elsewhere on the board
POS5P_ADC: C1502.1, D1502.1 (K), R1503.2, R1504.1; also elsewhere on the board
POS5_ADC: C1503.1, D1503.1 (K), R1505.2, R1506.1; also elsewhere on the board
POS12_ADC: C1505.1, D1505.1 (K), R1509.2, R1510.1; also elsewhere on the board

Notes on the sheet:
15. Internal Rail Monitoring

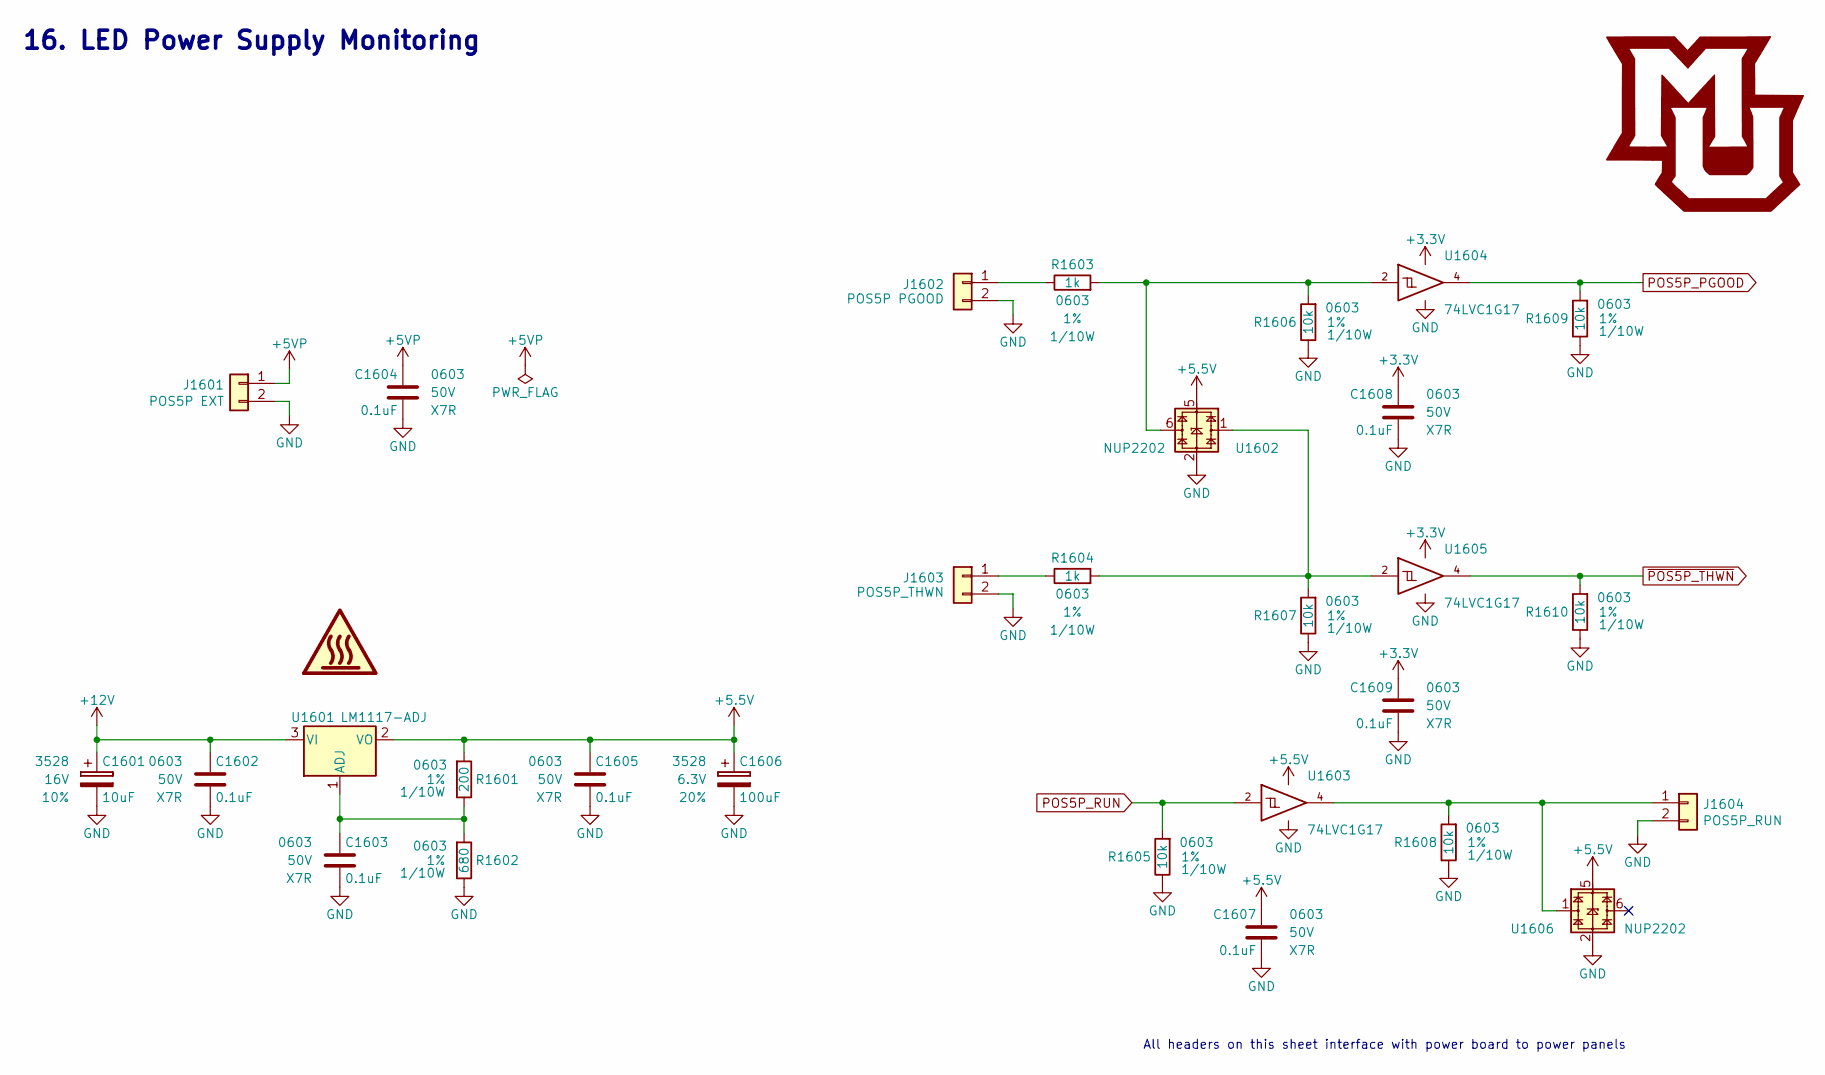
[picture p77: schematic LED_POS5_Monitoring.sch, Electronic Display Logic Board]

Parts:
C1601: 10uF; CP_Tantalum_Case-B_EIA-3528-21_Reflow; Voltage 16V; Tolerance 10%; Digi-Key PN 478-8236-1-ND
C1602, C1603, C1604, C1605, C1607, C1608, C1609: 0.1uF; C_0603; Voltage 50V; Digi-Key PN 311-1344-1-ND
C1606: 100uF; CP_Tantalum_Case-B_EIA-3528-21_Reflow; Voltage 6.3V; Tolerance 20%; Digi-Key PN 478-3130-1-ND
J1601: POS5P EXT; Pin_Header_Straight_1x02_Pitch2.54mm
J1602: POS5P PGOOD; Pin_Header_Straight_1x02_Pitch2.54mm
J1603: POS5P_THWN; Pin_Header_Straight_1x02_Pitch2.54mm
J1604: POS5P_RUN; Pin_Header_Straight_1x02_Pitch2.54mm
R1601: 200; R_0603; Tolerance 1%; Digi-Key PN P200HCT-ND
R1602: 680; R_0603; Tolerance 1%; Digi-Key PN P680HCT-ND
R1603, R1604: 1k; R_0603; Tolerance 1%; Digi-Key PN RMCF0603FT1K00CT-ND
R1605, R1606, R1607, R1608, R1609, R1610: 10k; R_0603; Tolerance 1%; Digi-Key PN RMCF0603FT10K0CT-ND
U1601: LM1117-ADJ; SOT-223-3_TabPin2; Digi-Key PN LM1117IMPX-ADJ/NOPBCT-ND
U1602, U1606: NUP2202; SOT-363_SC-70-6; Digi-Key PN NUP2202W1T2GOSCT-ND
U1603, U1604, U1605: 74LVC1G17; SOT-353_SC-70-5; Digi-Key PN 296-11934-1-ND

Connections:
+3V3: C1608.1, C1609.1, U1604.5 (VCC), U1605.5 (VCC); also elsewhere on the board
+5.5V: C1605.1, C1606.1, C1607.1, R1601.1, U1601.2 (VO), U1602.5, U1603.5 (VCC), U1606.5; also elsewhere on the board
+5VP: C1604.1, J1601.1; also elsewhere on the board
+12V: C1601.1, C1602.1, U1601.3 (VI); also elsewhere on the board
GND: C1601.2, C1602.2, C1603.2, C1604.2, C1605.2, C1606.2, C1607.2, C1608.2, C1609.2, J1601.2, J1602.2, J1603.2, J1604.2, R1602.2, R1605.2, R1606.2, R1607.2, R1608.2, R1609.2, R1610.2, U1602.2, U1603.3 (GND), U1604.3 (GND), U1605.3 (GND), U1606.2; also elsewhere on the board
unnamed: C1603.1, R1601.2, R1602.1, U1601.1 (ADJ)
unnamed: J1602.1, R1603.2
unnamed: J1603.1, R1604.2
unnamed: J1604.1, R1608.1, U1603.4, U1606.1
unnamed: R1603.1, R1606.1, U1602.6, U1604.2
unnamed: R1604.1, R1607.1, U1602.1, U1605.2
POS5P_PGOOD: R1609.1, U1604.4; also elsewhere on the board
POS5P_RUN: R1605.1, U1603.2; also elsewhere on the board
~POS5P_THWN: R1610.1, U1605.4; also elsewhere on the board

Notes on the sheet:
All headers on this sheet interface with power board to power panels
16. LED Power Supply Monitoring

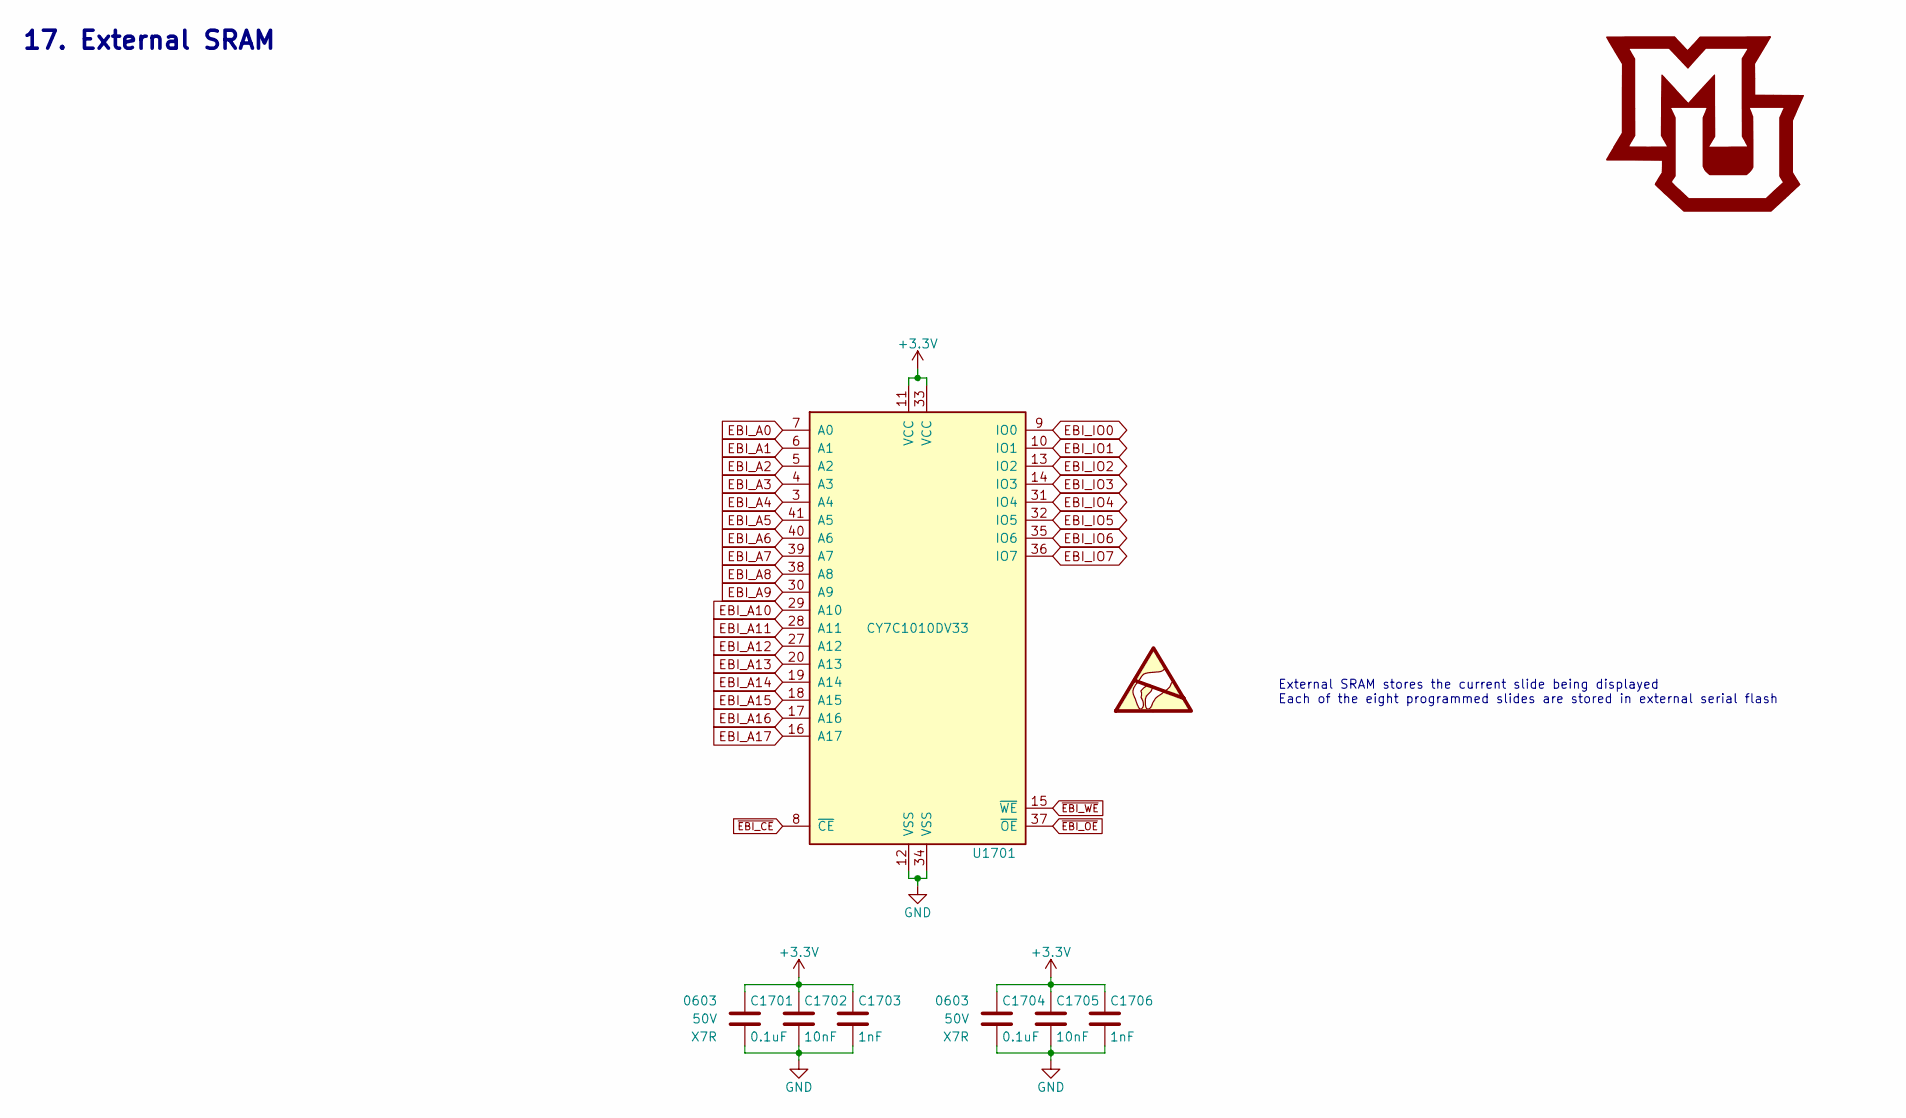
[picture p78: schematic External_SRAM.sch, Electronic Display Logic Board]

Parts:
C1701, C1704: 0.1uF; C_0603; Voltage 50V; Digi-Key PN 311-1344-1-ND
C1702, C1705: 10nF; C_0603; Voltage 50V; Digi-Key PN 1276-1921-1-ND
C1703, C1706: 1nF; C_0603; Voltage 50V; Digi-Key PN 1276-1018-1-ND
U1701: CY7C1010DV33; TSSOP-44_11x18.25mm_Pitch0.8mm; Digi-Key PN 428-1960-ND

Connections:
+3V3: C1701.1, C1702.1, C1703.1, C1704.1, C1705.1, C1706.1, U1701.11 (VCC), U1701.33 (VCC); also elsewhere on the board
EBI_A0: U1701.7 (A0); also elsewhere on the board
EBI_A1: U1701.6 (A1); also elsewhere on the board
EBI_A2: U1701.5 (A2); also elsewhere on the board
EBI_A3: U1701.4 (A3); also elsewhere on the board
EBI_A4: U1701.3 (A4); also elsewhere on the board
EBI_A5: U1701.41 (A5); also elsewhere on the board
EBI_A6: U1701.40 (A6); also elsewhere on the board
EBI_A7: U1701.39 (A7); also elsewhere on the board
EBI_A8: U1701.38 (A8); also elsewhere on the board
EBI_A9: U1701.30 (A9); also elsewhere on the board
EBI_A10: U1701.29 (A10); also elsewhere on the board
EBI_A11: U1701.28 (A11); also elsewhere on the board
EBI_A12: U1701.27 (A12); also elsewhere on the board
EBI_A13: U1701.20 (A13); also elsewhere on the board
EBI_A14: U1701.19 (A14); also elsewhere on the board
EBI_A15: U1701.18 (A15); also elsewhere on the board
EBI_A16: U1701.17 (A16); also elsewhere on the board
EBI_A17: U1701.16 (A17); also elsewhere on the board
EBI_IO0: U1701.9 (IO0); also elsewhere on the board
EBI_IO1: U1701.10 (IO1); also elsewhere on the board
EBI_IO2: U1701.13 (IO2); also elsewhere on the board
EBI_IO3: U1701.14 (IO3); also elsewhere on the board
EBI_IO4: U1701.31 (IO4); also elsewhere on the board
EBI_IO5: U1701.32 (IO5); also elsewhere on the board
EBI_IO6: U1701.35 (IO6); also elsewhere on the board
EBI_IO7: U1701.36 (IO7); also elsewhere on the board
GND: C1701.2, C1702.2, C1703.2, C1704.2, C1705.2, C1706.2, U1701.12 (VSS), U1701.34 (VSS); also elsewhere on the board
~EBI_CE: U1701.8 (~CE); also elsewhere on the board
~EBI_OE: U1701.37 (~OE); also elsewhere on the board
~EBI_WE: U1701.15 (~WE); also elsewhere on the board

Notes on the sheet:
External SRAM stores the current slide being displayed Each of the eight programmed slides are stored in external serial flash
17. External SRAM

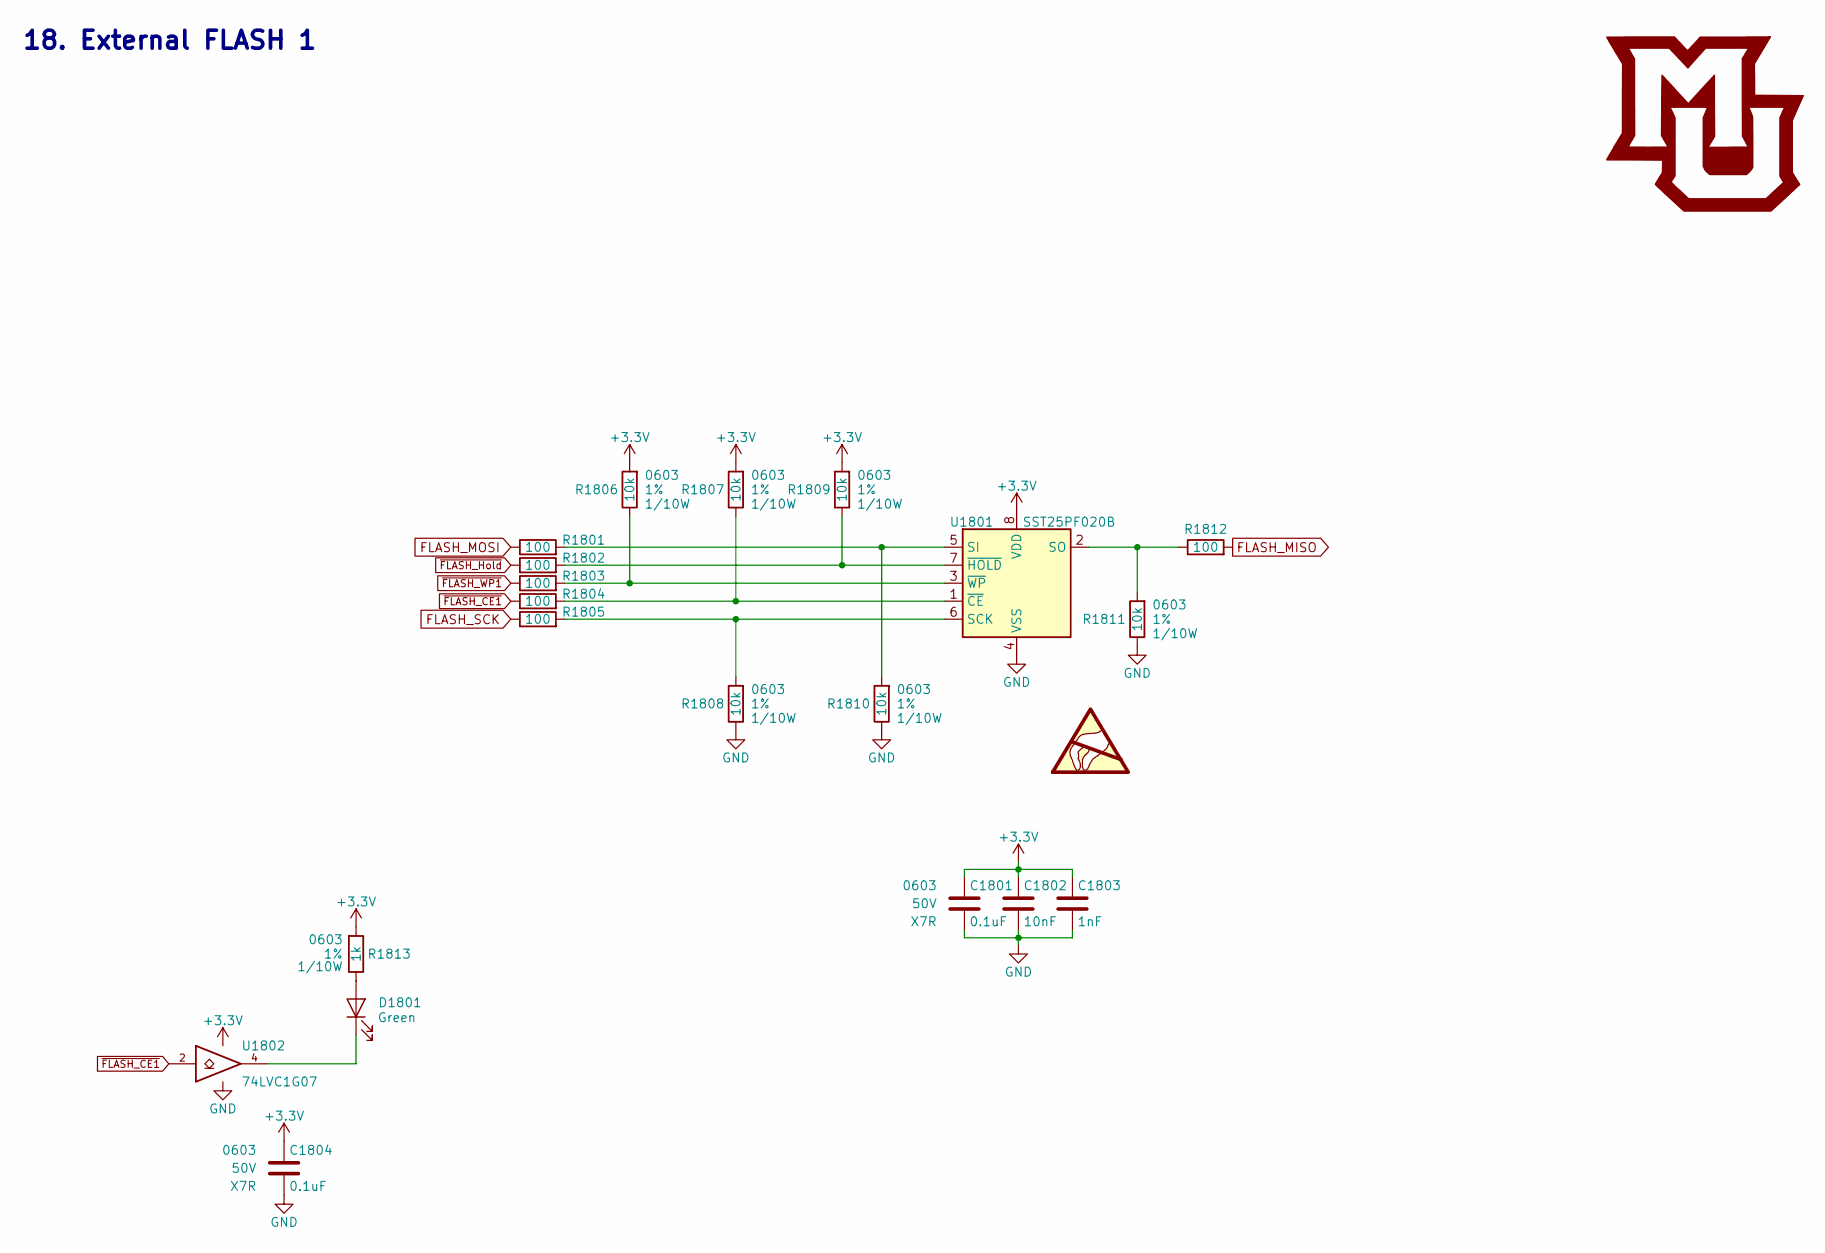
[picture p79: schematic External_Flash_1.sch, Electronic Display Logic Board]

Parts:
C1801, C1804: 0.1uF; C_0603; Voltage 50V; Digi-Key PN 311-1344-1-ND
C1802: 10nF; C_0603; Voltage 50V; Digi-Key PN 1276-1921-1-ND
C1803: 1nF; C_0603; Voltage 50V; Digi-Key PN 1276-1018-1-ND
D1801: Green; LED_0603; Digi-Key PN 160-1446-1-ND
R1801, R1802, R1803, R1804, R1805, R1812: 100; R_0603; Tolerance 1%; Digi-Key PN A106047CT-ND
R1806, R1807, R1808, R1809, R1810, R1811: 10k; R_0603; Tolerance 1%; Digi-Key PN RMCF0603FT10K0CT-ND
R1813: 1k; R_0603; Tolerance 1%; Digi-Key PN RMCF0603FT1K00CT-ND
U1801: SST25PF020B; SOIC-8_3.9x4.9mm_Pitch1.27mm; Digi-Key PN SST25PF020B-80-4C-SAE-TCT-ND
U1802: 74LVC1G07; SOT-353_SC-70-5; Digi-Key PN 296-8486-1-ND

Connections:
+3V3: C1801.1, C1802.1, C1803.1, C1804.1, R1806.1, R1807.1, R1809.1, R1813.1, U1801.8 (VDD), U1802.5 (VCC); also elsewhere on the board
FLASH_MISO: R1812.1; also elsewhere on the board
FLASH_MOSI: R1801.2; also elsewhere on the board
FLASH_SCK: R1805.2; also elsewhere on the board
GND: C1801.2, C1802.2, C1803.2, C1804.2, R1808.2, R1810.2, R1811.2, U1801.4 (VSS), U1802.3 (GND); also elsewhere on the board
unnamed: D1801.1 (K), U1802.4
unnamed: D1801.2 (A), R1813.2
unnamed: R1801.1, R1810.1, U1801.5 (SI)
unnamed: R1802.1, R1809.2, U1801.7 (~HOLD)
unnamed: R1803.1, R1806.2, U1801.3 (~WP)
unnamed: R1804.1, R1807.2, U1801.1 (~CE)
unnamed: R1805.1, R1808.1, U1801.6 (SCK)
unnamed: R1811.1, R1812.2, U1801.2 (SO)
~FLASH_CE1: R1804.2, U1802.2; also elsewhere on the board
~FLASH_Hold: R1802.2; also elsewhere on the board
~FLASH_WP1: R1803.2; also elsewhere on the board

Notes on the sheet:
18. External FLASH 1

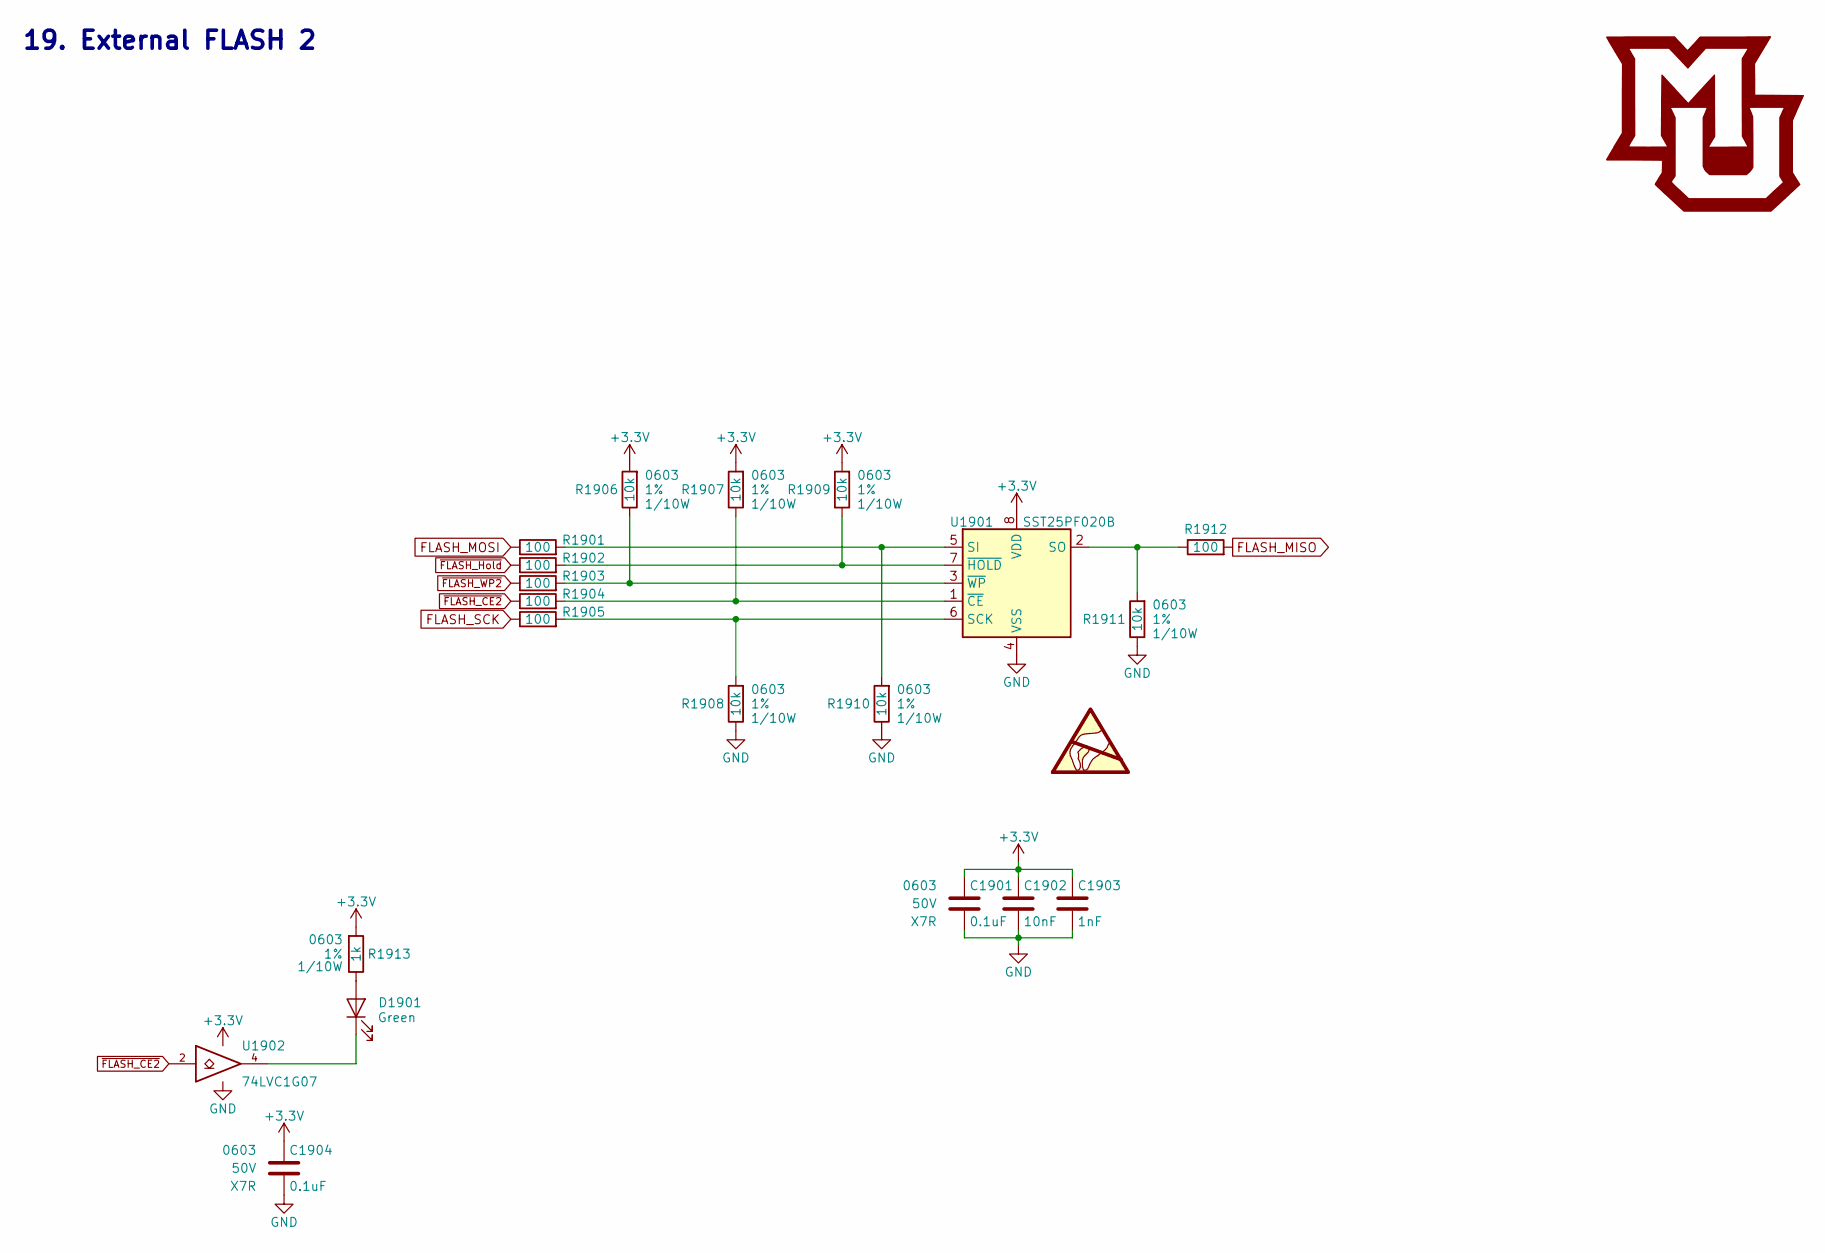
[picture p80: schematic External_Flash_2.sch, Electronic Display Logic Board]

Parts:
C1901, C1904: 0.1uF; C_0603; Voltage 50V; Digi-Key PN 311-1344-1-ND
C1902: 10nF; C_0603; Voltage 50V; Digi-Key PN 1276-1921-1-ND
C1903: 1nF; C_0603; Voltage 50V; Digi-Key PN 1276-1018-1-ND
D1901: Green; LED_0603; Digi-Key PN 160-1446-1-ND
R1901, R1902, R1903, R1904, R1905, R1912: 100; R_0603; Tolerance 1%; Digi-Key PN A106047CT-ND
R1906, R1907, R1908, R1909, R1910, R1911: 10k; R_0603; Tolerance 1%; Digi-Key PN RMCF0603FT10K0CT-ND
R1913: 1k; R_0603; Tolerance 1%; Digi-Key PN RMCF0603FT1K00CT-ND
U1901: SST25PF020B; SOIC-8_3.9x4.9mm_Pitch1.27mm; Digi-Key PN SST25PF020B-80-4C-SAE-TCT-ND
U1902: 74LVC1G07; SOT-353_SC-70-5; Digi-Key PN 296-8486-1-ND

Connections:
+3V3: C1901.1, C1902.1, C1903.1, C1904.1, R1906.1, R1907.1, R1909.1, R1913.1, U1901.8 (VDD), U1902.5 (VCC); also elsewhere on the board
FLASH_MISO: R1912.1; also elsewhere on the board
FLASH_MOSI: R1901.2; also elsewhere on the board
FLASH_SCK: R1905.2; also elsewhere on the board
GND: C1901.2, C1902.2, C1903.2, C1904.2, R1908.2, R1910.2, R1911.2, U1901.4 (VSS), U1902.3 (GND); also elsewhere on the board
unnamed: D1901.1 (K), U1902.4
unnamed: D1901.2 (A), R1913.2
unnamed: R1901.1, R1910.1, U1901.5 (SI)
unnamed: R1902.1, R1909.2, U1901.7 (~HOLD)
unnamed: R1903.1, R1906.2, U1901.3 (~WP)
unnamed: R1904.1, R1907.2, U1901.1 (~CE)
unnamed: R1905.1, R1908.1, U1901.6 (SCK)
unnamed: R1911.1, R1912.2, U1901.2 (SO)
~FLASH_CE2: R1904.2, U1902.2; also elsewhere on the board
~FLASH_Hold: R1902.2; also elsewhere on the board
~FLASH_WP2: R1903.2; also elsewhere on the board

Notes on the sheet:
19. External FLASH 2

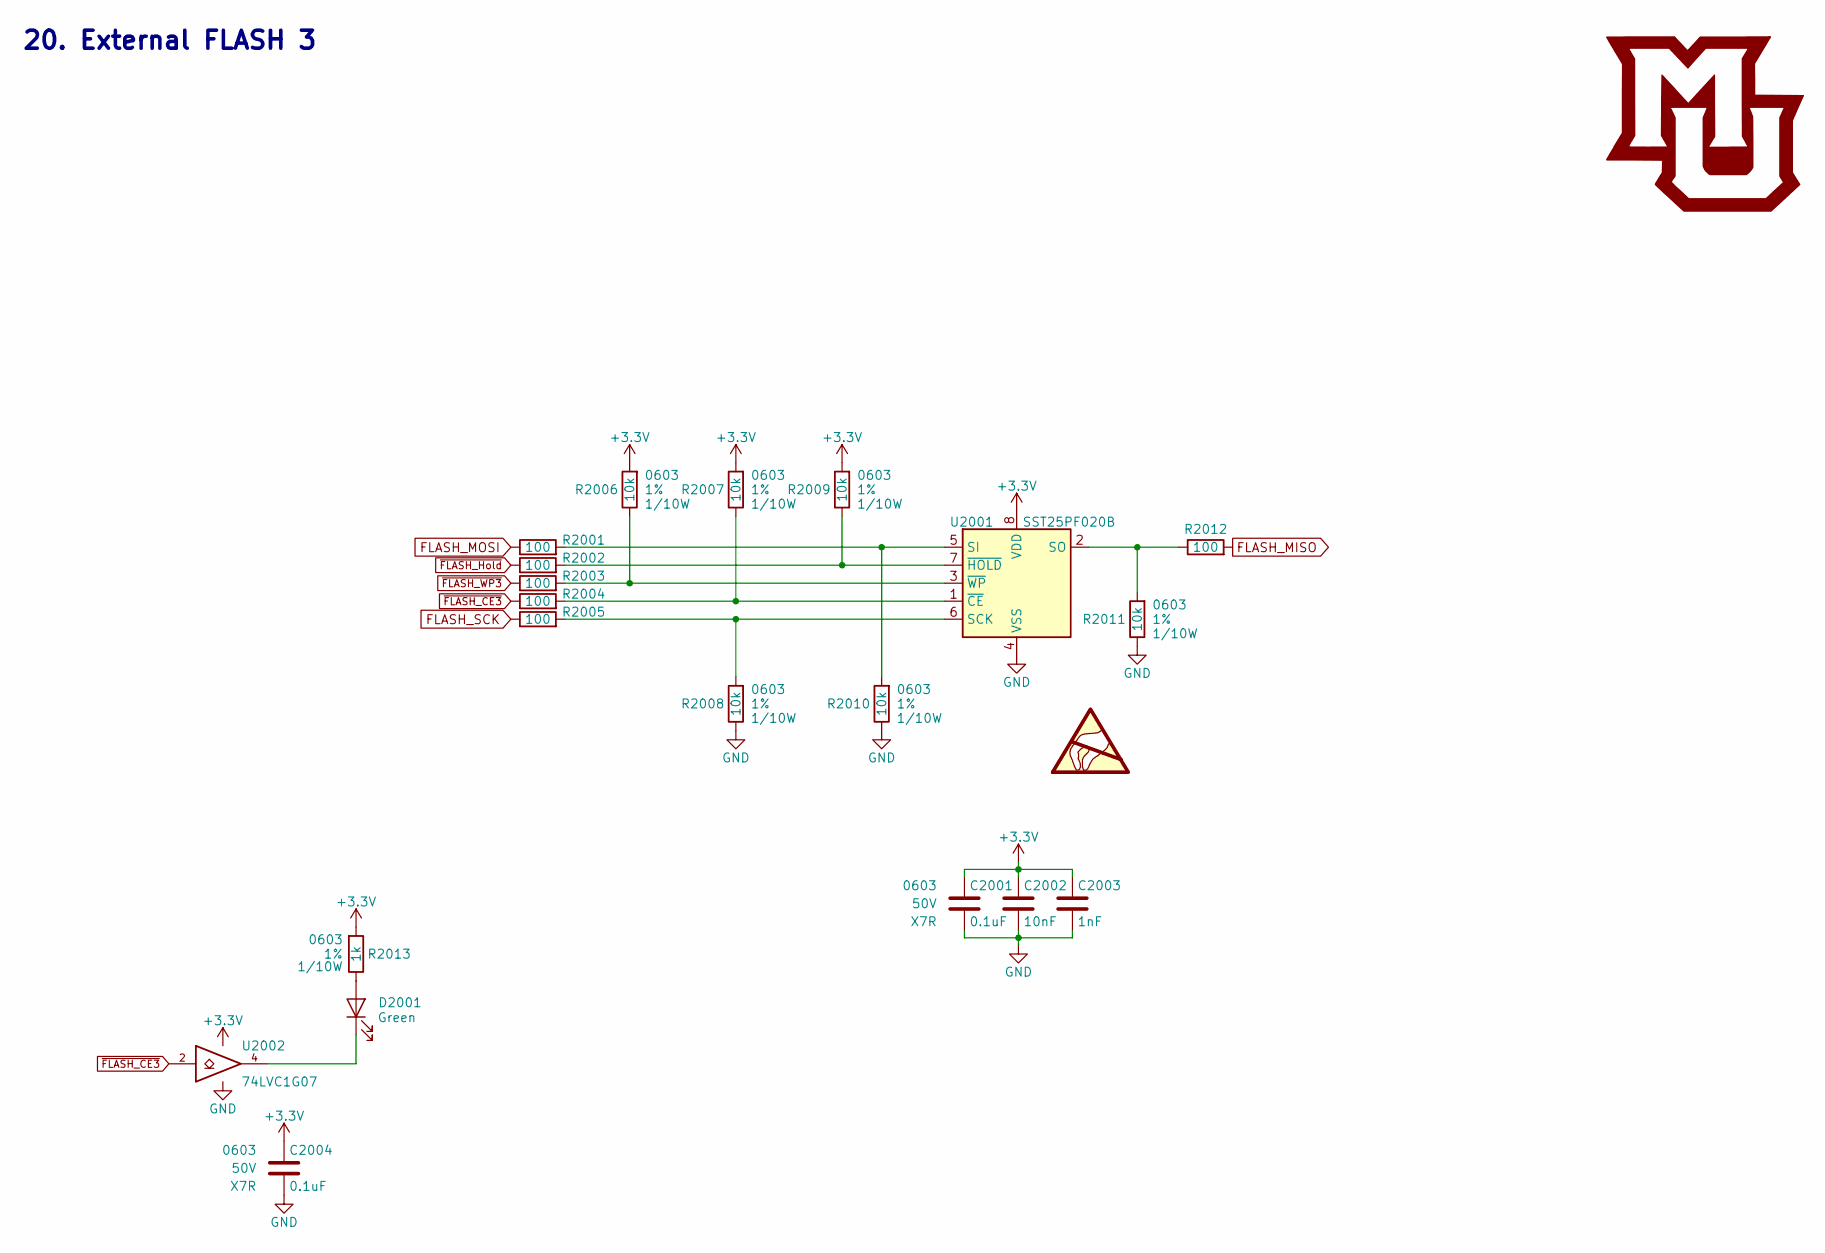
[picture p81: schematic External_Flash_3.sch, Electronic Display Logic Board]

Parts:
C2001, C2004: 0.1uF; C_0603; Voltage 50V; Digi-Key PN 311-1344-1-ND
C2002: 10nF; C_0603; Voltage 50V; Digi-Key PN 1276-1921-1-ND
C2003: 1nF; C_0603; Voltage 50V; Digi-Key PN 1276-1018-1-ND
D2001: Green; LED_0603; Digi-Key PN 160-1446-1-ND
R2001, R2002, R2003, R2004, R2005, R2012: 100; R_0603; Tolerance 1%; Digi-Key PN A106047CT-ND
R2006, R2007, R2008, R2009, R2010, R2011: 10k; R_0603; Tolerance 1%; Digi-Key PN RMCF0603FT10K0CT-ND
R2013: 1k; R_0603; Tolerance 1%; Digi-Key PN RMCF0603FT1K00CT-ND
U2001: SST25PF020B; SOIC-8_3.9x4.9mm_Pitch1.27mm; Digi-Key PN SST25PF020B-80-4C-SAE-TCT-ND
U2002: 74LVC1G07; SOT-353_SC-70-5; Digi-Key PN 296-8486-1-ND

Connections:
+3V3: C2001.1, C2002.1, C2003.1, C2004.1, R2006.1, R2007.1, R2009.1, R2013.1, U2001.8 (VDD), U2002.5 (VCC); also elsewhere on the board
FLASH_MISO: R2012.1; also elsewhere on the board
FLASH_MOSI: R2001.2; also elsewhere on the board
FLASH_SCK: R2005.2; also elsewhere on the board
GND: C2001.2, C2002.2, C2003.2, C2004.2, R2008.2, R2010.2, R2011.2, U2001.4 (VSS), U2002.3 (GND); also elsewhere on the board
unnamed: D2001.1 (K), U2002.4
unnamed: D2001.2 (A), R2013.2
unnamed: R2001.1, R2010.1, U2001.5 (SI)
unnamed: R2002.1, R2009.2, U2001.7 (~HOLD)
unnamed: R2003.1, R2006.2, U2001.3 (~WP)
unnamed: R2004.1, R2007.2, U2001.1 (~CE)
unnamed: R2005.1, R2008.1, U2001.6 (SCK)
unnamed: R2011.1, R2012.2, U2001.2 (SO)
~FLASH_CE3: R2004.2, U2002.2; also elsewhere on the board
~FLASH_Hold: R2002.2; also elsewhere on the board
~FLASH_WP3: R2003.2; also elsewhere on the board

Notes on the sheet:
20. External FLASH 3
