drewsum/Electronic_Display/hdw/Logic_Board/LED_Display_Controller/LED_Display_Controller.kicad_pcb

## KiCad design hdw/Logic_Board/LED_Display_Controller/LED_Display_Controller.kicad_pcb (continued)

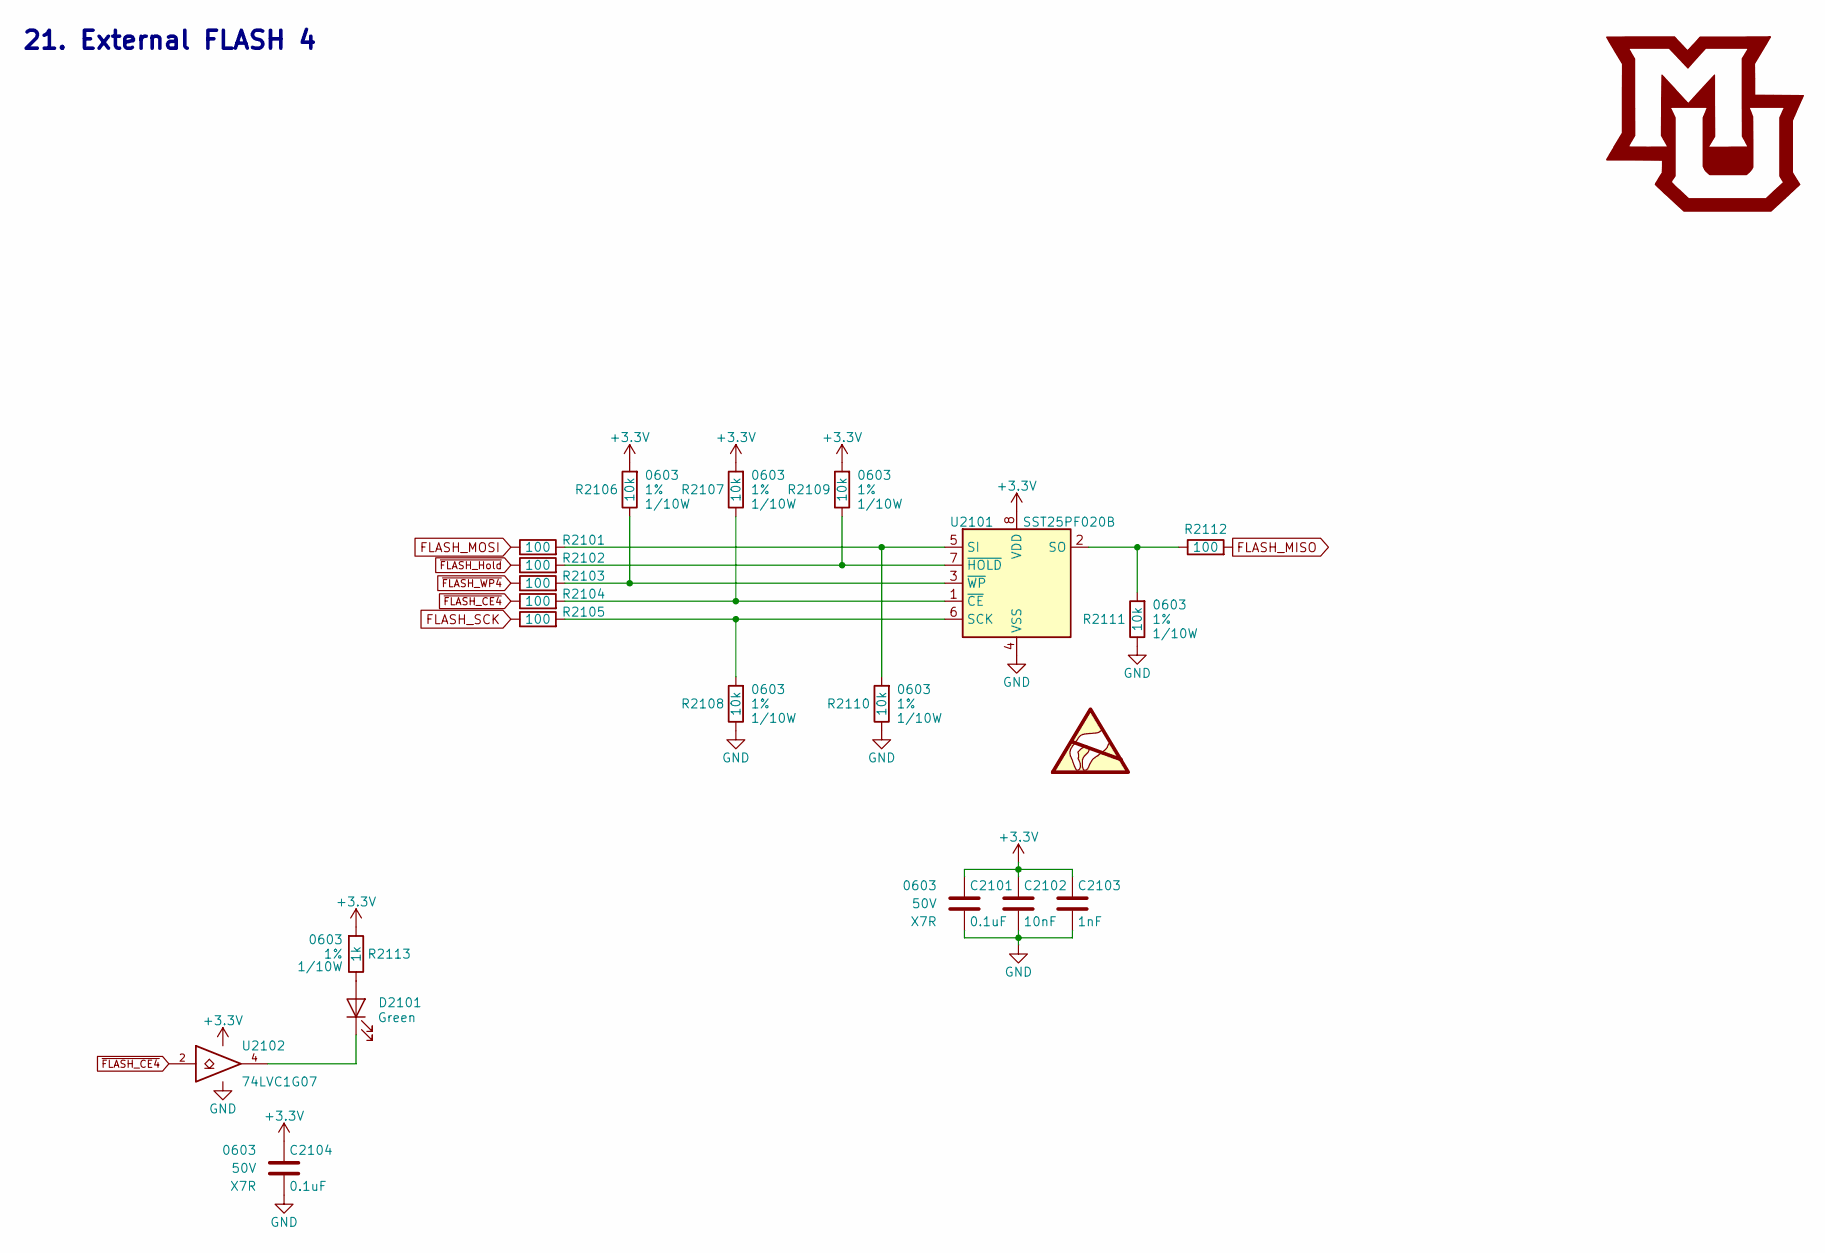
[picture p82: schematic External_Flash_4.sch, Electronic Display Logic Board]

Parts:
C2101, C2104: 0.1uF; C_0603; Voltage 50V; Digi-Key PN 311-1344-1-ND
C2102: 10nF; C_0603; Voltage 50V; Digi-Key PN 1276-1921-1-ND
C2103: 1nF; C_0603; Voltage 50V; Digi-Key PN 1276-1018-1-ND
D2101: Green; LED_0603; Digi-Key PN 160-1446-1-ND
R2101, R2102, R2103, R2104, R2105, R2112: 100; R_0603; Tolerance 1%; Digi-Key PN A106047CT-ND
R2106, R2107, R2108, R2109, R2110, R2111: 10k; R_0603; Tolerance 1%; Digi-Key PN RMCF0603FT10K0CT-ND
R2113: 1k; R_0603; Tolerance 1%; Digi-Key PN RMCF0603FT1K00CT-ND
U2101: SST25PF020B; SOIC-8_3.9x4.9mm_Pitch1.27mm; Digi-Key PN SST25PF020B-80-4C-SAE-TCT-ND
U2102: 74LVC1G07; SOT-353_SC-70-5; Digi-Key PN 296-8486-1-ND

Connections:
+3V3: C2101.1, C2102.1, C2103.1, C2104.1, R2106.1, R2107.1, R2109.1, R2113.1, U2101.8 (VDD), U2102.5 (VCC); also elsewhere on the board
FLASH_MISO: R2112.1; also elsewhere on the board
FLASH_MOSI: R2101.2; also elsewhere on the board
FLASH_SCK: R2105.2; also elsewhere on the board
GND: C2101.2, C2102.2, C2103.2, C2104.2, R2108.2, R2110.2, R2111.2, U2101.4 (VSS), U2102.3 (GND); also elsewhere on the board
unnamed: D2101.1 (K), U2102.4
unnamed: D2101.2 (A), R2113.2
unnamed: R2101.1, R2110.1, U2101.5 (SI)
unnamed: R2102.1, R2109.2, U2101.7 (~HOLD)
unnamed: R2103.1, R2106.2, U2101.3 (~WP)
unnamed: R2104.1, R2107.2, U2101.1 (~CE)
unnamed: R2105.1, R2108.1, U2101.6 (SCK)
unnamed: R2111.1, R2112.2, U2101.2 (SO)
~FLASH_CE4: R2104.2, U2102.2; also elsewhere on the board
~FLASH_Hold: R2102.2; also elsewhere on the board
~FLASH_WP4: R2103.2; also elsewhere on the board

Notes on the sheet:
21. External FLASH 4

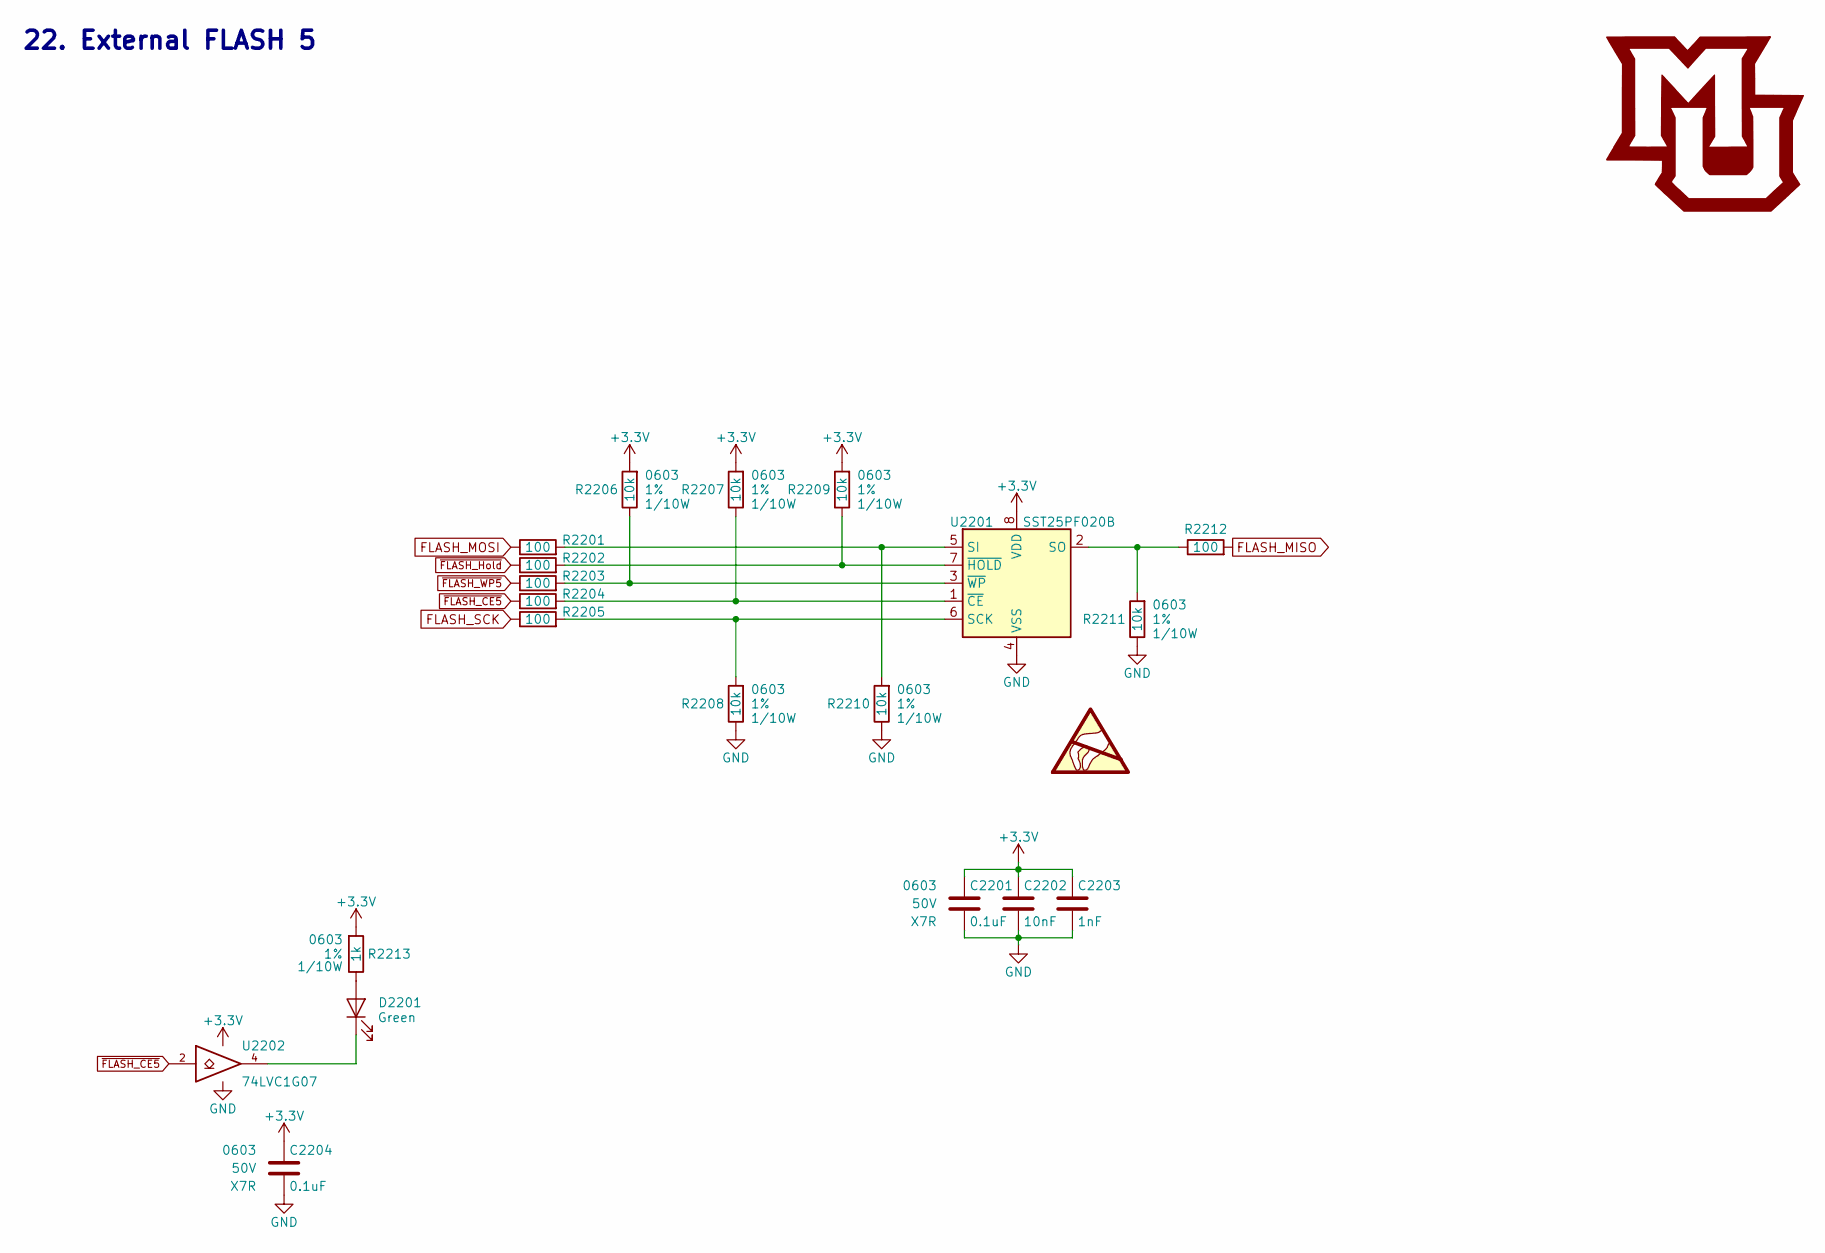
[picture p83: schematic External_Flash_5.sch, Electronic Display Logic Board]

Parts:
C2201, C2204: 0.1uF; C_0603; Voltage 50V; Digi-Key PN 311-1344-1-ND
C2202: 10nF; C_0603; Voltage 50V; Digi-Key PN 1276-1921-1-ND
C2203: 1nF; C_0603; Voltage 50V; Digi-Key PN 1276-1018-1-ND
D2201: Green; LED_0603; Digi-Key PN 160-1446-1-ND
R2201, R2202, R2203, R2204, R2205, R2212: 100; R_0603; Tolerance 1%; Digi-Key PN A106047CT-ND
R2206, R2207, R2208, R2209, R2210, R2211: 10k; R_0603; Tolerance 1%; Digi-Key PN RMCF0603FT10K0CT-ND
R2213: 1k; R_0603; Tolerance 1%; Digi-Key PN RMCF0603FT1K00CT-ND
U2201: SST25PF020B; SOIC-8_3.9x4.9mm_Pitch1.27mm; Digi-Key PN SST25PF020B-80-4C-SAE-TCT-ND
U2202: 74LVC1G07; SOT-353_SC-70-5; Digi-Key PN 296-8486-1-ND

Connections:
+3V3: C2201.1, C2202.1, C2203.1, C2204.1, R2206.1, R2207.1, R2209.1, R2213.1, U2201.8 (VDD), U2202.5 (VCC); also elsewhere on the board
FLASH_MISO: R2212.1; also elsewhere on the board
FLASH_MOSI: R2201.2; also elsewhere on the board
FLASH_SCK: R2205.2; also elsewhere on the board
GND: C2201.2, C2202.2, C2203.2, C2204.2, R2208.2, R2210.2, R2211.2, U2201.4 (VSS), U2202.3 (GND); also elsewhere on the board
unnamed: D2201.1 (K), U2202.4
unnamed: D2201.2 (A), R2213.2
unnamed: R2201.1, R2210.1, U2201.5 (SI)
unnamed: R2202.1, R2209.2, U2201.7 (~HOLD)
unnamed: R2203.1, R2206.2, U2201.3 (~WP)
unnamed: R2204.1, R2207.2, U2201.1 (~CE)
unnamed: R2205.1, R2208.1, U2201.6 (SCK)
unnamed: R2211.1, R2212.2, U2201.2 (SO)
~FLASH_CE5: R2204.2, U2202.2; also elsewhere on the board
~FLASH_Hold: R2202.2; also elsewhere on the board
~FLASH_WP5: R2203.2; also elsewhere on the board

Notes on the sheet:
22. External FLASH 5

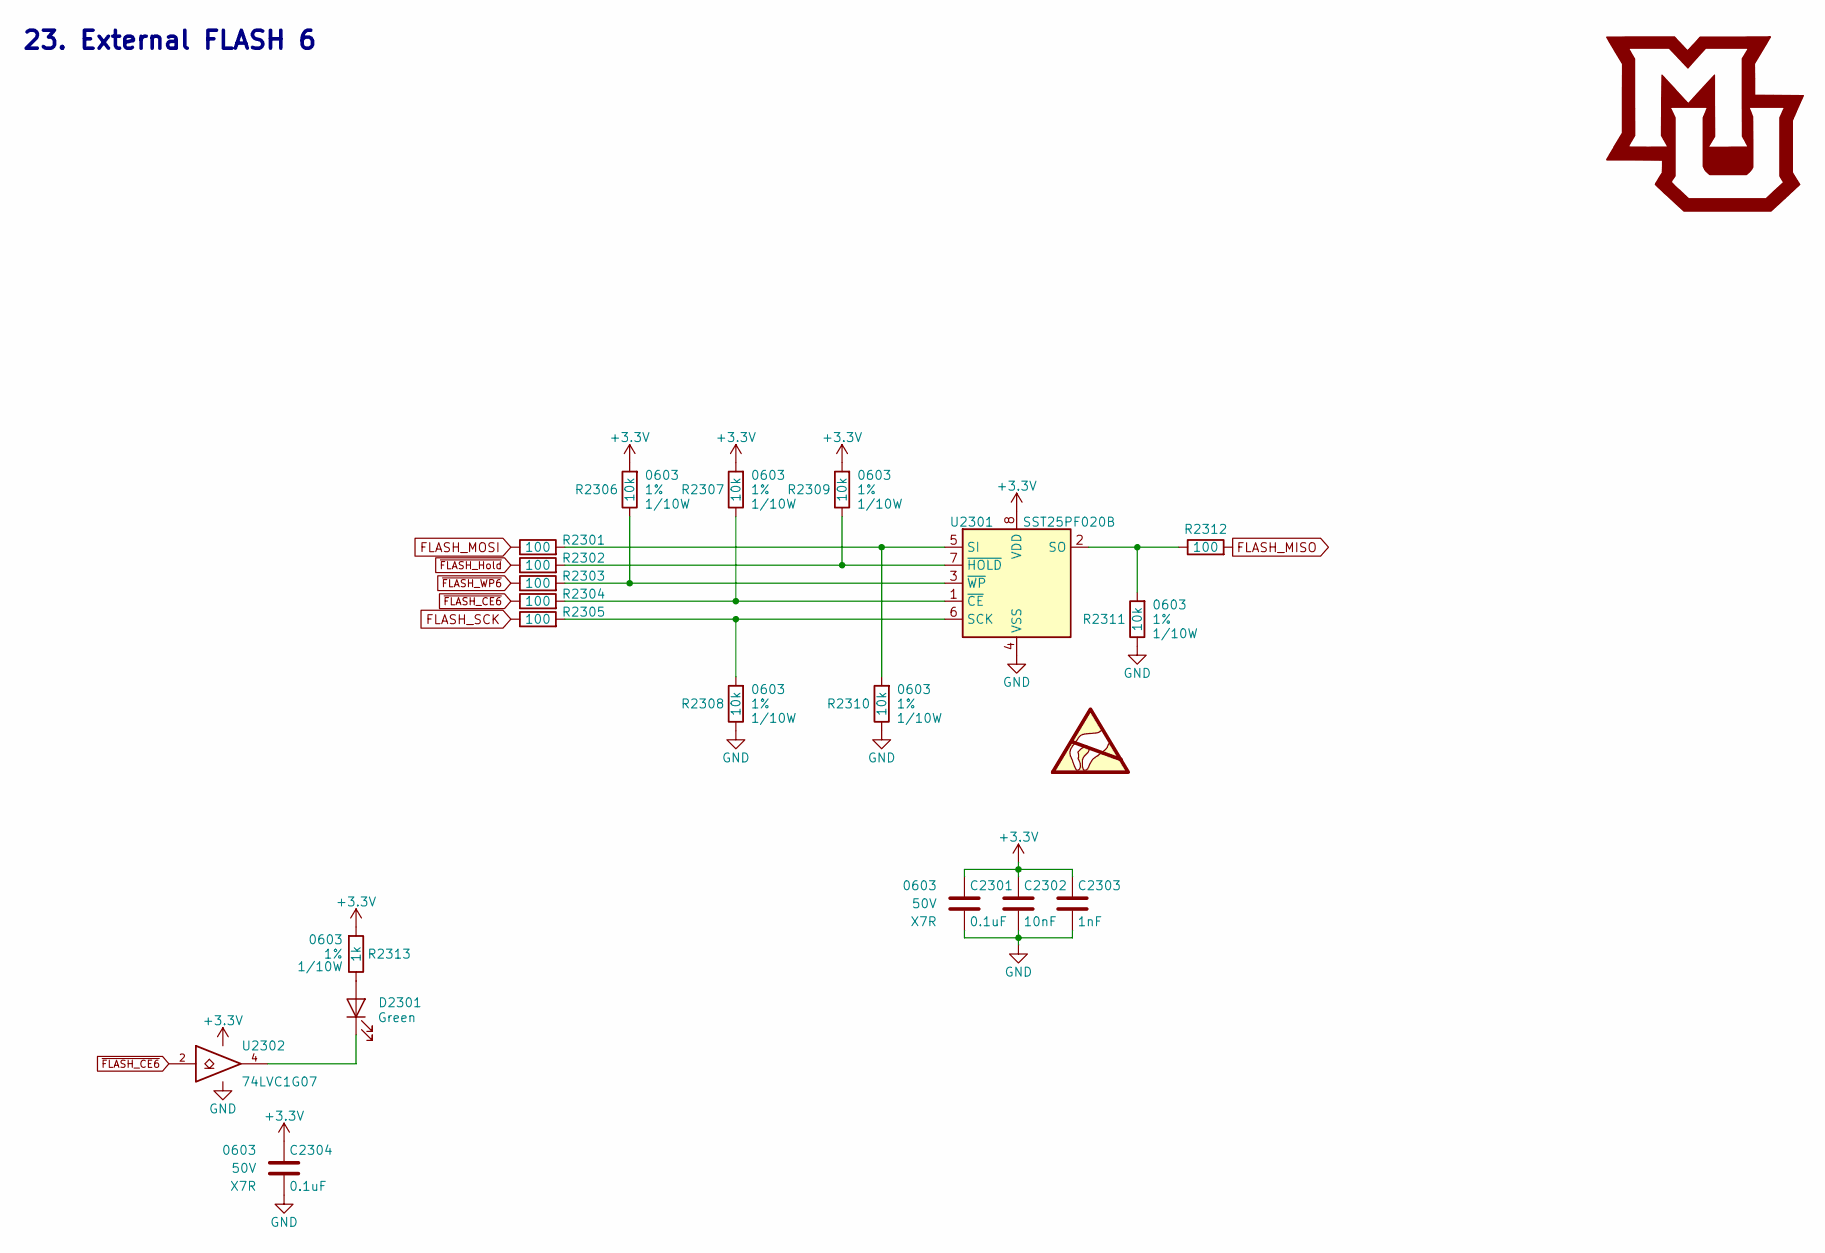
[picture p84: schematic External_Flash_6.sch, Electronic Display Logic Board]

Parts:
C2301, C2304: 0.1uF; C_0603; Voltage 50V; Digi-Key PN 311-1344-1-ND
C2302: 10nF; C_0603; Voltage 50V; Digi-Key PN 1276-1921-1-ND
C2303: 1nF; C_0603; Voltage 50V; Digi-Key PN 1276-1018-1-ND
D2301: Green; LED_0603; Digi-Key PN 160-1446-1-ND
R2301, R2302, R2303, R2304, R2305, R2312: 100; R_0603; Tolerance 1%; Digi-Key PN A106047CT-ND
R2306, R2307, R2308, R2309, R2310, R2311: 10k; R_0603; Tolerance 1%; Digi-Key PN RMCF0603FT10K0CT-ND
R2313: 1k; R_0603; Tolerance 1%; Digi-Key PN RMCF0603FT1K00CT-ND
U2301: SST25PF020B; SOIC-8_3.9x4.9mm_Pitch1.27mm; Digi-Key PN SST25PF020B-80-4C-SAE-TCT-ND
U2302: 74LVC1G07; SOT-353_SC-70-5; Digi-Key PN 296-8486-1-ND

Connections:
+3V3: C2301.1, C2302.1, C2303.1, C2304.1, R2306.1, R2307.1, R2309.1, R2313.1, U2301.8 (VDD), U2302.5 (VCC); also elsewhere on the board
FLASH_MISO: R2312.1; also elsewhere on the board
FLASH_MOSI: R2301.2; also elsewhere on the board
FLASH_SCK: R2305.2; also elsewhere on the board
GND: C2301.2, C2302.2, C2303.2, C2304.2, R2308.2, R2310.2, R2311.2, U2301.4 (VSS), U2302.3 (GND); also elsewhere on the board
unnamed: D2301.1 (K), U2302.4
unnamed: D2301.2 (A), R2313.2
unnamed: R2301.1, R2310.1, U2301.5 (SI)
unnamed: R2302.1, R2309.2, U2301.7 (~HOLD)
unnamed: R2303.1, R2306.2, U2301.3 (~WP)
unnamed: R2304.1, R2307.2, U2301.1 (~CE)
unnamed: R2305.1, R2308.1, U2301.6 (SCK)
unnamed: R2311.1, R2312.2, U2301.2 (SO)
~FLASH_CE6: R2304.2, U2302.2; also elsewhere on the board
~FLASH_Hold: R2302.2; also elsewhere on the board
~FLASH_WP6: R2303.2; also elsewhere on the board

Notes on the sheet:
23. External FLASH 6

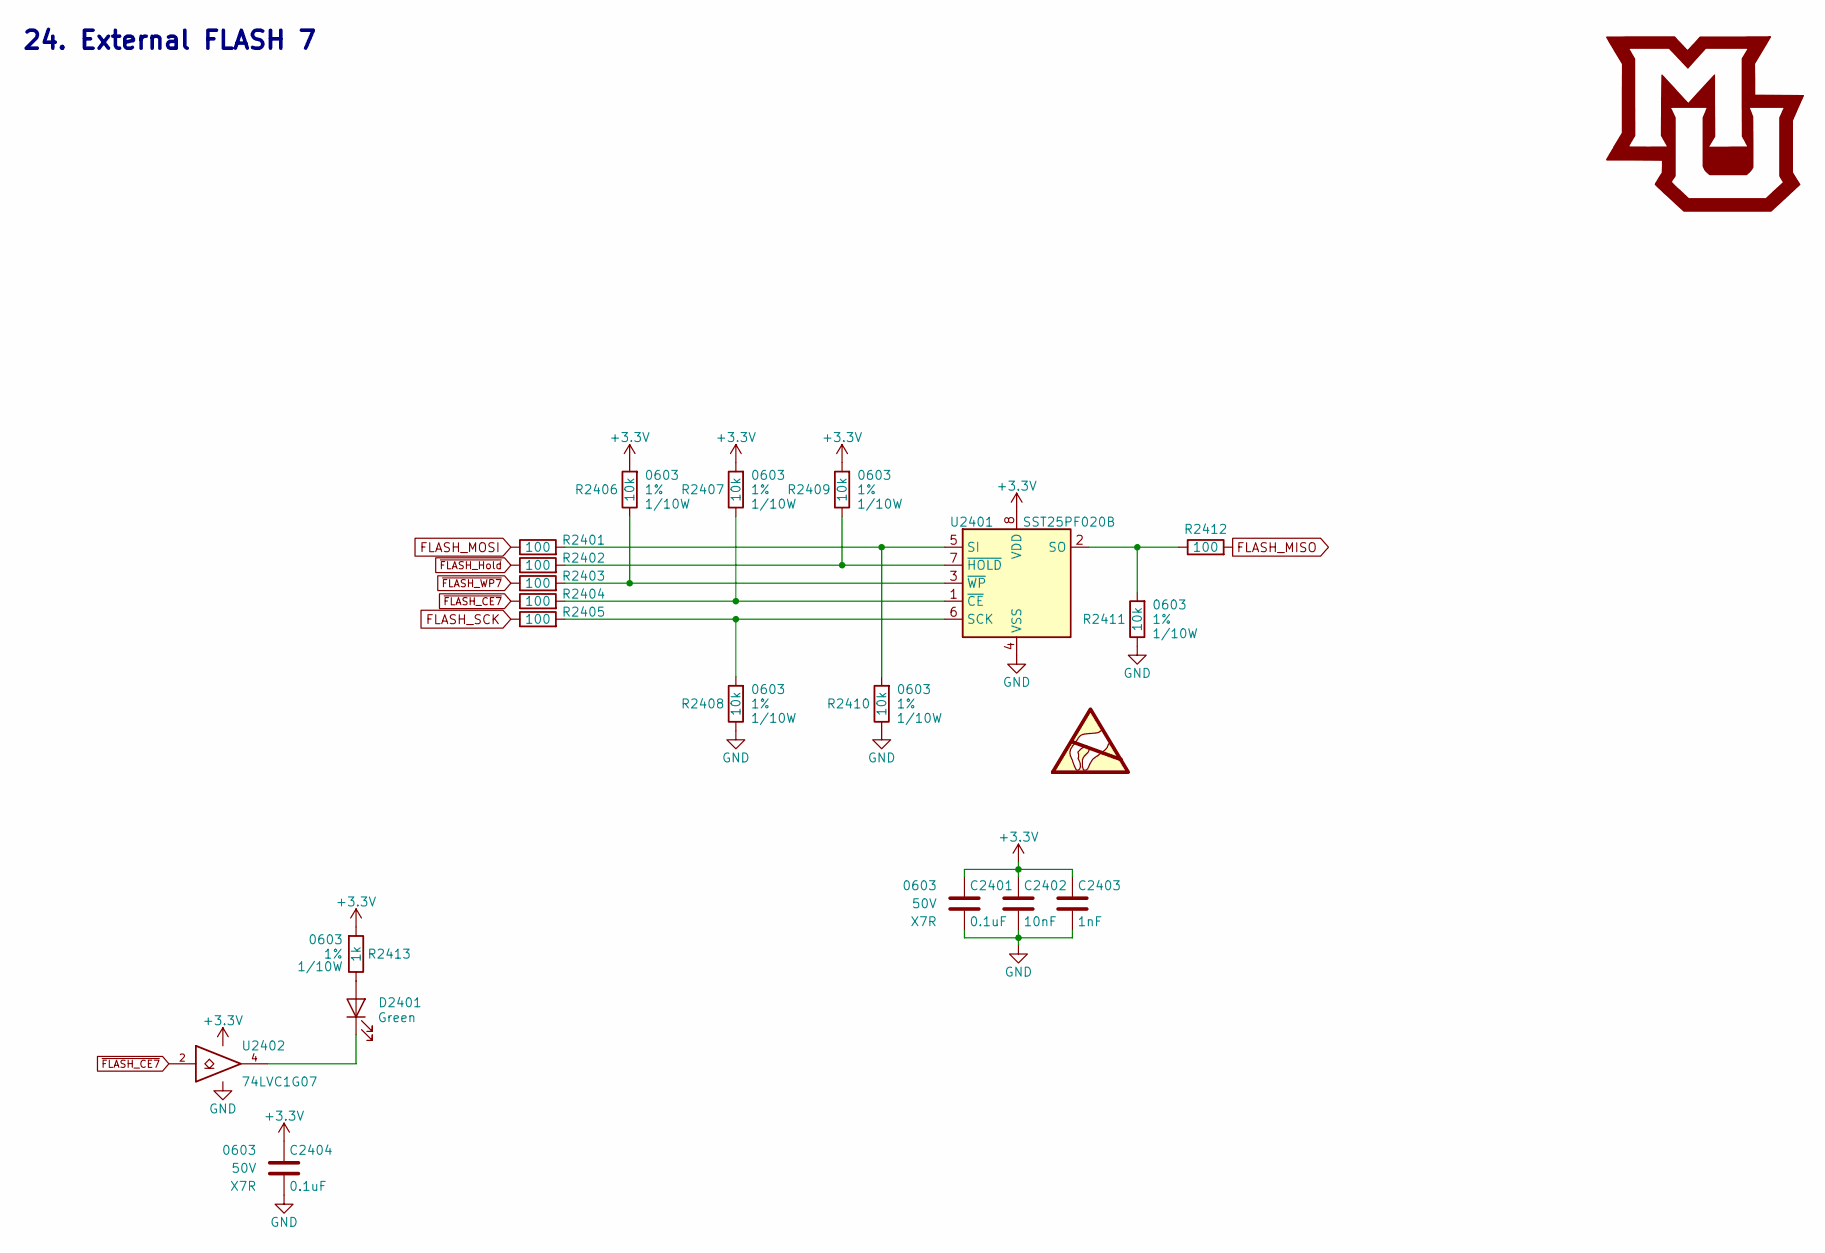
[picture p85: schematic External_Flash_7.sch, Electronic Display Logic Board]

Parts:
C2401, C2404: 0.1uF; C_0603; Voltage 50V; Digi-Key PN 311-1344-1-ND
C2402: 10nF; C_0603; Voltage 50V; Digi-Key PN 1276-1921-1-ND
C2403: 1nF; C_0603; Voltage 50V; Digi-Key PN 1276-1018-1-ND
D2401: Green; LED_0603; Digi-Key PN 160-1446-1-ND
R2401, R2402, R2403, R2404, R2405, R2412: 100; R_0603; Tolerance 1%; Digi-Key PN A106047CT-ND
R2406, R2407, R2408, R2409, R2410, R2411: 10k; R_0603; Tolerance 1%; Digi-Key PN RMCF0603FT10K0CT-ND
R2413: 1k; R_0603; Tolerance 1%; Digi-Key PN RMCF0603FT1K00CT-ND
U2401: SST25PF020B; SOIC-8_3.9x4.9mm_Pitch1.27mm; Digi-Key PN SST25PF020B-80-4C-SAE-TCT-ND
U2402: 74LVC1G07; SOT-353_SC-70-5; Digi-Key PN 296-8486-1-ND

Connections:
+3V3: C2401.1, C2402.1, C2403.1, C2404.1, R2406.1, R2407.1, R2409.1, R2413.1, U2401.8 (VDD), U2402.5 (VCC); also elsewhere on the board
FLASH_MISO: R2412.1; also elsewhere on the board
FLASH_MOSI: R2401.2; also elsewhere on the board
FLASH_SCK: R2405.2; also elsewhere on the board
GND: C2401.2, C2402.2, C2403.2, C2404.2, R2408.2, R2410.2, R2411.2, U2401.4 (VSS), U2402.3 (GND); also elsewhere on the board
unnamed: D2401.1 (K), U2402.4
unnamed: D2401.2 (A), R2413.2
unnamed: R2401.1, R2410.1, U2401.5 (SI)
unnamed: R2402.1, R2409.2, U2401.7 (~HOLD)
unnamed: R2403.1, R2406.2, U2401.3 (~WP)
unnamed: R2404.1, R2407.2, U2401.1 (~CE)
unnamed: R2405.1, R2408.1, U2401.6 (SCK)
unnamed: R2411.1, R2412.2, U2401.2 (SO)
~FLASH_CE7: R2404.2, U2402.2; also elsewhere on the board
~FLASH_Hold: R2402.2; also elsewhere on the board
~FLASH_WP7: R2403.2; also elsewhere on the board

Notes on the sheet:
24. External FLASH 7

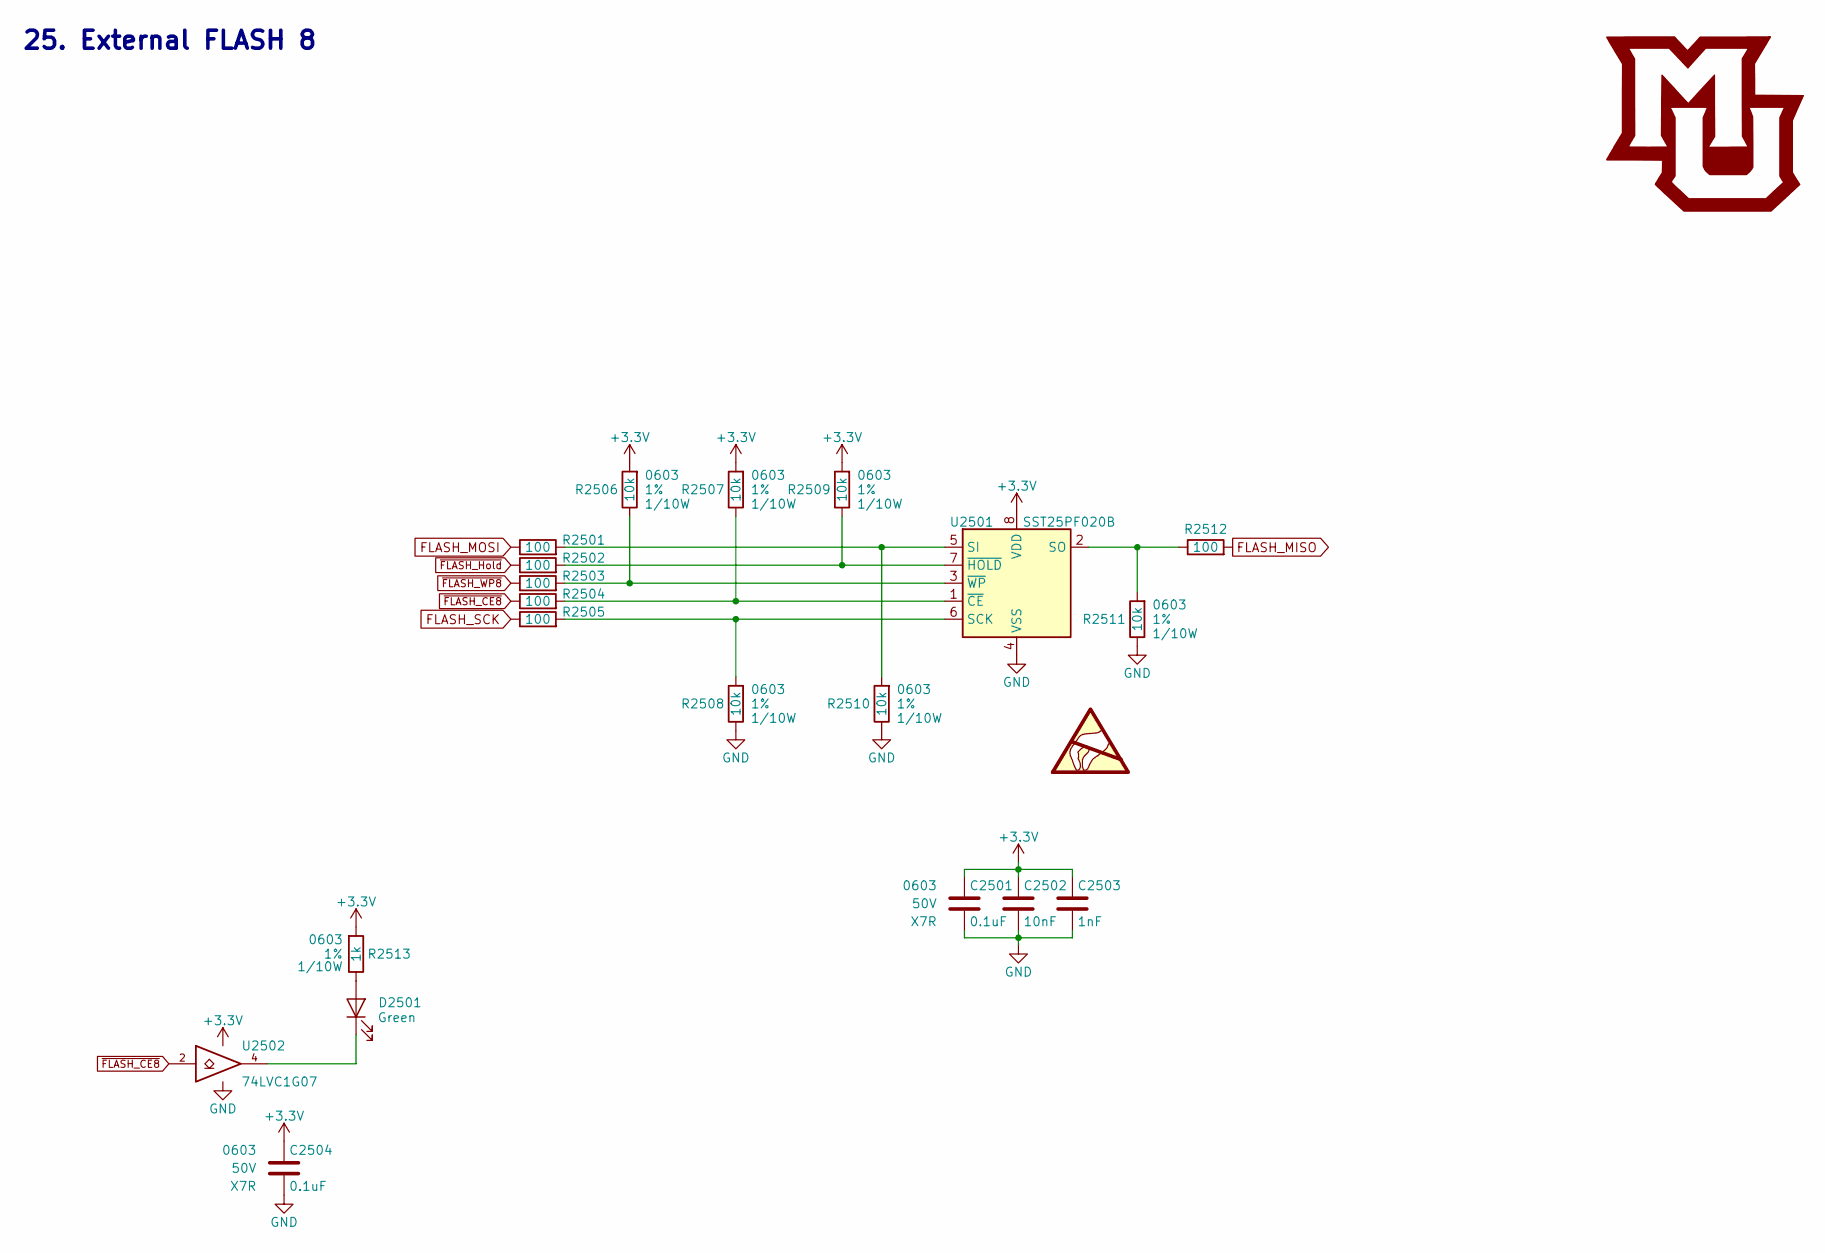
[picture p86: schematic External_Flash_8.sch, Electronic Display Logic Board]

Parts:
C2501, C2504: 0.1uF; C_0603; Voltage 50V; Digi-Key PN 311-1344-1-ND
C2502: 10nF; C_0603; Voltage 50V; Digi-Key PN 1276-1921-1-ND
C2503: 1nF; C_0603; Voltage 50V; Digi-Key PN 1276-1018-1-ND
D2501: Green; LED_0603; Digi-Key PN 160-1446-1-ND
R2501, R2502, R2503, R2504, R2505, R2512: 100; R_0603; Tolerance 1%; Digi-Key PN A106047CT-ND
R2506, R2507, R2508, R2509, R2510, R2511: 10k; R_0603; Tolerance 1%; Digi-Key PN RMCF0603FT10K0CT-ND
R2513: 1k; R_0603; Tolerance 1%; Digi-Key PN RMCF0603FT1K00CT-ND
U2501: SST25PF020B; SOIC-8_3.9x4.9mm_Pitch1.27mm; Digi-Key PN SST25PF020B-80-4C-SAE-TCT-ND
U2502: 74LVC1G07; SOT-353_SC-70-5; Digi-Key PN 296-8486-1-ND

Connections:
+3V3: C2501.1, C2502.1, C2503.1, C2504.1, R2506.1, R2507.1, R2509.1, R2513.1, U2501.8 (VDD), U2502.5 (VCC); also elsewhere on the board
FLASH_MISO: R2512.1; also elsewhere on the board
FLASH_MOSI: R2501.2; also elsewhere on the board
FLASH_SCK: R2505.2; also elsewhere on the board
GND: C2501.2, C2502.2, C2503.2, C2504.2, R2508.2, R2510.2, R2511.2, U2501.4 (VSS), U2502.3 (GND); also elsewhere on the board
unnamed: D2501.1 (K), U2502.4
unnamed: D2501.2 (A), R2513.2
unnamed: R2501.1, R2510.1, U2501.5 (SI)
unnamed: R2502.1, R2509.2, U2501.7 (~HOLD)
unnamed: R2503.1, R2506.2, U2501.3 (~WP)
unnamed: R2504.1, R2507.2, U2501.1 (~CE)
unnamed: R2505.1, R2508.1, U2501.6 (SCK)
unnamed: R2511.1, R2512.2, U2501.2 (SO)
~FLASH_CE8: R2504.2, U2502.2; also elsewhere on the board
~FLASH_Hold: R2502.2; also elsewhere on the board
~FLASH_WP8: R2503.2; also elsewhere on the board

Notes on the sheet:
25. External FLASH 8

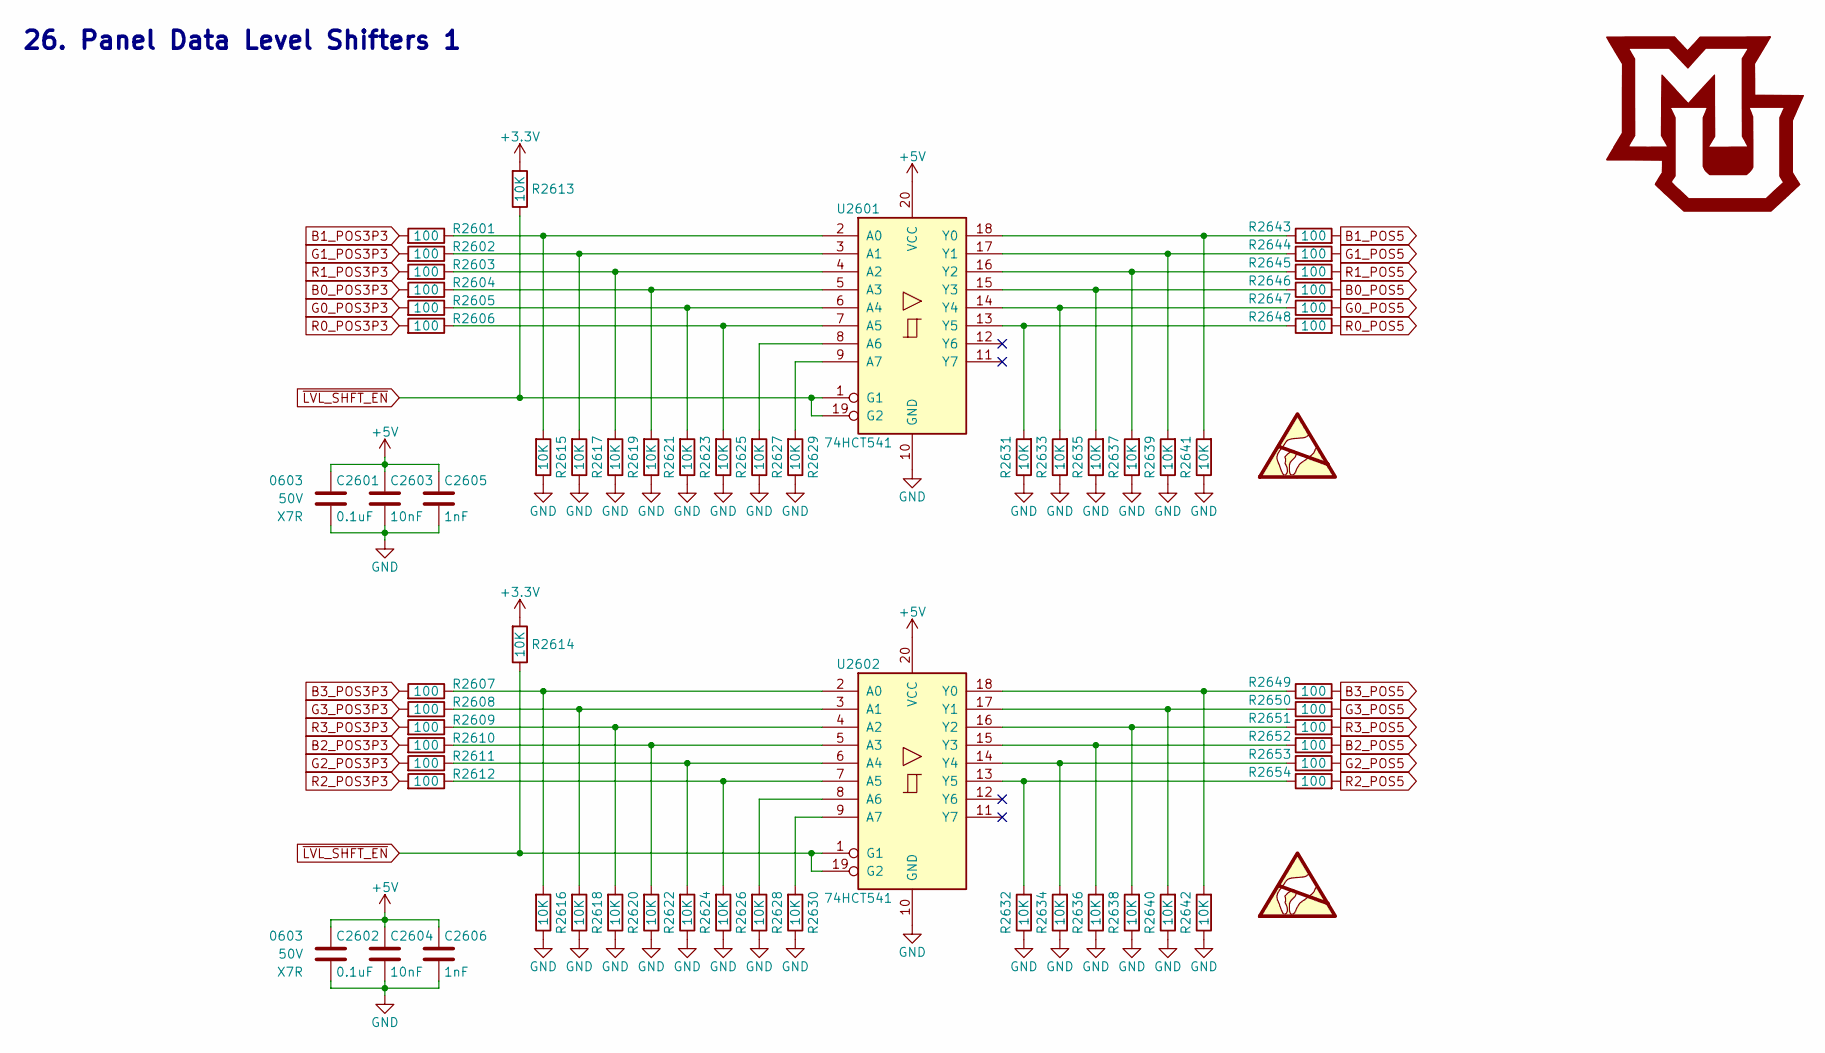
[picture p87: schematic Panel_Data_Level_Shifters_1.sch, Electronic Display Logic Board]

Parts:
C2601, C2602: 0.1uF; C_0603; Voltage 50V; Digi-Key PN 311-1344-1-ND
C2603, C2604: 10nF; C_0603; Voltage 50V; Digi-Key PN 1276-1921-1-ND
C2605, C2606: 1nF; C_0603; Voltage 50V; Digi-Key PN 1276-1018-1-ND
R2601, R2602, R2603, R2604, R2605, R2606, R2607, R2608, R2609, R2610, R2611, R2612, R2643, R2644, R2645, R2646, R2647, R2648, R2649, R2650, R2651, R2652, R2653, R2654: 100; R_0603; Tolerance 1%; Digi-Key PN A106047CT-ND
R2613, R2614, R2615, R2616, R2617, R2618, R2619, R2620, R2621, R2622, R2623, R2624, R2625, R2626, R2627, R2628, R2629, R2630, R2631, R2632, R2633, R2634, R2635, R2636, R2637, R2638, R2639, R2640, R2641, R2642: 10K; R_0603; Tolerance 1%; Digi-Key PN RMCF0603FT10K0CT-ND
U2601, U2602: 74HCT541; TSSOP-20_4.4x6.5mm_Pitch0.65mm; Digi-Key PN 296-26499-1-ND

Connections:
+3V3: R2613.1, R2614.1; also elsewhere on the board
+5V: C2601.1, C2602.1, C2603.1, C2604.1, C2605.1, C2606.1, U2601.20 (VCC), U2602.20 (VCC); also elsewhere on the board
B0_POS3P3: R2604.1; also elsewhere on the board
B0_POS5: R2646.1; also elsewhere on the board
B1_POS3P3: R2601.1; also elsewhere on the board
B1_POS5: R2643.1; also elsewhere on the board
B2_POS3P3: R2610.1; also elsewhere on the board
B2_POS5: R2652.1; also elsewhere on the board
B3_POS3P3: R2607.1; also elsewhere on the board
B3_POS5: R2649.1; also elsewhere on the board
G0_POS3P3: R2605.1; also elsewhere on the board
G0_POS5: R2647.1; also elsewhere on the board
G1_POS3P3: R2602.1; also elsewhere on the board
G1_POS5: R2644.1; also elsewhere on the board
G2_POS3P3: R2611.1; also elsewhere on the board
G2_POS5: R2653.1; also elsewhere on the board
G3_POS3P3: R2608.1; also elsewhere on the board
G3_POS5: R2650.1; also elsewhere on the board
GND: C2601.2, C2602.2, C2603.2, C2604.2, C2605.2, C2606.2, R2615.2, R2616.2, R2617.2, R2618.2, R2619.2, R2620.2, R2621.2, R2622.2, R2623.2, R2624.2, R2625.2, R2626.2, R2627.2, R2628.2, R2629.2, R2630.2, R2631.2, R2632.2, R2633.2, R2634.2, R2635.2, R2636.2, R2637.2, R2638.2, R2639.2, R2640.2, R2641.2, R2642.2, U2601.10 (GND), U2602.10 (GND); also elsewhere on the board
unnamed: R2601.2, R2615.1, U2601.2 (A0)
unnamed: R2602.2, R2617.1, U2601.3 (A1)
unnamed: R2603.2, R2619.1, U2601.4 (A2)
unnamed: R2604.2, R2621.1, U2601.5 (A3)
unnamed: R2605.2, R2623.1, U2601.6 (A4)
unnamed: R2606.2, R2625.1, U2601.7 (A5)
unnamed: R2607.2, R2616.1, U2602.2 (A0)
unnamed: R2608.2, R2618.1, U2602.3 (A1)
unnamed: R2609.2, R2620.1, U2602.4 (A2)
unnamed: R2610.2, R2622.1, U2602.5 (A3)
unnamed: R2611.2, R2624.1, U2602.6 (A4)
unnamed: R2612.2, R2626.1, U2602.7 (A5)
unnamed: R2627.1, U2601.8 (A6)
unnamed: R2628.1, U2602.8 (A6)
unnamed: R2629.1, U2601.9 (A7)
unnamed: R2630.1, U2602.9 (A7)
unnamed: R2631.1, R2648.2, U2601.13 (Y5)
unnamed: R2632.1, R2654.2, U2602.13 (Y5)
unnamed: R2633.1, R2647.2, U2601.14 (Y4)
unnamed: R2634.1, R2653.2, U2602.14 (Y4)
unnamed: R2635.1, R2646.2, U2601.15 (Y3)
unnamed: R2636.1, R2652.2, U2602.15 (Y3)
unnamed: R2637.1, R2645.2, U2601.16 (Y2)
unnamed: R2638.1, R2651.2, U2602.16 (Y2)
unnamed: R2639.1, R2644.2, U2601.17 (Y1)
unnamed: R2640.1, R2650.2, U2602.17 (Y1)
unnamed: R2641.1, R2643.2, U2601.18 (Y0)
unnamed: R2642.1, R2649.2, U2602.18 (Y0)
R0_POS3P3: R2606.1; also elsewhere on the board
R0_POS5: R2648.1; also elsewhere on the board
R1_POS3P3: R2603.1; also elsewhere on the board
R1_POS5: R2645.1; also elsewhere on the board
R2_POS3P3: R2612.1; also elsewhere on the board
R2_POS5: R2654.1; also elsewhere on the board
R3_POS3P3: R2609.1; also elsewhere on the board
R3_POS5: R2651.1; also elsewhere on the board
~LVL_SHFT_EN: R2613.2, R2614.2, U2601.1 (G1), U2601.19 (G2), U2602.1 (G1), U2602.19 (G2); also elsewhere on the board

Notes on the sheet:
26. Panel Data Level Shifters 1
