drewsum/Electronic_Display/hdw/Logic_Board/LED_Display_Controller/LED_Display_Controller.kicad_pcb

## KiCad design hdw/Logic_Board/LED_Display_Controller/LED_Display_Controller.kicad_pcb (continued)

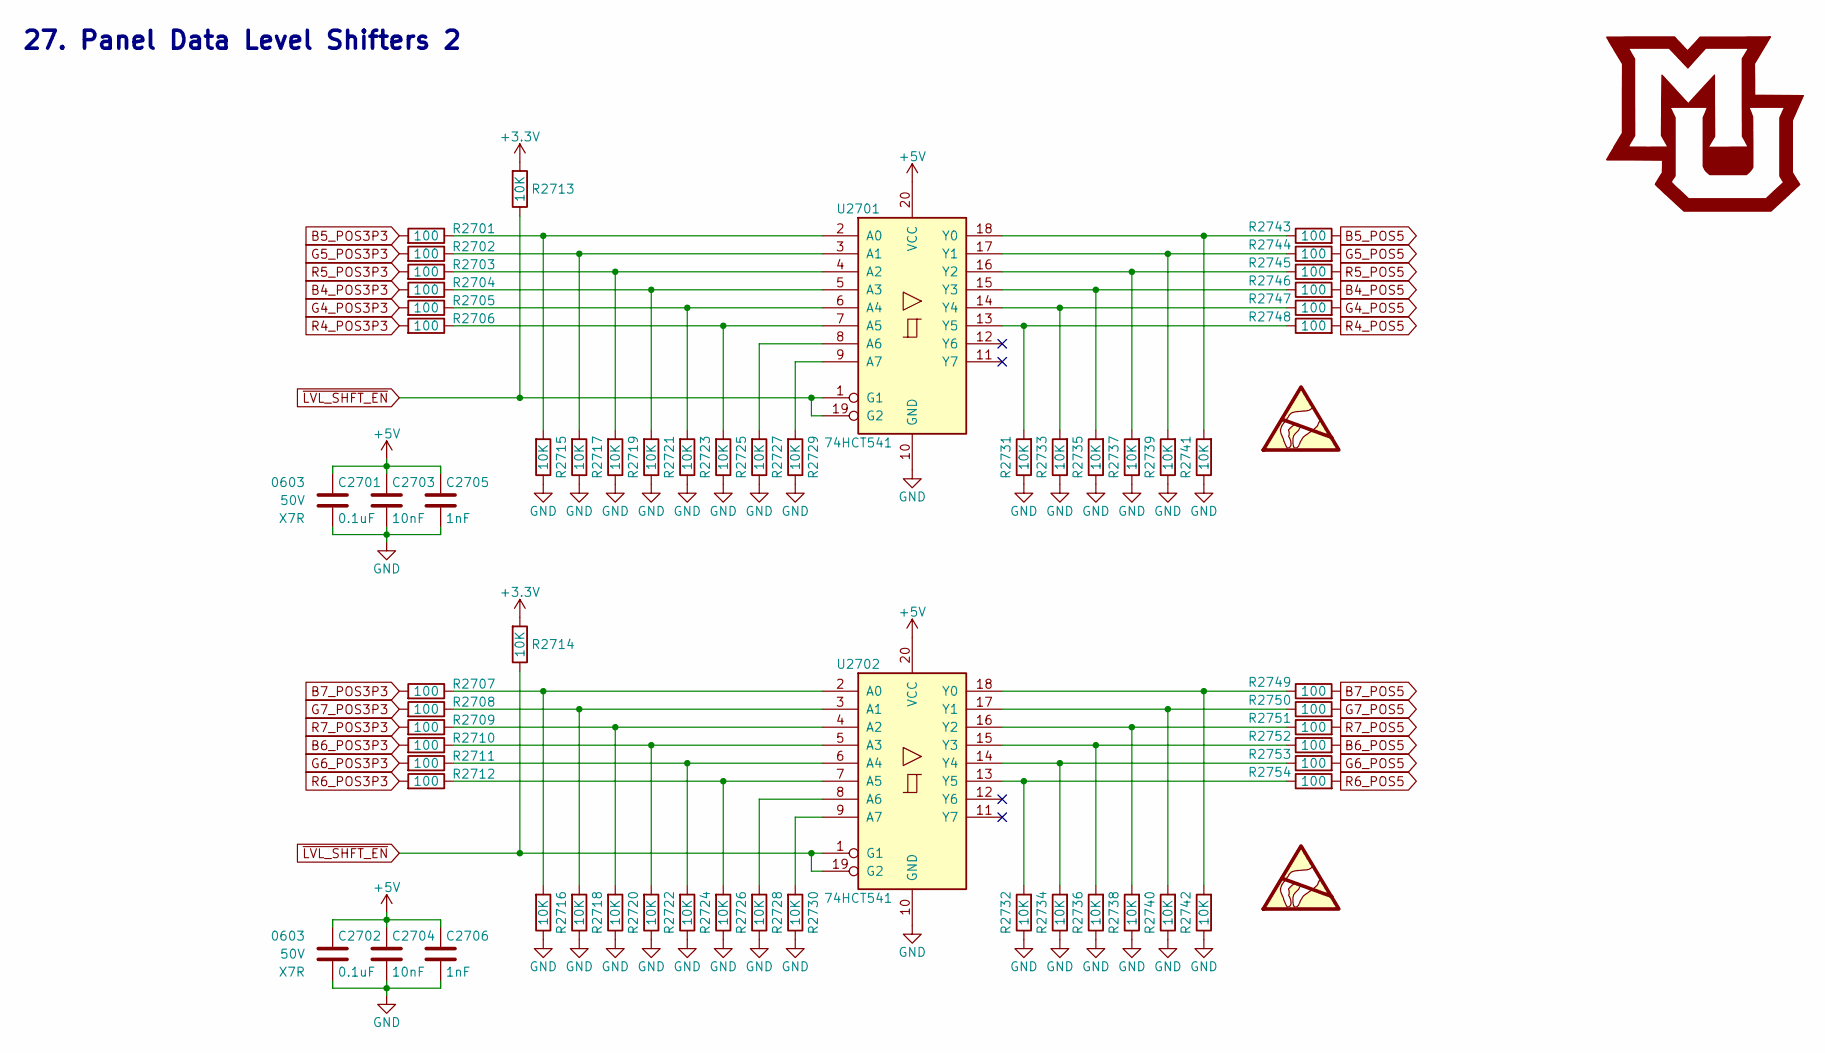
[picture p88: schematic Panel_Data_Level_Shifters_2.sch, Electronic Display Logic Board]

Parts:
C2701, C2702: 0.1uF; C_0603; Voltage 50V; Digi-Key PN 311-1344-1-ND
C2703, C2704: 10nF; C_0603; Voltage 50V; Digi-Key PN 1276-1921-1-ND
C2705, C2706: 1nF; C_0603; Voltage 50V; Digi-Key PN 1276-1018-1-ND
R2701, R2702, R2703, R2704, R2705, R2706, R2707, R2708, R2709, R2710, R2711, R2712, R2743, R2744, R2745, R2746, R2747, R2748, R2749, R2750, R2751, R2752, R2753, R2754: 100; R_0603; Tolerance 1%; Digi-Key PN A106047CT-ND
R2713, R2714, R2715, R2716, R2717, R2718, R2719, R2720, R2721, R2722, R2723, R2724, R2725, R2726, R2727, R2728, R2729, R2730, R2731, R2732, R2733, R2734, R2735, R2736, R2737, R2738, R2739, R2740, R2741, R2742: 10K; R_0603; Tolerance 1%; Digi-Key PN RMCF0603FT10K0CT-ND
U2701, U2702: 74HCT541; TSSOP-20_4.4x6.5mm_Pitch0.65mm; Digi-Key PN 296-26499-1-ND

Connections:
+3V3: R2713.1, R2714.1; also elsewhere on the board
+5V: C2701.1, C2702.1, C2703.1, C2704.1, C2705.1, C2706.1, U2701.20 (VCC), U2702.20 (VCC); also elsewhere on the board
B4_POS3P3: R2704.1; also elsewhere on the board
B4_POS5: R2746.1; also elsewhere on the board
B5_POS3P3: R2701.1; also elsewhere on the board
B5_POS5: R2743.1; also elsewhere on the board
B6_POS3P3: R2710.1; also elsewhere on the board
B6_POS5: R2752.1; also elsewhere on the board
B7_POS3P3: R2707.1; also elsewhere on the board
B7_POS5: R2749.1; also elsewhere on the board
G4_POS3P3: R2705.1; also elsewhere on the board
G4_POS5: R2747.1; also elsewhere on the board
G5_POS3P3: R2702.1; also elsewhere on the board
G5_POS5: R2744.1; also elsewhere on the board
G6_POS3P3: R2711.1; also elsewhere on the board
G6_POS5: R2753.1; also elsewhere on the board
G7_POS3P3: R2708.1; also elsewhere on the board
G7_POS5: R2750.1; also elsewhere on the board
GND: C2701.2, C2702.2, C2703.2, C2704.2, C2705.2, C2706.2, R2715.2, R2716.2, R2717.2, R2718.2, R2719.2, R2720.2, R2721.2, R2722.2, R2723.2, R2724.2, R2725.2, R2726.2, R2727.2, R2728.2, R2729.2, R2730.2, R2731.2, R2732.2, R2733.2, R2734.2, R2735.2, R2736.2, R2737.2, R2738.2, R2739.2, R2740.2, R2741.2, R2742.2, U2701.10 (GND), U2702.10 (GND); also elsewhere on the board
unnamed: R2701.2, R2715.1, U2701.2 (A0)
unnamed: R2702.2, R2717.1, U2701.3 (A1)
unnamed: R2703.2, R2719.1, U2701.4 (A2)
unnamed: R2704.2, R2721.1, U2701.5 (A3)
unnamed: R2705.2, R2723.1, U2701.6 (A4)
unnamed: R2706.2, R2725.1, U2701.7 (A5)
unnamed: R2707.2, R2716.1, U2702.2 (A0)
unnamed: R2708.2, R2718.1, U2702.3 (A1)
unnamed: R2709.2, R2720.1, U2702.4 (A2)
unnamed: R2710.2, R2722.1, U2702.5 (A3)
unnamed: R2711.2, R2724.1, U2702.6 (A4)
unnamed: R2712.2, R2726.1, U2702.7 (A5)
unnamed: R2727.1, U2701.8 (A6)
unnamed: R2728.1, U2702.8 (A6)
unnamed: R2729.1, U2701.9 (A7)
unnamed: R2730.1, U2702.9 (A7)
unnamed: R2731.1, R2748.2, U2701.13 (Y5)
unnamed: R2732.1, R2754.2, U2702.13 (Y5)
unnamed: R2733.1, R2747.2, U2701.14 (Y4)
unnamed: R2734.1, R2753.2, U2702.14 (Y4)
unnamed: R2735.1, R2746.2, U2701.15 (Y3)
unnamed: R2736.1, R2752.2, U2702.15 (Y3)
unnamed: R2737.1, R2745.2, U2701.16 (Y2)
unnamed: R2738.1, R2751.2, U2702.16 (Y2)
unnamed: R2739.1, R2744.2, U2701.17 (Y1)
unnamed: R2740.1, R2750.2, U2702.17 (Y1)
unnamed: R2741.1, R2743.2, U2701.18 (Y0)
unnamed: R2742.1, R2749.2, U2702.18 (Y0)
R4_POS3P3: R2706.1; also elsewhere on the board
R4_POS5: R2748.1; also elsewhere on the board
R5_POS3P3: R2703.1; also elsewhere on the board
R5_POS5: R2745.1; also elsewhere on the board
R6_POS3P3: R2712.1; also elsewhere on the board
R6_POS5: R2754.1; also elsewhere on the board
R7_POS3P3: R2709.1; also elsewhere on the board
R7_POS5: R2751.1; also elsewhere on the board
~LVL_SHFT_EN: R2713.2, R2714.2, U2701.1 (G1), U2701.19 (G2), U2702.1 (G1), U2702.19 (G2); also elsewhere on the board

Notes on the sheet:
27. Panel Data Level Shifters 2

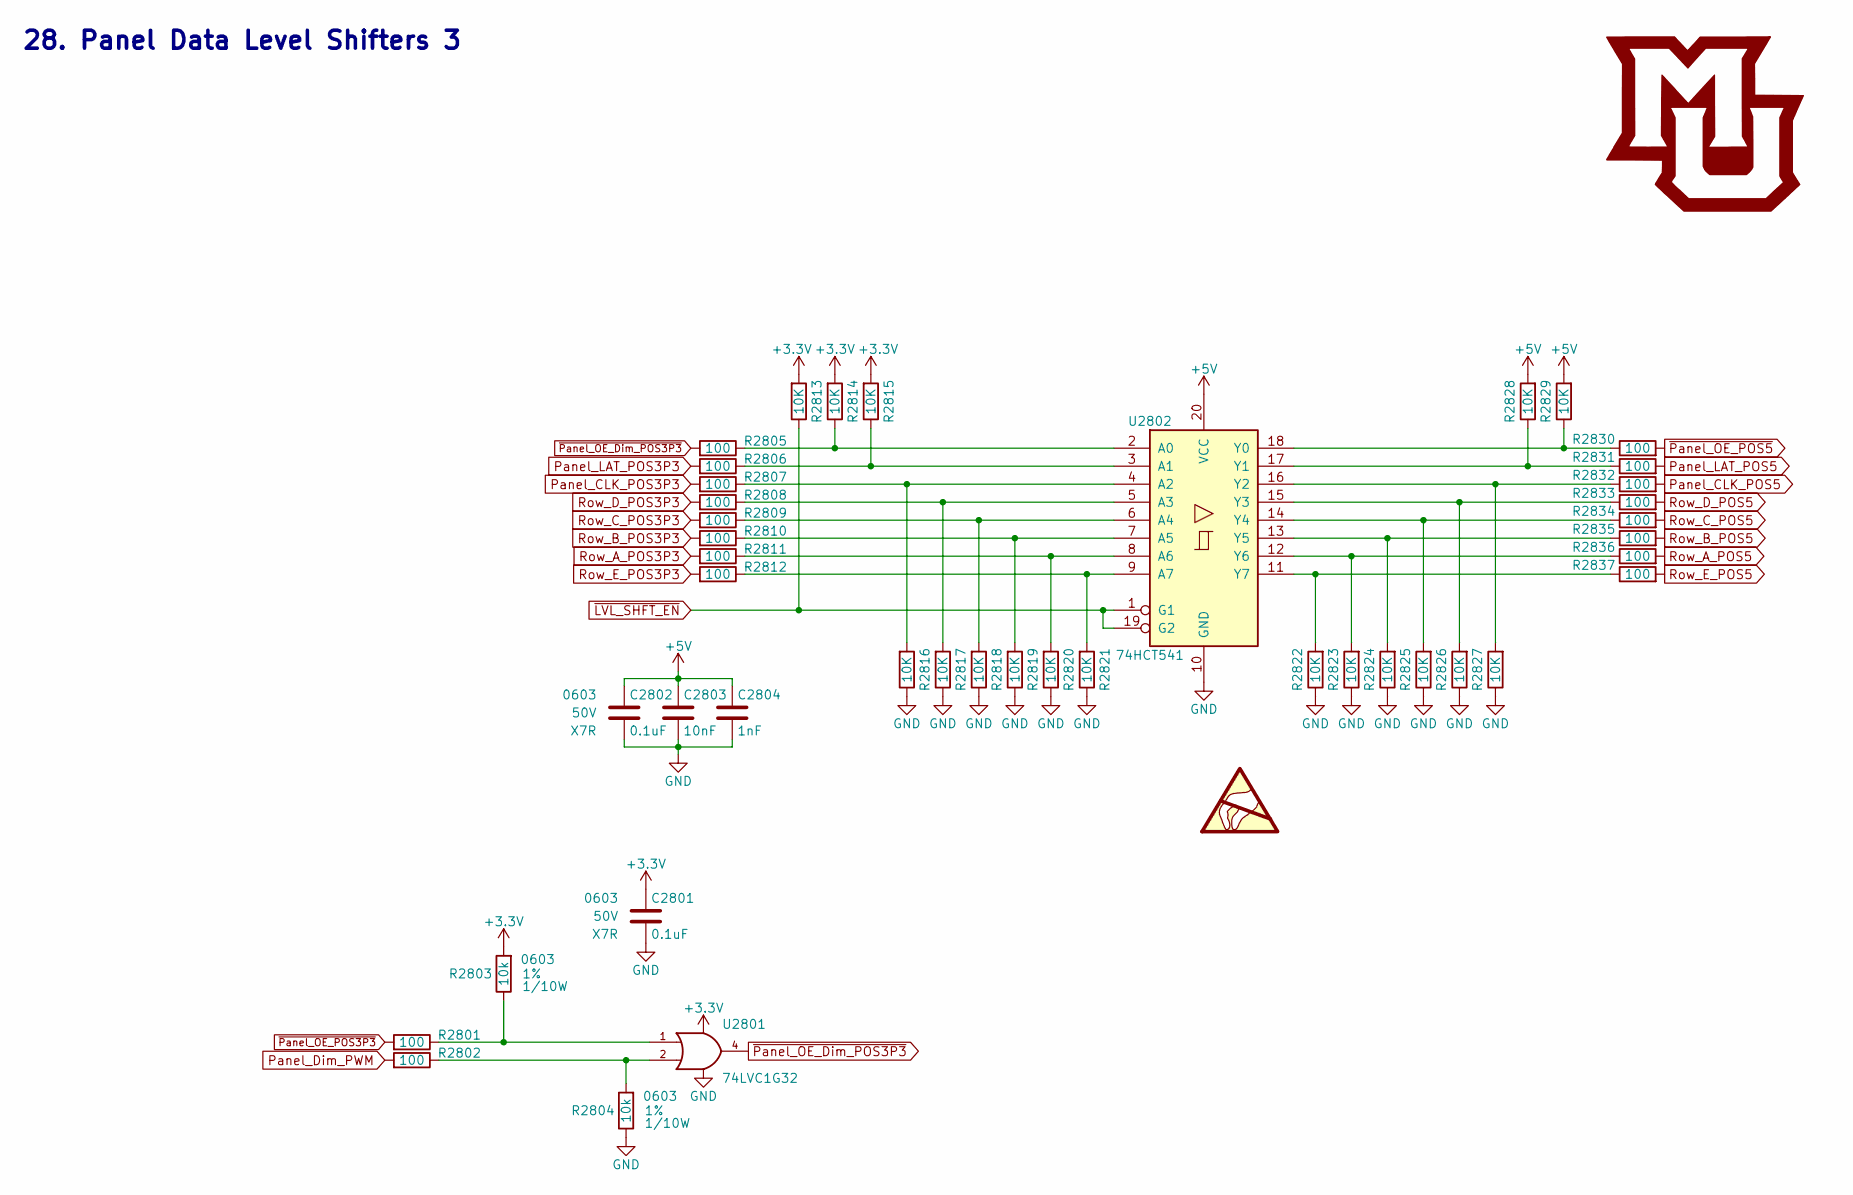
[picture p89: schematic Panel_Data_Level_Shifters_3.sch, Electronic Display Logic Board]

Parts:
C2801, C2802: 0.1uF; C_0603; Voltage 50V; Digi-Key PN 311-1344-1-ND
C2803: 10nF; C_0603; Voltage 50V; Digi-Key PN 1276-1921-1-ND
C2804: 1nF; C_0603; Voltage 50V; Digi-Key PN 1276-1018-1-ND
R2801, R2802, R2805, R2806, R2807, R2808, R2809, R2810, R2811, R2812, R2830, R2831, R2832, R2833, R2834, R2835, R2836, R2837: 100; R_0603; Tolerance 1%; Digi-Key PN A106047CT-ND
R2803, R2804: 10k; R_0603; Tolerance 1%; Digi-Key PN RMCF0603FT10K0CT-ND
R2813, R2814, R2815, R2816, R2817, R2818, R2819, R2820, R2821, R2822, R2823, R2824, R2825, R2826, R2827, R2828, R2829: 10K; R_0603; Tolerance 1%; Digi-Key PN RMCF0603FT10K0CT-ND
U2801: 74LVC1G32; SOT-353_SC-70-5; Digi-Key PN 296-9848-1-ND
U2802: 74HCT541; TSSOP-20_4.4x6.5mm_Pitch0.65mm; Digi-Key PN 296-26499-1-ND

Connections:
+3V3: C2801.1, R2803.1, R2813.1, R2814.1, R2815.1, U2801.5 (VCC); also elsewhere on the board
+5V: C2802.1, C2803.1, C2804.1, R2828.1, R2829.1, U2802.20 (VCC); also elsewhere on the board
GND: C2801.2, C2802.2, C2803.2, C2804.2, R2804.2, R2816.2, R2817.2, R2818.2, R2819.2, R2820.2, R2821.2, R2822.2, R2823.2, R2824.2, R2825.2, R2826.2, R2827.2, U2801.3 (GND), U2802.10 (GND); also elsewhere on the board
unnamed: R2801.2, R2803.2, U2801.1
unnamed: R2802.2, R2804.1, U2801.2
unnamed: R2805.2, R2814.2, U2802.2 (A0)
unnamed: R2806.2, R2815.2, U2802.3 (A1)
unnamed: R2807.2, R2816.1, U2802.4 (A2)
unnamed: R2808.2, R2817.1, U2802.5 (A3)
unnamed: R2809.2, R2818.1, U2802.6 (A4)
unnamed: R2810.2, R2819.1, U2802.7 (A5)
unnamed: R2811.2, R2820.1, U2802.8 (A6)
unnamed: R2812.2, R2821.1, U2802.9 (A7)
unnamed: R2822.1, R2837.2, U2802.11 (Y7)
unnamed: R2823.1, R2836.2, U2802.12 (Y6)
unnamed: R2824.1, R2835.2, U2802.13 (Y5)
unnamed: R2825.1, R2834.2, U2802.14 (Y4)
unnamed: R2826.1, R2833.2, U2802.15 (Y3)
unnamed: R2827.1, R2832.2, U2802.16 (Y2)
unnamed: R2828.2, R2831.2, U2802.17 (Y1)
unnamed: R2829.2, R2830.2, U2802.18 (Y0)
Panel_CLK_POS3P3: R2807.1; also elsewhere on the board
Panel_CLK_POS5: R2832.1; also elsewhere on the board
Panel_Dim_PWM: R2802.1; also elsewhere on the board
Panel_LAT_POS3P3: R2806.1; also elsewhere on the board
Panel_LAT_POS5: R2831.1; also elsewhere on the board
Row_A_POS3P3: R2811.1; also elsewhere on the board
Row_A_POS5: R2836.1; also elsewhere on the board
Row_B_POS3P3: R2810.1; also elsewhere on the board
Row_B_POS5: R2835.1; also elsewhere on the board
Row_C_POS3P3: R2809.1; also elsewhere on the board
Row_C_POS5: R2834.1; also elsewhere on the board
Row_D_POS3P3: R2808.1; also elsewhere on the board
Row_D_POS5: R2833.1; also elsewhere on the board
Row_E_POS3P3: R2812.1; also elsewhere on the board
Row_E_POS5: R2837.1; also elsewhere on the board
~LVL_SHFT_EN: R2813.2, U2802.1 (G1), U2802.19 (G2); also elsewhere on the board
~Panel_OE_Dim_POS3P3: R2805.1, U2801.4
~Panel_OE_POS3P3: R2801.1; also elsewhere on the board
~Panel_OE_POS5: R2830.1; also elsewhere on the board

Notes on the sheet:
28. Panel Data Level Shifters 3

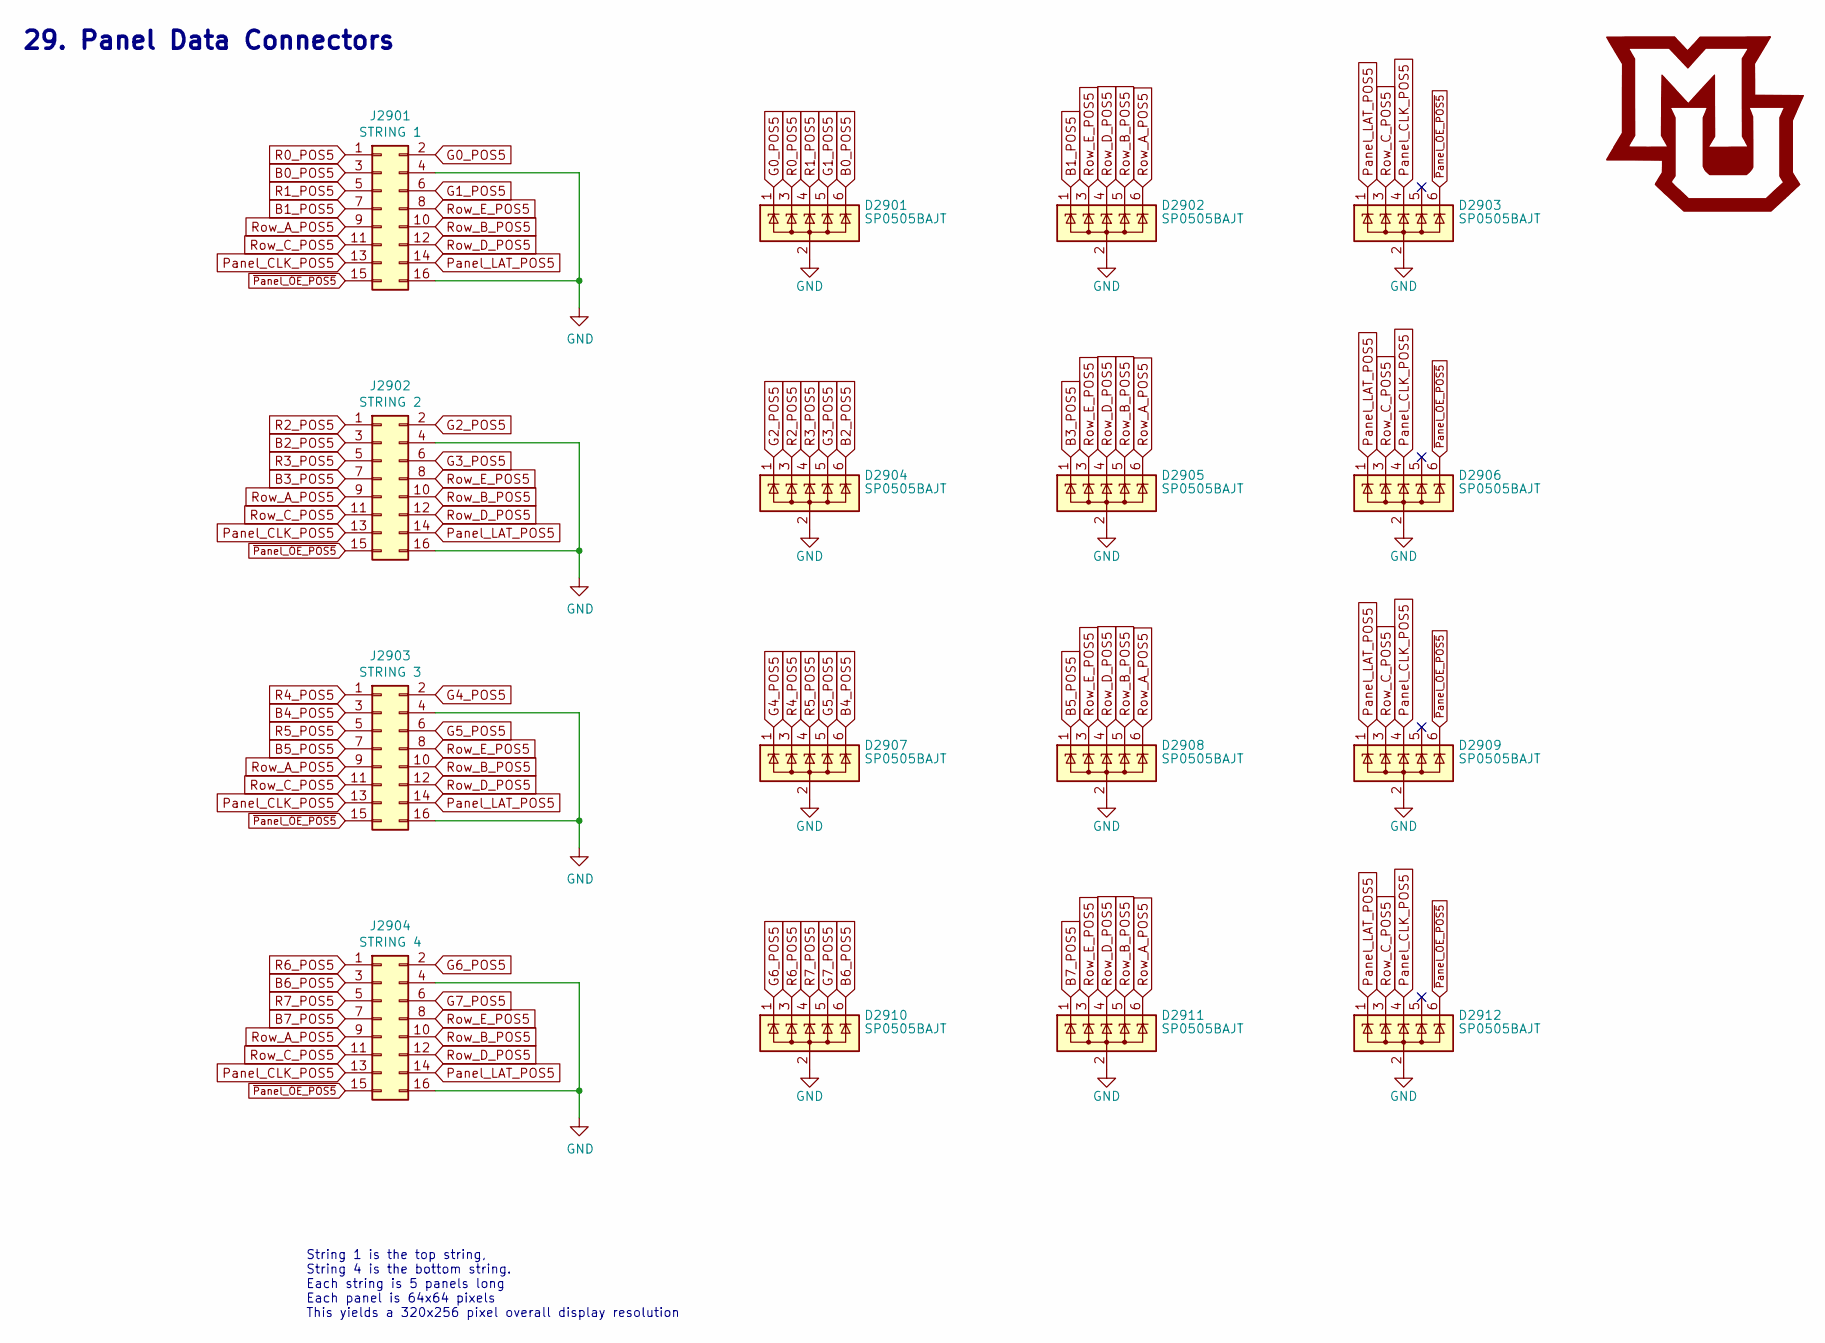
[picture p90: schematic Panel_Data_Connectors.sch, Electronic Display Logic Board]

Parts:
D2901, D2902, D2903, D2904, D2905, D2906, D2907, D2908, D2909, D2910, D2911, D2912: SP0505BAJT; SOT-363_SC-70-6; Digi-Key PN F3160CT-ND
J2901: STRING 1; IDC-Header_2x08_Pitch2.54mm_Straight; Digi-Key PN ED10523-ND
J2902: STRING 2; IDC-Header_2x08_Pitch2.54mm_Straight; Digi-Key PN ED10523-ND
J2903: STRING 3; IDC-Header_2x08_Pitch2.54mm_Straight; Digi-Key PN ED10523-ND
J2904: STRING 4; IDC-Header_2x08_Pitch2.54mm_Straight; Digi-Key PN ED10523-ND

Connections:
B0_POS5: D2901.6 (K), J2901.3; also elsewhere on the board
B1_POS5: D2902.1 (K), J2901.7; also elsewhere on the board
B2_POS5: D2904.6 (K), J2902.3; also elsewhere on the board
B3_POS5: D2905.1 (K), J2902.7; also elsewhere on the board
B4_POS5: D2907.6 (K), J2903.3; also elsewhere on the board
B5_POS5: D2908.1 (K), J2903.7; also elsewhere on the board
B6_POS5: D2910.6 (K), J2904.3; also elsewhere on the board
B7_POS5: D2911.1 (K), J2904.7; also elsewhere on the board
G0_POS5: D2901.1 (K), J2901.2; also elsewhere on the board
G1_POS5: D2901.5 (K), J2901.6; also elsewhere on the board
G2_POS5: D2904.1 (K), J2902.2; also elsewhere on the board
G3_POS5: D2904.5 (K), J2902.6; also elsewhere on the board
G4_POS5: D2907.1 (K), J2903.2; also elsewhere on the board
G5_POS5: D2907.5 (K), J2903.6; also elsewhere on the board
G6_POS5: D2910.1 (K), J2904.2; also elsewhere on the board
G7_POS5: D2910.5 (K), J2904.6; also elsewhere on the board
GND: D2901.2 (A), D2902.2 (A), D2903.2 (A), D2904.2 (A), D2905.2 (A), D2906.2 (A), D2907.2 (A), D2908.2 (A), D2909.2 (A), D2910.2 (A), D2911.2 (A), D2912.2 (A), J2901.4, J2901.16, J2902.4, J2902.16, J2903.4, J2903.16, J2904.4, J2904.16; also elsewhere on the board
Panel_CLK_POS5: D2903.4 (K), D2906.4 (K), D2909.4 (K), D2912.4 (K), J2901.13, J2902.13, J2903.13, J2904.13; also elsewhere on the board
Panel_LAT_POS5: D2903.1 (K), D2906.1 (K), D2909.1 (K), D2912.1 (K), J2901.14, J2902.14, J2903.14, J2904.14; also elsewhere on the board
R0_POS5: D2901.3 (K), J2901.1; also elsewhere on the board
R1_POS5: D2901.4 (K), J2901.5; also elsewhere on the board
R2_POS5: D2904.3 (K), J2902.1; also elsewhere on the board
R3_POS5: D2904.4 (K), J2902.5; also elsewhere on the board
R4_POS5: D2907.3 (K), J2903.1; also elsewhere on the board
R5_POS5: D2907.4 (K), J2903.5; also elsewhere on the board
R6_POS5: D2910.3 (K), J2904.1; also elsewhere on the board
R7_POS5: D2910.4 (K), J2904.5; also elsewhere on the board
Row_A_POS5: D2902.6 (K), D2905.6 (K), D2908.6 (K), D2911.6 (K), J2901.9, J2902.9, J2903.9, J2904.9; also elsewhere on the board
Row_B_POS5: D2902.5 (K), D2905.5 (K), D2908.5 (K), D2911.5 (K), J2901.10, J2902.10, J2903.10, J2904.10; also elsewhere on the board
Row_C_POS5: D2903.3 (K), D2906.3 (K), D2909.3 (K), D2912.3 (K), J2901.11, J2902.11, J2903.11, J2904.11; also elsewhere on the board
Row_D_POS5: D2902.4 (K), D2905.4 (K), D2908.4 (K), D2911.4 (K), J2901.12, J2902.12, J2903.12, J2904.12; also elsewhere on the board
Row_E_POS5: D2902.3 (K), D2905.3 (K), D2908.3 (K), D2911.3 (K), J2901.8, J2902.8, J2903.8, J2904.8; also elsewhere on the board
~Panel_OE_POS5: D2903.6 (K), D2906.6 (K), D2909.6 (K), D2912.6 (K), J2901.15, J2902.15, J2903.15, J2904.15; also elsewhere on the board

Notes on the sheet:
String 1 is the top string, String 4 is the bottom string. Each string is 5 panels long Each panel is 64x64 pixels This yields a 320x256 pixel overall display resolution
29. Panel Data Connectors

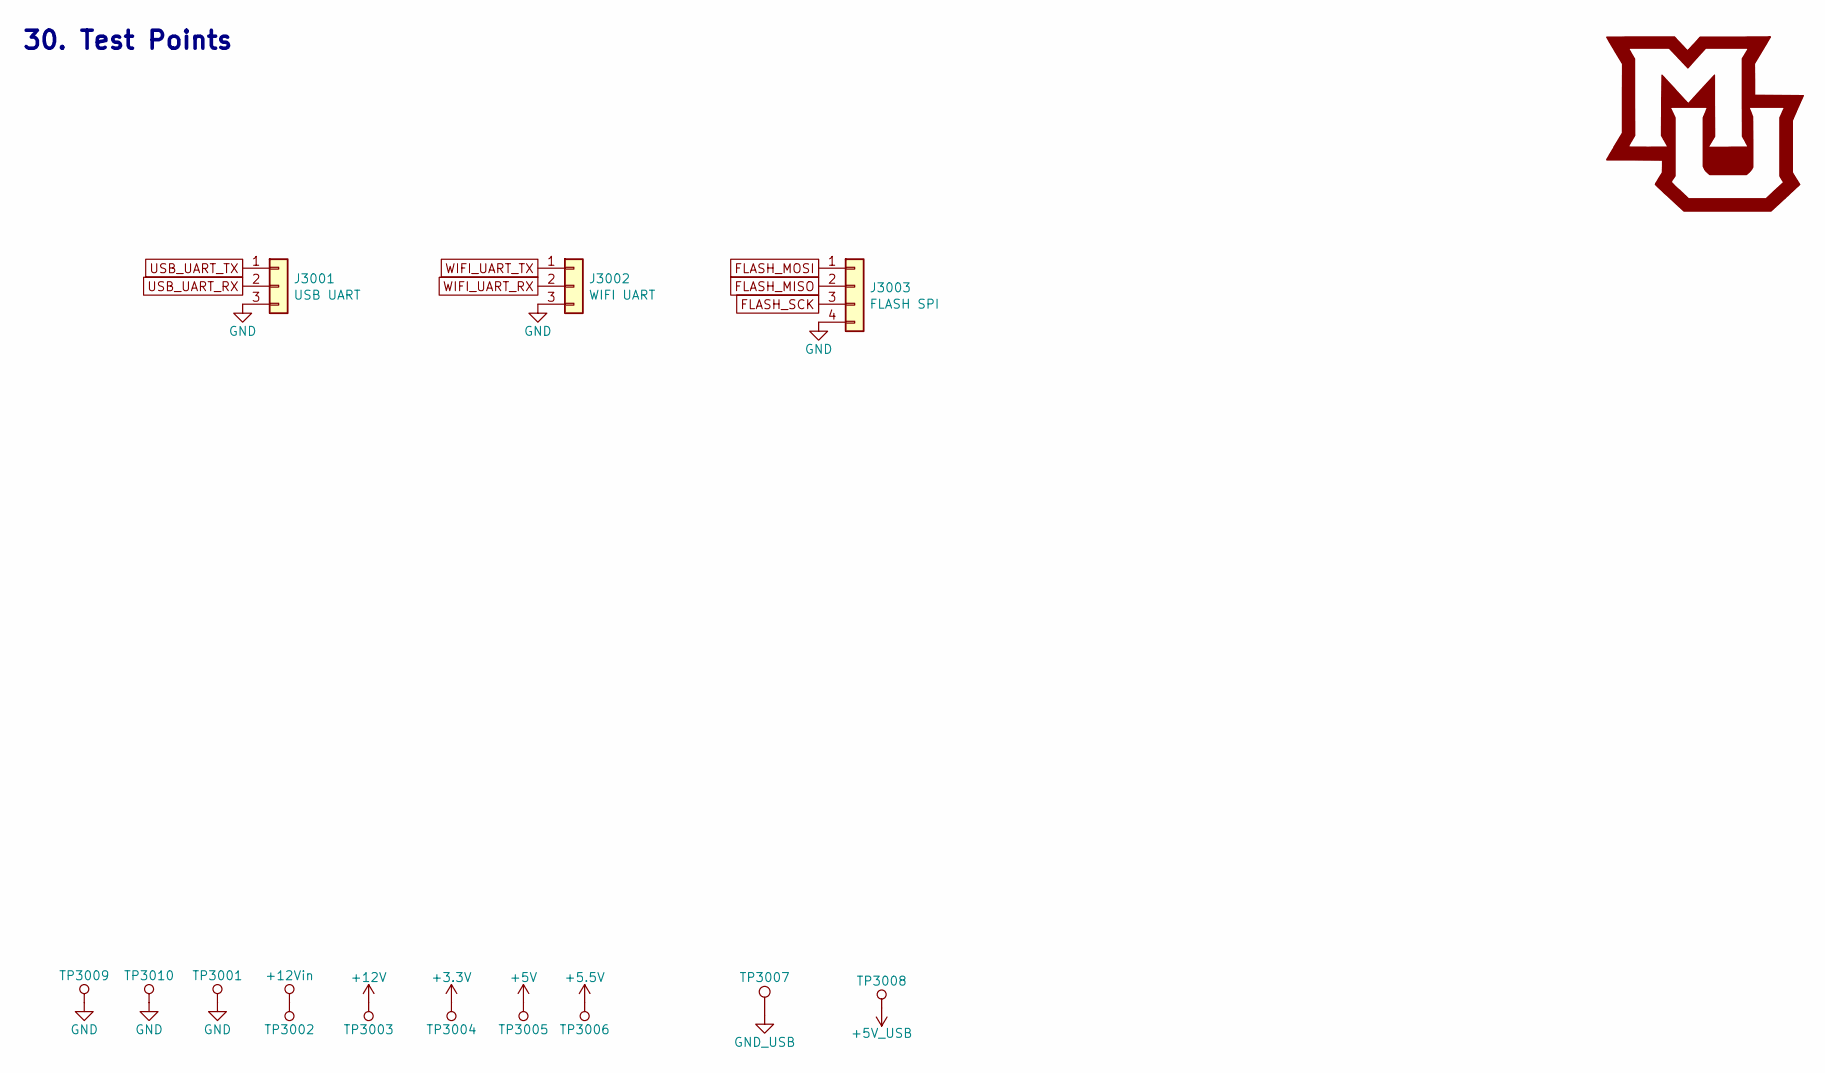
[picture p91: schematic Test_Points.sch, Electronic Display Logic Board]

Parts:
J3001: USB UART; Pin_Header_Straight_1x03_Pitch2.54mm
J3002: WIFI UART; Pin_Header_Straight_1x03_Pitch2.54mm
J3003: FLASH SPI; Pin_Header_Straight_1x04_Pitch2.54mm
TP3001, TP3007, TP3009, TP3010: TP; Pin_Header_Angled_1x01_Pitch2.54mm
TP3002, TP3003, TP3004, TP3005, TP3006, TP3008: TP; Measurement_Point_Round-SMD-Pad_Small

Connections:
+3V3: TP3004.1; also elsewhere on the board
+5.5V: TP3006.1; also elsewhere on the board
+5V: TP3005.1; also elsewhere on the board
+5V_USB: TP3008.1; also elsewhere on the board
+12V: TP3003.1; also elsewhere on the board
+12Vin: TP3002.1; also elsewhere on the board
FLASH_MISO: J3003.2; also elsewhere on the board
FLASH_MOSI: J3003.1; also elsewhere on the board
FLASH_SCK: J3003.3; also elsewhere on the board
GND: J3001.3, J3002.3, J3003.4, TP3001.1, TP3009.1, TP3010.1; also elsewhere on the board
GND_USB: TP3007.1; also elsewhere on the board
USB_UART_RX: J3001.2; also elsewhere on the board
USB_UART_TX: J3001.1; also elsewhere on the board
WIFI_UART_RX: J3002.2; also elsewhere on the board
WIFI_UART_TX: J3002.1; also elsewhere on the board

Notes on the sheet:
30. Test Points

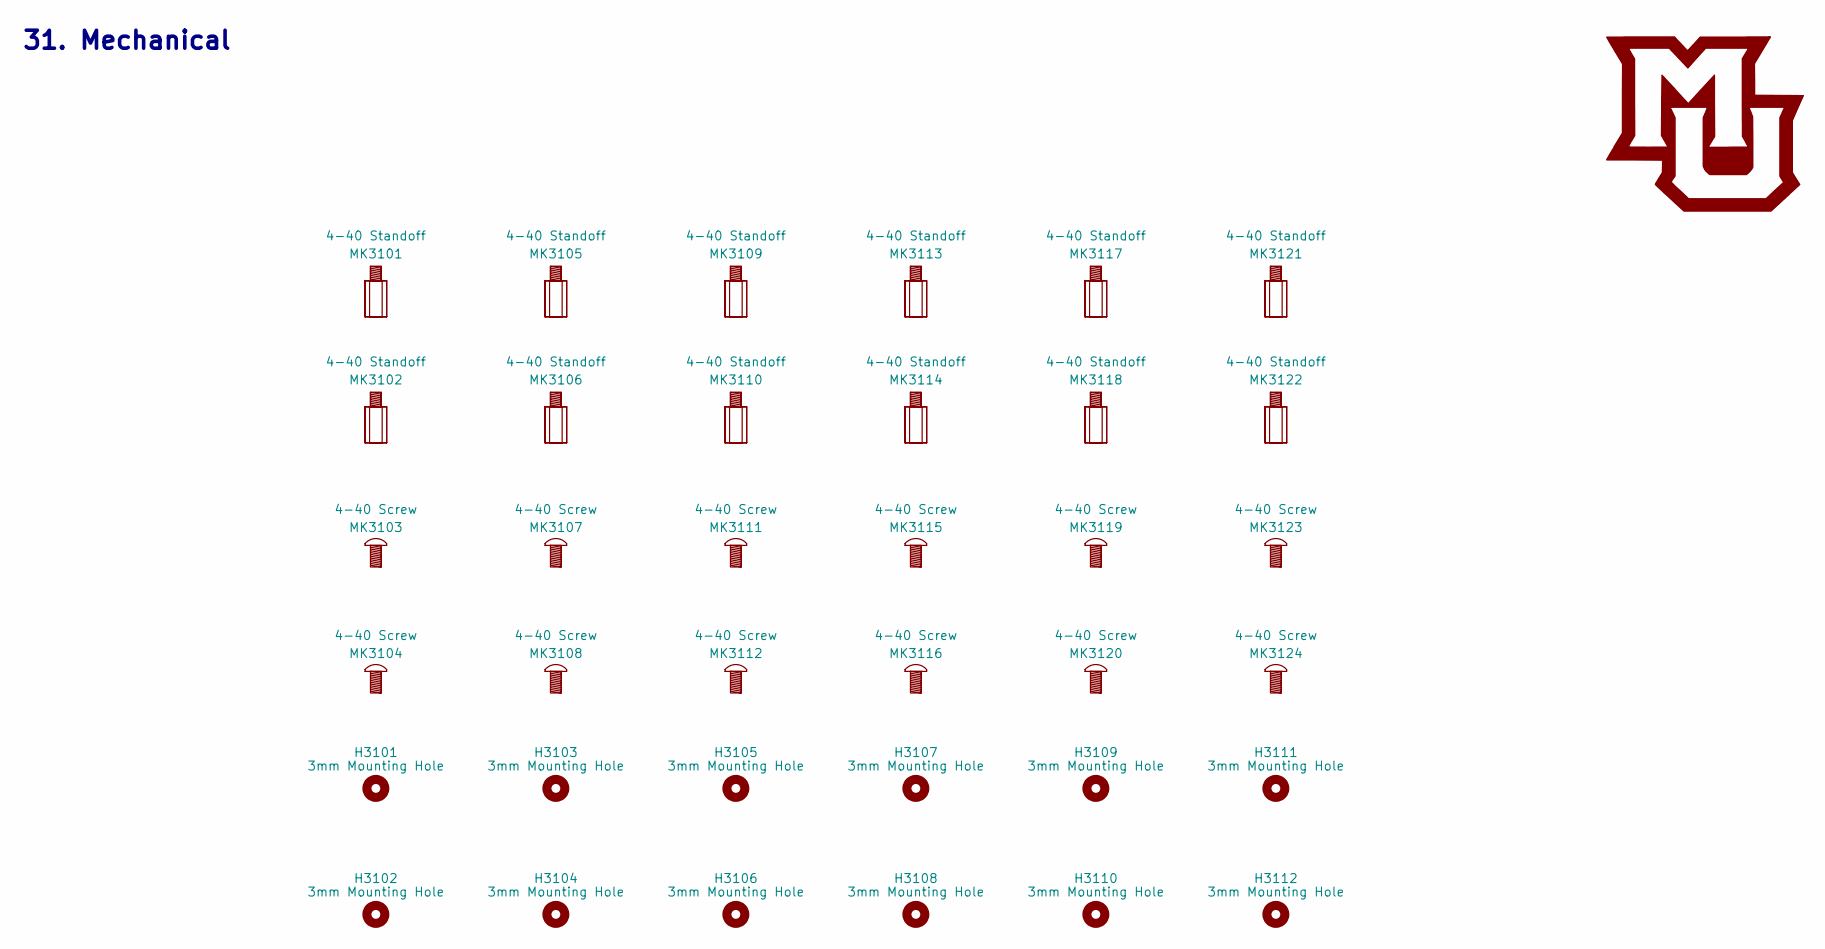
[picture p92: schematic Mechanical.sch, Electronic Display Logic Board]

Parts:
H3101, H3102, H3103, H3104, H3105, H3106, H3107, H3108, H3109, H3110, H3111, H3112: 3mm Mounting Hole; MountingHole_3mm_Pad_Via
MK3101, MK3102, MK3105, MK3106, MK3109, MK3110, MK3113, MK3114, MK3117, MK3118, MK3121, MK3122: 4-40 Standoff; Digi-Key PN 36-2204-ND
MK3103, MK3104, MK3107, MK3108, MK3111, MK3112, MK3115, MK3116, MK3119, MK3120, MK3123, MK3124: 4-40 Screw; Digi-Key PN 36-9900-ND

Notes on the sheet:
31. Mechanical

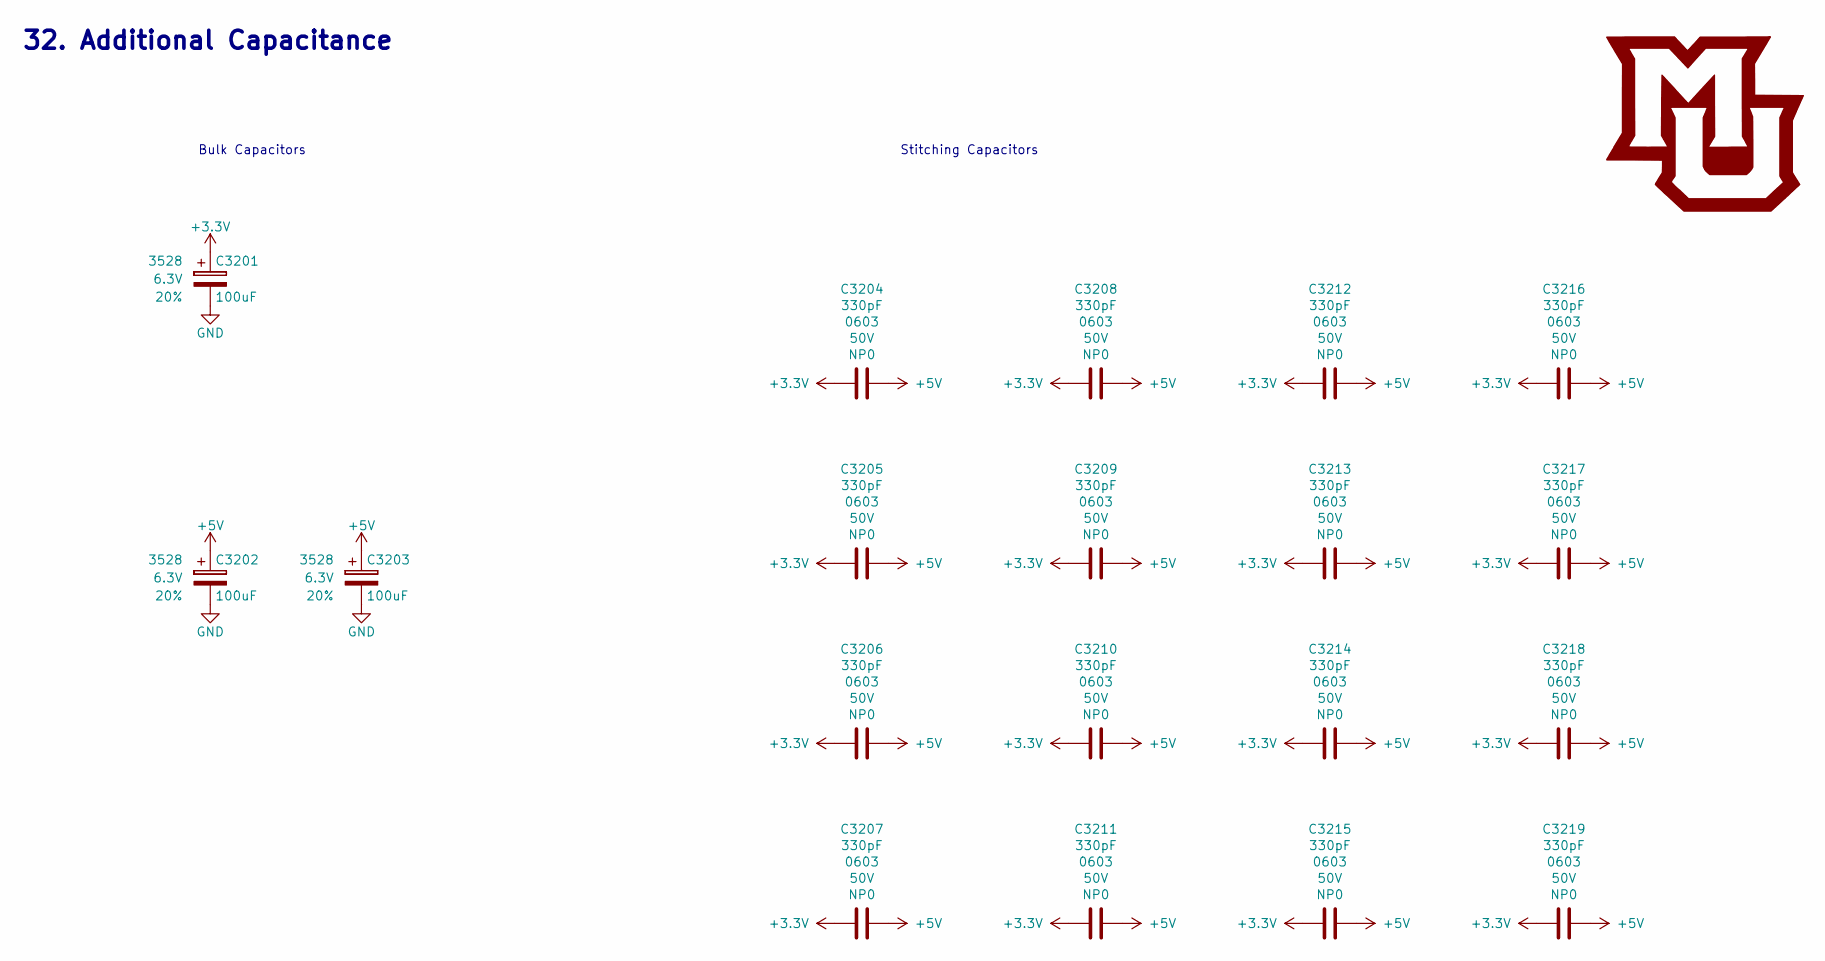
[picture p93: schematic Additional_Capacitance.sch, Electronic Display Logic Board]

Parts:
C3201, C3202, C3203: 100uF; CP_Tantalum_Case-B_EIA-3528-21_Reflow; Voltage 6.3V; Tolerance 20%; Digi-Key PN 478-3130-1-ND
C3204, C3205, C3206, C3207, C3208, C3209, C3210, C3211, C3212, C3213, C3214, C3215, C3216, C3217, C3218, C3219: 330pF; C_0603; Voltage 50V; Digi-Key PN 399-6880-1-ND

Connections:
+3V3: C3201.1, C3204.2, C3205.2, C3206.2, C3207.2, C3208.2, C3209.2, C3210.2, C3211.2, C3212.2, C3213.2, C3214.2, C3215.2, C3216.2, C3217.2, C3218.2, C3219.2; also elsewhere on the board
+5V: C3202.1, C3203.1, C3204.1, C3205.1, C3206.1, C3207.1, C3208.1, C3209.1, C3210.1, C3211.1, C3212.1, C3213.1, C3214.1, C3215.1, C3216.1, C3217.1, C3218.1, C3219.1; also elsewhere on the board
GND: C3201.2, C3202.2, C3203.2; also elsewhere on the board

Notes on the sheet:
32. Additional Capacitance
Bulk Capacitors
Stitching Capacitors

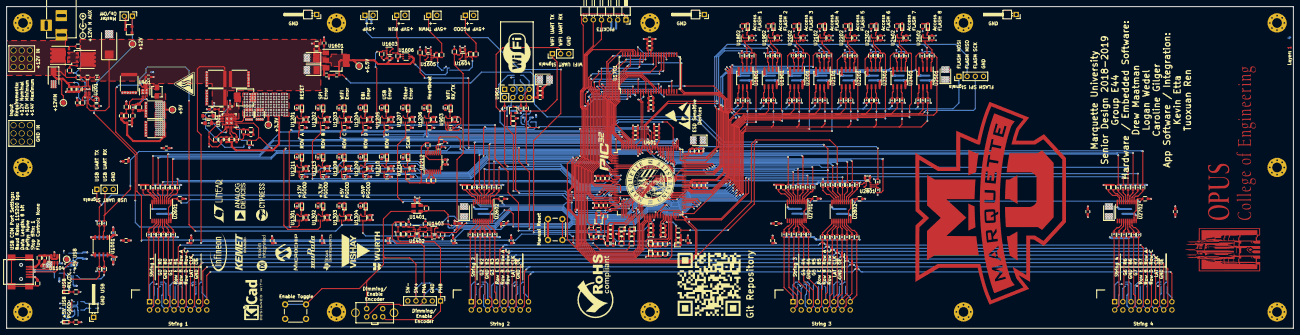
[picture p94: board LED_Display_Controller.kicad_pcb from above]

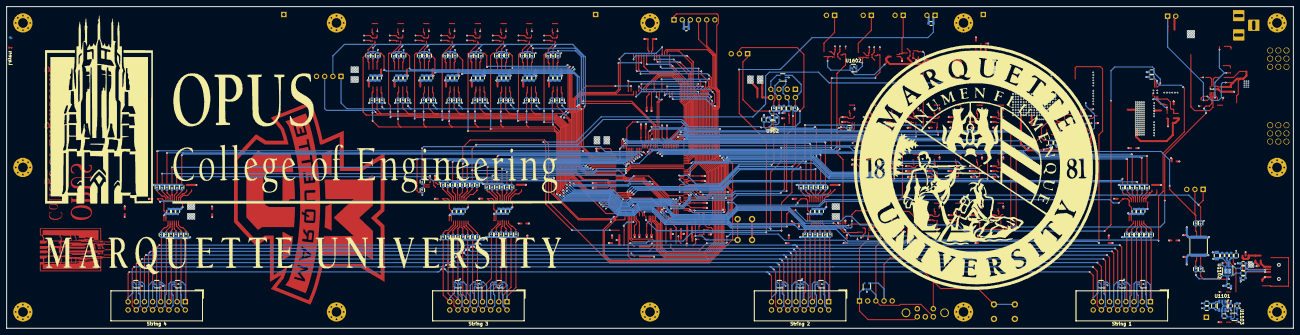
[picture p95: board LED_Display_Controller.kicad_pcb from below]

Board: 4 copper layers, 400.0 x 100.0 mm, 720 parts (122 on the bottom side), 405 nets.
