drewsum/Electronic_Display/hdw/Power_Board/LTC7851_Demo/LTC7851_Demo.kicad_pcb

## KiCad design hdw/Power_Board/LTC7851_Demo/LTC7851_Demo.kicad_pcb (2018-12-19)

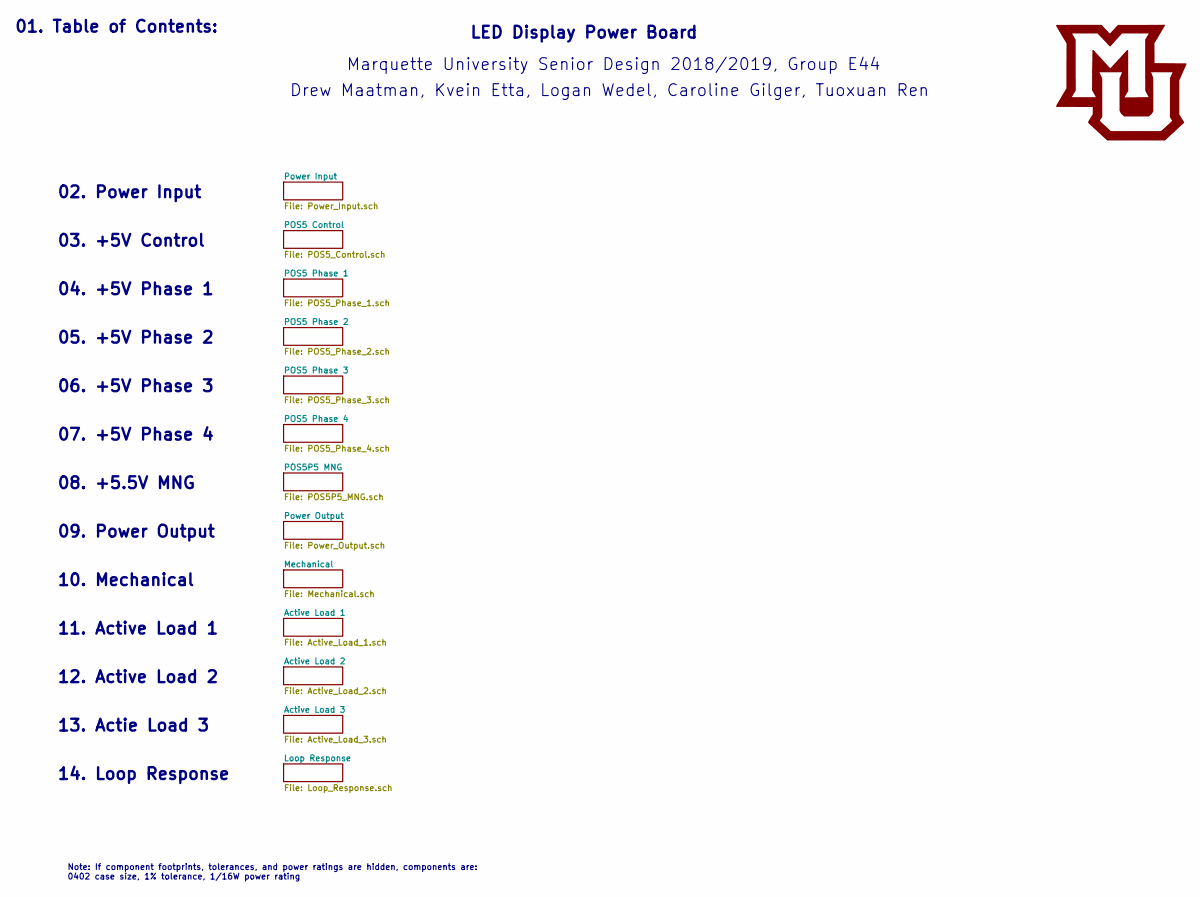
[picture p96: schematic LTC7851_Demo.sch, Electronic Display Power Board]

Notes on the sheet:
01. Table of Contents:
LED Display Power Board
Marquette University Senior Design 2018/2019, Group E44
Drew Maatman, Kvein Etta, Logan Wedel, Caroline Gilger, Tuoxuan Ren
02. Power Input
03. +5V Control
04. +5V Phase 1
05. +5V Phase 2
06. +5V Phase 3
07. +5V Phase 4
08. +5.5V MNG
09. Power Output
10. Mechanical
11. Active Load 1
12. Active Load 2
13. Actie Load 3
14. Loop Response
Note: If component footprints, tolerances, and power ratings are hidden, components are: 0402 case size, 1% tolerance, 1/16W power rating
