drewsum/Electronic_Display/hdw/Power_Board/LTC7851_Demo/LTC7851_Demo.kicad_pcb

## KiCad design hdw/Power_Board/LTC7851_Demo/LTC7851_Demo.kicad_pcb (continued)

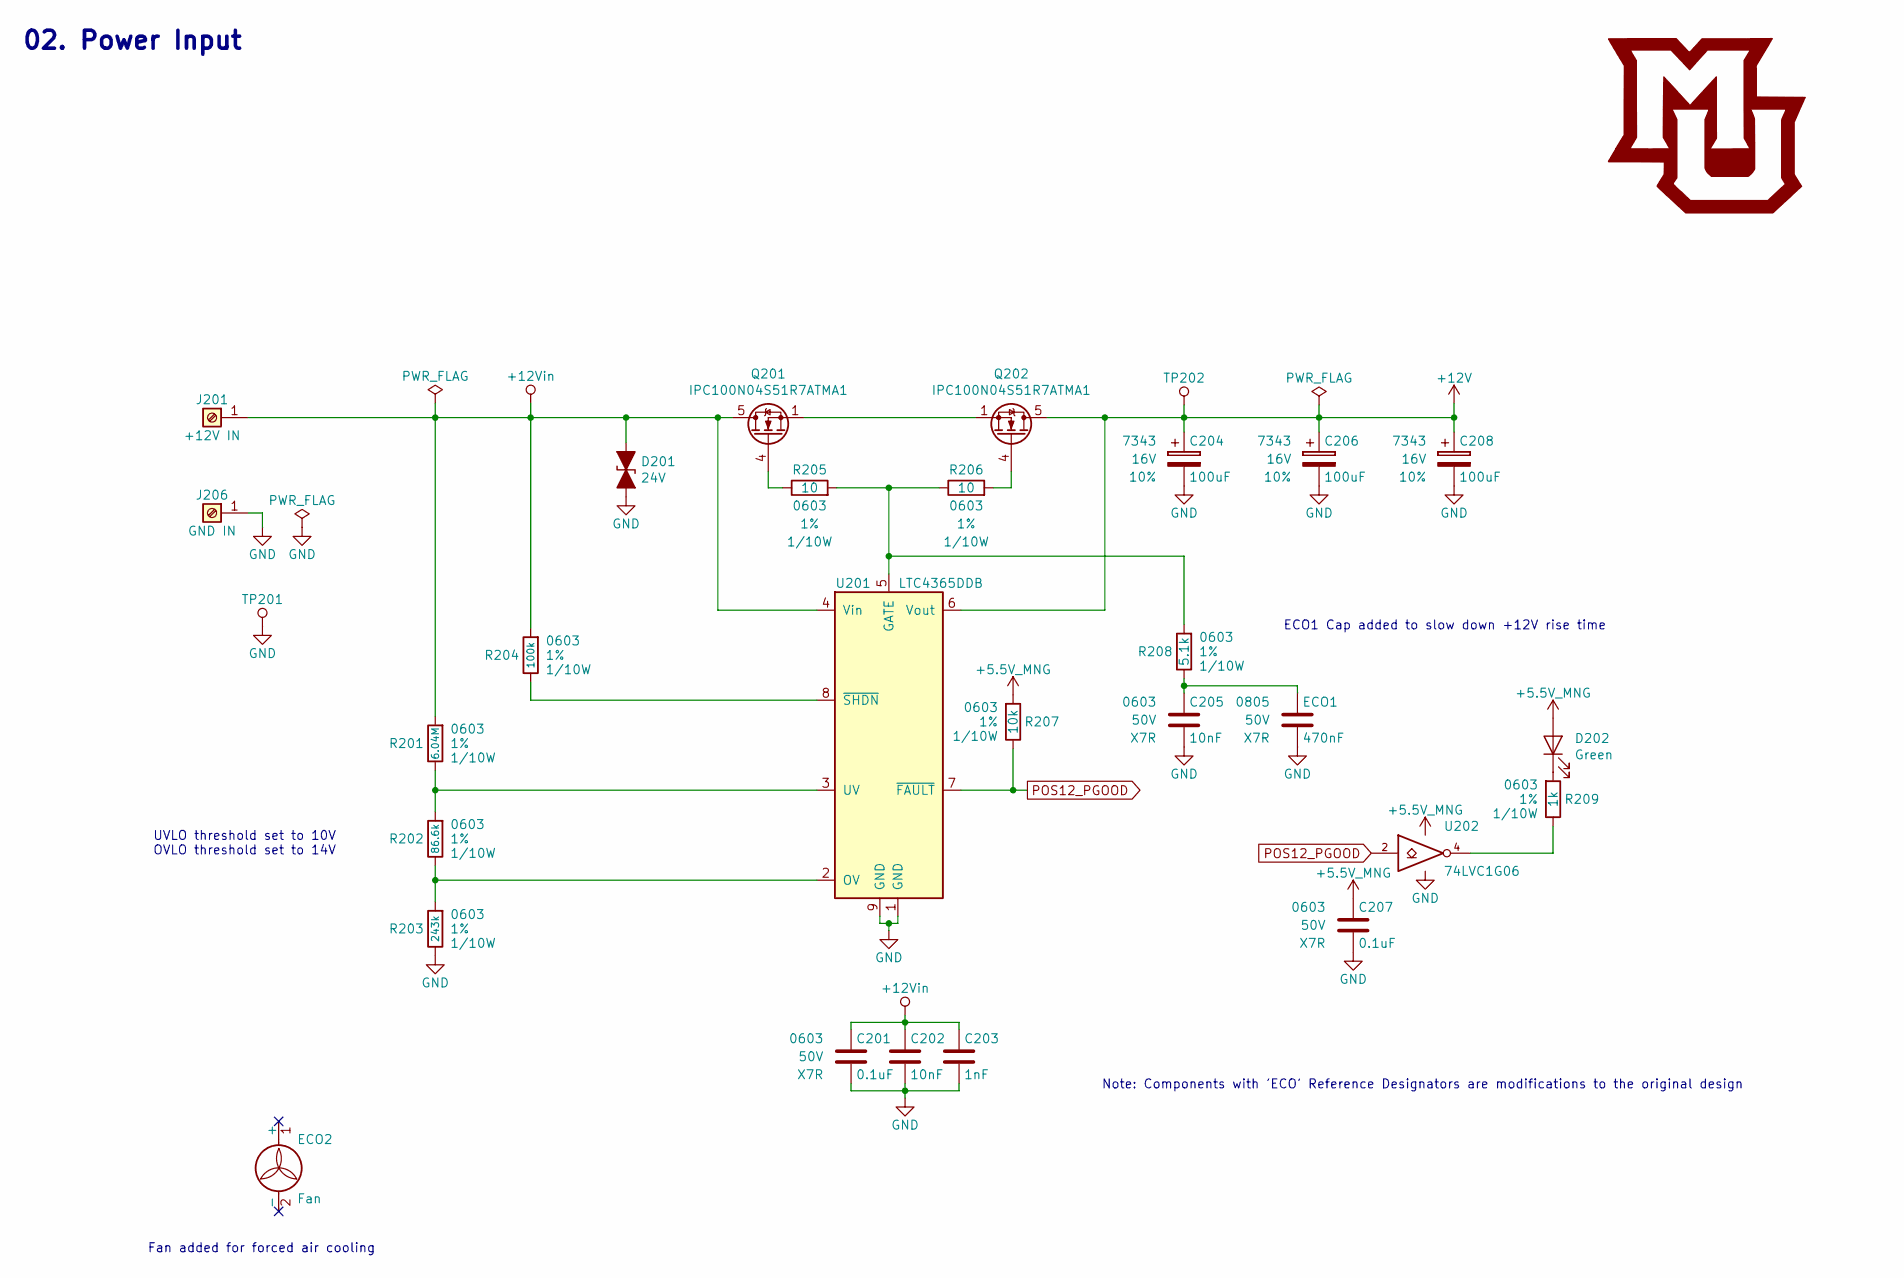
[picture p97: schematic Power_Input.sch, Electronic Display Power Board]

Parts:
C201, C207: 0.1uF; C_0603; Voltage 50V; Digi-Key PN 490-4779-1-ND
C202, C205: 10nF; C_0603; Voltage 50V; Digi-Key PN 1276-1921-1-ND
C203: 1nF; C_0603; Voltage 50V; Digi-Key PN 311-1080-1-ND
C204, C206, C208: 100uF; CP_Tantalum_Case-X_EIA-7343-43_Reflow; Voltage 16V; Tolerance 10%; Digi-Key PN 718-1102-1-ND
D201: 24V; D_SMA; Digi-Key PN SMAJ24CALFCT-ND
D202: Green; LED_0603; Digi-Key PN 160-1446-1-ND
ECO1: 470nF; Voltage 50V
ECO2: Fan
J201: +12V IN; Wuerth_7461096_M4_Shank_9pos; Digi-Key PN 732-3214-ND
J206: GND IN; Wuerth_7461096_M4_Shank_9pos; Digi-Key PN 732-3214-ND
Q201, Q202: IPC100N04S51R7ATMA1; TDSON-8-1; Digi-Key PN BSC123N10LSGATMA1CT-ND
R201: 6.04M; R_0603; Tolerance 1%; Digi-Key PN 541-6.04MHCT-ND
R202: 86.6k; R_0603; Tolerance 1%; Digi-Key PN 311-86.6KHRCT-ND
R203: 243k; R_0603; Tolerance 1%; Digi-Key PN 541-243KHCT-ND
R204: 100k; R_0603; Tolerance 1%; Digi-Key PN P100KHCT-ND
R205, R206: 10; R_0603; Tolerance 1%; Digi-Key PN YAG3351CT-ND
R207: 10k; R_0603; Tolerance 1%; Digi-Key PN RHM10KADCT-ND
R208: 5.1k; R_0603; Tolerance 1%; Digi-Key PN RMCF0603FT5K10CT-ND
R209: 1k; R_0603; Tolerance 1%; Digi-Key PN RHM1.0KDCT-ND
TP201: TP; Pin_Header_Angled_1x01_Pitch2.54mm
TP202: TP; Measurement_Point_Round-SMD-Pad_Small
U201: LTC4365DDB; DFN-8-1EP_2x3mm_Pitch0.5mm; Digi-Key PN LTC4365IDDB#TRMPBFCT-ND
U202: 74LVC1G06; SOT-353_SC-70-5; Digi-Key PN 296-8484-1-ND

Connections:
+5.5V_MNG: C207.1, D202.2 (A), R207.1, U202.5 (VCC); also elsewhere on the board
+12V: C204.1, C206.1, C208.1, Q202.5 (D), TP202.1, U201.6 (Vout); also elsewhere on the board
+12Vin: C201.1, C202.1, C203.1, D201.1 (A1), J201.1, Q201.5 (D), R201.1, R204.1, U201.4 (Vin)
GND: C201.2, C202.2, C203.2, C204.2, C205.2, C206.2, C207.2, C208.2, D201.2 (A2), ECO1.2, J206.1, R203.2, TP201.1, U201.1 (GND), U201.9 (GND), U202.3 (GND); also elsewhere on the board
unnamed: C205.1, ECO1.1, R208.2
unnamed: D202.1 (K), R209.1
unnamed: Q201.1 (S), Q201.2 (S), Q201.3 (S), Q202.1 (S), Q202.2 (S), Q202.3 (S)
unnamed: Q201.4 (G), R205.2
unnamed: Q202.4 (G), R206.1
unnamed: R201.2, R202.1, U201.3 (UV)
unnamed: R202.2, R203.1, U201.2 (OV)
unnamed: R204.2, U201.8 (~SHDN)
unnamed: R205.1, R206.2, R208.1, U201.5 (GATE)
unnamed: R209.2, U202.4
POS12_PGOOD: R207.2, U201.7 (~FAULT), U202.2

Notes on the sheet:
02. Power Input
ECO1 Cap added to slow down +12V rise time
Fan added for forced air cooling
Note: Components with 'ECO' Reference Designators are modifications to the original design
UVLO threshold set to 10V OVLO threshold set to 14V

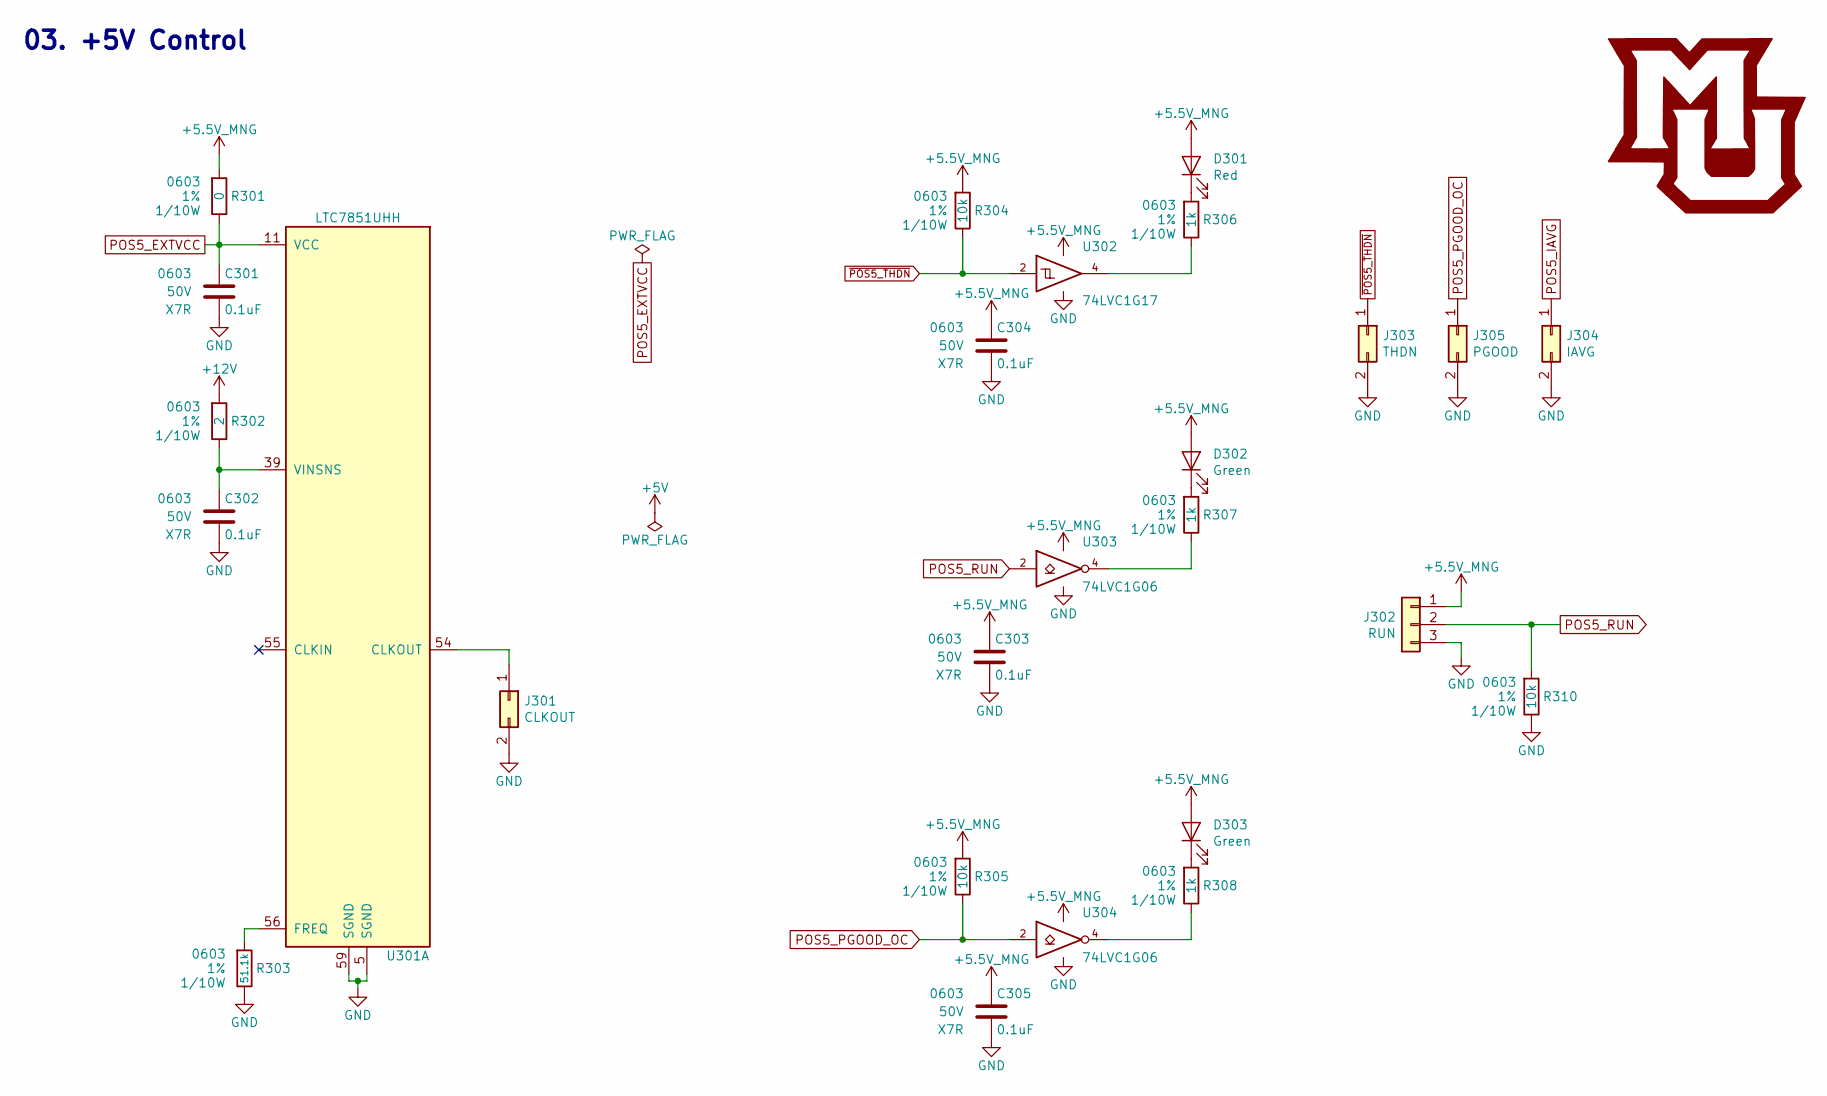
[picture p98: schematic POS5_Control.sch, Electronic Display Power Board]

Parts:
C301, C302, C303, C304, C305: 0.1uF; C_0603; Voltage 50V; Digi-Key PN 490-4779-1-ND
D301: Red; LED_0603; Digi-Key PN 160-1447-1-ND
D302, D303: Green; LED_0603; Digi-Key PN 160-1446-1-ND
J301: CLKOUT; Pin_Header_Straight_1x02_Pitch2.54mm
J302: RUN; Pin_Header_Straight_1x03_Pitch2.54mm
J303: THDN; Pin_Header_Straight_1x02_Pitch2.54mm
J304: IAVG; Pin_Header_Straight_1x02_Pitch2.54mm
J305: PGOOD; Pin_Header_Straight_1x02_Pitch2.54mm
R301: 0; R_0603; Tolerance 1%; Digi-Key PN 311-0.0GRCT-ND
R302: 2; R_0603; Tolerance 1%; Digi-Key PN RMCF0603FT2R00CT-ND
R303: 51.1k; R_0603; Tolerance 1%; Digi-Key PN P51.1KHCT-ND
R304, R305, R310: 10k; R_0603; Tolerance 1%; Digi-Key PN RHM10KADCT-ND
R306, R307, R308: 1k; R_0603; Tolerance 1%; Digi-Key PN RHM1.0KDCT-ND
U301: LTC7851UHH; QFN-58-1EP_9x5mm_Pitch0.4mm; Digi-Key PN LTC7851IUHH#PBF-ND
U302: 74LVC1G17; SOT-353_SC-70-5; Digi-Key PN 296-11934-1-ND
U303, U304: 74LVC1G06; SOT-353_SC-70-5; Digi-Key PN 296-8484-1-ND

Connections:
+5.5V_MNG: C303.1, C304.1, C305.1, D301.2 (A), D302.2 (A), D303.2 (A), J302.1, R301.1, R304.1, R305.1, U302.5 (VCC), U303.5 (VCC), U304.5 (VCC); also elsewhere on the board
+12V: R302.1; also elsewhere on the board
GND: C301.2, C302.2, C303.2, C304.2, C305.2, J301.2, J302.3, J303.2, J304.2, J305.2, R303.2, R310.2, U301.5 (SGND), U301.59 (SGND), U302.3 (GND), U303.3 (GND), U304.3 (GND); also elsewhere on the board
unnamed: C302.1, R302.2, U301.39 (VINSNS)
unnamed: D301.1 (K), R306.1
unnamed: D302.1 (K), R307.1
unnamed: D303.1 (K), R308.1
unnamed: J301.1, U301.54 (CLKOUT)
unnamed: R303.1, U301.56 (FREQ)
unnamed: R306.2, U302.4
unnamed: R307.2, U303.4
unnamed: R308.2, U304.4
POS5_EXTVCC: C301.1, R301.2, U301.11 (VCC); also elsewhere on the board
POS5_IAVG: J304.1; also elsewhere on the board
POS5_PGOOD_OC: J305.1, R305.2, U304.2; also elsewhere on the board
POS5_RUN: J302.2, R310.1, U303.2; also elsewhere on the board
~POS5_THDN: J303.1, R304.2, U302.2; also elsewhere on the board

Notes on the sheet:
03. +5V Control

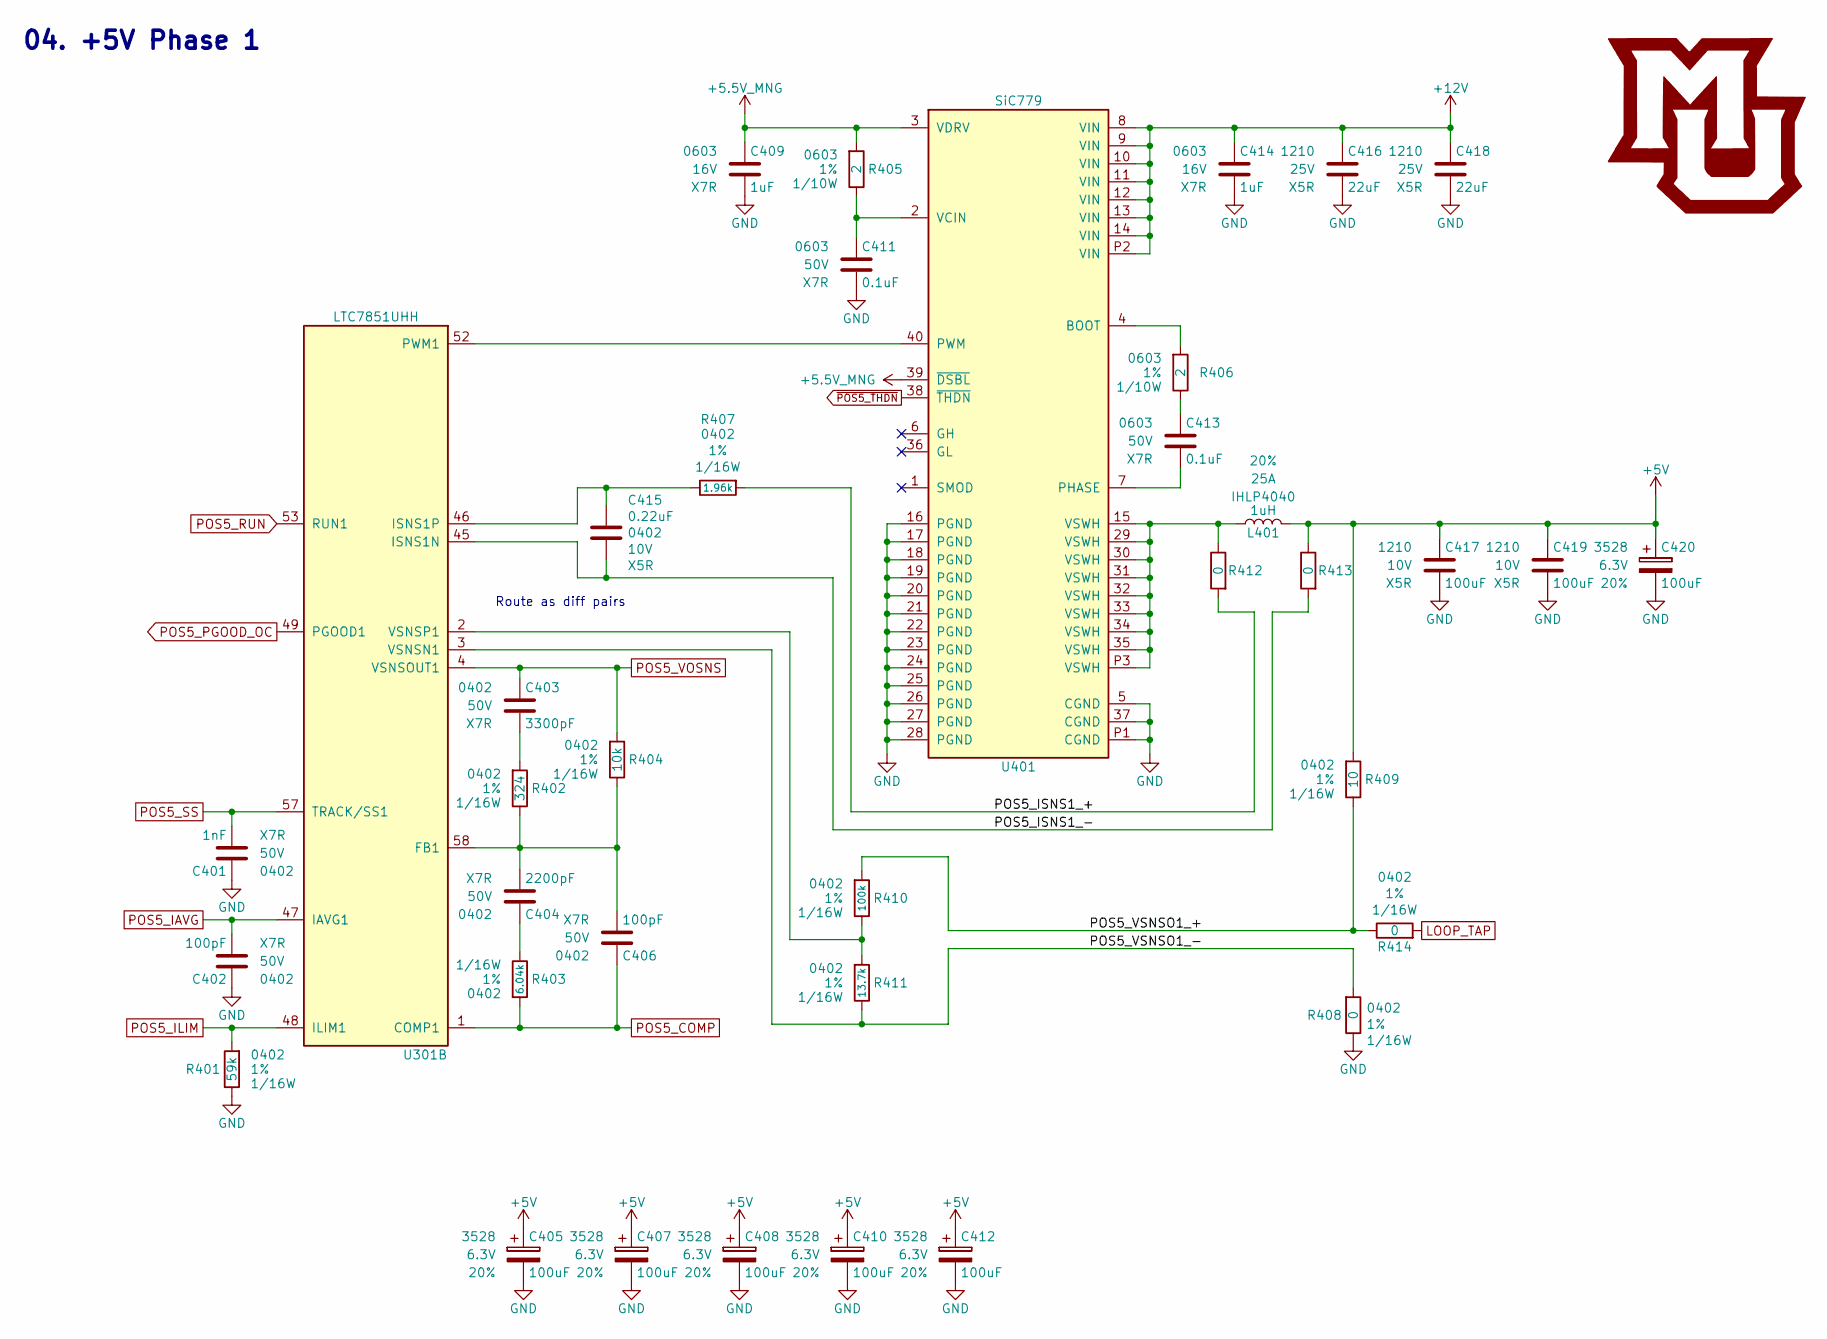
[picture p99: schematic POS5_Phase_1.sch, Electronic Display Power Board]

Parts:
C401: 1nF; C_0402; Voltage 50V; Digi-Key PN 311-1080-1-ND
C402, C406: 100pF; C_0402; Voltage 50V; Digi-Key PN 478-1089-1-ND
C403: 3300pF; C_0402; Voltage 50V; Digi-Key PN 478-5132-1-ND
C404: 2200pF; C_0402; Voltage 50V; Digi-Key PN 478-1105-1-ND
C405, C407, C408, C410, C412, C420: 100uF; CP_Tantalum_Case-B_EIA-3528-21_Reflow; Voltage 6.3V; Tolerance 20%; Digi-Key PN 478-9994-1-ND
C409, C414: 1uF; C_0603; Voltage 16V; Digi-Key PN 1276-6524-1-ND
C411, C413: 0.1uF; C_0603; Voltage 50V; Digi-Key PN 490-4779-1-ND
C415: 0.22uF; C_0402; Voltage 10V; Digi-Key PN 1276-1049-1-ND
C416, C418: 22uF; C_1210; Voltage 25V; Digi-Key PN 445-1436-1-ND
C417, C419: 100uF; C_1210; Voltage 10V; Digi-Key PN 587-3432-1-ND
L401: 1uH; L_Vishay_IHLP-4040; Tolerance 20%; Digi-Key PN 541-1306-1-ND
R401: 59k; R_0402; Tolerance 1%; Digi-Key PN P59KDCCT-ND
R402: 324; R_0402; Tolerance 1%; Digi-Key PN YAG3118CT-ND
R403: 6.04k; R_0402; Tolerance 1%; Digi-Key PN RMCF0402FT6K04CT-ND
R404: 10k; R_0402; Tolerance 1%; Digi-Key PN 311-10.0KLRCT-ND
R405, R406: 2; R_0603; Tolerance 1%; Digi-Key PN RMCF0603FT2R00CT-ND
R407: 1.96k; R_0402; Tolerance 1%; Digi-Key PN 311-1.96KLRCT-ND
R408, R412, R413, R414: 0; R_0402; Tolerance 1%; Digi-Key PN RMCF0402ZT0R00CT-ND
R409: 10; R_0402; Tolerance 1%; Digi-Key PN 311-10.0LRCT-ND
R410: 100k; R_0402; Tolerance 1%; Digi-Key PN 311-100KLRCT-ND
R411: 13.7k; R_0402; Tolerance 1%; Digi-Key PN 311-13.7KLRCT-ND
U301: LTC7851UHH; QFN-58-1EP_9x5mm_Pitch0.4mm; Digi-Key PN LTC7851IUHH#PBF-ND
U401: SiC779; MLP66-40_6x6mm_Pitch0.5mm; Digi-Key PN SIC779CD-T1-GE3CT-ND

Connections:
+5.5V_MNG: C409.1, R405.1, U401.3 (VDRV), U401.39 (~DSBL); also elsewhere on the board
+5V: C405.1, C407.1, C408.1, C410.1, C412.1, C417.1, C419.1, C420.1, L401.2, R409.1, R413.2; also elsewhere on the board
+12V: C414.1, C416.1, C418.1, U401.8 (VIN), U401.9 (VIN), U401.10 (VIN), U401.11 (VIN), U401.12 (VIN), U401.13 (VIN), U401.14 (VIN), U401.P2 (VIN); also elsewhere on the board
/POS5 Phase 1/POS5_ISNS1_+: R407.1, R412.1
/POS5 Phase 1/POS5_ISNS1_-: C415.1, R413.1, U301.45 (ISNS1N)
/POS5 Phase 1/POS5_VSNSO1_+: R409.2, R410.1, R414.2
/POS5 Phase 1/POS5_VSNSO1_-: R408.1, R411.2, U301.3 (VSNSN1)
GND: C401.1, C402.1, C405.2, C407.2, C408.2, C409.2, C410.2, C411.2, C412.2, C414.2, C416.2, C417.2, C418.2, C419.2, C420.2, R401.2, R408.2, U401.5 (CGND), U401.16 (PGND), U401.17 (PGND), U401.18 (PGND), U401.19 (PGND), U401.20 (PGND), U401.21 (PGND), U401.22 (PGND), U401.23 (PGND), U401.24 (PGND), U401.25 (PGND), U401.26 (PGND), U401.27 (PGND), U401.28 (PGND), U401.37 (CGND), U401.P1 (CGND); also elsewhere on the board
LOOP_TAP: R414.1; also elsewhere on the board
unnamed: C403.2, R402.1
unnamed: C404.1, R403.2
unnamed: C404.2, C406.2, R402.2, R404.2, U301.58 (FB1)
unnamed: C411.1, R405.2, U401.2 (VCIN)
unnamed: C413.1, R406.2
unnamed: C413.2, U401.7 (PHASE)
unnamed: C415.2, R407.2, U301.46 (ISNS1P)
unnamed: L401.1, R412.2, U401.15 (VSWH), U401.29 (VSWH), U401.30 (VSWH), U401.31 (VSWH), U401.32 (VSWH), U401.33 (VSWH), U401.34 (VSWH), U401.35 (VSWH), U401.P3 (VSWH)
unnamed: R406.1, U401.4 (BOOT)
unnamed: R410.2, R411.1, U301.2 (VSNSP1)
unnamed: U301.52 (PWM1), U401.40 (PWM)
POS5_COMP: C406.1, R403.1, U301.1 (COMP1); also elsewhere on the board
POS5_IAVG: C402.2, U301.47 (IAVG1); also elsewhere on the board
POS5_ILIM: R401.1, U301.48 (ILIM1); also elsewhere on the board
POS5_PGOOD_OC: U301.49 (PGOOD1); also elsewhere on the board
POS5_RUN: U301.53 (RUN1); also elsewhere on the board
POS5_SS: C401.2, U301.57 (TRACK/SS1); also elsewhere on the board
POS5_VOSNS: C403.1, R404.1, U301.4 (VSNSOUT1); also elsewhere on the board
~POS5_THDN: U401.38 (~THDN); also elsewhere on the board

Notes on the sheet:
Route as diff pairs
04. +5V Phase 1

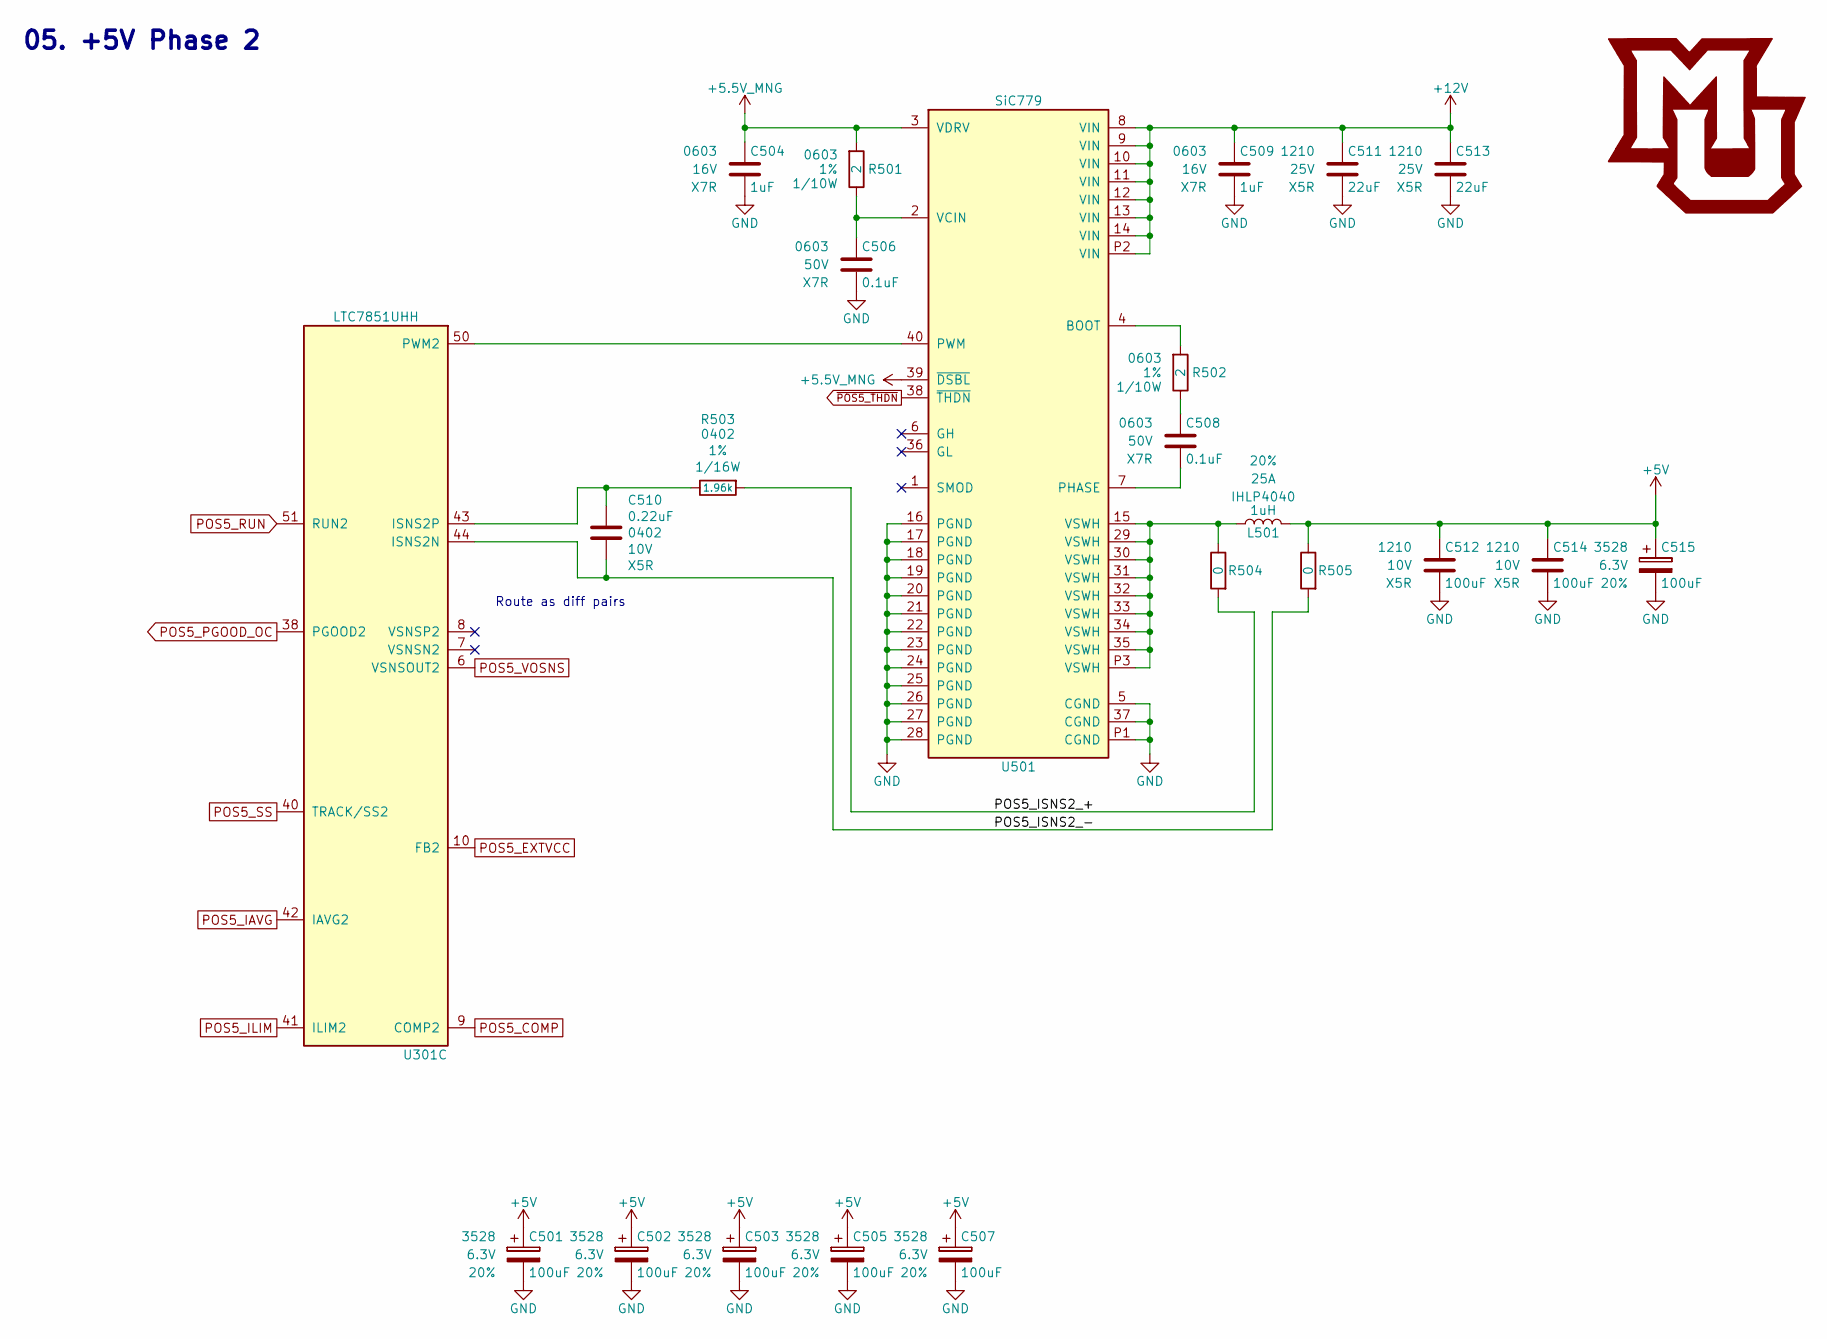
[picture p100: schematic POS5_Phase_2.sch, Electronic Display Power Board]

Parts:
C501, C502, C503, C505, C507, C515: 100uF; CP_Tantalum_Case-B_EIA-3528-21_Reflow; Voltage 6.3V; Tolerance 20%; Digi-Key PN 478-9994-1-ND
C504: 1uF; C_0603_HandSoldering; Voltage 16V; Digi-Key PN 1276-6524-1-ND
C506, C508: 0.1uF; C_0603; Voltage 50V; Digi-Key PN 490-4779-1-ND
C509: 1uF; C_0603; Voltage 16V; Digi-Key PN 1276-6524-1-ND
C510: 0.22uF; C_0402; Voltage 10V; Digi-Key PN 1276-1049-1-ND
C511, C513: 22uF; C_1210; Voltage 25V; Digi-Key PN 445-1436-1-ND
C512, C514: 100uF; C_1210; Voltage 10V; Digi-Key PN 587-3432-1-ND
L501: 1uH; L_Vishay_IHLP-4040; Tolerance 20%; Digi-Key PN 541-1306-1-ND
R501, R502: 2; R_0603; Tolerance 1%; Digi-Key PN RMCF0603FT2R00CT-ND
R503: 1.96k; R_0402; Tolerance 1%; Digi-Key PN 311-1.96KLRCT-ND
R504, R505: 0; R_0402; Tolerance 1%; Digi-Key PN RMCF0402ZT0R00CT-ND
U301: LTC7851UHH; QFN-58-1EP_9x5mm_Pitch0.4mm; Digi-Key PN LTC7851IUHH#PBF-ND
U501: SiC779; MLP66-40_6x6mm_Pitch0.5mm; Digi-Key PN SIC779CD-T1-GE3CT-ND

Connections:
+5.5V_MNG: C504.1, R501.1, U501.3 (VDRV), U501.39 (~DSBL); also elsewhere on the board
+5V: C501.1, C502.1, C503.1, C505.1, C507.1, C512.1, C514.1, C515.1, L501.2, R505.2; also elsewhere on the board
+12V: C509.1, C511.1, C513.1, U501.8 (VIN), U501.9 (VIN), U501.10 (VIN), U501.11 (VIN), U501.12 (VIN), U501.13 (VIN), U501.14 (VIN), U501.P2 (VIN); also elsewhere on the board
/POS5 Phase 2/POS5_ISNS2_+: R503.1, R504.1
/POS5 Phase 2/POS5_ISNS2_-: C510.1, R505.1, U301.44 (ISNS2N)
GND: C501.2, C502.2, C503.2, C504.2, C505.2, C506.2, C507.2, C509.2, C511.2, C512.2, C513.2, C514.2, C515.2, U501.5 (CGND), U501.16 (PGND), U501.17 (PGND), U501.18 (PGND), U501.19 (PGND), U501.20 (PGND), U501.21 (PGND), U501.22 (PGND), U501.23 (PGND), U501.24 (PGND), U501.25 (PGND), U501.26 (PGND), U501.27 (PGND), U501.28 (PGND), U501.37 (CGND), U501.P1 (CGND); also elsewhere on the board
unnamed: C506.1, R501.2, U501.2 (VCIN)
unnamed: C508.1, R502.2
unnamed: C508.2, U501.7 (PHASE)
unnamed: C510.2, R503.2, U301.43 (ISNS2P)
unnamed: L501.1, R504.2, U501.15 (VSWH), U501.29 (VSWH), U501.30 (VSWH), U501.31 (VSWH), U501.32 (VSWH), U501.33 (VSWH), U501.34 (VSWH), U501.35 (VSWH), U501.P3 (VSWH)
unnamed: R502.1, U501.4 (BOOT)
unnamed: U301.50 (PWM2), U501.40 (PWM)
POS5_COMP: U301.9 (COMP2); also elsewhere on the board
POS5_EXTVCC: U301.10 (FB2); also elsewhere on the board
POS5_IAVG: U301.42 (IAVG2); also elsewhere on the board
POS5_ILIM: U301.41 (ILIM2); also elsewhere on the board
POS5_PGOOD_OC: U301.38 (PGOOD2); also elsewhere on the board
POS5_RUN: U301.51 (RUN2); also elsewhere on the board
POS5_SS: U301.40 (TRACK/SS2); also elsewhere on the board
POS5_VOSNS: U301.6 (VSNSOUT2); also elsewhere on the board
~POS5_THDN: U501.38 (~THDN); also elsewhere on the board

Notes on the sheet:
05. +5V Phase 2
Route as diff pairs

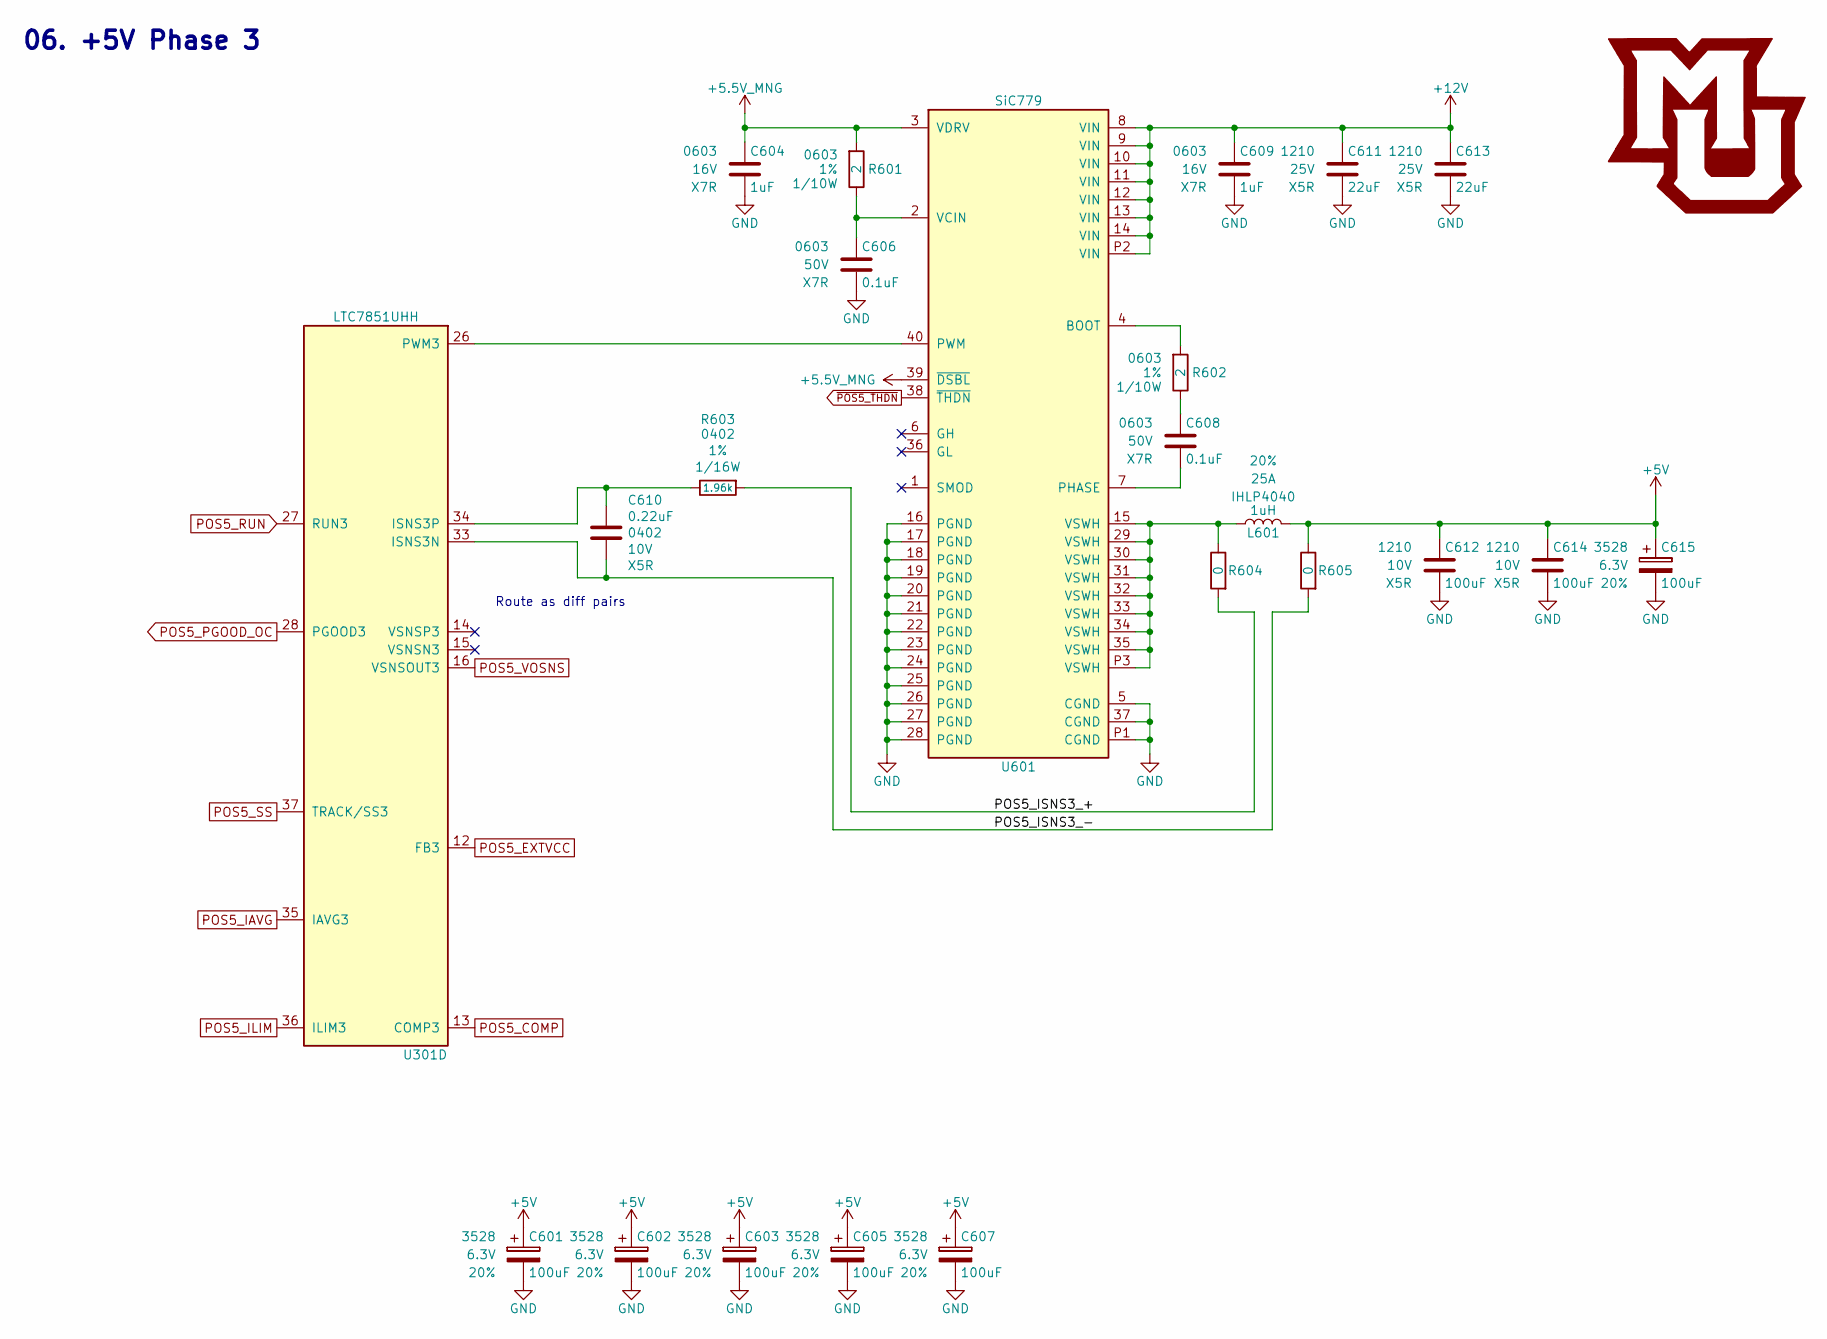
[picture p101: schematic POS5_Phase_3.sch, Electronic Display Power Board]

Parts:
C601, C602, C603, C605, C607, C615: 100uF; CP_Tantalum_Case-B_EIA-3528-21_Reflow; Voltage 6.3V; Tolerance 20%; Digi-Key PN 478-9994-1-ND
C604, C609: 1uF; C_0603; Voltage 16V; Digi-Key PN 1276-6524-1-ND
C606, C608: 0.1uF; C_0603; Voltage 50V; Digi-Key PN 490-4779-1-ND
C610: 0.22uF; C_0402; Voltage 10V; Digi-Key PN 1276-1049-1-ND
C611, C613: 22uF; C_1210; Voltage 25V; Digi-Key PN 445-1436-1-ND
C612, C614: 100uF; C_1210; Voltage 10V; Digi-Key PN 587-3432-1-ND
L601: 1uH; L_Vishay_IHLP-4040; Tolerance 20%; Digi-Key PN 541-1306-1-ND
R601, R602: 2; R_0603; Tolerance 1%; Digi-Key PN RMCF0603FT2R00CT-ND
R603: 1.96k; R_0402; Tolerance 1%; Digi-Key PN 311-1.96KLRCT-ND
R604, R605: 0; R_0402; Tolerance 1%; Digi-Key PN RMCF0402ZT0R00CT-ND
U301: LTC7851UHH; QFN-58-1EP_9x5mm_Pitch0.4mm; Digi-Key PN LTC7851IUHH#PBF-ND
U601: SiC779; MLP66-40_6x6mm_Pitch0.5mm; Digi-Key PN SIC779CD-T1-GE3CT-ND

Connections:
+5.5V_MNG: C604.1, R601.1, U601.3 (VDRV), U601.39 (~DSBL); also elsewhere on the board
+5V: C601.1, C602.1, C603.1, C605.1, C607.1, C612.1, C614.1, C615.1, L601.2, R605.2; also elsewhere on the board
+12V: C609.1, C611.1, C613.1, U601.8 (VIN), U601.9 (VIN), U601.10 (VIN), U601.11 (VIN), U601.12 (VIN), U601.13 (VIN), U601.14 (VIN), U601.P2 (VIN); also elsewhere on the board
/POS5 Phase 3/POS5_ISNS3_+: R603.1, R604.1
/POS5 Phase 3/POS5_ISNS3_-: C610.1, R605.1, U301.33 (ISNS3N)
GND: C601.2, C602.2, C603.2, C604.2, C605.2, C606.2, C607.2, C609.2, C611.2, C612.2, C613.2, C614.2, C615.2, U601.5 (CGND), U601.16 (PGND), U601.17 (PGND), U601.18 (PGND), U601.19 (PGND), U601.20 (PGND), U601.21 (PGND), U601.22 (PGND), U601.23 (PGND), U601.24 (PGND), U601.25 (PGND), U601.26 (PGND), U601.27 (PGND), U601.28 (PGND), U601.37 (CGND), U601.P1 (CGND); also elsewhere on the board
unnamed: C606.1, R601.2, U601.2 (VCIN)
unnamed: C608.1, R602.2
unnamed: C608.2, U601.7 (PHASE)
unnamed: C610.2, R603.2, U301.34 (ISNS3P)
unnamed: L601.1, R604.2, U601.15 (VSWH), U601.29 (VSWH), U601.30 (VSWH), U601.31 (VSWH), U601.32 (VSWH), U601.33 (VSWH), U601.34 (VSWH), U601.35 (VSWH), U601.P3 (VSWH)
unnamed: R602.1, U601.4 (BOOT)
unnamed: U301.26 (PWM3), U601.40 (PWM)
POS5_COMP: U301.13 (COMP3); also elsewhere on the board
POS5_EXTVCC: U301.12 (FB3); also elsewhere on the board
POS5_IAVG: U301.35 (IAVG3); also elsewhere on the board
POS5_ILIM: U301.36 (ILIM3); also elsewhere on the board
POS5_PGOOD_OC: U301.28 (PGOOD3); also elsewhere on the board
POS5_RUN: U301.27 (RUN3); also elsewhere on the board
POS5_SS: U301.37 (TRACK/SS3); also elsewhere on the board
POS5_VOSNS: U301.16 (VSNSOUT3); also elsewhere on the board
~POS5_THDN: U601.38 (~THDN); also elsewhere on the board

Notes on the sheet:
06. +5V Phase 3
Route as diff pairs
