drewsum/Electronic_Display/hdw/Power_Board/LTC7851_Demo/LTC7851_Demo.kicad_pcb

## KiCad design hdw/Power_Board/LTC7851_Demo/LTC7851_Demo.kicad_pcb (continued)

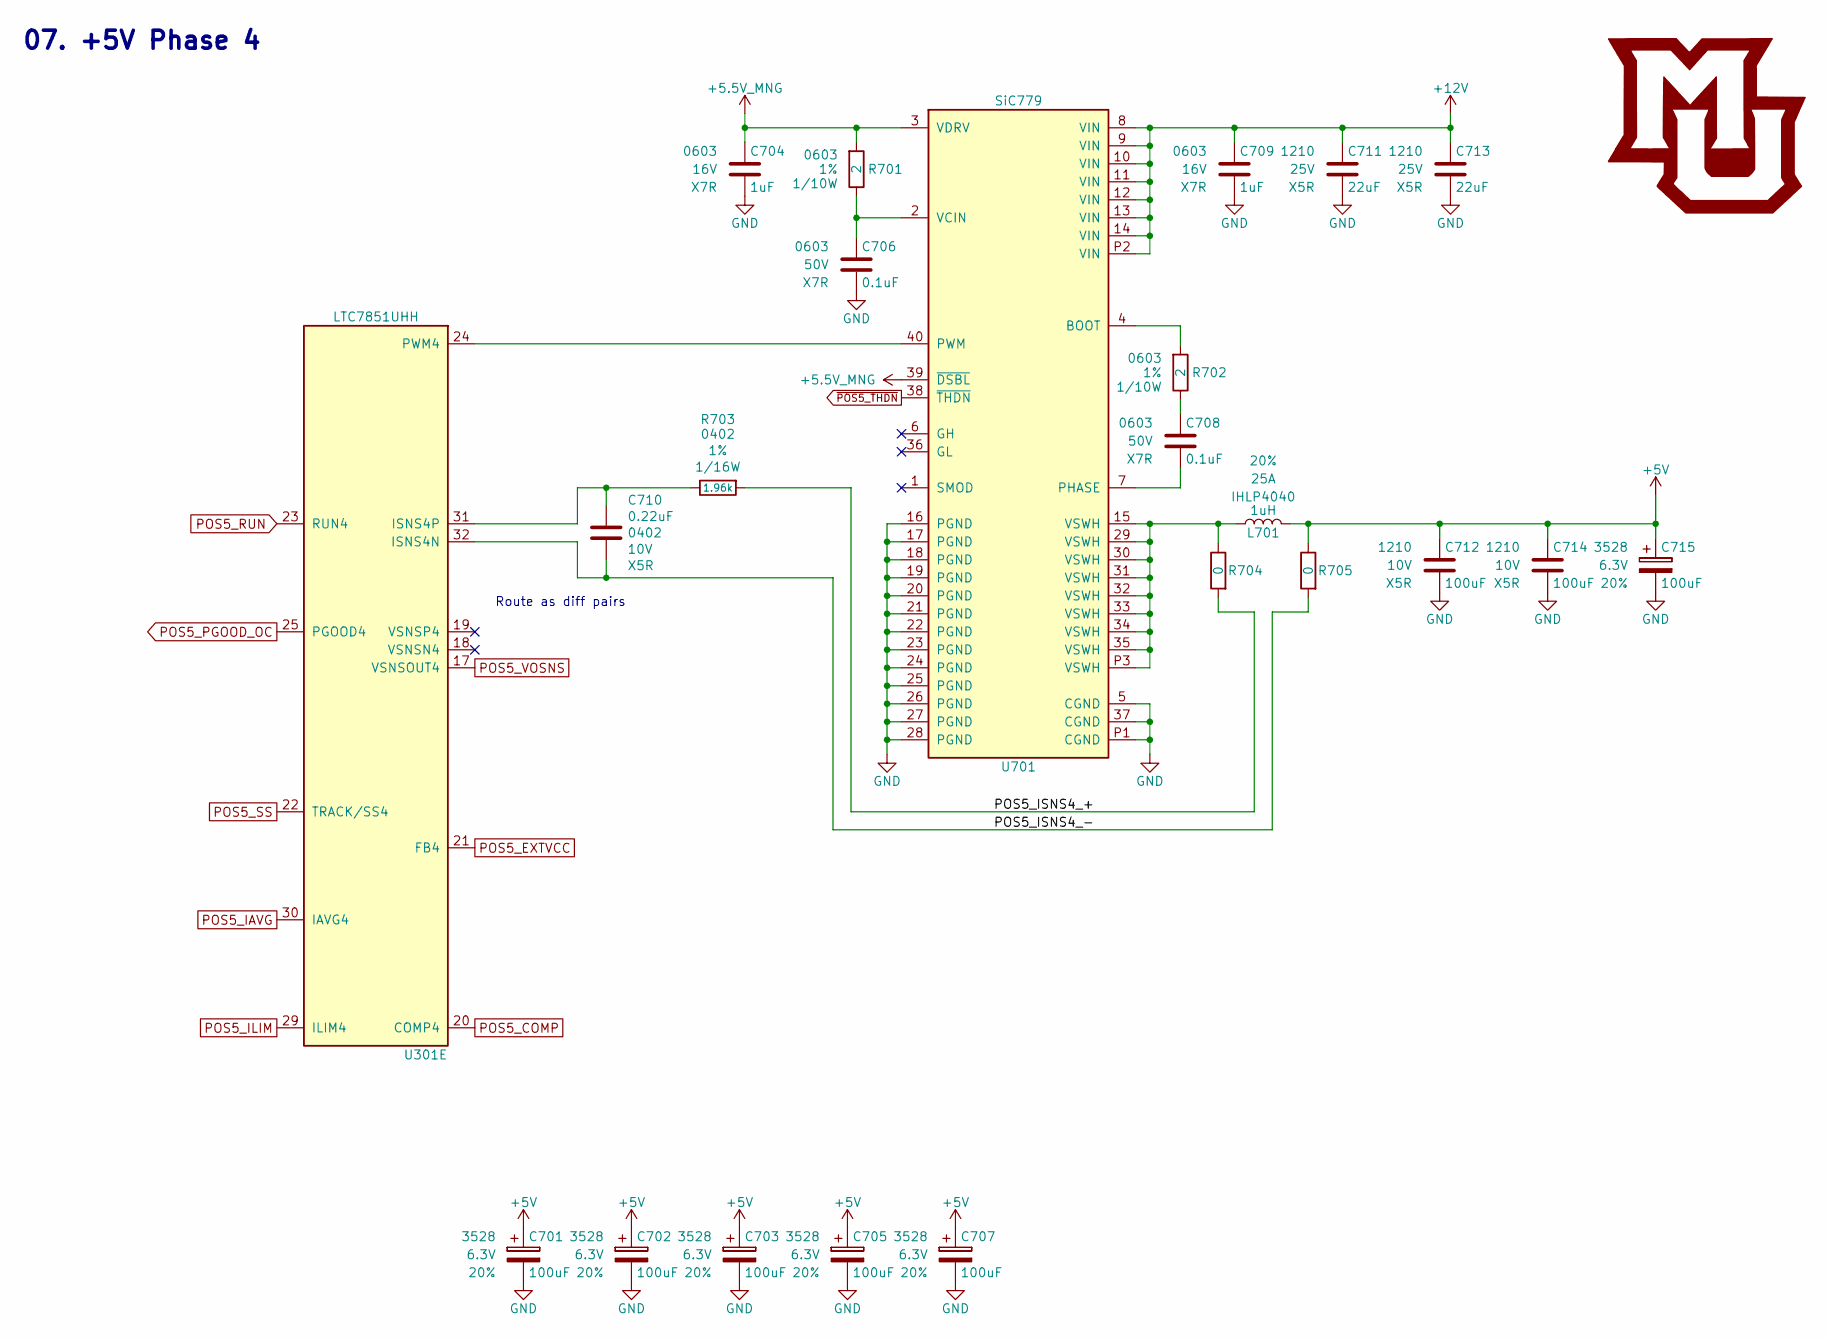
[picture p102: schematic POS5_Phase_4.sch, Electronic Display Power Board]

Parts:
C701, C702, C703, C705, C707, C715: 100uF; CP_Tantalum_Case-B_EIA-3528-21_Reflow; Voltage 6.3V; Tolerance 20%; Digi-Key PN 478-9994-1-ND
C704, C709: 1uF; C_0603; Voltage 16V; Digi-Key PN 1276-6524-1-ND
C706, C708: 0.1uF; C_0603; Voltage 50V; Digi-Key PN 490-4779-1-ND
C710: 0.22uF; C_0402; Voltage 10V; Digi-Key PN 1276-1049-1-ND
C711, C713: 22uF; C_1210; Voltage 25V; Digi-Key PN 445-1436-1-ND
C712, C714: 100uF; C_1210; Voltage 10V; Digi-Key PN 587-3432-1-ND
L701: 1uH; L_Vishay_IHLP-4040; Tolerance 20%; Digi-Key PN 541-1306-1-ND
R701, R702: 2; R_0603; Tolerance 1%; Digi-Key PN RMCF0603FT2R00CT-ND
R703: 1.96k; R_0402; Tolerance 1%; Digi-Key PN 311-1.96KLRCT-ND
R704, R705: 0; R_0402; Tolerance 1%; Digi-Key PN RMCF0402ZT0R00CT-ND
U301: LTC7851UHH; QFN-58-1EP_9x5mm_Pitch0.4mm; Digi-Key PN LTC7851IUHH#PBF-ND
U701: SiC779; MLP66-40_6x6mm_Pitch0.5mm; Digi-Key PN SIC779CD-T1-GE3CT-ND

Connections:
+5.5V_MNG: C704.1, R701.1, U701.3 (VDRV), U701.39 (~DSBL); also elsewhere on the board
+5V: C701.1, C702.1, C703.1, C705.1, C707.1, C712.1, C714.1, C715.1, L701.2, R705.2; also elsewhere on the board
+12V: C709.1, C711.1, C713.1, U701.8 (VIN), U701.9 (VIN), U701.10 (VIN), U701.11 (VIN), U701.12 (VIN), U701.13 (VIN), U701.14 (VIN), U701.P2 (VIN); also elsewhere on the board
/POS5 Phase 4/POS5_ISNS4_+: R703.1, R704.1
/POS5 Phase 4/POS5_ISNS4_-: C710.1, R705.1, U301.32 (ISNS4N)
GND: C701.2, C702.2, C703.2, C704.2, C705.2, C706.2, C707.2, C709.2, C711.2, C712.2, C713.2, C714.2, C715.2, U701.5 (CGND), U701.16 (PGND), U701.17 (PGND), U701.18 (PGND), U701.19 (PGND), U701.20 (PGND), U701.21 (PGND), U701.22 (PGND), U701.23 (PGND), U701.24 (PGND), U701.25 (PGND), U701.26 (PGND), U701.27 (PGND), U701.28 (PGND), U701.37 (CGND), U701.P1 (CGND); also elsewhere on the board
unnamed: C706.1, R701.2, U701.2 (VCIN)
unnamed: C708.1, R702.2
unnamed: C708.2, U701.7 (PHASE)
unnamed: C710.2, R703.2, U301.31 (ISNS4P)
unnamed: L701.1, R704.2, U701.15 (VSWH), U701.29 (VSWH), U701.30 (VSWH), U701.31 (VSWH), U701.32 (VSWH), U701.33 (VSWH), U701.34 (VSWH), U701.35 (VSWH), U701.P3 (VSWH)
unnamed: R702.1, U701.4 (BOOT)
unnamed: U301.24 (PWM4), U701.40 (PWM)
POS5_COMP: U301.20 (COMP4); also elsewhere on the board
POS5_EXTVCC: U301.21 (FB4); also elsewhere on the board
POS5_IAVG: U301.30 (IAVG4); also elsewhere on the board
POS5_ILIM: U301.29 (ILIM4); also elsewhere on the board
POS5_PGOOD_OC: U301.25 (PGOOD4); also elsewhere on the board
POS5_RUN: U301.23 (RUN4); also elsewhere on the board
POS5_SS: U301.22 (TRACK/SS4); also elsewhere on the board
POS5_VOSNS: U301.17 (VSNSOUT4); also elsewhere on the board
~POS5_THDN: U701.38 (~THDN); also elsewhere on the board

Notes on the sheet:
07. +5V Phase 4
Route as diff pairs

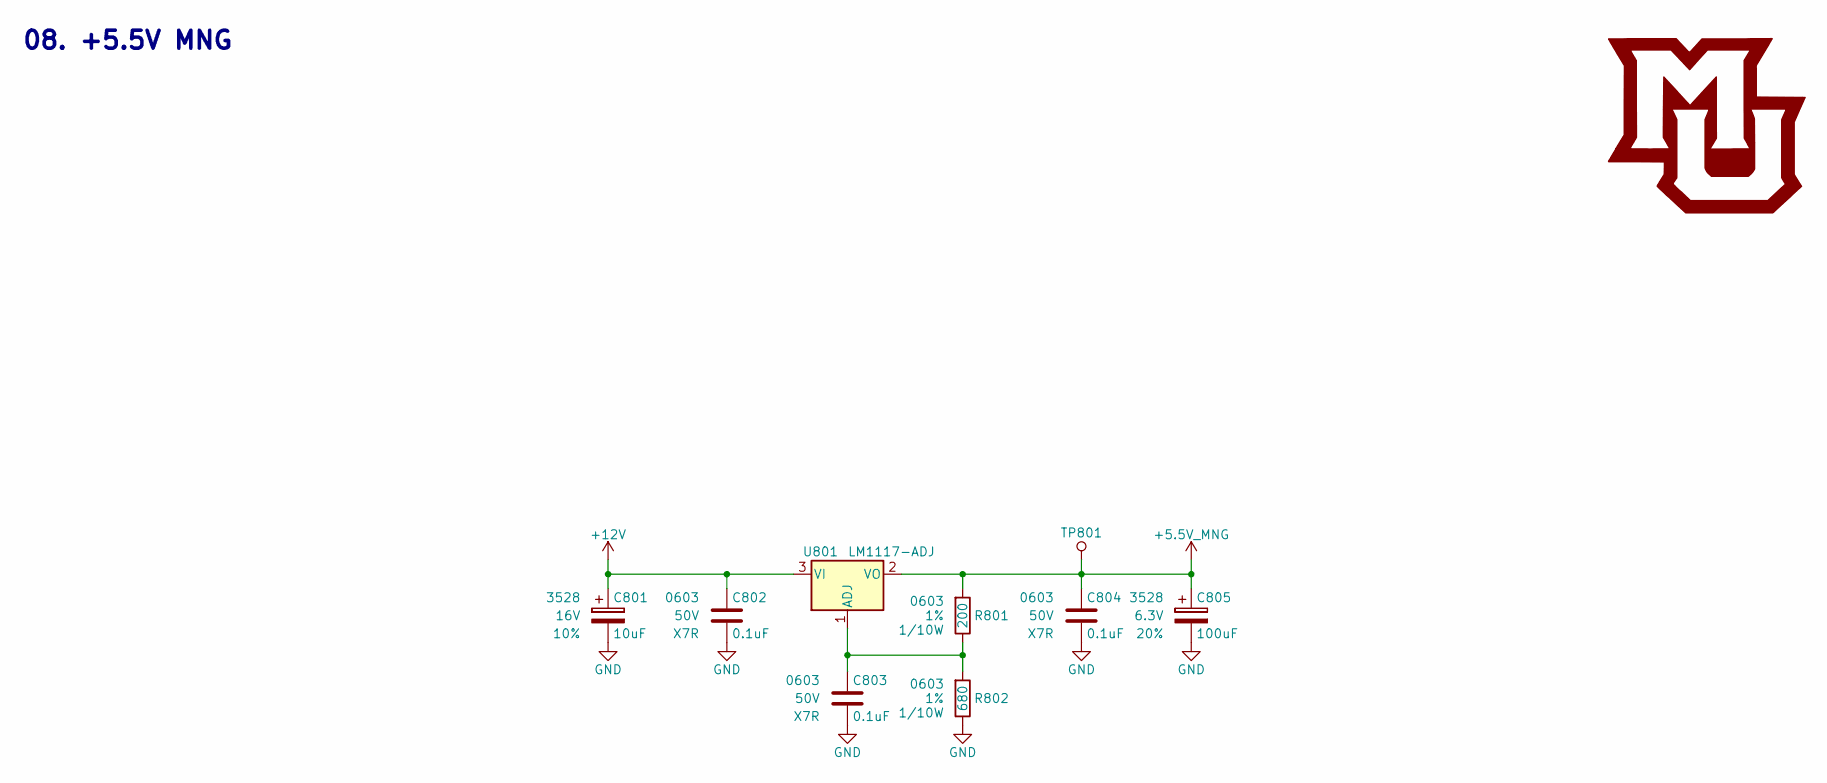
[picture p103: schematic POS5P5_MNG.sch, Electronic Display Power Board]

Parts:
C801: 10uF; CP_Tantalum_Case-B_EIA-3528-21_Reflow; Voltage 16V; Tolerance 10%; Digi-Key PN 399-5034-1-ND
C802, C803, C804: 0.1uF; C_0603; Voltage 50V; Digi-Key PN 490-4779-1-ND
C805: 100uF; CP_Tantalum_Case-B_EIA-3528-21_Reflow; Voltage 6.3V; Tolerance 20%; Digi-Key PN 478-9994-1-ND
R801: 200; R_0603; Tolerance 1%; Digi-Key PN MCT0603-200-CFCT-ND
R802: 680; R_0603; Tolerance 1%; Digi-Key PN P680HCT-ND
TP801: TP; Measurement_Point_Round-SMD-Pad_Small
U801: LM1117-ADJ; SOT-223-3_TabPin2; Digi-Key PN LM1117IMPX-ADJ/NOPBCT-ND

Connections:
+5.5V_MNG: C804.1, C805.1, R801.1, TP801.1, U801.2 (VO); also elsewhere on the board
+12V: C801.1, C802.1, U801.3 (VI); also elsewhere on the board
GND: C801.2, C802.2, C803.2, C804.2, C805.2, R802.2; also elsewhere on the board
unnamed: C803.1, R801.2, R802.1, U801.1 (ADJ)

Notes on the sheet:
08. +5.5V MNG

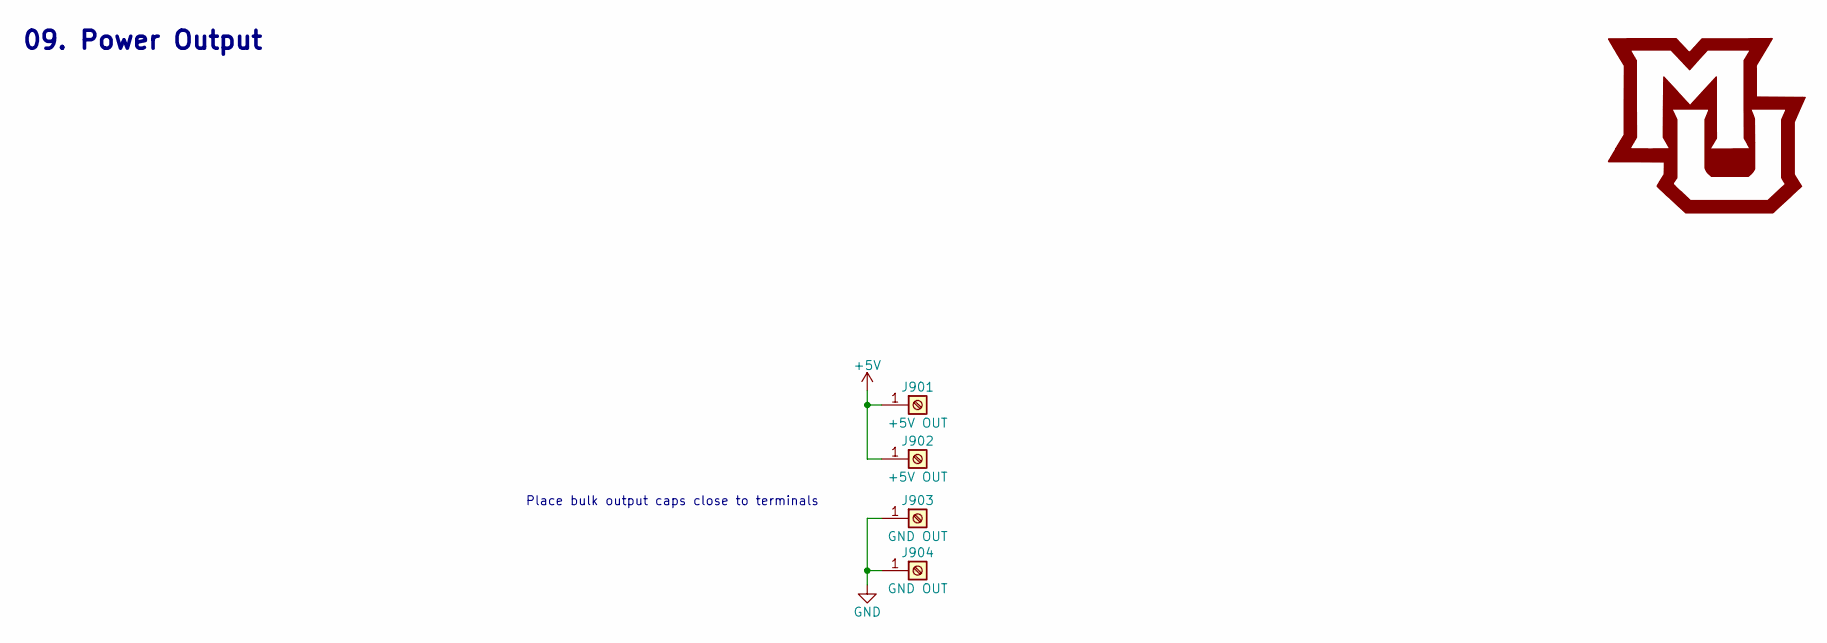
[picture p104: schematic Power_Output.sch, Electronic Display Power Board]

Parts:
J901, J902: +5V OUT; Wuerth_7461096_M4_Shank_9pos; Digi-Key PN 732-3214-ND
J903, J904: GND OUT; Wuerth_7461096_M4_Shank_9pos; Digi-Key PN 732-3214-ND

Connections:
+5V: J901.1, J902.1; also elsewhere on the board
GND: J903.1, J904.1; also elsewhere on the board

Notes on the sheet:
Place bulk output caps close to terminals
09. Power Output

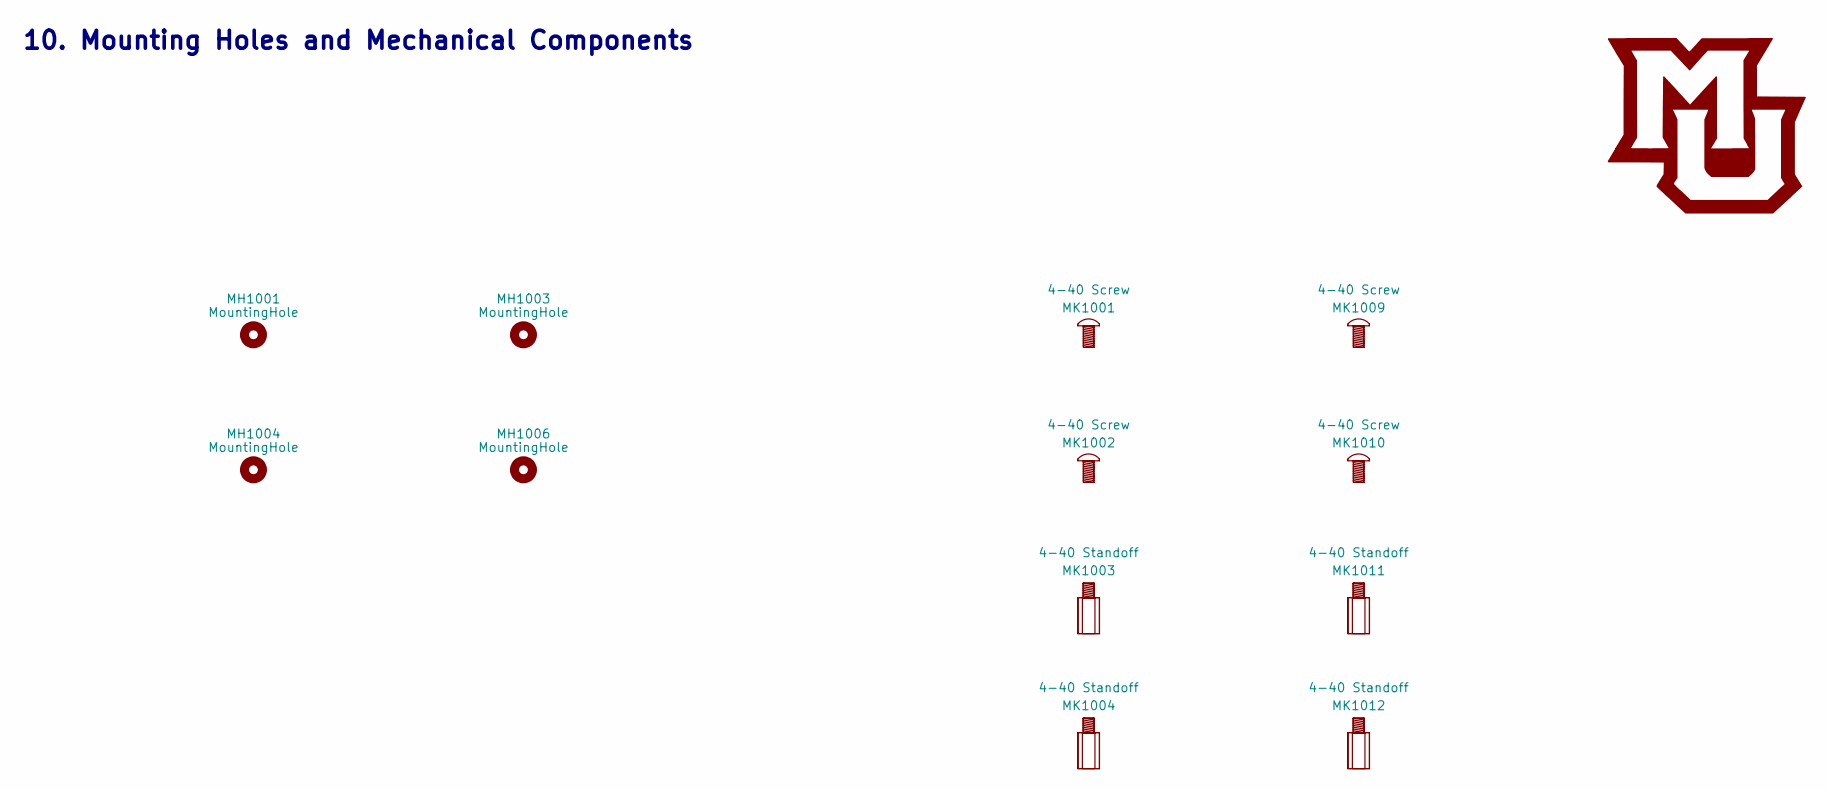
[picture p105: schematic Mechanical.sch, Electronic Display Power Board]

Parts:
MH1001, MH1003, MH1004, MH1006: MountingHole; MountingHole_3mm
MK1001, MK1002, MK1009, MK1010: 4-40 Screw; Digi-Key PN 36-9900-ND
MK1003, MK1004, MK1011, MK1012: 4-40 Standoff; Digi-Key PN 36-8400-ND

Notes on the sheet:
10. Mounting Holes and Mechanical Components

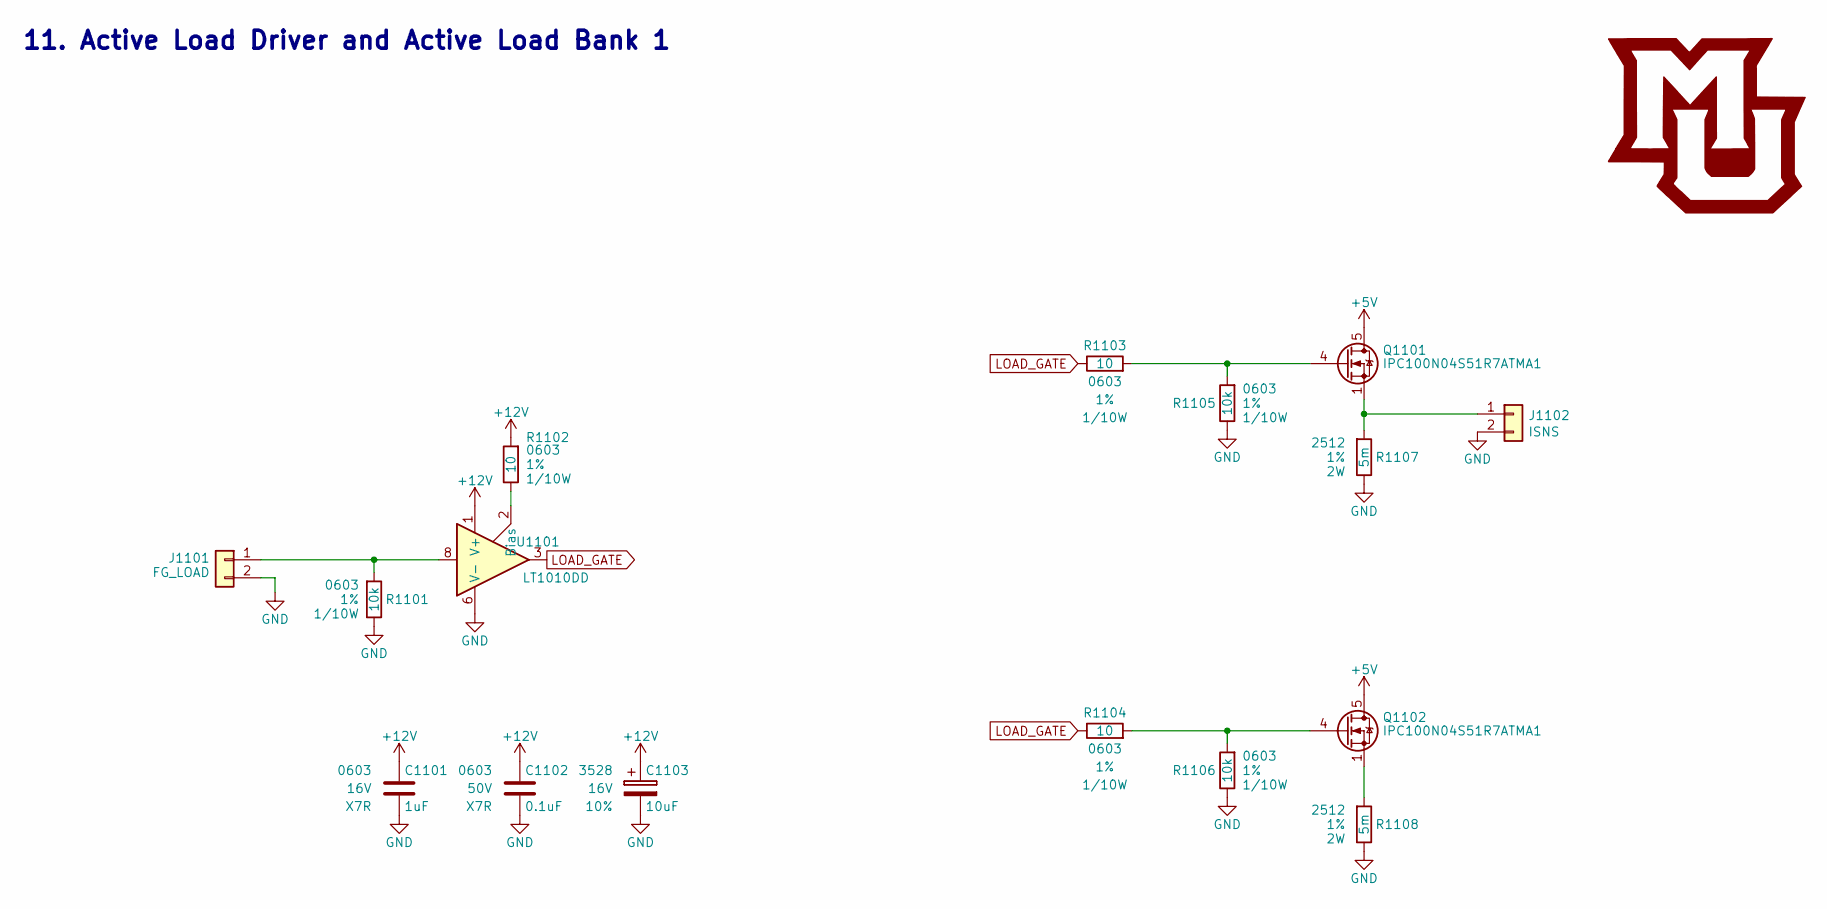
[picture p106: schematic Active_Load_1.sch, Electronic Display Power Board]

Parts:
C1101: 1uF; C_0603; Voltage 16V; Digi-Key PN 1276-6524-1-ND
C1102: 0.1uF; C_0603; Voltage 50V; Digi-Key PN 490-4779-1-ND
C1103: 10uF; CP_Tantalum_Case-B_EIA-3528-21_Reflow; Voltage 16V; Tolerance 10%; Digi-Key PN 399-5034-1-ND
J1101: FG_LOAD; Pin_Header_Straight_1x02_Pitch2.54mm
J1102: ISNS; Pin_Header_Straight_1x02_Pitch2.54mm
Q1101, Q1102: IPC100N04S51R7ATMA1; TDSON-8-1; Digi-Key PN BSC123N10LSGATMA1CT-ND
R1101, R1105, R1106: 10k; R_0603; Tolerance 1%; Digi-Key PN RHM10KADCT-ND
R1102, R1103, R1104: 10; R_0603; Tolerance 1%; Digi-Key PN YAG3351CT-ND
R1107, R1108: 5m; R_2512; Tolerance 1%; Digi-Key PN YAG2145CT-ND
U1101: LT1010DD; DFN-8-1EP_3x3mm_Pitch0.5mm; Digi-Key PN LT1010CDD#PBF-ND

Connections:
+5V: Q1101.5 (D), Q1102.5 (D); also elsewhere on the board
+12V: C1101.1, C1102.1, C1103.1, R1102.1, U1101.1 (V+); also elsewhere on the board
GND: C1101.2, C1102.2, C1103.2, J1101.2, J1102.2, R1101.2, R1105.2, R1106.2, R1107.2, R1108.2, U1101.6 (V-), U1101.9 (V-); also elsewhere on the board
LOAD_GATE: R1103.2, R1104.2, U1101.3; also elsewhere on the board
unnamed: J1101.1, R1101.1, U1101.8
unnamed: J1102.1, Q1101.1 (S), Q1101.2 (S), Q1101.3 (S), R1107.1
unnamed: Q1101.4 (G), R1103.1, R1105.1
unnamed: Q1102.1 (S), Q1102.2 (S), Q1102.3 (S), R1108.1
unnamed: Q1102.4 (G), R1104.1, R1106.1
unnamed: R1102.2, U1101.2 (Bias)

Notes on the sheet:
11. Active Load Driver and Active Load Bank 1

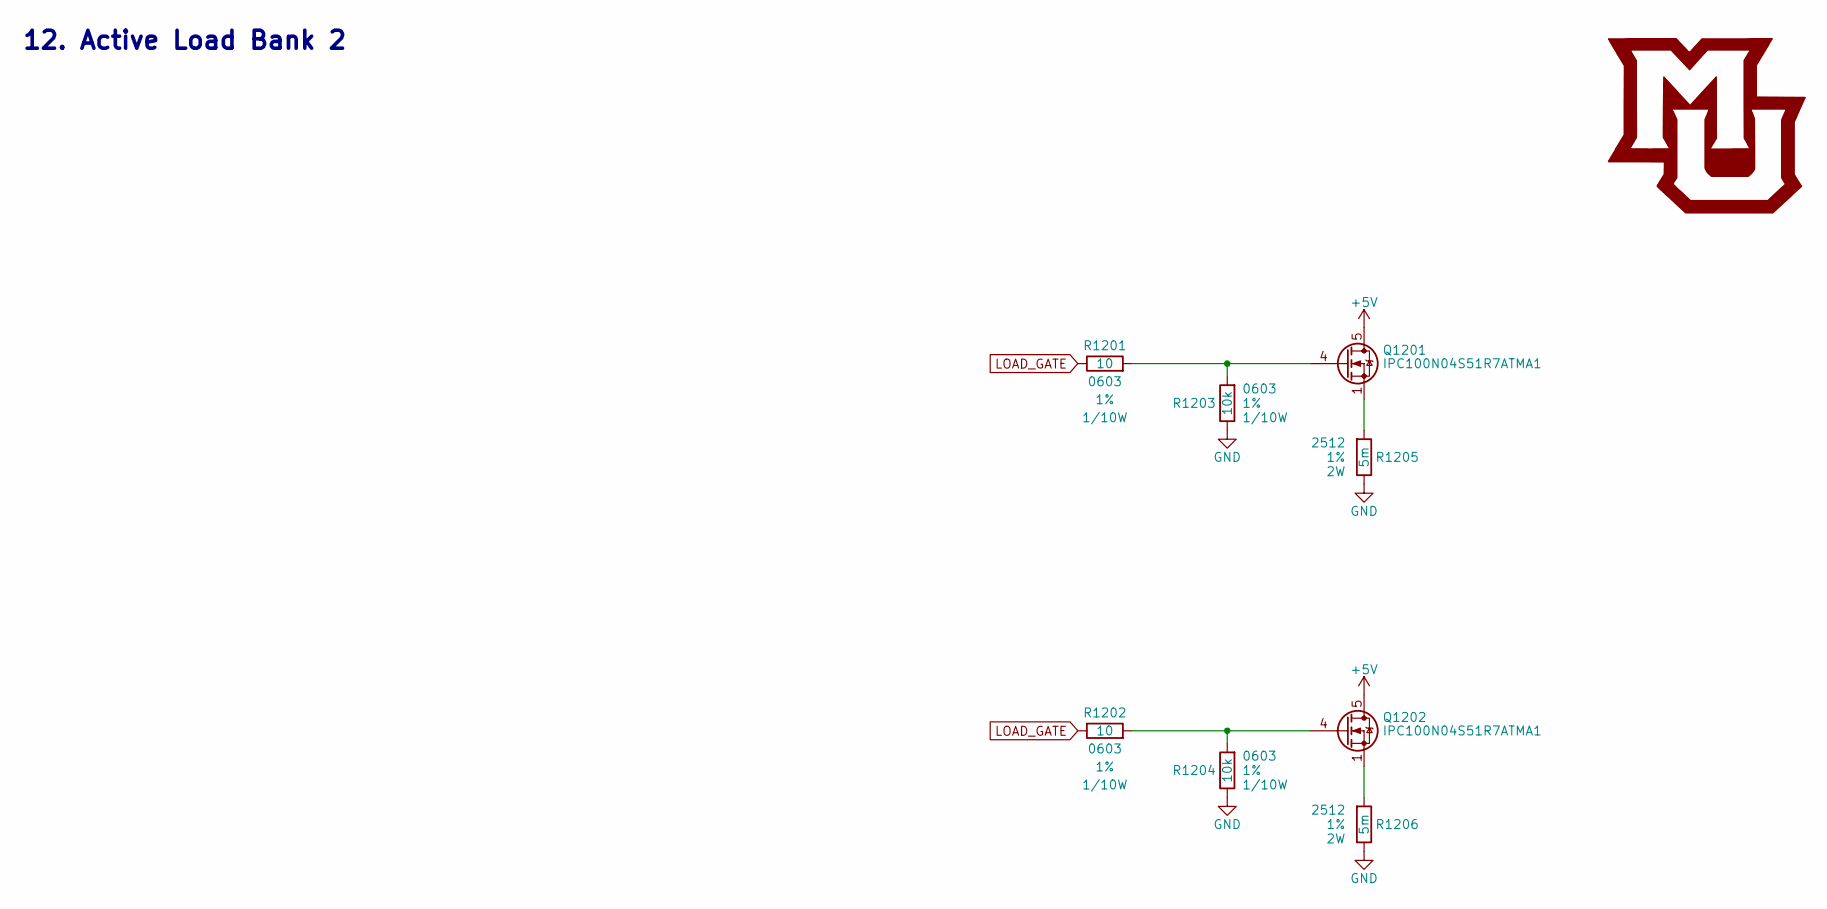
[picture p107: schematic Active_Load_2.sch, Electronic Display Power Board]

Parts:
Q1201, Q1202: IPC100N04S51R7ATMA1; TDSON-8-1; Digi-Key PN BSC123N10LSGATMA1CT-ND
R1201, R1202: 10; R_0603; Tolerance 1%; Digi-Key PN YAG3351CT-ND
R1203, R1204: 10k; R_0603; Tolerance 1%; Digi-Key PN RHM10KADCT-ND
R1205, R1206: 5m; R_2512; Tolerance 1%; Digi-Key PN YAG2145CT-ND

Connections:
+5V: Q1201.5 (D), Q1202.5 (D); also elsewhere on the board
GND: R1203.2, R1204.2, R1205.2, R1206.2; also elsewhere on the board
LOAD_GATE: R1201.2, R1202.2; also elsewhere on the board
unnamed: Q1201.1 (S), Q1201.2 (S), Q1201.3 (S), R1205.1
unnamed: Q1201.4 (G), R1201.1, R1203.1
unnamed: Q1202.1 (S), Q1202.2 (S), Q1202.3 (S), R1206.1
unnamed: Q1202.4 (G), R1202.1, R1204.1

Notes on the sheet:
12. Active Load Bank 2

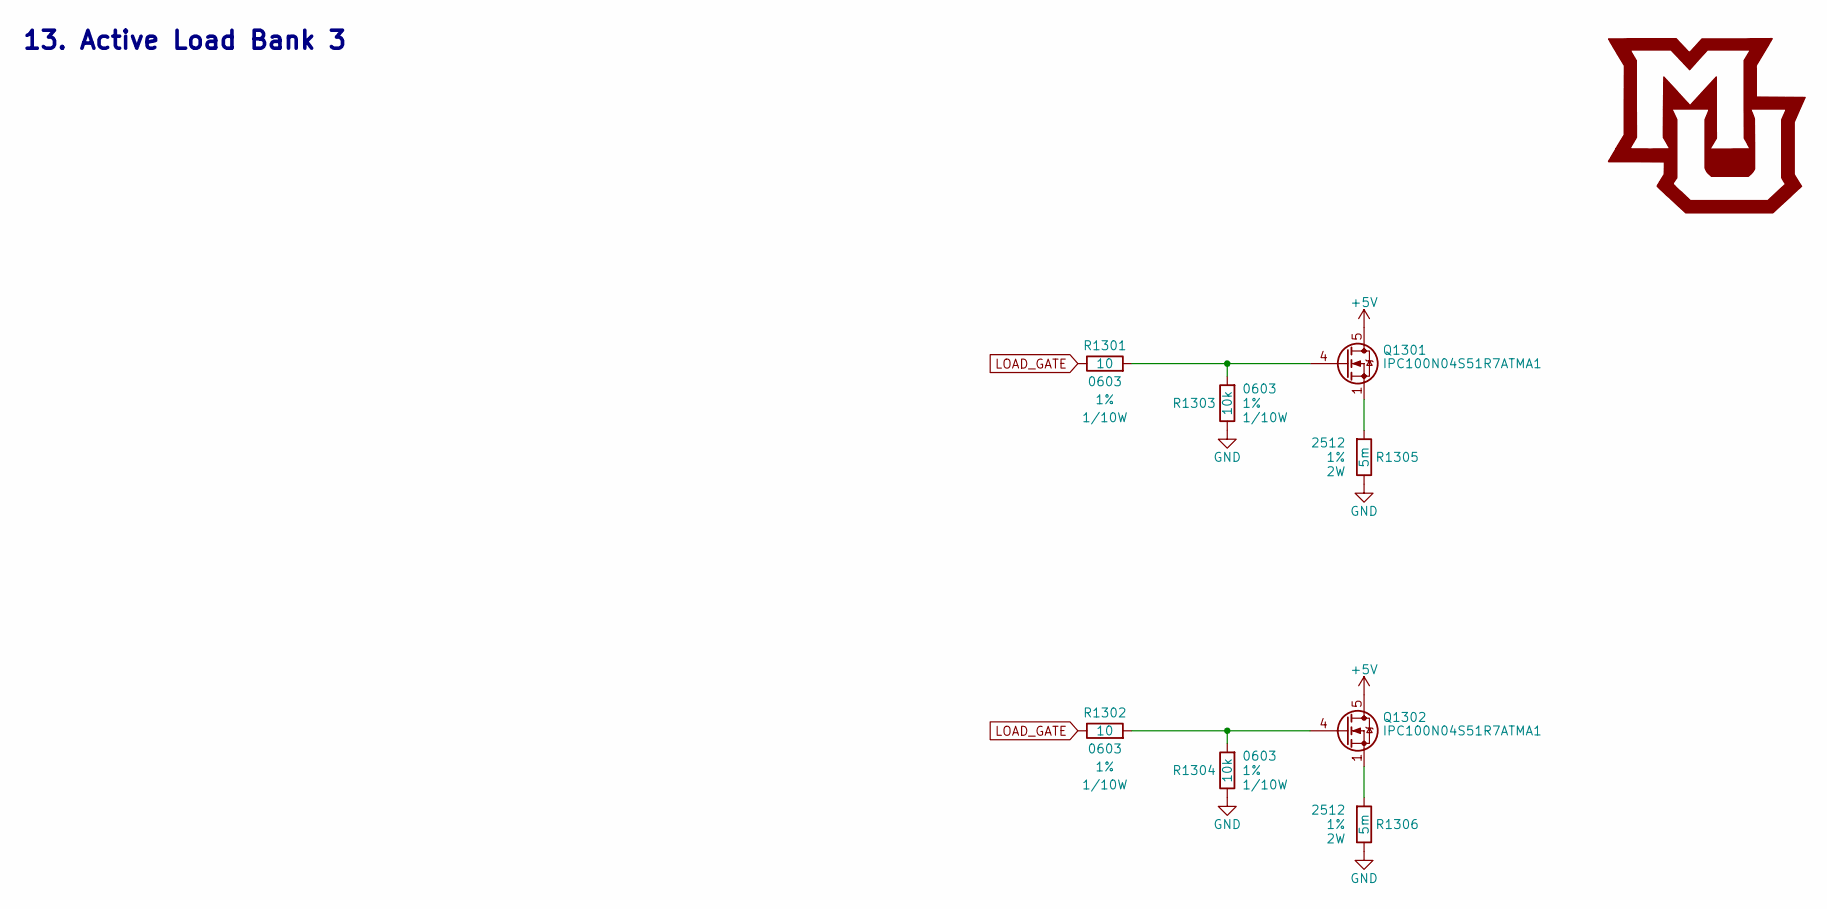
[picture p108: schematic Active_Load_3.sch, Electronic Display Power Board]

Parts:
Q1301, Q1302: IPC100N04S51R7ATMA1; TDSON-8-1; Digi-Key PN BSC123N10LSGATMA1CT-ND
R1301, R1302: 10; R_0603; Tolerance 1%; Digi-Key PN YAG3351CT-ND
R1303, R1304: 10k; R_0603; Tolerance 1%; Digi-Key PN RHM10KADCT-ND
R1305, R1306: 5m; R_2512; Tolerance 1%; Digi-Key PN YAG2145CT-ND

Connections:
+5V: Q1301.5 (D), Q1302.5 (D); also elsewhere on the board
GND: R1303.2, R1304.2, R1305.2, R1306.2; also elsewhere on the board
LOAD_GATE: R1301.2, R1302.2; also elsewhere on the board
unnamed: Q1301.1 (S), Q1301.2 (S), Q1301.3 (S), R1305.1
unnamed: Q1301.4 (G), R1301.1, R1303.1
unnamed: Q1302.1 (S), Q1302.2 (S), Q1302.3 (S), R1306.1
unnamed: Q1302.4 (G), R1302.1, R1304.1

Notes on the sheet:
13. Active Load Bank 3

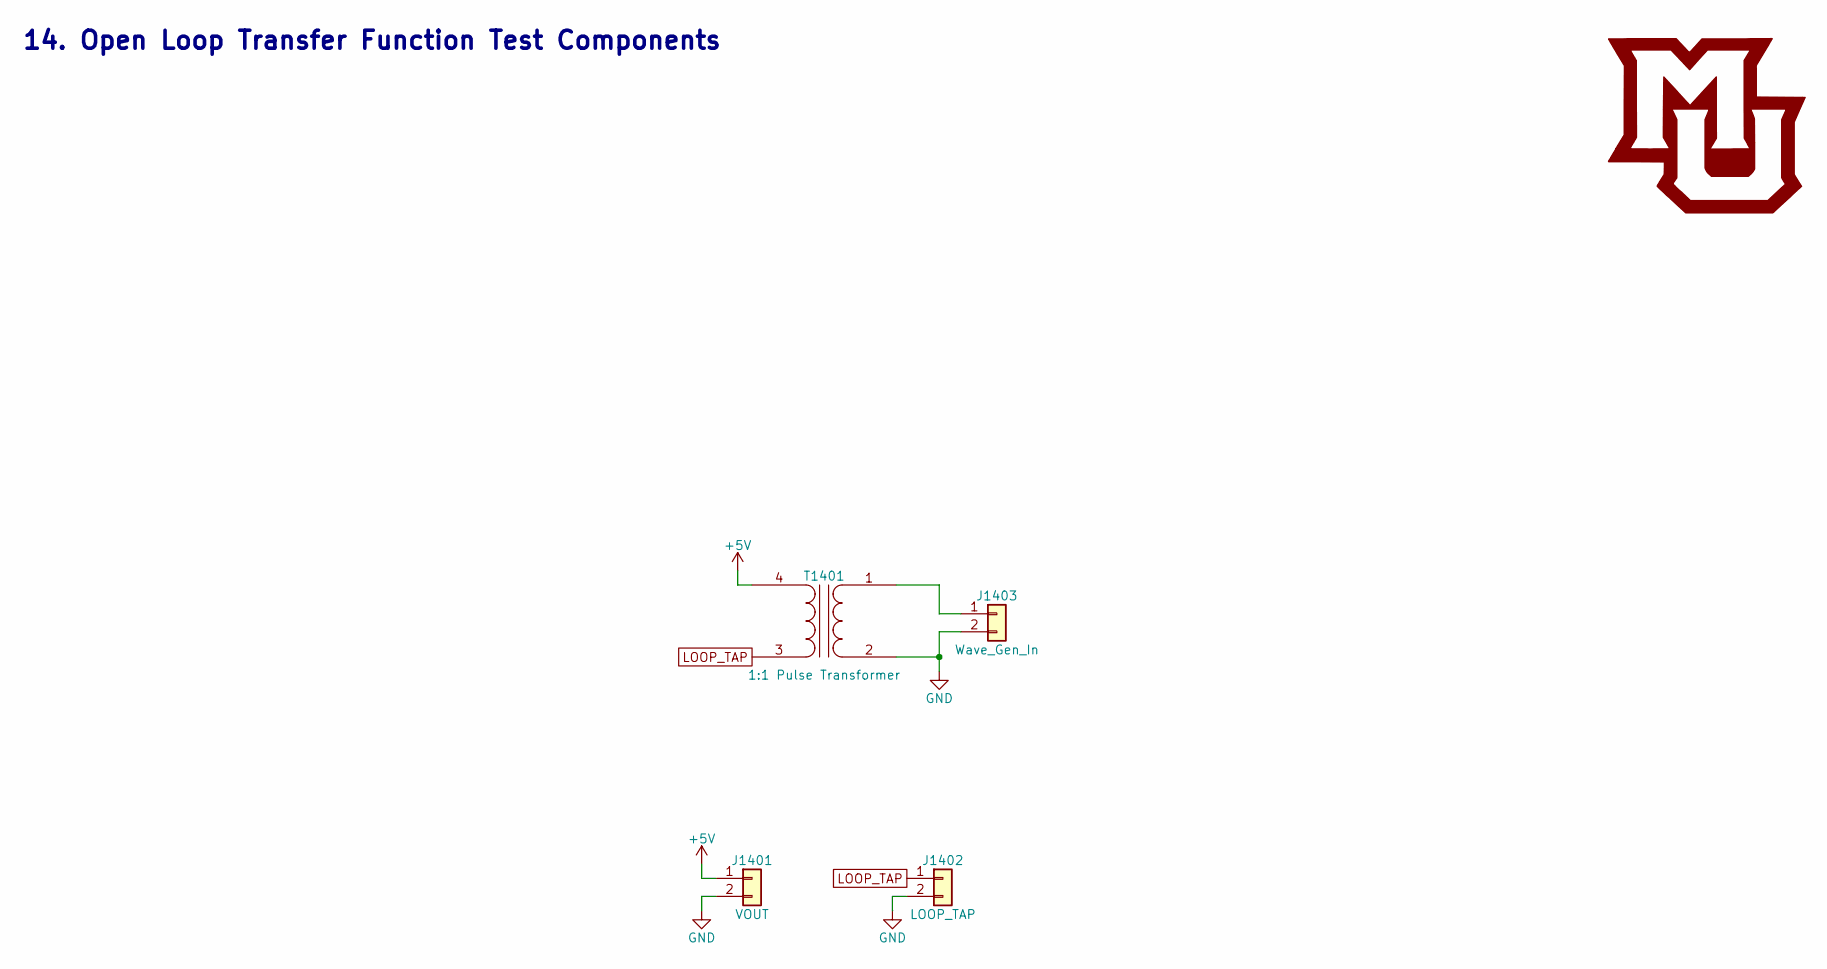
[picture p109: schematic Loop_Response.sch, Electronic Display Power Board]

Parts:
J1401: VOUT; Pin_Header_Straight_1x02_Pitch2.54mm
J1402: LOOP_TAP; Pin_Header_Straight_1x02_Pitch2.54mm
J1403: Wave_Gen_In; Pin_Header_Straight_1x02_Pitch2.54mm
T1401: 1:1 Pulse Transformer; Murata_78601_9C; Digi-Key PN 811-2650-ND

Connections:
+5V: J1401.1, T1401.4 (SB); also elsewhere on the board
GND: J1401.2, J1402.2, J1403.2, T1401.2 (AB); also elsewhere on the board
LOOP_TAP: J1402.1, T1401.3 (SA); also elsewhere on the board
unnamed: J1403.1, T1401.1 (AA)

Notes on the sheet:
14. Open Loop Transfer Function Test Components

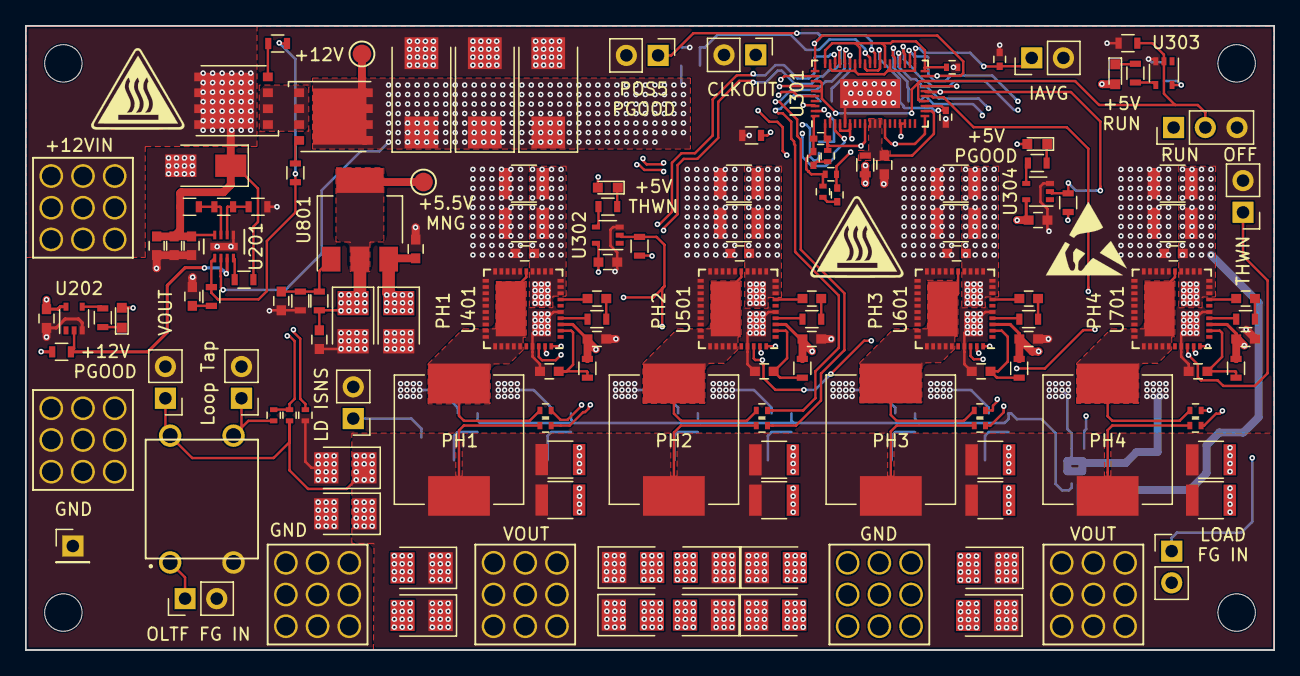
[picture p110: board LTC7851_Demo.kicad_pcb from above]

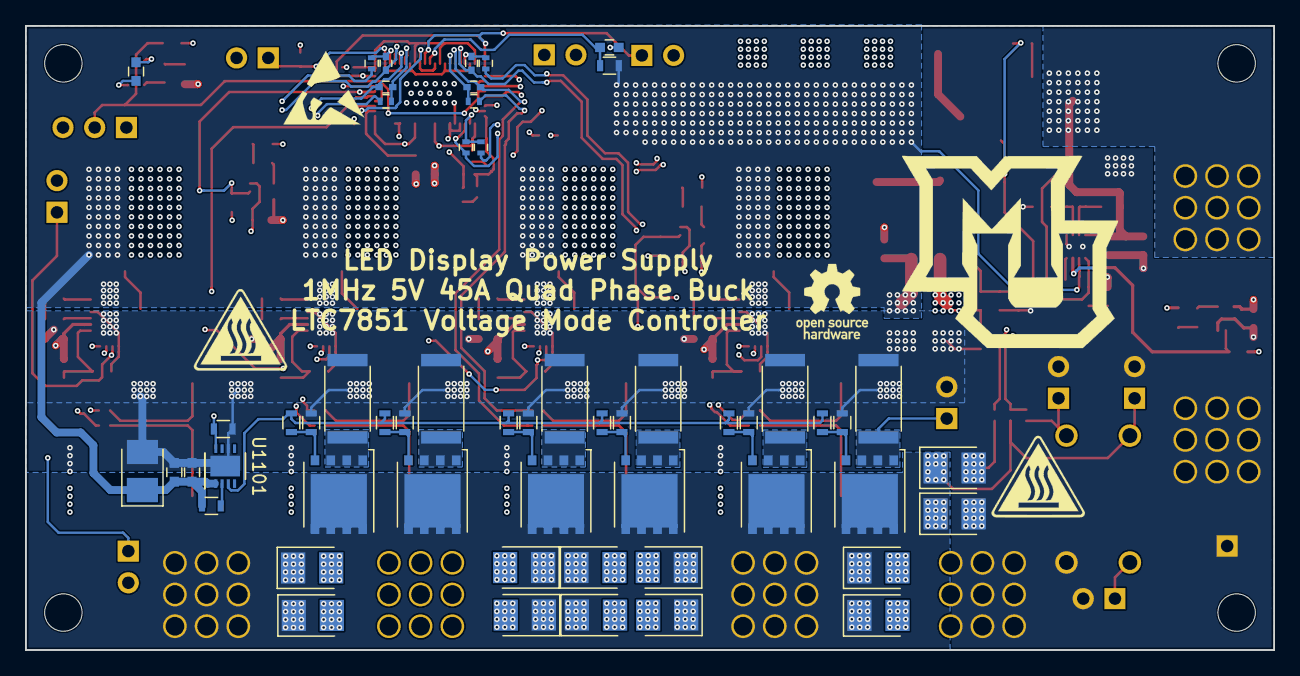
[picture p111: board LTC7851_Demo.kicad_pcb from below]

Board: 4 copper layers, 100.0 x 50.0 mm, 208 parts (55 on the bottom side), 94 nets.
