drewsum/Electronic_Display/sfw/embedded_firmware/U601_firmware/LED_Display_Controller.X/32mz_interrupt_control.c

#include <xc.h>
#include <stdio.h>

#include "32mz_interrupt_control.h"
#include "terminal_control.h"

// This function configures the system for multi-interrupt operation and
// assigns shadow registers sets to priority level ISRs
void interruptControllerInitialize(void) {
 
    // Enable multi-vector interrupt mode
    INTCONbits.MVEC = 1;
    
    // Assign shadow register sets to interrupt priorities
    // assign shadow set #7-#1 to priority level #7-#1 ISRs
    PRISS = 0x76543210;

}

// This function enables global interrupts
void enableGlobalInterrupts(void) {
 
    // This is built into the XC32 compiler
    __builtin_enable_interrupts();
    
}

// This function disables global interrupts
void disableGlobalInterrupts(void) {
 
    // This is built into the XC32 compiler
    __builtin_disable_interrupts();
    
}

// This function returns the state of global interrupt enable
// Returns 0 if global interrupts are disabled
// returns 1 if global interrupts are enabled
uint8_t getGlobalInterruptsState(void) {
 
    return __builtin_get_isr_state();
    
}

// This function explicitly sets the state of global interrupts
void setGlobalInterruptsState(uint8_t input_state) {

    __builtin_set_isr_state(input_state);
    
}


// This function allows for the setting/clearing of a given interrupt
// It manipulates that interrupt's 'Interrupt Enable' bit
void setInterruptEnable(interrupt_source_t input_interrupt, uint8_t input_state) {
 
    // Mask off anything larger than 1 to 1
    // input_state = input_state >= 1;
    
    // Decide which interrupt control bits to manipulate based on which interrupt
    // is being enabled or disabled
    switch (input_interrupt) {
        
        case Core_Timer_Interrupt:
            IEC0bits.CTIE = input_state;
            break;
            
        case Core_Software_Interrupt_0:
            IEC0bits.CS0IE = input_state;
            break;
            
        case Core_Software_Interrupt_1:
            IEC0bits.CS1IE = input_state;
            break;
            
        case External_Interrupt_0:
            IEC0bits.INT0IE = input_state;
            break;
            
        case Timer1:
            IEC0bits.T1IE = input_state;
            break;
            
        case Input_Capture_1_Error:
            IEC0bits.IC1EIE = input_state;
            break;
            
        case Input_Capture_1:
            IEC0bits.IC1IE = input_state;
            break;
            
        case Output_Compare_1:
            IEC0bits.OC1IE = input_state;
            break;
            
        case External_Interrupt_1:
            IEC0bits.INT1IE = input_state;
            break;
            
        case Timer2:
            IEC0bits.T2IE = input_state;
            break;
            
        case Input_Capture_2_Error:
            IEC0bits.IC2EIE = input_state;
            break;
            
        case Input_Capture_2:
            IEC0bits.IC2IE = input_state;
            break;
            
        case Output_Compare_2:
            IEC0bits.OC2IE = input_state;
            break;
            
        case External_Interrupt_2:
            IEC0bits.INT2IE = input_state;
            break;
            
        case Timer3:
            IEC0bits.T3IE = input_state;
            break;
            
        case Input_Capture_3_Error:
            IEC0bits.IC3EIE = input_state;
            break;
            
        case Input_Capture_3:
            IEC0bits.IC3IE = input_state;
            break;
            
        case Output_Compare_3:
            IEC0bits.OC3IE = input_state;
            break;
            
        case External_Interrupt_3:
            IEC0bits.INT3IE = input_state;
            break;
            
        case Timer4:
            IEC0bits.T4IE = input_state;
            break;
            
        case Input_Capture_4_Error:
            IEC0bits.IC4EIE = input_state;
            break;
            
        case Input_Capture_4:
            IEC0bits.IC4IE = input_state;
            break;
            
        case Output_Compare_4:
            IEC0bits.OC4IE = input_state;
            break;
            
        case External_Interrupt_4:
            IEC0bits.INT4IE = input_state;
            break;
            
        case Timer5:
            IEC0bits.T5IE = input_state;
            break;
            
        case Input_Capture_5_Error:
            IEC0bits.IC5EIE = input_state;
            break;
            
        case Input_Capture_5:
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
            break;
            
        case ADC_Data_36:
            IEC2bits.ADCD36IE = input_state;
            break;
            
        case ADC_Data_37:
            IEC3bits.ADCD37IE = input_state;
            break;
            
        case ADC_Data_38:
            IEC3bits.ADCD38IE = input_state;
            break;
            
        case ADC_Data_39:
            IEC3bits.ADCD39IE = input_state;
            break;
            
        case ADC_Data_40:
            IEC3bits.ADCD40IE = input_state;
            break;
            
        case ADC_Data_41:
            IEC3bits.ADCD41IE = input_state;
            break;
            
        case ADC_Data_42:
            IEC3bits.ADCD42IE = input_state;
            break;
            
        case ADC_Data_43:
            IEC3bits.ADCD43IE = input_state;
            break;
            
        case ADC_Data_44:
            IEC3bits.ADCD44IE = input_state;
            break;
            
        case Core_Performance_Counter_Interrupt:
            IEC3bits.CPCIE = input_state;
            break;
            
        case Core_Fast_Debug_Channel_Interrupt:
            IEC3bits.CFDCIE = input_state;
            break;
            
        case System_Bus_Protection_Violation:
            IEC3bits.SBIE = input_state;
            break;
            
        case SPI1_Fault:
            IEC3bits.SPI1EIE = input_state;
            break;
            
        case SPI1_Receive_Done:
            IEC3bits.SPI1RXIE = input_state;
            break;
            
        case SPI1_Transfer_Done:
            IEC3bits.SPI1TXIE = input_state;
            break;
            
        case UART1_Fault:
            IEC3bits.U1EIE = input_state;
            break;
            
        case UART1_Receive_Done:
            IEC3bits.U1RXIE = input_state;
            break;
            
        case UART1_Transfer_Done:
            IEC3bits.U1TXIE = input_state;
            break;
            
        case I2C1_Bus_Collision_Event:
            IEC3bits.I2C1BIE = input_state;
            break;
            
        case I2C1_Slave_Event:
            IEC3bits.I2C1SIE = input_state;
            break;
            
        case I2C1_Master_Event:
            IEC3bits.I2C1MIE = input_state;
            break;
            
        case PORTA_Input_Change_Interrupt:
            IEC3bits.CNAIE = input_state;
            break;
            
        case PORTB_Input_Change_Interrupt:
            IEC3bits.CNBIE = input_state;
            break;
            
        case PORTC_Input_Change_Interrupt:
            IEC3bits.CNCIE = input_state;
            break;
            
        case PORTD_Input_Change_Interrupt:
            IEC3bits.CNDIE = input_state;
            break;
            
        case PORTE_Input_Change_Interrupt:
            IEC3bits.CNEIE = input_state;
            break;
            
        case PORTF_Input_Change_Interrupt:
            IEC3bits.CNFIE = input_state;
            break;
            
        case PORTG_Input_Change_Interrupt:
            IEC3bits.CNGIE = input_state;
            break;
            
        case PORTH_Input_Change_Interrupt:
            IEC3bits.CNHIE = input_state;
            break;
            
        case PORTJ_Input_Change_Interrupt:
            IEC3bits.CNJIE = input_state;
            break;
            
        case PORTK_Input_Change_Interrupt:
            IEC3bits.CNKIE = input_state;
            break;
            
        case Parallel_Master_Port:
            IEC4bits.PMPIE = input_state;
            break;
            
        case Parallel_Master_Port_Error:
            IEC4bits.PMPEIE = input_state;
            break;
            
        case Comparator_1_Interrupt:
            IEC4bits.CMP1IE = input_state;
            break;
            
        case Comparator_2_Interrupt:
            IEC4bits.CMP2IE = input_state;
            break;
            
        case USB_General_Event:
            IEC4bits.USBIE = input_state;
            break;
            
        case USB_DMA_Event:
            IEC4bits.USBDMAIE = input_state;
            break;
            
        case DMA_Channel_0:
            IEC4bits.DMA0IE = input_state;
            break;
            
        case DMA_Channel_1:
            IEC4bits.DMA1IE = input_state;
            break;
            
        case DMA_Channel_2:
            IEC4bits.DMA2IE = input_state;
            break;
            
        case DMA_Channel_3:
            IEC4bits.DMA3IE = input_state;
            break;
            
        case DMA_Channel_4:
            IEC4bits.DMA4IE = input_state;
            break;
            
        case DMA_Channel_5:
            IEC4bits.DMA5IE = input_state;
            break;
            
        case DMA_Channel_6:
            IEC4bits.DMA6IE = input_state;
            break;
            
        case DMA_Channel_7:
            IEC4bits.DMA7IE = input_state;
            break;
            
        case SPI2_Fault:
            IEC4bits.SPI2EIE = input_state;
            break;
            
        case SPI2_Receive_Done:
            IEC4bits.SPI2RXIE = input_state;
            break;
            
        case SPI2_Transfer_Done:
            IEC4bits.SPI2TXIE = input_state;
            break;
            
        case UART2_Fault:
            IEC4bits.U2EIE = input_state;
            break;
            
        case UART2_Receive_Done:
            IEC4bits.U2RXIE = input_state;
            break;
            
        case UART2_Transfer_Done:
            IEC4bits.U2TXIE = input_state;
            break;
            
        case I2C2_Bus_Collision_Event:
            IEC4bits.I2C2BIE = input_state;
            break;
            
        case I2C2_Slave_Event:
            IEC4bits.I2C2SIE = input_state;
            break;
            
        case I2C2_Master_Event:
            IEC4bits.I2C2MIE = input_state;
            break;
            
        case Control_Area_Network_1:
            IEC4bits.CAN1IE = input_state;
            break;
                    
        case Control_Area_Network_2:
            IEC4bits.CAN2IE = input_state;
            break;
            
        case Ethernet_Interrupt:
            IEC4bits.ETHIE = input_state;
            break;
            
        case SPI3_Fault:
            IEC4bits.SPI3EIE = input_state;
            break;
            
        case SPI3_Receive_Done:
            IEC4bits.SPI3RXIE = input_state;
            break;
            
        case SPI3_Transfer_Done:
            IEC4bits.SPI3TXIE = input_state;
            break;
            
        case UART3_Fault:
            IEC4bits.U3EIE = input_state;
            break;
            
        case UART3_Receive_Done:
            IEC4bits.U3RXIE = input_state;
            break;
            
        case UART3_Transfer_Done:
            IEC4bits.U3TXIE = input_state;
            break;
            
        case I2C3_Bus_Collision_Event:
            IEC5bits.I2C3BIE = input_state;
            break;
            
        case I2C3_Slave_Event:
            IEC5bits.I2C3SIE = input_state;
            break;
            
        case I2C3_Master_Event:
            IEC5bits.I2C3MIE = input_state;
            break;
            
        case SPI4_Fault:
            IEC5bits.SPI5EIE = input_state;
            break;
            
        case SPI4_Receive_Done:
            IEC5bits.SPI4RXIE = input_state;
            break;
            
        case SPI4_Transfer_Done:
            IEC5bits.SPI4TXIE = input_state;
            break;
            
        case Real_Time_Clock:
            IEC5bits.RTCCIE = input_state;
            break;
            
        case Flash_Control_Event:
            IEC5bits.FCEIE = input_state;
            break;
            
        case Prefetch_Module_SEC_Event:
            IEC5bits.PREIE = input_state;
            break;
            
        case SQI1_Event:
            IEC5bits.SQI1IE = input_state;
            break;
            
        case UART4_Fault:
            IEC5bits.U4EIE = input_state;
            break;
            
        case UART4_Receive_Done:
            IEC5bits.U4RXIE = input_state;
            break;
            
        case UART4_Transfer_Done:
            IEC5bits.U4TXIE = input_state;
            break;
            
        case I2C4_Bus_Collision_Event:
            IEC5bits.I2C4BIE = input_state;
            break;
            
        case I2C4_Slave_Event:
            IEC5bits.I2C4SIE = input_state;
            break;
            
        case I2C4_Master_Event:
            IEC5bits.I2C4MIE = input_state;
            break;
            
        case SPI5_Fault:
            IEC5bits.SPI5EIE = input_state;
            break;
            
        case SPI5_Receive_Done:
            IEC5bits.SPI5RXIE = input_state;
            break;
            
        case SPI5_Transfer_Done:
            IEC5bits.SPI5TXIE = input_state;
            break;
            
        case UART5_Fault:
            IEC5bits.U5EIE = input_state;
            break;
            
        case UART5_Receive_Done:
            IEC5bits.U5RXIE = input_state;
            break;
            
        case UART5_Transfer_Done:
            IEC5bits.U5TXIE = input_state;
            break;
            
        case I2C5_Bus_Collision_Event:
            IEC5bits.I2C5BIE = input_state;
            break;
            
        case I2C5_Slave_Event:
            IEC5bits.I2C5SIE = input_state;
            break;
            
        case I2C5_Master_Event:
            IEC5bits.I2C5MIE = input_state;
            break;
        
        case SPI6_Fault:
            IEC5bits.SPI6IE = input_state;  // Error in microchip bitfield macro!!!
            break;
            
        case SPI6_Receive_Done:
            IEC5bits.SPI6RXIE = input_state;
            break;
            
        case SPI6_Transfer_Done:
            IEC5bits.SPI6TXIE = input_state;
            break;
            
        case UART6_Fault:
            IEC5bits.U6EIE = input_state;
            break;
            
        case UART6_Receive_Done:
            IEC5bits.U6RXIE = input_state;
            break;
            
        case UART6_Transfer_Done:
            IEC5bits.U6TXIE = input_state;
            break;
        
        case ADC_End_Of_Scan_Ready:
            IEC6bits.ADCEOSIE = input_state;
            break;
            
        case ADC_Analog_Circuits_Ready:
            IEC6bits.ADCARDYIE = input_state;
            break;
            
        case ADC_Update_Ready:
            IEC6bits.ADCURDYIE = input_state;
            break;
            
        case ADC_Group_Early_Interrupt_Request:
            IEC6bits.ADCGRPIE = input_state;
            break;
            
        case ADC0_Early_Interrupt:
            IEC6bits.ADC0EIE = input_state;
            break;
            
        case ADC1_Early_Interrupt:
            IEC6bits.ADC1EIE = input_state;
            break;
            
        case ADC2_Early_Interrupt:
            IEC6bits.ADC2EIE = input_state;
            break;
            
        case ADC3_Early_Interrupt:
            IEC6bits.ADC3EIE = input_state;
            break;
            
        case ADC4_Early_Interrupt:
            IEC6bits.ADC4EIE = input_state;
            break;
            
        case ADC7_Early_Interrupt:
            IEC6bits.ADC7EIE = input_state;
            break;
            
        case ADC0_Warm_Interrupt:
            IEC6bits.ADC0WIE = input_state;
            break;
            
        case ADC1_Warm_Interrupt:
            IEC6bits.ADC1WIE = input_state;
            break;
            
        case ADC2_Warm_Interrupt:
            IEC6bits.ADC2WIE = input_state;
            break;
            
        case ADC3_Warm_Interrupt:
            IEC6bits.ADC3WIE = input_state;
            break;
            
        case ADC4_Warm_Interrupt:
            IEC6bits.ADC4WIE = input_state;
            break;
            
        case ADC7_Warm_Interrupt:
            IEC6bits.ADC7WIE = input_state;
            break;
            
        default:
            break;
            
    }

}

// This function allows for the reading of a given interrupt enable
// It reads the interrupt's 'Interrupt Enable' bit with IEC registers
// Returns the state of the given interrupt
uint8_t getInterruptEnable(interrupt_source_t input_interrupt) {

    // Decide which interrupt control bits to manipulate based on which interrupt
    // is being enabled or disabled
    switch (input_interrupt) {
        
        case Core_Timer_Interrupt:
            return IEC0bits.CTIE;
            break;
            
        case Core_Software_Interrupt_0:
            return IEC0bits.CS0IE;
            break;
            
        case Core_Software_Interrupt_1:
            return IEC0bits.CS1IE;
            break;
            
        case External_Interrupt_0:
            return IEC0bits.INT0IE;
            break;
            
        case Timer1:
            return IEC0bits.T1IE;
            break;
            
        case Input_Capture_1_Error:
            return IEC0bits.IC1EIE;
            break;
            
        case Input_Capture_1:
            return IEC0bits.IC1IE;
            break;
            
        case Output_Compare_1:
            return IEC0bits.OC1IE;
            break;
            
        case External_Interrupt_1:
            return IEC0bits.INT1IE;
            break;
            
        case Timer2:
            return IEC0bits.T2IE;
            break;
            
        case Input_Capture_2_Error:
            return IEC0bits.IC2EIE;
            break;
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
            
        case ADC_Data_25:
            return IEC2bits.ADCD25IE;
            break;
            
        case ADC_Data_26:
            return IEC2bits.ADCD26IE;
            break;
            
        case ADC_Data_27:
            return IEC2bits.ADCD27IE;
            break;
            
        case ADC_Data_28:
            return IEC2bits.ADCD28IE;
            break;
            
        case ADC_Data_29:
            return IEC2bits.ADCD29IE;
            break;
            
        case ADC_Data_30:
            return IEC2bits.ADCD30IE;
            break;
            
        case ADC_Data_31:
            return IEC2bits.ADCD31IE;
            break;
            
        case ADC_Data_32:
            return IEC2bits.ADCD32IE;
            break;
            
        case ADC_Data_33:
            return IEC2bits.ADCD33IE;
            break;
            
        case ADC_Data_34:
            return IEC2bits.ADCD34IE;
            break;
            
        case ADC_Data_35:
            return IEC2bits.ADCD35IE;
            break;
            
        case ADC_Data_36:
            return IEC2bits.ADCD36IE;
            break;
            
        case ADC_Data_37:
            return IEC3bits.ADCD37IE;
            break;
            
        case ADC_Data_38:
            return IEC3bits.ADCD38IE;
            break;
            
        case ADC_Data_39:
            return IEC3bits.ADCD39IE;
            break;
            
        case ADC_Data_40:
            return IEC3bits.ADCD40IE;
            break;
            
        case ADC_Data_41:
            return IEC3bits.ADCD41IE;
            break;
            
        case ADC_Data_42:
            return IEC3bits.ADCD42IE;
            break;
            
        case ADC_Data_43:
            return IEC3bits.ADCD43IE;
            break;
            
        case ADC_Data_44:
            return IEC3bits.ADCD44IE;
            break;
            
        case Core_Performance_Counter_Interrupt:
            return IEC3bits.CPCIE;
            break;
            
        case Core_Fast_Debug_Channel_Interrupt:
            return IEC3bits.CFDCIE;
            break;
            
        case System_Bus_Protection_Violation:
            return IEC3bits.SBIE;
            break;
            
        case SPI1_Fault:
            return IEC3bits.SPI1EIE;
            break;
            
        case SPI1_Receive_Done:
            return IEC3bits.SPI1RXIE;
            break;
            
        case SPI1_Transfer_Done:
            return IEC3bits.SPI1TXIE;
            break;
            
        case UART1_Fault:
            return IEC3bits.U1EIE;
            break;
            
        case UART1_Receive_Done:
            return IEC3bits.U1RXIE;
            break;
            
        case UART1_Transfer_Done:
            return IEC3bits.U1TXIE;
            break;
            
        case I2C1_Bus_Collision_Event:
            return IEC3bits.I2C1BIE;
            break;
            
        case I2C1_Slave_Event:
            return IEC3bits.I2C1SIE;
            break;
            
        case I2C1_Master_Event:
            return IEC3bits.I2C1MIE;
            break;
            
        case PORTA_Input_Change_Interrupt:
            return IEC3bits.CNAIE;
            break;
            
        case PORTB_Input_Change_Interrupt:
            return IEC3bits.CNBIE;
            break;
            
        case PORTC_Input_Change_Interrupt:
            return IEC3bits.CNCIE;
            break;
            
        case PORTD_Input_Change_Interrupt:
            return IEC3bits.CNDIE;
            break;
            
        case PORTE_Input_Change_Interrupt:
            return IEC3bits.CNEIE;
            break;
            
        case PORTF_Input_Change_Interrupt:
            return IEC3bits.CNFIE;
            break;
            
        case PORTG_Input_Change_Interrupt:
            return IEC3bits.CNGIE;
            break;
            
        case PORTH_Input_Change_Interrupt:
            return IEC3bits.CNHIE;
            break;
            
        case PORTJ_Input_Change_Interrupt:
            return IEC3bits.CNJIE;
            break;
            
        case PORTK_Input_Change_Interrupt:
            return IEC3bits.CNKIE;
            break;
            
        case Parallel_Master_Port:
            return IEC4bits.PMPIE;
            break;
            
        case Parallel_Master_Port_Error:
            return IEC4bits.PMPEIE;
            break;
            
        case Comparator_1_Interrupt:
            return IEC4bits.CMP1IE;
            break;
            
        case Comparator_2_Interrupt:
            return IEC4bits.CMP2IE;
            break;
            
        case USB_General_Event:
            return IEC4bits.USBIE;
            break;
            
        case USB_DMA_Event:
            return IEC4bits.USBDMAIE;
            break;
            
        case DMA_Channel_0:
            return IEC4bits.DMA0IE;
            break;
            
        case DMA_Channel_1:
            return IEC4bits.DMA1IE;
            break;
            
        case DMA_Channel_2:
            return IEC4bits.DMA2IE;
            break;
            
        case DMA_Channel_3:
            return IEC4bits.DMA3IE;
            break;
            
        case DMA_Channel_4:
            return IEC4bits.DMA4IE;
            break;
            
        case DMA_Channel_5:
            return IEC4bits.DMA5IE;
            break;
            
        case DMA_Channel_6:
            return IEC4bits.DMA6IE;
            break;
            
        case DMA_Channel_7:
            return IEC4bits.DMA7IE;
            break;
            
        case SPI2_Fault:
            return IEC4bits.SPI2EIE;
            break;
            
        case SPI2_Receive_Done:
            return IEC4bits.SPI2RXIE;
            break;
            
        case SPI2_Transfer_Done:
            return IEC4bits.SPI2TXIE;
            break;
            
        case UART2_Fault:
            return IEC4bits.U2EIE;
            break;
            
        case UART2_Receive_Done:
            return IEC4bits.U2RXIE;
            break;
            
        case UART2_Transfer_Done:
            return IEC4bits.U2TXIE;
            break;
            
        case I2C2_Bus_Collision_Event:
            return IEC4bits.I2C2BIE;
            break;
            
        case I2C2_Slave_Event:
            return IEC4bits.I2C2SIE;
            break;
            
        case I2C2_Master_Event:
            return IEC4bits.I2C2MIE;
            break;
            
        case Control_Area_Network_1:
            return IEC4bits.CAN1IE;
            break;
                    
        case Control_Area_Network_2:
            return IEC4bits.CAN2IE;
            break;
            
        case Ethernet_Interrupt:
            return IEC4bits.ETHIE;
            break;
            
        case SPI3_Fault:
            return IEC4bits.SPI3EIE;
            break;
            
        case SPI3_Receive_Done:
            return IEC4bits.SPI3RXIE;
            break;
            
        case SPI3_Transfer_Done:
            return IEC4bits.SPI3TXIE;
            break;
            
        case UART3_Fault:
            return IEC4bits.U3EIE;
            break;
            
        case UART3_Receive_Done:
            return IEC4bits.U3RXIE;
            break;
            
        case UART3_Transfer_Done:
            return IEC4bits.U3TXIE;
            break;
            
        case I2C3_Bus_Collision_Event:
            return IEC5bits.I2C3BIE;
            break;
            
        case I2C3_Slave_Event:
            return IEC5bits.I2C3SIE;
            break;
            
        case I2C3_Master_Event:
            return IEC5bits.I2C3MIE;
            break;
            
        case SPI4_Fault:
            return IEC5bits.SPI5EIE;
            break;
            
        case SPI4_Receive_Done:
            return IEC5bits.SPI4RXIE;
            break;
            
        case SPI4_Transfer_Done:
            return IEC5bits.SPI4TXIE;
            break;
            
        case Real_Time_Clock:
            return IEC5bits.RTCCIE;
            break;
            
        case Flash_Control_Event:
            return IEC5bits.FCEIE;
            break;
            
        case Prefetch_Module_SEC_Event:
            return IEC5bits.PREIE;
            break;
            
        case SQI1_Event:
            return IEC5bits.SQI1IE;
            break;
            
        case UART4_Fault:
            return IEC5bits.U4EIE;
            break;
            
        case UART4_Receive_Done:
            return IEC5bits.U4RXIE;
            break;
            
        case UART4_Transfer_Done:
            return IEC5bits.U4TXIE;
            break;
            
        case I2C4_Bus_Collision_Event:
            return IEC5bits.I2C4BIE;
            break;
            
        case I2C4_Slave_Event:
            return IEC5bits.I2C4SIE;
            break;
            
        case I2C4_Master_Event:
            return IEC5bits.I2C4MIE;
            break;
            
        case SPI5_Fault:
            return IEC5bits.SPI5EIE;
            break;
            
        case SPI5_Receive_Done:
            return IEC5bits.SPI5RXIE;
            break;
            
        case SPI5_Transfer_Done:
            return IEC5bits.SPI5TXIE;
            break;
            
        case UART5_Fault:
            return IEC5bits.U5EIE;
            break;
            
        case UART5_Receive_Done:
            return IEC5bits.U5RXIE;
            break;
            
        case UART5_Transfer_Done:
            return IEC5bits.U5TXIE;
            break;
            
        case I2C5_Bus_Collision_Event:
            return IEC5bits.I2C5BIE;
            break;
            
        case I2C5_Slave_Event:
            return IEC5bits.I2C5SIE;
            break;
            
        case I2C5_Master_Event:
            return IEC5bits.I2C5MIE;
            break;
        
        case SPI6_Fault:
            return IEC5bits.SPI6IE;  // Error in microchip bitfield macro!!!
            break;
            
        case SPI6_Receive_Done:
            return IEC5bits.SPI6RXIE;
            break;
            
        case SPI6_Transfer_Done:
            return IEC5bits.SPI6TXIE;
            break;
            
        case UART6_Fault:
            return IEC5bits.U6EIE;
            break;
            
        case UART6_Receive_Done:
            return IEC5bits.U6RXIE;
            break;
            
        case UART6_Transfer_Done:
            return IEC5bits.U6TXIE;
            break;
        
        case ADC_End_Of_Scan_Ready:
            return IEC6bits.ADCEOSIE;
            break;
            
        case ADC_Analog_Circuits_Ready:
            return IEC6bits.ADCARDYIE;
            break;
            
        case ADC_Update_Ready:
            return IEC6bits.ADCURDYIE;
            break;
            
        case ADC_Group_Early_Interrupt_Request:
            return IEC6bits.ADCGRPIE;
            break;
            
        case ADC0_Early_Interrupt:
            return IEC6bits.ADC0EIE;
            break;
            
        case ADC1_Early_Interrupt:
            return IEC6bits.ADC1EIE;
            break;
            
        case ADC2_Early_Interrupt:
            return IEC6bits.ADC2EIE;
            break;
            
        case ADC3_Early_Interrupt:
            return IEC6bits.ADC3EIE;
            break;
            
        case ADC4_Early_Interrupt:
            return IEC6bits.ADC4EIE;
            break;
            
        case ADC7_Early_Interrupt:
            return IEC6bits.ADC7EIE;
            break;
            
        case ADC0_Warm_Interrupt:
            return IEC6bits.ADC0WIE;
            break;
            
        case ADC1_Warm_Interrupt:
            return IEC6bits.ADC1WIE;
            break;
            
        case ADC2_Warm_Interrupt:
            return IEC6bits.ADC2WIE;
            break;
            
        case ADC3_Warm_Interrupt:
            return IEC6bits.ADC3WIE;
            break;
            
        case ADC4_Warm_Interrupt:
            return IEC6bits.ADC4WIE;
            break;
            
        case ADC7_Warm_Interrupt:
            return IEC6bits.ADC7WIE;
            break;
            
        default:
            return 0;
            break;
                   
    }
    
}


// This function allows for the setting/clearing of a given interrupt flag
// It manipulates the interrupt's 'Interrupt Flag' bit
// Returns 0 if no errors
// Returns 1 if errors
void setInterruptFlag(interrupt_source_t input_interrupt, uint8_t input_state) {
 
    // Mask off anything larger than 1 to 1
    // input_state = input_state >= 1;
    
    // Decide which interrupt control bits to manipulate based on which interrupt
    // is being enabled or disabled
    switch (input_interrupt) {
        
        case Core_Timer_Interrupt:
            IFS0bits.CTIF = input_state;
            break;
            
        case Core_Software_Interrupt_0:
            IFS0bits.CS0IF = input_state;
            break;
            
        case Core_Software_Interrupt_1:
            IFS0bits.CS1IF = input_state;
            break;
            
        case External_Interrupt_0:
            IFS0bits.INT0IF = input_state;
            break;
            
        case Timer1:
            IFS0bits.T1IF = input_state;
            break;
            
        case Input_Capture_1_Error:
            IFS0bits.IC1EIF = input_state;
            break;
            
        case Input_Capture_1:
            IFS0bits.IC1IF = input_state;
            break;
            
        case Output_Compare_1:
            IFS0bits.OC1IF = input_state;
            break;
            
        case External_Interrupt_1:
            IFS0bits.INT1IF = input_state;
            break;
            
        case Timer2:
            IFS0bits.T2IF = input_state;
            break;
            
        case Input_Capture_2_Error:
            IFS0bits.IC2EIF = input_state;
            break;
            
        case Input_Capture_2:
            IFS0bits.IC2IF = input_state;
            break;
            
        case Output_Compare_2:
            IFS0bits.OC2IF = input_state;
            break;
            
        case External_Interrupt_2:
            IFS0bits.INT2IF = input_state;
            break;
            
        case Timer3:
            IFS0bits.T3IF = input_state;
            break;
            
        case Input_Capture_3_Error:
            IFS0bits.IC3EIF = input_state;
            break;
            
        case Input_Capture_3:
            IFS0bits.IC3IF = input_state;
            break;
            
        case Output_Compare_3:
            IFS0bits.OC3IF = input_state;
            break;
            
        case External_Interrupt_3:
            IFS0bits.INT3IF = input_state;
            break;
            
        case Timer4:
            IFS0bits.T4IF = input_state;
            break;
            
        case Input_Capture_4_Error:
            IFS0bits.IC4EIF = input_state;
            break;
            
        case Input_Capture_4:
            IFS0bits.IC4IF = input_state;
            break;
            
        case Output_Compare_4:
            IFS0bits.OC4IF = input_state;
            break;
            
        case External_Interrupt_4:
            IFS0bits.INT4IF = input_state;
            break;
            
        case Timer5:
            IFS0bits.T5IF = input_state;
            break;
            
        case Input_Capture_5_Error:
            IFS0bits.IC5EIF = input_state;
            break;
            
        case Input_Capture_5:
            IFS0bits.IC5IF = input_state;
            break;
            
        case Output_Compare_5:
            IFS0bits.OC5IF = input_state;
            break;
            
        case Timer6:
            IFS0bits.T6IF = input_state;
            break;
            
        case Input_Capture_6_Error:
            IFS0bits.IC6EIF = input_state;
            break;
            
        case Input_Capture_6:
            IFS0bits.IC6IF = input_state;
            break;
            
        case Output_Compare_6:
            IFS0bits.OC6IF = input_state;
            break;
            
        case Timer7:
            IFS1bits.T7IF = input_state;
            break;
            
        case Input_Capture_7_Error:
            IFS1bits.IC7EIF = input_state;
            break;
            
        case Input_Capture_7:
            IFS1bits.IC7IF = input_state;
            break;
            
        case Output_Compare_7:
            IFS1bits.OC7IF = input_state;
            break;
            
        case Timer8:
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
            IFS3bits.CPCIF = input_state;
            break;
            
        case Core_Fast_Debug_Channel_Interrupt:
            IFS3bits.CFDCIF = input_state;
            break;
            
        case System_Bus_Protection_Violation:
            IFS3bits.SBIF = input_state;
            break;
            
        case SPI1_Fault:
            IFS3bits.SPI1EIF = input_state;
            break;
            
        case SPI1_Receive_Done:
            IFS3bits.SPI1RXIF = input_state;
            break;
            
        case SPI1_Transfer_Done:
            IFS3bits.SPI1TXIF = input_state;
            break;
            
        case UART1_Fault:
            IFS3bits.U1EIF = input_state;
            break;
            
        case UART1_Receive_Done:
            IFS3bits.U1RXIF = input_state;
            break;
            
        case UART1_Transfer_Done:
            IFS3bits.U1TXIF = input_state;
            break;
            
        case I2C1_Bus_Collision_Event:
            IFS3bits.I2C1BIF = input_state;
            break;
            
        case I2C1_Slave_Event:
            IFS3bits.I2C1SIF = input_state;
            break;
            
        case I2C1_Master_Event:
            IFS3bits.I2C1MIF = input_state;
            break;
            
        case PORTA_Input_Change_Interrupt:
            IFS3bits.CNAIF = input_state;
            break;
            
        case PORTB_Input_Change_Interrupt:
            IFS3bits.CNBIF = input_state;
            break;
            
        case PORTC_Input_Change_Interrupt:
            IFS3bits.CNCIF = input_state;
            break;
            
        case PORTD_Input_Change_Interrupt:
            IFS3bits.CNDIF = input_state;
            break;
            
        case PORTE_Input_Change_Interrupt:
            IFS3bits.CNEIF = input_state;
            break;
            
        case PORTF_Input_Change_Interrupt:
            IFS3bits.CNFIF = input_state;
            break;
            
        case PORTG_Input_Change_Interrupt:
            IFS3bits.CNGIF = input_state;
            break;
            
        case PORTH_Input_Change_Interrupt:
            IFS3bits.CNHIF = input_state;
            break;
            
        case PORTJ_Input_Change_Interrupt:
            IFS3bits.CNJIF = input_state;
            break;
            
        case PORTK_Input_Change_Interrupt:
            IFS3bits.CNKIF = input_state;
            break;
            
        case Parallel_Master_Port:
            IFS4bits.PMPIF = input_state;
            break;
            
        case Parallel_Master_Port_Error:
            IFS4bits.PMPEIF = input_state;
            break;
            
        case Comparator_1_Interrupt:
            IFS4bits.CMP1IF = input_state;
            break;
            
        case Comparator_2_Interrupt:
            IFS4bits.CMP2IF = input_state;
            break;
            
        case USB_General_Event:
            IFS4bits.USBIF = input_state;
            break;
            
        case USB_DMA_Event:
            IFS4bits.USBDMAIF = input_state;
            break;
            
        case DMA_Channel_0:
            IFS4bits.DMA0IF = input_state;
            break;
            
        case DMA_Channel_1:
            IFS4bits.DMA1IF = input_state;
            break;
            
        case DMA_Channel_2:
            IFS4bits.DMA2IF = input_state;
            break;
            
        case DMA_Channel_3:
            IFS4bits.DMA3IF = input_state;
            break;
            
        case DMA_Channel_4:
            IFS4bits.DMA4IF = input_state;
            break;
            
        case DMA_Channel_5:
            IFS4bits.DMA5IF = input_state;
            break;
            
        case DMA_Channel_6:
            IFS4bits.DMA6IF = input_state;
            break;
            
        case DMA_Channel_7:
            IFS4bits.DMA7IF = input_state;
            break;
            
        case SPI2_Fault:
            IFS4bits.SPI2EIF = input_state;
            break;
            
        case SPI2_Receive_Done:
            IFS4bits.SPI2RXIF = input_state;
            break;
            
        case SPI2_Transfer_Done:
            IFS4bits.SPI2TXIF = input_state;
            break;
            
        case UART2_Fault:
            IFS4bits.U2EIF = input_state;
            break;
            
        case UART2_Receive_Done:
            IFS4bits.U2RXIF = input_state;
            break;
            
        case UART2_Transfer_Done:
            IFS4bits.U2TXIF = input_state;
            break;
            
        case I2C2_Bus_Collision_Event:
            IFS4bits.I2C2BIF = input_state;
            break;
            
        case I2C2_Slave_Event:
            IFS4bits.I2C2SIF = input_state;
            break;
            
        case I2C2_Master_Event:
            IFS4bits.I2C2MIF = input_state;
            break;
            
        case Control_Area_Network_1:
            IFS4bits.CAN1IF = input_state;
            break;
                    
        case Control_Area_Network_2:
            IFS4bits.CAN2IF = input_state;
            break;
            
        case Ethernet_Interrupt:
            IFS4bits.ETHIF = input_state;
            break;
            
        case SPI3_Fault:
            IFS4bits.SPI3EIF = input_state;
            break;
            
        case SPI3_Receive_Done:
            IFS4bits.SPI3RXIF = input_state;
            break;
            
        case SPI3_Transfer_Done:
            IFS4bits.SPI3TXIF = input_state;
            break;
            
        case UART3_Fault:
            IFS4bits.U3EIF = input_state;
            break;
            
        case UART3_Receive_Done:
            IFS4bits.U3RXIF = input_state;
            break;
            
        case UART3_Transfer_Done:
            IFS4bits.U3TXIF = input_state;
            break;
            
        case I2C3_Bus_Collision_Event:
            IFS5bits.I2C3BIF = input_state;
            break;
            
        case I2C3_Slave_Event:
            IFS5bits.I2C3SIF = input_state;
            break;
            
        case I2C3_Master_Event:
            IFS5bits.I2C3MIF = input_state;
            break;
            
        case SPI4_Fault:
            IFS5bits.SPI5EIF = input_state;
            break;
            
        case SPI4_Receive_Done:
            IFS5bits.SPI4RXIF = input_state;
            break;
            
        case SPI4_Transfer_Done:
            IFS5bits.SPI4TXIF = input_state;
            break;
            
        case Real_Time_Clock:
            IFS5bits.RTCCIF = input_state;
            break;
            
        case Flash_Control_Event:
            IFS5bits.FCEIF = input_state;
            break;
            
        case Prefetch_Module_SEC_Event:
            IFS5bits.PREIF = input_state;
            break;
            
        case SQI1_Event:
            IFS5bits.SQI1IF = input_state;
            break;
            
        case UART4_Fault:
            IFS5bits.U4EIF = input_state;
            break;
            
        case UART4_Receive_Done:
            IFS5bits.U4RXIF = input_state;
            break;
            
        case UART4_Transfer_Done:
            IFS5bits.U4TXIF = input_state;
            break;
            
        case I2C4_Bus_Collision_Event:
            IFS5bits.I2C4BIF = input_state;
            break;
            
        case I2C4_Slave_Event:
            IFS5bits.I2C4SIF = input_state;
            break;
            
        case I2C4_Master_Event:
            IFS5bits.I2C4MIF = input_state;
            break;
            
        case SPI5_Fault:
            IFS5bits.SPI5EIF = input_state;
            break;
            
        case SPI5_Receive_Done:
            IFS5bits.SPI5RXIF = input_state;
            break;
            
        case SPI5_Transfer_Done:
            IFS5bits.SPI5TXIF = input_state;
            break;
            
        case UART5_Fault:
            IFS5bits.U5EIF = input_state;
            break;
            
        case UART5_Receive_Done:
            IFS5bits.U5RXIF = input_state;
            break;
            
        case UART5_Transfer_Done:
            IFS5bits.U5TXIF = input_state;
            break;
            
        case I2C5_Bus_Collision_Event:
            IFS5bits.I2C5BIF = input_state;
            break;
            
        case I2C5_Slave_Event:
            IFS5bits.I2C5SIF = input_state;
            break;
            
        case I2C5_Master_Event:
            IFS5bits.I2C5MIF = input_state;
            break;
        
        case SPI6_Fault:
            IFS5bits.SPI6IF = input_state;  // Error in microchip bitfield macro!!!
            break;
            
        case SPI6_Receive_Done:
            IFS5bits.SPI6RXIF = input_state;
            break;
            
        case SPI6_Transfer_Done:
            IFS5bits.SPI6TX = input_state;  // Error in microchip bitfield macro!!!
            break;
            
        case UART6_Fault:
            IFS5bits.U6EIF = input_state;
            break;
            
        case UART6_Receive_Done:
            IFS5bits.U6RXIF = input_state;
            break;
            
        case UART6_Transfer_Done:
            IFS5bits.U6TXIF = input_state;
            break;
        
        case ADC_End_Of_Scan_Ready:
            IFS6bits.ADCEOSIF = input_state;
            break;
            
        case ADC_Analog_Circuits_Ready:
            IFS6bits.ADCARDYIF = input_state;
            break;
            
        case ADC_Update_Ready:
            IFS6bits.ADCURDYIF = input_state;
            break;
            
        case ADC_Group_Early_Interrupt_Request:
            IFS6bits.ADCGRPIF = input_state;
            break;
            
        case ADC0_Early_Interrupt:
            IFS6bits.ADC0EIF = input_state;
            break;
            
        case ADC1_Early_Interrupt:
            IFS6bits.ADC1EIF = input_state;
            break;
            
        case ADC2_Early_Interrupt:
            IFS6bits.ADC2EIF = input_state;
            break;
            
        case ADC3_Early_Interrupt:
            IFS6bits.ADC3EIF = input_state;
            break;
            
        case ADC4_Early_Interrupt:
            IFS6bits.ADC4EIF = input_state;
            break;
            
        case ADC7_Early_Interrupt:
            IFS6bits.ADC7EIF = input_state;
            break;
            
        case ADC0_Warm_Interrupt:
            IFS6bits.ADC0WIF = input_state;
            break;
            
        case ADC1_Warm_Interrupt:
            IFS6bits.ADC1WIF = input_state;
            break;
            
        case ADC2_Warm_Interrupt:
            IFS6bits.ADC2WIF = input_state;
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
            return IFS2bits.ADCD25IF;
            break;
            
        case ADC_Data_26:
            return IFS2bits.ADCD26IF;
            break;
            
        case ADC_Data_27:
            return IFS2bits.ADCD27IF;
            break;
            
        case ADC_Data_28:
            return IFS2bits.ADCD28IF;
            break;
            
        case ADC_Data_29:
            return IFS2bits.ADCD29IF;
            break;
            
        case ADC_Data_30:
            return IFS2bits.ADCD30IF;
            break;
            
        case ADC_Data_31:
            return IFS2bits.ADCD31IF;
            break;
            
        case ADC_Data_32:
            return IFS2bits.ADCD32IF;
            break;
            
        case ADC_Data_33:
            return IFS2bits.ADCD33IF;
            break;
            
        case ADC_Data_34:
            return IFS2bits.ADCD34IF;
            break;
            
        case ADC_Data_35:
            return IFS2bits.ADCD35IF;
            break;
            
        case ADC_Data_36:
            return IFS2bits.ADCD36IF;
            break;
            
        case ADC_Data_37:
            return IFS3bits.ADCD37IF;
            break;
            
        case ADC_Data_38:
            return IFS3bits.ADCD38IF;
            break;
            
        case ADC_Data_39:
            return IFS3bits.ADCD39IF;
            break;
            
        case ADC_Data_40:
            return IFS3bits.ADCD40IF;
            break;
            
        case ADC_Data_41:
            return IFS3bits.ADCD41IF;
            break;
            
        case ADC_Data_42:
            return IFS3bits.ADCD42IF;
            break;
            
        case ADC_Data_43:
            return IFS3bits.ADCD43IF;
            break;
            
        case ADC_Data_44:
            return IFS3bits.ADCD44IF;
            break;
            
        case Core_Performance_Counter_Interrupt:
            return IFS3bits.CPCIF;
            break;
            
        case Core_Fast_Debug_Channel_Interrupt:
            return IFS3bits.CFDCIF;
            break;
            
        case System_Bus_Protection_Violation:
            return IFS3bits.SBIF;
            break;
            
        case SPI1_Fault:
            return IFS3bits.SPI1EIF;
            break;
            
        case SPI1_Receive_Done:
            return IFS3bits.SPI1RXIF;
            break;
            
        case SPI1_Transfer_Done:
            return IFS3bits.SPI1TXIF;
            break;
            
        case UART1_Fault:
            return IFS3bits.U1EIF;
            break;
            
        case UART1_Receive_Done:
            return IFS3bits.U1RXIF;
            break;
            
        case UART1_Transfer_Done:
            return IFS3bits.U1TXIF;
            break;
            
        case I2C1_Bus_Collision_Event:
            return IFS3bits.I2C1BIF;
            break;
            
        case I2C1_Slave_Event:
            return IFS3bits.I2C1SIF;
            break;
            
        case I2C1_Master_Event:
            return IFS3bits.I2C1MIF;
            break;
            
        case PORTA_Input_Change_Interrupt:
            return IFS3bits.CNAIF;
            break;
            
        case PORTB_Input_Change_Interrupt:
            return IFS3bits.CNBIF;
            break;
            
        case PORTC_Input_Change_Interrupt:
            return IFS3bits.CNCIF;
            break;
            
        case PORTD_Input_Change_Interrupt:
            return IFS3bits.CNDIF;
            break;
            
        case PORTE_Input_Change_Interrupt:
            return IFS3bits.CNEIF;
            break;
            
        case PORTF_Input_Change_Interrupt:
            return IFS3bits.CNFIF;
            break;
            
        case PORTG_Input_Change_Interrupt:
            return IFS3bits.CNGIF;
            break;
            
        case PORTH_Input_Change_Interrupt:
            return IFS3bits.CNHIF;
            break;
            
        case PORTJ_Input_Change_Interrupt:
            return IFS3bits.CNJIF;
            break;
            
        case PORTK_Input_Change_Interrupt:
            return IFS3bits.CNKIF;
            break;
            
        case Parallel_Master_Port:
            return IFS4bits.PMPIF;
            break;
            
        case Parallel_Master_Port_Error:
            return IFS4bits.PMPEIF;
            break;
            
        case Comparator_1_Interrupt:
            return IFS4bits.CMP1IF;
            break;
            
        case Comparator_2_Interrupt:
            return IFS4bits.CMP2IF;
            break;
            
        case USB_General_Event:
            return IFS4bits.USBIF;
            break;
            
        case USB_DMA_Event:
            return IFS4bits.USBDMAIF;
            break;
            
        case DMA_Channel_0:
            return IFS4bits.DMA0IF;
            break;
            
        case DMA_Channel_1:
            return IFS4bits.DMA1IF;
            break;
            
        case DMA_Channel_2:
            return IFS4bits.DMA2IF;
            break;
            
        case DMA_Channel_3:
            return IFS4bits.DMA3IF;
            break;
            
        case DMA_Channel_4:
            return IFS4bits.DMA4IF;
            break;
            
        case DMA_Channel_5:
            return IFS4bits.DMA5IF;
            break;
            
        case DMA_Channel_6:
            return IFS4bits.DMA6IF;
            break;
            
        case DMA_Channel_7:
            return IFS4bits.DMA7IF;
            break;
            
        case SPI2_Fault:
            return IFS4bits.SPI2EIF;
            break;
            
        case SPI2_Receive_Done:
            return IFS4bits.SPI2RXIF;
            break;
            
        case SPI2_Transfer_Done:
            return IFS4bits.SPI2TXIF;
            break;
            
        case UART2_Fault:
            return IFS4bits.U2EIF;
            break;
            
        case UART2_Receive_Done:
            return IFS4bits.U2RXIF;
            break;
            
        case UART2_Transfer_Done:
            return IFS4bits.U2TXIF;
            break;
            
        case I2C2_Bus_Collision_Event:
            return IFS4bits.I2C2BIF;
            break;
            
        case I2C2_Slave_Event:
            return IFS4bits.I2C2SIF;
            break;
            
        case I2C2_Master_Event:
            return IFS4bits.I2C2MIF;
            break;
            
        case Control_Area_Network_1:
            return IFS4bits.CAN1IF;
            break;
                    
        case Control_Area_Network_2:
            return IFS4bits.CAN2IF;
            break;
            
        case Ethernet_Interrupt:
            return IFS4bits.ETHIF;
            break;
            
        case SPI3_Fault:
            return IFS4bits.SPI3EIF;
            break;
            
        case SPI3_Receive_Done:
            return IFS4bits.SPI3RXIF;
            break;
            
        case SPI3_Transfer_Done:
            return IFS4bits.SPI3TXIF;
            break;
            
        case UART3_Fault:
            return IFS4bits.U3EIF;
            break;
            
        case UART3_Receive_Done:
            return IFS4bits.U3RXIF;
            break;
            
        case UART3_Transfer_Done:
            return IFS4bits.U3TXIF;
            break;
            
        case I2C3_Bus_Collision_Event:
            return IFS5bits.I2C3BIF;
            break;
            
        case I2C3_Slave_Event:
            return IFS5bits.I2C3SIF;
            break;
            
        case I2C3_Master_Event:
            return IFS5bits.I2C3MIF;
            break;
            
        case SPI4_Fault:
            return IFS5bits.SPI5EIF;
            break;
            
        case SPI4_Receive_Done:
            return IFS5bits.SPI4RXIF;
            break;
            
        case SPI4_Transfer_Done:
            return IFS5bits.SPI4TXIF;
            break;
            
        case Real_Time_Clock:
            return IFS5bits.RTCCIF;
            break;
            
        case Flash_Control_Event:
            return IFS5bits.FCEIF;
            break;
            
        case Prefetch_Module_SEC_Event:
            return IFS5bits.PREIF;
            break;
            
        case SQI1_Event:
            return IFS5bits.SQI1IF;
            break;
            
        case UART4_Fault:
            return IFS5bits.U4EIF;
            break;
            
        case UART4_Receive_Done:
            return IFS5bits.U4RXIF;
            break;
            
        case UART4_Transfer_Done:
            return IFS5bits.U4TXIF;
            break;
            
        case I2C4_Bus_Collision_Event:
            return IFS5bits.I2C4BIF;
            break;
            
        case I2C4_Slave_Event:
            return IFS5bits.I2C4SIF;
            break;
            
        case I2C4_Master_Event:
            return IFS5bits.I2C4MIF;
            break;
            
        case SPI5_Fault:
            return IFS5bits.SPI5EIF;
            break;
            
        case SPI5_Receive_Done:
            return IFS5bits.SPI5RXIF;
            break;
            
        case SPI5_Transfer_Done:
            return IFS5bits.SPI5TXIF;
            break;
            
        case UART5_Fault:
            return IFS5bits.U5EIF;
            break;
            
        case UART5_Receive_Done:
            return IFS5bits.U5RXIF;
            break;
            
        case UART5_Transfer_Done:
            return IFS5bits.U5TXIF;
            break;
            
        case I2C5_Bus_Collision_Event:
            return IFS5bits.I2C5BIF;
            break;
            
        case I2C5_Slave_Event:
            return IFS5bits.I2C5SIF;
            break;
            
        case I2C5_Master_Event:
            return IFS5bits.I2C5MIF;
            break;
        
        case SPI6_Fault:
            return IFS5bits.SPI6IF;  // Error in microchip bitfield macro!!!
            break;
            
        case SPI6_Receive_Done:
            return IFS5bits.SPI6RXIF;
            break;
            
        case SPI6_Transfer_Done:
            return IFS5bits.SPI6TX;  // Error in microchip bitfield macro!!!
            break;
            
        case UART6_Fault:
            return IFS5bits.U6EIF;
            break;
            
        case UART6_Receive_Done:
            return IFS5bits.U6RXIF;
            break;
            
        case UART6_Transfer_Done:
            return IFS5bits.U6TXIF;
            break;
        
        case ADC_End_Of_Scan_Ready:
            return IFS6bits.ADCEOSIF;
            break;
            
        case ADC_Analog_Circuits_Ready:
            return IFS6bits.ADCARDYIF;
            break;
            
        case ADC_Update_Ready:
            return IFS6bits.ADCURDYIF;
            break;
            
        case ADC_Group_Early_Interrupt_Request:
            return IFS6bits.ADCGRPIF;
            break;
            
        case ADC0_Early_Interrupt:
            return IFS6bits.ADC0EIF;
            break;
            
        case ADC1_Early_Interrupt:
            return IFS6bits.ADC1EIF;
            break;
            
        case ADC2_Early_Interrupt:
            return IFS6bits.ADC2EIF;
            break;
            
        case ADC3_Early_Interrupt:
            return IFS6bits.ADC3EIF;
            break;
            
        case ADC4_Early_Interrupt:
            return IFS6bits.ADC4EIF;
            break;
            
        case ADC7_Early_Interrupt:
            return IFS6bits.ADC7EIF;
            break;
            
        case ADC0_Warm_Interrupt:
            return IFS6bits.ADC0WIF;
            break;
            
        case ADC1_Warm_Interrupt:
            return IFS6bits.ADC1WIF;
            break;
            
        case ADC2_Warm_Interrupt:
            return IFS6bits.ADC2WIF;
            break;
            
        case ADC3_Warm_Interrupt:
            return IFS6bits.ADC3WIF;
            break;
            
        case ADC4_Warm_Interrupt:
            return IFS6bits.ADC4WIF;
            break;
            
        case ADC7_Warm_Interrupt:
            return IFS6bits.ADC7WIF;
            break;
            
        default:
            return 0;
            break;
            
    }
    
}

// This function sets the priority for a given interrupt
void setInterruptPriority(interrupt_source_t input_interrupt, uint8_t input_priority) {
    
    // verify input priority is between 0 and 7
    if (input_priority > 7) {
        
        input_priority = 7;
    
    }
    
    // Decide which interrupt control bits to manipulate based on which interrupt
    // is having its priority set
    switch (input_interrupt) {
        
        case Core_Timer_Interrupt:
            IPC0bits.CTIP = input_priority;
            break;
            
        case Core_Software_Interrupt_0:
            IPC0bits.CS0IP = input_priority;
            break;
            
        case Core_Software_Interrupt_1:
            IPC0bits.CS1IP = input_priority;
            break;
            
        case External_Interrupt_0:
            IPC0bits.INT0IP = input_priority;
            break;
            
        case Timer1:
            IPC1bits.T1IP = input_priority;
            break;
            
        case Input_Capture_1_Error:
            IPC1bits.IC1EIP = input_priority;
            break;
            
        case Input_Capture_1:
            IPC1bits.IC1IP = input_priority;
            break;
            
        case Output_Compare_1:
            IPC1bits.OC1IP = input_priority;
            break;
            
        case External_Interrupt_1:
            IPC2bits.INT1IP = input_priority;
            break;
            
        case Timer2:
            IPC2bits.T2IP = input_priority;
            break;
            
        case Input_Capture_2_Error:
            IPC2bits.IC2EIP = input_priority;
            break;
            
        case Input_Capture_2:
            IPC2bits.IC2IP = input_priority;
            break;
            
        case Output_Compare_2:
            IPC3bits.OC2IP = input_priority;
            break;
            
        case External_Interrupt_2:
            IPC3bits.INT2IP = input_priority;
            break;
            
        case Timer3:
            IPC3bits.T3IP = input_priority;
            break;
            
        case Input_Capture_3_Error:
            IPC3bits.IC3EIP = input_priority;
            break;
            
        case Input_Capture_3:
            IPC4bits.IC3IP = input_priority;
            break;
            
        case Output_Compare_3:
            IPC4bits.OC3IP = input_priority;
            break;
            
        case External_Interrupt_3:
            IPC4bits.INT3IP = input_priority;
            break;
            
        case Timer4:
            IPC4bits.T4IP = input_priority;
            break;
            
        case Input_Capture_4_Error:
            IPC5bits.IC4EIP = input_priority;
            break;
            
        case Input_Capture_4:
            IPC5bits.IC4IP = input_priority;
            break;
            
        case Output_Compare_4:
            IPC5bits.OC4IP = input_priority;
            break;
            
        case External_Interrupt_4:
            IPC5bits.INT4IP = input_priority;
            break;
            
        case Timer5:
            IPC6bits.T5IP = input_priority;
            break;
            
        case Input_Capture_5_Error:
            IPC6bits.IC5EIP = input_priority;
            break;
            
        case Input_Capture_5:
            IPC6bits.IC5IP = input_priority;
            break;
            
        case Output_Compare_5:
            IPC6bits.OC5IP = input_priority;
            break;
            
        case Timer6:
            IPC7bits.T6IP = input_priority;
            break;
            
        case Input_Capture_6_Error:
            IPC7bits.IC6EIP = input_priority;
            break;
            
        case Input_Capture_6:
            IPC7bits.IC6IP = input_priority;
            break;
            
        case Output_Compare_6:
            IPC7bits.OC6IP = input_priority;
            break;
            
        case Timer7:
            IPC8bits.T7IP = input_priority;
            break;
            
        case Input_Capture_7_Error:
            IPC8bits.IC7EIP = input_priority;
            break;
            
        case Input_Capture_7:
            IPC8bits.IC7IP = input_priority;
            break;
            
        case Output_Compare_7:
            IPC8bits.OC7IP = input_priority;
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
            IPC25bits.ADCD42IP = input_priority;
            break;
            
        case ADC_Data_43:
            IPC25bits.ADCD43IP = input_priority;
            break;
            
        case ADC_Data_44:
            IPC25bits.ADCD44IP = input_priority;
            break;
            
        case Core_Performance_Counter_Interrupt:
            IPC26bits.CPCIP = input_priority;
            break;
            
        case Core_Fast_Debug_Channel_Interrupt:
            IPC26bits.CFDCIP = input_priority;
            break;
            
        case System_Bus_Protection_Violation:
            IPC26bits.SBIP = input_priority;
            break;
            
        case SPI1_Fault:
            IPC27bits.SPI1EIP = input_priority;
            break;
            
        case SPI1_Receive_Done:
            IPC27bits.SPI1RXIP = input_priority;
            break;
            
        case SPI1_Transfer_Done:
            IPC27bits.SPI1TXIP = input_priority;
            break;
            
        case UART1_Fault:
            IPC28bits.U1EIP = input_priority;
            break;
            
        case UART1_Receive_Done:
            IPC28bits.U1RXIP = input_priority;
            break;
            
        case UART1_Transfer_Done:
            IPC28bits.U1TXIP = input_priority;
            break;
            
        case I2C1_Bus_Collision_Event:
            IPC28bits.I2C1BIP = input_priority;
            break;
            
        case I2C1_Slave_Event:
            IPC29bits.I2C1SIP = input_priority;
            break;
            
        case I2C1_Master_Event:
            IPC29bits.I2C1MIP = input_priority;
            break;
            
        case PORTA_Input_Change_Interrupt:
            IPC29bits.CNAIP = input_priority;
            break;
            
        case PORTB_Input_Change_Interrupt:
            IPC29bits.CNBIP = input_priority;
            break;
            
        case PORTC_Input_Change_Interrupt:
            IPC30bits.CNCIP = input_priority;
            break;
            
        case PORTD_Input_Change_Interrupt:
            IPC30bits.CNDIP = input_priority;
            break;
            
        case PORTE_Input_Change_Interrupt:
            IPC30bits.CNEIP = input_priority;
            break;
            
        case PORTF_Input_Change_Interrupt:
            IPC30bits.CNFIP = input_priority;
            break;
            
        case PORTG_Input_Change_Interrupt:
            IPC31bits.CNGIP = input_priority;
            break;
            
        case PORTH_Input_Change_Interrupt:
            IPC31bits.CNHIP = input_priority;
            break;
            
        case PORTJ_Input_Change_Interrupt:
            IPC31bits.CNJIP = input_priority;
            break;
            
        case PORTK_Input_Change_Interrupt:
            IPC31bits.CNKIP = input_priority;
            break;
            
        case Parallel_Master_Port:
            IPC32bits.PMPIP = input_priority;
            break;
            
        case Parallel_Master_Port_Error:
            IPC32bits.PMPEIP = input_priority;
            break;
            
        case Comparator_1_Interrupt:
            IPC32bits.CMP1IP = input_priority;
            break;
            
        case Comparator_2_Interrupt:
            IPC32bits.CMP2IP = input_priority;
            break;
            
        case USB_General_Event:
            IPC33bits.USBIP = input_priority;
            break;
            
        case USB_DMA_Event:
            IPC33bits.USBDMAIP = input_priority;
            break;
            
        case DMA_Channel_0:
            IPC33bits.DMA0IP = input_priority;
            break;
            
        case DMA_Channel_1:
            IPC33bits.DMA1IP = input_priority;
            break;
            
        case DMA_Channel_2:
            IPC34bits.DMA2IP = input_priority;
            break;
            
        case DMA_Channel_3:
            IPC34bits.DMA3IP = input_priority;
            break;
            
        case DMA_Channel_4:
            IPC34bits.DMA4IP = input_priority;
            break;
            
        case DMA_Channel_5:
            IPC34bits.DMA5IP = input_priority;
            break;
            
        case DMA_Channel_6:
            IPC35bits.DMA6IP = input_priority;
            break;
            
        case DMA_Channel_7:
            IPC35bits.DMA7IP = input_priority;
            break;
            
        case SPI2_Fault:
            IPC35bits.SPI2EIP = input_priority;
            break;
            
        case SPI2_Receive_Done:
            IPC35bits.SPI2RXIP = input_priority;
            break;
            
        case SPI2_Transfer_Done:
            IPC36bits.SPI2TXIP = input_priority;
            break;
            
        case UART2_Fault:
            IPC36bits.U2EIP = input_priority;
            break;
            
        case UART2_Receive_Done:
            IPC36bits.U2RXIP = input_priority;
            break;
            
        case UART2_Transfer_Done:
            IPC36bits.U2TXIP = input_priority;
            break;
            
        case I2C2_Bus_Collision_Event:
            IPC37bits.I2C2BIP = input_priority;
            break;
            
        case I2C2_Slave_Event:
            IPC37bits.I2C2SIP = input_priority;
            break;
            
        case I2C2_Master_Event:
            IPC37bits.I2C2MIP = input_priority;
            break;
            
        case Control_Area_Network_1:
            IPC37bits.CAN1IP = input_priority;
            break;
                    
        case Control_Area_Network_2:
            IPC38bits.CAN2IP = input_priority;
            break;
            
        case Ethernet_Interrupt:
            IPC38bits.ETHIP = input_priority;
            break;
            
        case SPI3_Fault:
            IPC38bits.SPI3EIP = input_priority;
            break;
            
        case SPI3_Receive_Done:
            IPC38bits.SPI3RXIP = input_priority;
            break;
            
        case SPI3_Transfer_Done:
            IPC39bits.SPI3TXIP = input_priority;
            break;
            
        case UART3_Fault:
            IPC39bits.U3EIP = input_priority;
            break;
            
        case UART3_Receive_Done:
            IPC39bits.U3RXIP = input_priority;
            break;
            
        case UART3_Transfer_Done:
            IPC39bits.U3TXIP = input_priority;
            break;
            
        case I2C3_Bus_Collision_Event:
            IPC40bits.I2C3BIP = input_priority;
            break;
            
        case I2C3_Slave_Event:
            IPC40bits.I2C3SIP = input_priority;
            break;
            
        case I2C3_Master_Event:
            IPC40bits.I2C3MIP = input_priority;
            break;
            
        case SPI4_Fault:
            IPC40bits.SPI4EIP = input_priority;
            break;
            
        case SPI4_Receive_Done:
            IPC41bits.SPI4RXIP = input_priority;
            break;
            
        case SPI4_Transfer_Done:
            IPC41bits.SPI4TXIP = input_priority;
            break;
            
        case Real_Time_Clock:
            IPC41bits.RTCCIP = input_priority;
            break;
            
        case Flash_Control_Event:
            IPC41bits.FCEIP = input_priority;
            break;
            
        case Prefetch_Module_SEC_Event:
            IPC42bits.PREIP = input_priority;
            break;
            
        case SQI1_Event:
            IPC42bits.SQI1IP = input_priority;
            break;
            
        case UART4_Fault:
            IPC42bits.U4EIP = input_priority;
            break;
            
        case UART4_Receive_Done:
            IPC42bits.U4RXIP = input_priority;
            break;
            
        case UART4_Transfer_Done:
            IPC43bits.U4TXIP = input_priority;
            break;
            
        case I2C4_Bus_Collision_Event:
            IPC43bits.I2C4BIP = input_priority;
            break;
            
        case I2C4_Slave_Event:
            IPC43bits.I2C4SIP = input_priority;
            break;
            
        case I2C4_Master_Event:
            IPC43bits.I2C4MIP = input_priority;
            break;
            
        case SPI5_Fault:
            IPC44bits.SPI5EIP = input_priority;
            break;
            
        case SPI5_Receive_Done:
            IPC44bits.SPI5RXIP = input_priority;
            break;
            
        case SPI5_Transfer_Done:
            IPC44bits.SPI5TXIP = input_priority;
            break;
            
        case UART5_Fault:
            IPC44bits.U5EIP = input_priority;
            break;
            
        case UART5_Receive_Done:
            IPC45bits.U5RXIP = input_priority;
            break;
            
        case UART5_Transfer_Done:
            IPC45bits.U5TXIP = input_priority;
            break;
            
        case I2C5_Bus_Collision_Event:
            IPC45bits.I2C5BIP = input_priority;
            break;
            
        case I2C5_Slave_Event:
            IPC45bits.I2C5SIP = input_priority;
            break;
            
        case I2C5_Master_Event:
            IPC46bits.I2C5MIP = input_priority;
            break;
        
        case SPI6_Fault:
            IPC46bits.SPI6EIP = input_priority;
            break;
            
        case SPI6_Receive_Done:
            IPC46bits.SPI6RXIP = input_priority;
            break;
            
        case SPI6_Transfer_Done:
            IPC46bits.SPI6TXIP = input_priority;
            break;
            
        case UART6_Fault:
            IPC47bits.U6EIP = input_priority;
            break;
            
        case UART6_Receive_Done:
            IPC47bits.U6RXIP = input_priority;
            break;
            
        case UART6_Transfer_Done:
            IPC47bits.U6TXIP = input_priority;
            break;
        
        case ADC_End_Of_Scan_Ready:
            IPC48bits.ADCEOSIP = input_priority;
            break;
            
        case ADC_Analog_Circuits_Ready:
            IPC48bits.ADCARDYIP = input_priority;
            break;
            
        case ADC_Update_Ready:
            IPC48bits.ADCURDYIP = input_priority;
            break;
            
        case ADC_Group_Early_Interrupt_Request:
            IPC49bits.ADCGRPIP = input_priority;
            break;
            
        case ADC0_Early_Interrupt:
            IPC49bits.ADC0EIP = input_priority;
            break;
            
        case ADC1_Early_Interrupt:
            IPC49bits.ADC1EIP = input_priority;
            break;
            
        case ADC2_Early_Interrupt:
            IPC50bits.ADC2EIP = input_priority;
            break;
            
        case ADC3_Early_Interrupt:
            IPC50bits.ADC3EIP = input_priority;
            break;
            
        case ADC4_Early_Interrupt:
            IPC50bits.ADC4EIP = input_priority;
            break;
            
        case ADC7_Early_Interrupt:
            IPC51bits.ADC7EIP = input_priority;
            break;
            
        case ADC0_Warm_Interrupt:
            IPC51bits.ADC0WIP = input_priority;
            break;
            
        case ADC1_Warm_Interrupt:
            IPC51bits.ADC1WIP = input_priority;
            break;
            
        case ADC2_Warm_Interrupt:
            IPC52bits.ADC2WIP = input_priority;
            break;
            
        case ADC3_Warm_Interrupt:
            IPC52bits.ADC3WIP = input_priority;
            break;
            
        case ADC4_Warm_Interrupt:
            IPC52bits.ADC4WIP = input_priority;
            break;
            
        case ADC7_Warm_Interrupt:
            IPC53bits.ADC7WIP = input_priority;
            break;
            
        default:
            break;
            
    }
    
}
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
