drewsum/Electronic_Display/sfw/embedded_firmware/U601_firmware/LED_Display_Controller.X/prefetch.c

#include <xc.h>
#include <stdio.h>

#include "prefetch.h"
#include "32mz_interrupt_control.h"
#include "error_handler.h"
#include "terminal_control.h"

// This function initializes the prefetch module
void prefetchInitialize(void) {

    // configure prefetch module SEC interrupt
    disableInterrupt(Prefetch_Module_SEC_Event);
    setInterruptPriority(Prefetch_Module_SEC_Event, 4);
    setInterruptSubpriority(Prefetch_Module_SEC_Event, 2);
    clearInterruptFlag(Prefetch_Module_SEC_Event);
    
    // Enable prefetch SEC interrupt
    PRECONbits.PFMSECEN = 1;
    
    // Set prefetch module access time to four wait states
    PRECONbits.PFMWS = 0b100;
    
    // Enable predictive prefetch for any memory address
    PRECONbits.PREFEN = 0b11;
    
    // Enable prefetch SEC interrupt
    enableInterrupt(Prefetch_Module_SEC_Event);
    
}

// This is the prefetch SEC event interrupt service routine
void __ISR(_PREFETCH_VECTOR, ipl4SRS) prefetchSECEventISR(void) {

    // Reset SEC event counter
    PRESTATbits.PFMSECCNT = PRECONbits.PFMSECEN;
    
    // Set error handler flag high
    error_handler.prefetch_module_SEC_flag = 1;
    
    // Clear interrupt flag
    clearInterruptFlag(Prefetch_Module_SEC_Event);
    
}

// This function prints the status of the prefetch module
void printPrefetchStatus(void) {
 
    
    terminalTextAttributesReset();
    terminalTextAttributes(GREEN, BLACK, UNDERSCORE);
    printf("Prefetch Module Status:\n\r");
    
    terminalTextAttributes(GREEN, BLACK, NORMAL);
    printf("    Prefetch Module enable Status: ");
    
    switch (PRECONbits.PREFEN) {
     
        case 0b00:
            terminalTextAttributes(RED, BLACK, NORMAL);
            printf("Predictive prefetch disabled\n\r");
            break;
            
        case 0b01:
            terminalTextAttributes(GREEN, BLACK, NORMAL);
            printf("Enable predictive prefetch for CPU instructions only\n\r");
            break;
            
        case 0b10:
            terminalTextAttributes(GREEN, BLACK, NORMAL);
            printf("Enable predictive prefetch for CPU instructions and CPU data\n\r");
            break;
            
        case 0b11:
            terminalTextAttributes(GREEN, BLACK, NORMAL);
            printf("Enable predictive prefetch for any address\n\r");
            break;
            
    }
    
    // Print if interrupt is enabled
    if (PRECONbits.PFMSECEN) terminalTextAttributes(GREEN, BLACK, NORMAL);
    else terminalTextAttributes(RED, BLACK, NORMAL);
    printf("    Prefetch SEC Interrupt %s\n\r",
            PRECONbits.PFMSECEN ? "Enabled" : "Disabled");
    
    
    terminalTextAttributes(GREEN, BLACK, NORMAL);
    printf("    PFM access times set to %d wait states\n\r", PRECONbits.PFMWS);
    
    // Print if interrupt is enabled
    if (PRECONbits.PFMSECEN) terminalTextAttributes(GREEN, BLACK, NORMAL);
    else terminalTextAttributes(RED, BLACK, NORMAL);
    printf("    Prefetch SEC Interrupt %s\n\r",
            PRECONbits.PFMSECEN ? "Enabled" : "Disabled");
    
    // Print if DED error occured
    if (PRESTATbits.PFMDED) terminalTextAttributes(RED, BLACK, NORMAL);
    else terminalTextAttributes(GREEN, BLACK, NORMAL);
    printf("    Prefetch Double-bit Error %s\n\r",
            PRESTATbits.PFMDED ? "Detected" : "Not Detected");
    
    // Print if SEC error occured
    if (PRESTATbits.PFMSEC) terminalTextAttributes(RED, BLACK, NORMAL);
    else terminalTextAttributes(GREEN, BLACK, NORMAL);
    printf("    Prefetch Single-bit Error %s\n\r",
            PRESTATbits.PFMSEC ? "Corrected" : "Not Detected");
    
    terminalTextAttributesReset();
    
}
