drewsum/Electronic_Display/(commit log)

2018-09-26 Initial commit of bare KiCad files
    [LED_Display_Controller.kicad_pcb, LED_Display_Controller.sch, Microcontroller.sch, Microcontroller_Programming.sch, POS3P3_Power_Supply.sch, POS5_LED_Power_Supply.sch, Panel_Data_Connectors.sch, Panel_Data_Level_Shifters.sch]
2018-09-26 Added PIC32MZ to local library
    [LED_Display_Controller.sch, Microcontroller.sch, Microcontroller_Programming.sch, POS3P3_Power_Supply.sch, POS5_LED_Power_Supply.sch, Panel_Data_Connectors.sch, Panel_Data_Level_Shifters.sch, Panel_Power_Connectors.sch]
2018-09-26 Added basic micro connections
    [Microcontroller.sch, Microcontroller_Programming.sch]
2018-09-26 Moved AVSS pin on PIC32MZ
    [LED_Display_Controller.sch, Microcontroller.sch, Microcontroller_Programming.sch, POS3P3_Power_Supply.sch, POS5_LED_Power_Supply.sch, Panel_Data_Connectors.sch, Panel_Data_Level_Shifters.sch, Panel_Power_Connectors.sch]
2018-09-27 Added pages for external memory, and added base parts for a few pages
    [External_Flash.sch, External_RAM.sch, LED_Display_Controller.sch, Microcontroller.sch, Microcontroller_Programming.sch, POS3P3_Power_Supply.sch, Panel_Data_Connectors.sch, Panel_Data_Level_Shifters.sch]
2018-09-27 Changed panel data level shifter
    [Panel_Data_Level_Shifters.sch]
2018-09-27 Added .gitignore to KiCad project
2018-09-27 Changed output data buffer for thrid time
    [Panel_Data_Level_Shifters.sch]
2018-09-29 Added working static timer driver example for blinking an LED with PIC32MZ
2018-09-29 removed wrong PIC32MZ example
    [Microcontroller_Programming.sch, Power_Input.sch]
2018-09-29 Added working PIC32MZ static timer driver example, will not build in my repo though
2018-09-29 Added 144 pin micro to part library, added various blank pages to schematic
    [External_Flash.sch, External_Flash_1.sch, External_Flash_2.sch, External_Flash_3.sch, External_Flash_4.sch, External_Flash_5.sch, External_RAM.sch, External_SRAM.sch]
2018-09-29 Edited a few pages, added micro decoupling caps
    [External_Flash_1.sch, External_Flash_2.sch, External_Flash_3.sch, External_Flash_4.sch, External_Flash_5.sch, External_SRAM.sch, LED_Display_Controller.sch, Microcontroller_A.sch]
2018-10-01 Updated PDF to include 144 pin micro
2018-10-03 added panel data conns
    [External_Flash.sch, External_RAM.sch, LED_Display_Controller.sch, Microcontroller.sch, Microcontroller_Programming.sch, POS3P3_Power_Supply.sch, POS5_LED_Power_Supply.sch, Panel_Data_Connectors.sch]
2018-10-03 Added SRAM and Flash circuits
    [External_Flash_1.sch, External_SRAM.sch, Microcontroller_A.sch, Microcontroller_B.sch, Panel_Data_Level_Shifters.sch, USB_UART_Isolation.sch]
2018-10-03 Added panel data level shifters pages
    [External_Flash.sch, External_RAM.sch, LED_Display_Controller.sch, Microcontroller.sch, Microcontroller_Programming.sch, POS3P3_Power_Supply.sch, POS5_LED_Power_Supply.sch, Panel_Data_Connectors.sch]
2018-10-05 Added panel power connectors (and updated pdf)
    [Panel_Power_Connectors.sch]
2018-10-05 Added a few missing pages
    [External_Flash_1.sch, External_Flash_2.sch, External_Flash_3.sch, External_Flash_6.sch, External_Flash_7.sch, External_Flash_8.sch, External_SRAM.sch, LED_Display_Controller.sch]
2018-10-05 fixed panel power connectors and added level shifters for A, B, C, D, E, CLK, LAT, OE
    [External_Flash.sch, External_RAM.sch, LED_Display_Controller.sch, Microcontroller.sch, Microcontroller_Programming.sch, POS3P3_Power_Supply.sch, POS5_LED_Power_Supply.sch, Panel_Data_Connectors.sch]
2018-10-05 Wired Micro to external SRAM, copied Flash 8 times
    [External_Flash_1.sch, External_Flash_2.sch, External_Flash_3.sch, External_Flash_4.sch, External_Flash_5.sch, External_Flash_6.sch, External_Flash_7.sch, External_Flash_8.sch]
2018-10-09 Staging for pull request
    [External_Flash_1.sch, External_Flash_2.sch, External_Flash_3.sch, External_Flash_4.sch, External_Flash_5.sch, External_Flash_6.sch, External_Flash_7.sch, External_Flash_8.sch]
2018-10-09 More master pull staging
    [Microcontroller.sch, POS5_LED_Power_Supply.sch]
2018-10-09 Staging branch for pull into master
    [Panel_Data_Level_Shifters_1.sch, Panel_Data_Level_Shifters_2.sch, Panel_Data_Level_Shifters_3.sch]
2018-10-09 More pull request staging, deleted void files
    [External_Flash.sch, External_RAM.sch, LED_Display_Controller.kicad_pcb, LED_Display_Controller.sch, Microcontroller.sch, Microcontroller_Programming.sch, POS3P3_Power_Supply.sch, POS5_LED_Power_Supply.sch]
2018-10-10 Still attempting to fix merge conflicts
    [External_Flash_1.sch, External_Flash_2.sch, External_Flash_3.sch, External_Flash_4.sch, External_Flash_5.sch, External_Flash_6.sch, External_Flash_7.sch, External_Flash_8.sch]
2018-10-10 Added to-do list, cleaned some pages, ~MCLR filter
    [External_Flash_1.sch, External_Flash_2.sch, External_Flash_3.sch, External_Flash_4.sch, External_Flash_5.sch, External_Flash_6.sch, External_Flash_7.sch, External_Flash_8.sch]
2018-10-10 Generated PDF
    [LED_Display_Controller.sch]
2018-10-10 Added note to to do list
    [LED_Display_Controller.sch, Microcontroller_Power.sch, Panel_Data_Level_Shifters_1.sch, Panel_Data_Level_Shifters_2.sch, Panel_Power_Connectors.sch, Status_LEDs_1.sch, Wi_Fi_Module.sch]
2018-10-11 Changed a few notes
    [LED_Display_Controller.sch]
2018-10-11 Added test points sheet
    [External_Flash_1.sch, External_Flash_2.sch, External_Flash_3.sch, External_Flash_4.sch, External_Flash_5.sch, External_Flash_6.sch, External_Flash_7.sch, External_Flash_8.sch]
2018-10-11 Added empty LTPowerCAD files for power supplies
2018-10-12 Switched to 256kx8b SRAM for external cache
    [External_SRAM.sch]
2018-10-12 Connected new external SRAM to micro
    [External_SRAM.sch, Microcontroller_A.sch, Microcontroller_B.sch]
2018-10-12 Removed unneeded EBI nets
    [Microcontroller_B.sch]
2018-10-12 Added empty pages for POS5 Power supply
    [External_Flash_1.sch, External_Flash_2.sch, External_Flash_3.sch, External_Flash_4.sch, External_Flash_5.sch, External_Flash_6.sch, External_Flash_7.sch, External_Flash_8.sch]
2018-10-18 Overriding master branch for clean pull request
    [LED_Display_Controller.sch, POS5P5_MNG.sch, POS5_Control.sch, POS5_Phase_1.sch, POS5_Phase_2.sch, POS5_Phase_3.sch, POS5_Phase_4.sch, Panel_Power_Connectors.sch]
2018-10-22 Added +3.3V Power Supply
    [External_Flash_1.sch, External_Flash_2.sch, External_Flash_3.sch, External_Flash_4.sch, External_Flash_5.sch, External_Flash_6.sch, External_Flash_7.sch, External_Flash_8.sch]
2018-10-22 Added unductor loss calculation for +3.3V PS
2018-10-23 Merged POS5 supply back into project
    [External_Flash_1.sch, External_Flash_2.sch, External_Flash_3.sch, External_Flash_4.sch, External_Flash_5.sch, External_Flash_6.sch, External_Flash_7.sch, External_Flash_8.sch]
2018-10-23 Removed 15 of the 20 original outptu power connectors, added a few test points
    [External_Flash_1.sch, External_Flash_2.sch, External_Flash_3.sch, External_Flash_4.sch, External_Flash_5.sch, External_Flash_6.sch, External_Flash_7.sch, External_Flash_8.sch]
2018-10-23 Copied panel control signals to micro page A
    [Microcontroller_A.sch, POS5P5_MNG.sch, POS5_Control.sch, POS5_Phase_2.sch, POS5_Phase_3.sch, POS5_Phase_4.sch]
2018-10-24 started using fragments
    [app_bar_menu.xml]
2018-11-02 Added WIFI module, some more editing
    [External_Flash_1.sch, External_Flash_2.sch, External_Flash_3.sch, External_Flash_4.sch, External_Flash_5.sch, External_Flash_6.sch, External_Flash_7.sch, External_Flash_8.sch]
2018-11-03 Converted to KiCad 5.0.1 project, resolved library issues, cleaned up a few sheets
    [External_Flash_1.sch, External_Flash_2.sch, External_Flash_3.sch, External_Flash_4.sch, External_Flash_5.sch, External_Flash_6.sch, External_Flash_7.sch, External_Flash_8.sch]
2018-11-05 Copied LTC7851 demo board into repo
    [Active_Load_1.sch, Active_Load_2.sch, Active_Load_3.sch, LTC7851_Demo.kicad_pcb, LTC7851_Demo.sch, LTC7851_Demo_bom_.csv, LTC7851_Demo_bom_.xlsx, Loop_Response.sch]
2018-11-05 Removed extra power pages from host board folder:
    [POS5P5_MNG.sch, POS5_Control.sch, POS5_Phase_1.sch, POS5_Phase_2.sch, POS5_Phase_3.sch, POS5_Phase_4.sch]
2018-11-05 Added a few pages for more features
    [External_Flash_1.sch, External_Flash_2.sch, External_Flash_3.sch, External_Flash_4.sch, External_Flash_5.sch, External_Flash_6.sch, External_Flash_7.sch, External_Flash_8.sch]
2018-11-07 Added encoder stuff
    [LED_Display_Controller.sch, Pushbuttons.sch]
2018-11-08 Merged USB UART functionality into four by four panel test project
2018-11-08 Added blinking heartbeat LED functionality
2018-11-09 Added interrupt driven code structure
2018-11-12 revised part numbers in BOM
    [LED_Display_Controller.sch, LTC7851_Demo_bom_.csv, LTC7851_Demo_bom_.xlsx, POS5_Power_Supply.sch, Pushbuttons.sch]
2018-11-12 Added power board monitoring circuits
    [LED_Display_Controller.sch, LED_POS5_Monitoring.sch, Microcontroller_Programming.sch, Power_Input.sch, Pushbuttons.sch, USB_UART_Isolation.sch]
2018-11-14 Added a to do list entry
    [LED_Display_Controller.sch]
2018-11-16 connected signals to MCU pins
    [External_Flash_1.sch, External_Flash_2.sch, External_Flash_3.sch, External_Flash_4.sch, External_Flash_5.sch, External_Flash_6.sch, External_Flash_7.sch, External_Flash_8.sch]
2018-11-16 I said never do this, it's bad for you
    [Active_Load_1.sch, Active_Load_2.sch, Active_Load_3.sch, External_Flash_1.sch, External_Flash_2.sch, External_Flash_3.sch, External_Flash_4.sch, External_Flash_5.sch]
2018-11-26 rage commit
    [External_Flash_1.sch, External_Flash_2.sch, External_Flash_3.sch, External_Flash_4.sch, External_Flash_5.sch, External_Flash_6.sch, External_Flash_7.sch, External_Flash_8.sch]
2018-11-27 Merging drews_branch_3 into master
    [Active_Load_1.sch, Active_Load_2.sch, Active_Load_3.sch, External_Flash_1.sch, External_Flash_2.sch, External_Flash_3.sch, External_Flash_4.sch, External_Flash_5.sch]
2018-11-28 Added a few notes to power board schematic
    [Active_Load_1.sch, Active_Load_2.sch, Active_Load_3.sch, LTC7851_Demo.sch, Loop_Response.sch, Mechanical.sch, POS5P5_MNG.sch, POS5_Control.sch]
2018-11-28 Schematic cleanup
    [Active_Load_1.sch, Active_Load_2.sch, Active_Load_3.sch, External_Flash_1.sch, External_Flash_2.sch, External_Flash_3.sch, External_Flash_4.sch, External_Flash_5.sch]
2018-11-28 Edited sheet block company field
    [Active_Load_1.sch, Active_Load_2.sch, Active_Load_3.sch, External_Flash_1.sch, External_Flash_2.sch, External_Flash_3.sch, External_Flash_4.sch, External_Flash_5.sch]
2018-12-01 Added code to support a 2 x 2 LED panel display
2018-12-01 added features such as set rgb stripes, christmas stripes, red rows(doesn't work)
    [test_buffer_fills.c, test_buffer_fills.h]
2018-12-02 fixing screen switching code and image contrast
2018-12-02 Added to do list iem
    [LED_Display_Controller.sch, Power_Input.sch, USB_UART_Bridge.sch, Wi_Fi_Module.sch]
2018-12-03 Added to do list items
    [LED_Display_Controller.sch]
2018-12-03 Changed a few pull resistors
    [LED_Display_Controller.sch, Microcontroller_1.sch, Panel_Data_Level_Shifters_3.sch]
2018-12-03 Finished SRAM custom footprint
    [External_SRAM.sch, LED_Display_Controller.sch, Microcontroller_Programming.sch, Wi_Fi_Module.sch]
2018-12-04 Added to do list item
    [LED_Display_Controller.sch]
2018-12-04 Added other error LED
    [LED_Display_Controller.sch, Microcontroller_2.sch, Status_LEDs_1.sch]
2018-12-04 added ESP8266 custom footprint
    [LED_Display_Controller.sch, Pushbuttons.sch, Wi_Fi_Module.sch]
2018-12-06 Added some digikey partnumbers to components
    [External_Flash_1.sch, External_Flash_2.sch, External_Flash_3.sch, External_Flash_4.sch, External_Flash_5.sch, External_Flash_6.sch, External_Flash_7.sch, External_Flash_8.sch]
2018-12-06 Finished first pass of digikey part numbers
    [External_Flash_1.sch, External_Flash_2.sch, External_Flash_3.sch, External_Flash_4.sch, External_Flash_5.sch, External_Flash_6.sch, External_Flash_7.sch, External_Flash_8.sch]
2018-12-06 First pass assignment of footprints to all components
    [External_Flash_1.sch, External_Flash_2.sch, External_Flash_3.sch, External_Flash_4.sch, External_Flash_5.sch, External_Flash_6.sch, External_Flash_7.sch, External_Flash_8.sch]
2018-12-06 Resolved a few library dependencies
    [External_Flash_1.sch, External_Flash_2.sch, External_Flash_3.sch, External_Flash_4.sch, External_Flash_5.sch, External_Flash_6.sch, External_Flash_7.sch, External_Flash_8.sch]
2018-12-06 Added first pass BOM
    [LED_Display_Controller.sch, LED_Display_Controller_bom_A.csv, LED_Display_Controller_bom_A.xlsx]
2018-12-06 Modified BOM
    [LED_Display_Controller_bom_A.csv, LED_Display_Controller_bom_A.xlsx, LED_POS5_Monitoring.sch, Microcontroller_Power.sch, POS3P3_Power_Supply.sch, USB_UART_Bridge.sch, Wi_Fi_Module.sch]
2018-12-07 Redesigned POS3P3 supply with new controller for 5 amps
    [LED_Display_Controller.kicad_pcb, LED_Display_Controller_bom_A.csv, LED_Display_Controller_bom_A.xlsx, POS3P3_Power_Supply.sch]
2018-12-07 Schematic bug fixes
    [LED_Display_Controller.kicad_pcb, LED_Display_Controller.sch, LED_Display_Controller_bom_A.csv, LED_Display_Controller_bom_A.xlsx, Wi_Fi_Module.sch]
2018-12-09 Placed decoupling caps around micro
    [LED_Display_Controller.kicad_pcb, Microcontroller_2.sch, POS3P3_Power_Supply.sch, Pushbuttons.sch, Status_LEDs_1.sch, USB_UART_Isolation.sch]
2018-12-09 Placed SRAM
    [LED_Display_Controller.kicad_pcb]
2018-12-09 Placed parts for level shifters
    [LED_Display_Controller.kicad_pcb]
2018-12-09 arranged rotary encoder parts
    [LED_Display_Controller.kicad_pcb, LED_POS5_Monitoring.sch]
2018-12-11 Arranged power supply parts
    [LED_Display_Controller.kicad_pcb]
2018-12-12 Added PCB to do list
    [LED_Display_Controller.kicad_pcb]
2018-12-12 Arranged USB, routed EBI
    [LED_Display_Controller.kicad_pcb]
2018-12-13 Placed ADC filter parts
    [LED_Display_Controller.kicad_pcb]
2018-12-13 Resolved pinout issue with TVS diodes
    [LED_Display_Controller.kicad_pcb, LED_POS5_Monitoring.sch, Pushbuttons.sch, Wi_Fi_Module.sch]
2018-12-13 Cleaned up EBI a bit
    [LED_Display_Controller.kicad_pcb, Wi_Fi_Module.sch]
2018-12-13 Placed parts for WIFI module
    [LED_Display_Controller.kicad_pcb]
2018-12-13 Fixed FLASH reference designators
    [LED_Display_Controller.kicad_pcb]
2018-12-14 Fixed reference designators for level shifting/flash copies
    [LED_Display_Controller.kicad_pcb]
2018-12-14 Added board outline and placed mounting holes/IDC connectors
    [LED_Display_Controller.kicad_pcb, Mechanical.sch]
2018-12-14 Added custom IDC connector footprint
    [LED_Display_Controller.kicad_pcb]
2018-12-14 Corrected output data TVS diodes
    [LED_Display_Controller.kicad_pcb, Panel_Data_Connectors.sch]
2018-12-14 Fixed ESD protection on data connectors again
    [LED_Display_Controller.kicad_pcb, Panel_Data_Connectors.sch]
2018-12-15 Fixed net placement on level shifters, lots of part placements on PCB
    [LED_Display_Controller.kicad_pcb, LED_POS5_Monitoring.sch, Panel_Data_Connectors.sch, Panel_Data_Level_Shifters_1.sch, Panel_Data_Level_Shifters_2.sch, Panel_Data_Level_Shifters_3.sch, Test_Points.sch]
2018-12-15 First pass of placing parts
    [LED_Display_Controller.kicad_pcb, Pushbuttons.sch]
2018-12-15 Placed more parts, added some labels
    [LED_Display_Controller.kicad_pcb, Panel_Data_Level_Shifters_3.sch, Test_Points.sch, Wi_Fi_Module.sch]
2018-12-15 Arranged status LEDs
    [LED_Display_Controller.kicad_pcb]
2018-12-16 Added flash chip select LEDs
    [External_Flash_1.sch, External_Flash_2.sch, External_Flash_3.sch, External_Flash_4.sch, External_Flash_5.sch, External_Flash_6.sch, External_Flash_7.sch, External_Flash_8.sch]
2018-12-16 Added WIFI comm LED
    [External_Flash_1.sch, External_Flash_2.sch, External_Flash_3.sch, External_Flash_4.sch, External_Flash_5.sch, External_Flash_6.sch, External_Flash_7.sch, External_Flash_8.sch]
2018-12-16 Added additional capacitance sheet
    [Additional_Capacitance.sch, External_Flash_1.sch, External_Flash_2.sch, External_Flash_3.sch, External_Flash_4.sch, External_Flash_5.sch, External_Flash_6.sch, External_Flash_7.sch]
2018-12-16 Placed some new parts
    [LED_Display_Controller.kicad_pcb, Wi_Fi_Module.sch]
2018-12-16 Added layer count
    [LED_Display_Controller.kicad_pcb]
2018-12-16 Added a lot more status LEDs
    [Status_LEDs_1.sch]
2018-12-16 Placed more new parts
    [LED_Display_Controller.kicad_pcb, Status_LEDs_1.sch]
2018-12-16 Added some graphic items to PCB
    [LED_Display_Controller.kicad_pcb]
2018-12-18 Resolved panel data connector orientation issues
    [LED_Display_Controller.kicad_pcb, Panel_Data_Connectors.sch, Panel_Data_Level_Shifters_1.sch, Panel_Data_Level_Shifters_2.sch, Panel_Data_Level_Shifters_3.sch]
2018-12-19 Added bare metal test program
    [configuration.h]
2018-12-19 Routed a bunch of traces
    [LED_Display_Controller.kicad_pcb, Panel_Data_Level_Shifters_3.sch, Test_Points.sch]
2018-12-20 Routed a lot
    [LED_Display_Controller.kicad_pcb]
2018-12-20 More rowts
    [LED_Display_Controller.kicad_pcb]
2018-12-20 Moar Rouwts
    [LED_Display_Controller.kicad_pcb]
2018-12-20 Added manufacturer logos
    [LED_Display_Controller.kicad_pcb]
2018-12-20 Added menufacturer logos
    [LED_Display_Controller.kicad_pcb]
2018-12-20 outline for some objects
    [app_bar_menu.xml]
2018-12-20 new bom
    [LED_Display_Controller_bom_A.csv, LED_Display_Controller_bom_A.xlsx]
2018-12-20 Routed panel control signals
    [LED_Display_Controller.kicad_pcb, POS3P3_Power_Supply.sch]
2018-12-20 added alternate configuration/device control
2018-12-21 More routing, what else is new
    [LED_Display_Controller.kicad_pcb]
2018-12-24 Added peripheral map spreadsheet, fixed some routing issues
    [LED_Display_Controller.kicad_pcb, Microcontroller_Peripheral_Map.xlsx, Status_LEDs_1.sch]
2018-12-24 Made a few more critical routes
    [LED_Display_Controller.kicad_pcb]
2018-12-24 Routed a few more traces
    [LED_Display_Controller.kicad_pcb]
2018-12-24 More routing
    [LED_Display_Controller.kicad_pcb]
2018-12-27 Added some interrupt control APIs
2018-12-27 Added enable and disable interrupts functions
2018-12-27 Added global interrupt manipulation functions
2018-12-27 Added functions to read interrupt flags and enables
2018-12-27 Cleaned up camel case for some functions
2019-01-02 Added priority interrupt functions, hearbeat to bare metal example
2019-01-05 More routing, added POS12 PGOOD net to micro
    [LED_Display_Controller.kicad_pcb, Microcontroller_2.sch]
2019-01-05 Moved over interrupt control and heartbeat timer files to firmware project
2019-01-05 Finished writing pin macros
2019-01-05 Added error handler header file
    [error_handler.h, gpio_setup.c, main.c]
2019-01-08 Added cause of reset files, nothing filled in yet
    [cause_of_reset.c, cause_of_reset.h, main.c]
2019-01-08 Added power saving files
2019-01-08 Filled in peripheral map a little more
    [Microcontroller_Peripheral_Map.xlsx]
2019-01-08 Added deadman timer functions
2019-01-10 Added stitching caps, mor erouting
    [Additional_Capacitance.sch, LED_Display_Controller.kicad_pcb, LED_POS5_Monitoring.sch, POS3P3_Power_Supply.sch]
2019-01-11 Added trick marquette copper logos
    [LED_Display_Controller.kicad_pcb]
2019-01-11 Added bigger QR code, LTC logo
    [LED_Display_Controller.kicad_pcb]
2019-01-11 Added a few logos
    [LED_Display_Controller.kicad_pcb]
2019-01-11 Added some cool imageS
    [LED_Display_Controller.kicad_pcb]
2019-01-11 Added MU seal
    [LED_Display_Controller.kicad_pcb]
2019-01-13 Added more silkscreen art
2019-01-18 Added USB UART functions
    [Microcontroller_Peripheral_Map.xlsx]
2019-01-22 Removed extra schematic sheet
    [Panel_Power_Connectors.sch]
2019-01-28 Started programming board
2019-01-29 Resolved USB UART Interrupt Issues
    [32mz_interrupt_control.c, gpio_setup.c, heartbeat_timer.c, main.c]
2019-01-29 Added UART scope captures
2019-01-29 Got USB UART receiving working, sorta
2019-01-29 Added error handling to USB UART fault ISR
2019-01-30 Resolved merge conflicts, added a lot of functionality
    [device_control.c, device_control.h, heartbeat_timer.c, main.c, watchdog_timer.h]
2019-01-31 Wrote cause of Reset code
    [cause_of_reset.c, cause_of_reset.h, main.c, watchdog_timer.c, watchdog_timer.h]
2019-01-31 Added reset debug data to boot debug message
    [main.c]
2019-01-31 Removed RCON bit clearing in cause of reset function
    [cause_of_reset.c]
2019-01-31 Overhauled PMD Status command, will use as reference for Interrupt Status command
2019-01-31 Changed all status debug messages to printf statements
2019-01-31 Added interrupt debug commands
2019-01-31 Tried to fix POS5 run situation, did not work
    [power_saving.c]
2019-01-31 Fixed POS12 PGOOD macro definition
    [pin_macros.h]
2019-02-01 Added serial commands to print device ID information
2019-02-02 Added SBV interrupt, error handling, trying to fix more USB issues with long messages
    [32mz_interrupt_control.c, cause_of_reset.c, error_handler.c, error_handler.h, heartbeat_timer.c, heartbeat_timer.h, main.c, power_saving.c]
2019-02-02 Trying to fix usb uart software reset issue
    [32mz_interrupt_control.c, gpio_setup.c, power_saving.c]
2019-02-03 Added core timer functions and ISR
2019-02-03 Resolved USB UART ring buffer exception issue
2019-02-04 Added conditional text coloring to a few print funtions
2019-02-04 Added error handler flag reporting
    [32mz_interrupt_control.c, cause_of_reset.c, error_handler.c, error_handler.h, heartbeat_timer.c, main.c, power_saving.c]
2019-02-04 Added error handling stuff an resolved multi-vector int issue
    [32mz_interrupt_control.c, 32mz_interrupt_control.h, error_handler.c, error_handler.h, heartbeat_timer.c, heartbeat_timer.h, main.c]
2019-02-05 SPI flash firmware and added status message to usb_uart.c
2019-02-06 Switched to using read and write functions in test function
2019-02-07 Added ADC init code, not working yet
    [adc.c, adc.h, error_handler.c, error_handler.h, main.c, power_saving.c]
2019-02-07 Got basic ADC init function working
2019-02-07 Got basic ADC driver working
    [Microcontroller_Peripheral_Map.xlsx]
2019-02-08 Added ISRs for copying data for used ADC channel
2019-02-08 Added serial commands/ISRs to measure board voltages
2019-02-08 Added a bunch of ADC code
2019-02-08 Added extensive ADC status serial command
2019-02-08 Added stuff to ADC status serial command
2019-02-08 Edited interrupt status function
2019-02-08 Added minimum and maximum ADC result recording
2019-02-10 Trying to solve EBI SRAM issues
    [device_control.c, external_bus_interface.c, gpio_setup.c, main.c]
2019-02-12 Fixed NFL logo hardcoded image
    [panel_control.c]
2019-02-22 ADC enhancements
2019-02-22 Added a few ADC messages to serial commands
2019-02-22 muxing/ram buffer/usb bug fixes
    [adc.c, nfl_logo.c, test_buffer_fills.c]
2019-02-23 optimization and some spi stuff
2019-02-26 SPI STUFFFF
2019-02-27 Removed enhanced buffer mode from SPI Flash driver
2019-02-27 Added more SPI Flash error recording
    [error_handler.c, error_handler.h, spi_flash.c]
2019-03-01 Added PWM function prototypes
2019-03-04 device control layout
2019-03-06 Trying to solve a few bugs
    [device_control.c, device_control.h, gpio_setup.c, main.c, panel_control.c, power_saving.c, spi_flash.c, test_buffer_fills.c]
2019-03-06 created an "image row" to view thumbnails, switch to 5 bit color
2019-03-06 Config error bug fixes/adjustments
    [cause_of_reset.c, configure.h, error_handler.c, spi_flash.c]
2019-03-07 Made device_on_time a persistent variabel
2019-03-08 Fixed boot configuration ECC error bug
    [configure.h, device_control.c, error_handler.c, heartbeat_timer.h, main.c, power_saving.c]
2019-03-08 Edited prefetch settings, removed core timer ISR
2019-03-08 saving off changes to switch branches = boring
2019-03-08 Trying to get SPI Flash to work
2019-03-15 Few SPI Flash fixes, not there yet
    [esp8266.c, external_bus_interface.c, external_bus_interface.h, gpio_setup.c, main.c, spi_flash.c, test_buffer_fills.c, test_buffer_fills.h]
2019-03-15 Added CE toggle to SPI Flash TX ISR
2019-03-15 More SPI Flash work
2019-03-15 Think I got SPI Flash Writing working
2019-03-15 Added SVG file for logic board gaurd
2019-03-22 Got basic WIFI UART driver working
    [Additional_Capacitance.sch, External_Flash_1.sch, External_Flash_2.sch, External_Flash_3.sch, External_Flash_4.sch, External_Flash_5.sch, External_Flash_6.sch, External_Flash_7.sch]
2019-03-22 debuging esp uart
2019-03-24 debugging esp rx/tx and added Timer4 as delay timer
2019-03-24 interrupt excel sheet
    [Interrupt_Priority_List.xlsx]
2019-03-25 added device control functionality
2019-03-25 Misc changes
    [Microcontroller_Peripheral_Map.xlsx]
2019-03-25 change notification pins and interrupt handlers
2019-03-26 Added a ton of WIFI UART stuff
2019-03-26 having git issues, test 1
    [misc_board_control.h]
2019-03-26 having git issues part 2
    [misc_board_control.c]
2019-03-29 Got dimming PWM working
2019-03-29 Fixed PWM frequency issue
    [panel_control.c]
2019-03-29 Fixed IO Change notifications
    [delay_timer.c, delay_timer.h, esp8266.c, esp8266.h, gpio_setup.c, main.c, misc_board_control.c]
2019-03-30 Edited peripheral spreadsheet
    [Microcontroller_Peripheral_Map.xlsx]
2019-03-31 SPI Flash data check
2019-04-01 switch to TCP from HTTP, bug in deleting devices, debugging wifi
2019-04-04 Few SPI timing changes
2019-04-05 ESP fixes, SPI data check fixes
    [esp8266.c, spi_flash.c]
2019-04-08 Got frame count NVM variable working
2019-04-09 State machine merge fixes
    [esp8266.c, main.c, spi_flash.c, spi_flash.h, standard_operation_sm.c, standard_operation_sm.h]
2019-04-10 Added a few fixes
    [esp8266.c, main.c, misc_board_control.c]
2019-04-18 Added ECOs to hardware schematics
    [Active_Load_1.sch, Active_Load_2.sch, Active_Load_3.sch, LTC7851_Demo.sch, Loop_Response.sch, Mechanical.sch, Microcontroller_1.sch, POS5P5_MNG.sch]
2019-04-18 fixed backstack overlaying, removed splash screen, added back button to image select
2019-04-18 added about page and new device in menu
2019-04-24 Removed unneeded files
    [configuration.h]
2019-04-27 Hardware changes, removed conditional USB printing
    [Power_Input.sch]
2019-04-27 Fixed SPI Flash bug when reading first image in state machine
    [esp8266.c, esp8266.h, panel_control.c, standard_operation_sm.c]
2019-04-30 string resources, init checks, switch statements
2019-04-30 Rebrand frames to slides
2019-05-05 Added logic board sch poster pdf
